AmigaPCI/AmigaPCI-MainBoard/Images/APCI_Jumper_Location70.jpg

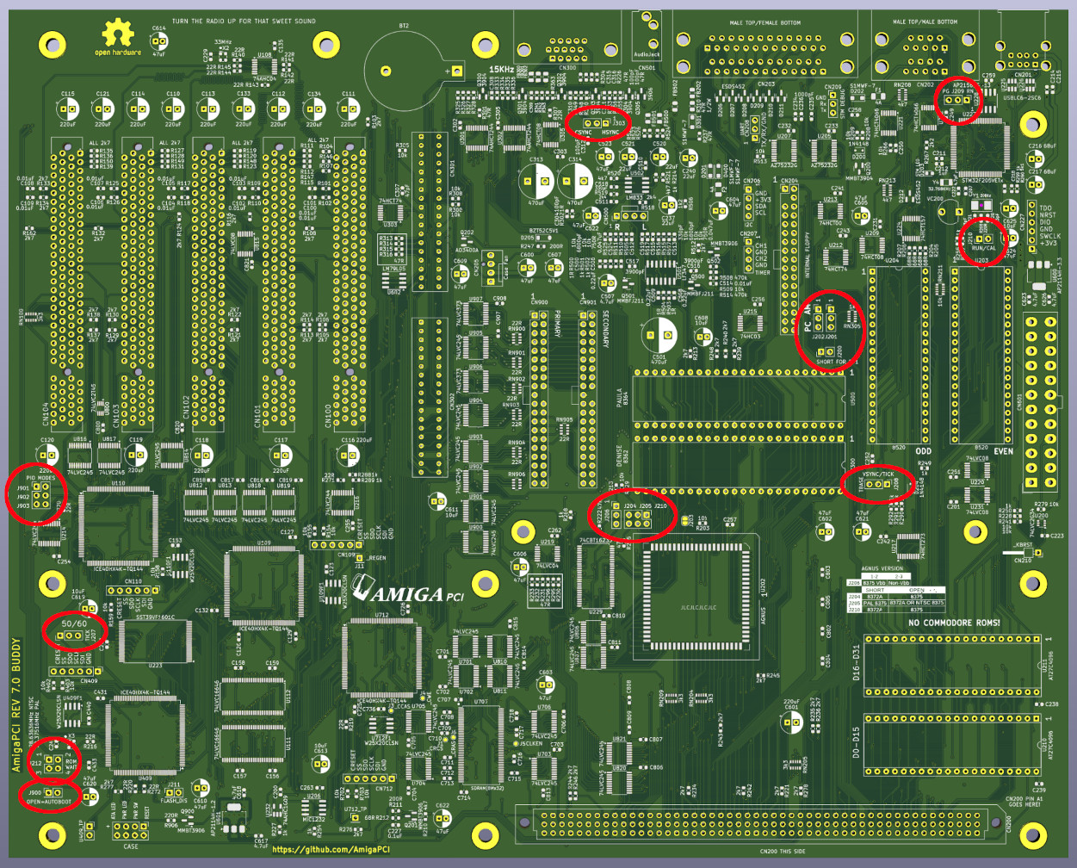
Images/APCI_Jumper_Location70.jpg
