AmigaPCI/AmigaPCI-MainBoard/KiCAD/readme.md

KiCAD files. Current revisions are in this folder. Deprecated versions are found in the Archive folder.
