AmigaPCI/AmigaPCI-MainBoard/Images/LBC_Footprint_Rev6.png

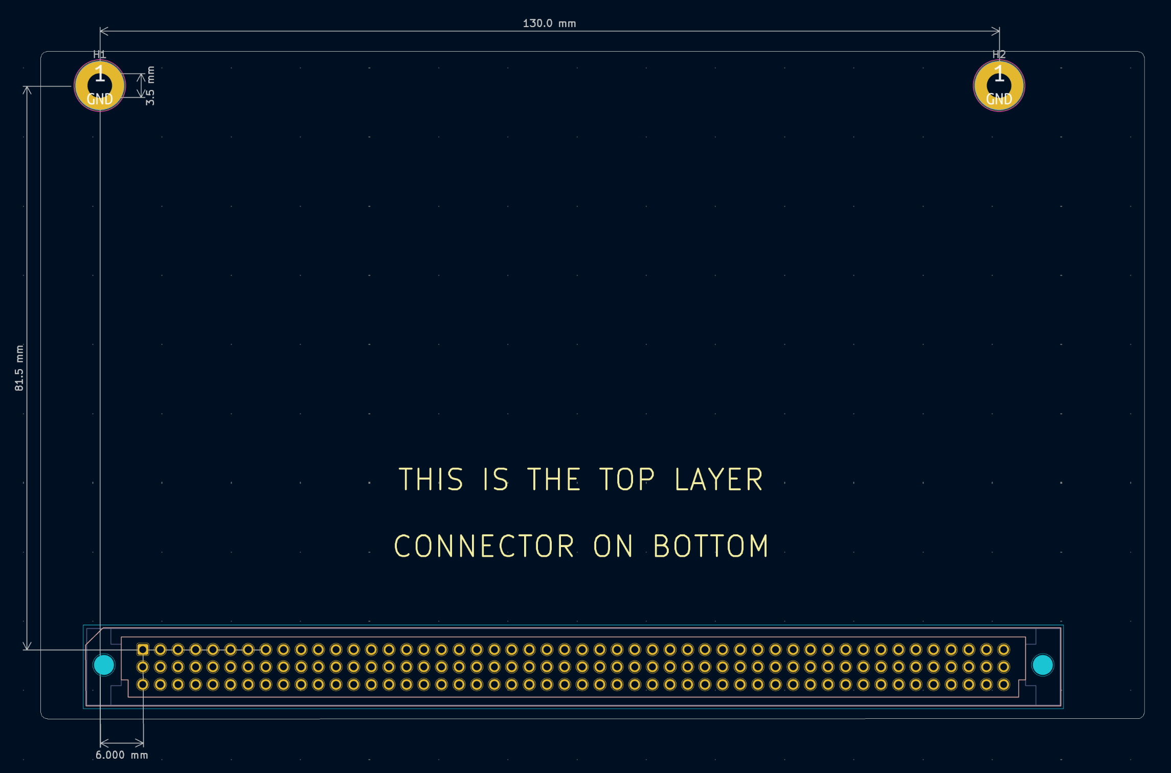
Images/LBC_Footprint_Rev6.png
