AmigaPCI/AmigaPCI-MainBoard/KiCAD/AmigaPCI Mainboard-KiCAD REV 70/AmigaPCI-Footprints/CUI_DEVICES_SJ1-3533N.step

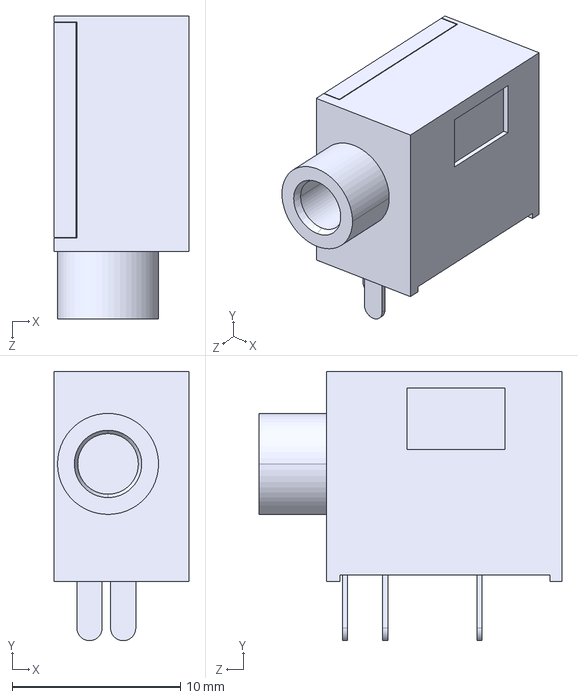
[picture p3: CAD file, 2026-06-26]
KiCAD/AmigaPCI Mainboard-KiCAD REV 70/AmigaPCI-Footprints/CUI_DEVICES_SJ1-3533N.step
8.00 x 16.0 x 18.0 mm
