AmigaPCI/AmigaPCI-MainBoard/KiCAD/AmigaPCI Mainboard-KiCAD REV 70/AmigaPCI-Footprints/ASUB-277-25TP24.STEP

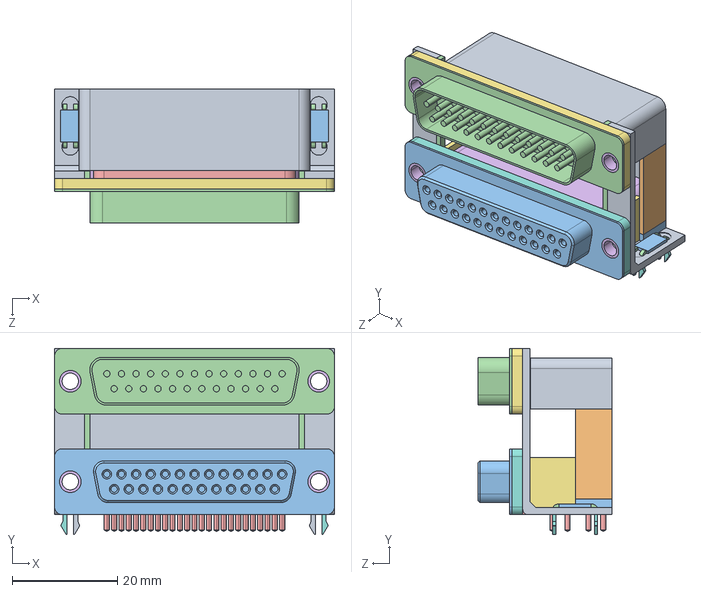
[picture p4: CAD file, 2026-06-26]
KiCAD/AmigaPCI Mainboard-KiCAD REV 70/AmigaPCI-Footprints/ASUB-277-25TP24.STEP
53.1 x 35.3 x 25.5 mm
