AmigaPCI/AmigaPCI-MainBoard/KiCAD/AmigaPCI Mainboard-KiCAD REV 70/AmigaPCI-Footprints/video_slot.stp

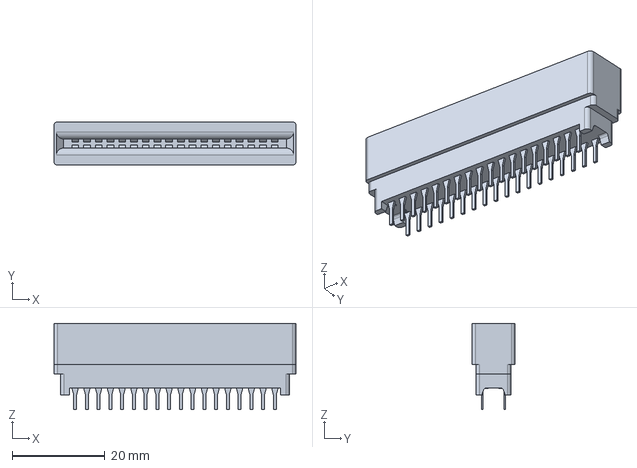
[picture p5: CAD file, 2026-06-26]
KiCAD/AmigaPCI Mainboard-KiCAD REV 70/AmigaPCI-Footprints/video_slot.stp
52.3 x 9.35 x 18.7 mm
