AmigaPCI/AmigaPCI-MainBoard/KiCAD/AmigaPCI Mainboard-KiCAD REV 70/AmigaPCI-Footprints/atx_molex.stp

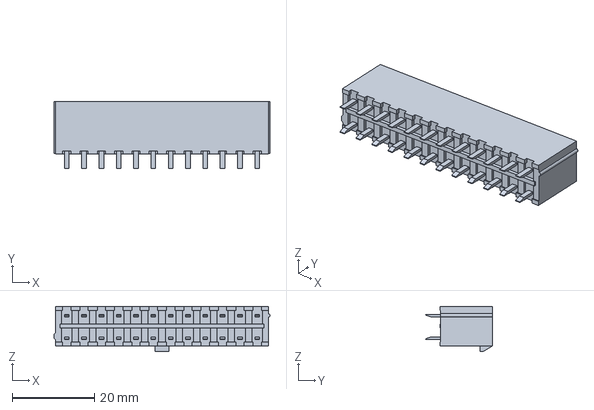
[picture p6: CAD file, 2026-06-26]
KiCAD/AmigaPCI Mainboard-KiCAD REV 70/AmigaPCI-Footprints/atx_molex.stp
52.4 x 16.3 x 11.0 mm
