AmigaPCI/AmigaPCI-MainBoard/KiCAD/AmigaPCI Mainboard-KiCAD REV 70/AmigaPCI-Footprints/DB9.stp

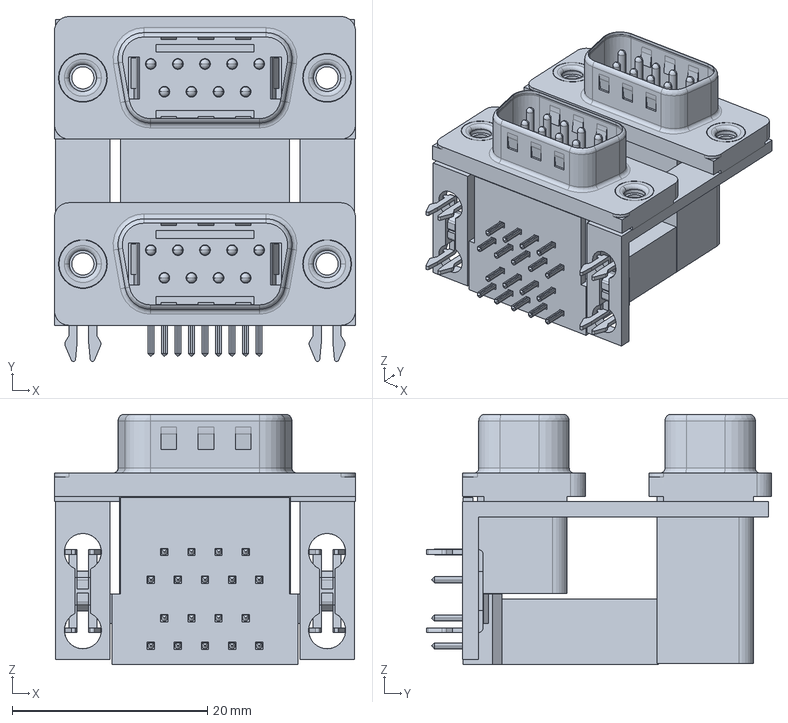
[picture p7: CAD file, 2026-06-26]
KiCAD/AmigaPCI Mainboard-KiCAD REV 70/AmigaPCI-Footprints/DB9.stp
30.8 x 35.3 x 25.6 mm
