AmigaPCI/AmigaPCI-MainBoard/KiCAD/AmigaPCI Mainboard-KiCAD REV 70/AmigaPCI-Footprints/USB.stp

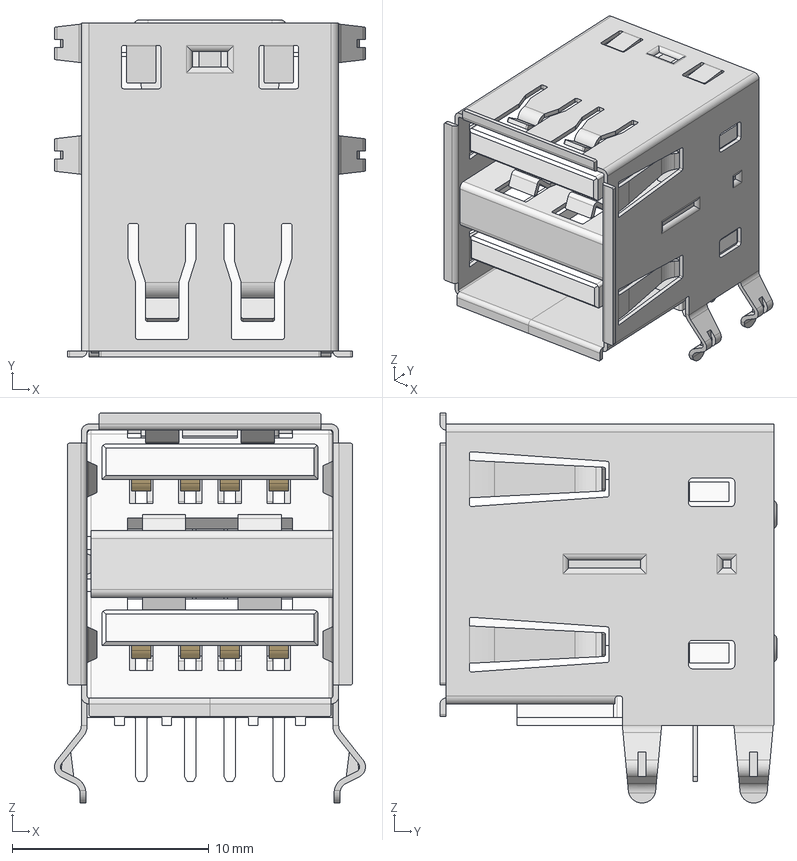
[picture p8: CAD file, 2026-06-26]
KiCAD/AmigaPCI Mainboard-KiCAD REV 70/AmigaPCI-Footprints/USB.stp
15.8 x 17.1 x 19.8 mm
61400826021_Shielding1
61400826021_Housing
61400826021_Shielding2
61400826021_Pin2 x 4
61400826021_Pin1 x 4
61400826021_Shielding3
