AmigaPCI/AmigaPCI-MainBoard/(list of files, cad)

Other CAD files:
KiCAD/AmigaPCI Mainboard-KiCAD REV 70/AmigaPCI-Footprints/5145154-4.step
KiCAD/AmigaPCI Mainboard-KiCAD REV 70/AmigaPCI-Footprints/asub-277-25tp24.stp
