AmigaPCI/AmigaPCI-MainBoard/assembly.md

## Tables

### Table 1. Legacy Parts Required
Common Name|Designation/Part Number|Postion|Package|Notes
-|-|-|-|-
Fatter Agnus|See Table 2|U202|PLCC-84|
Paula|MOS 8364|U500|DIP-48|
Denise|MOS 8362 or CSG 8373|U300|DIP-48|[Deniser](https://github.com/endofexclusive/deniser)
CIA|MOS 8520A, 8520A-1, 8520R2, or 8520PD|U203 and U204|DIP-40|These are all interchangeable
Kickstart|Burn your own A1200 27C4096|U210 (LOW), U211 (HIGH)|DIP-40|
Video Hybrid|Commodore 390229-0x|HY300|SIP-22|[Video Hybrid](https://github.com/SukkoPera/OpenAmigaVideoHybrid)

*Commodore IC's may be marked "MOS" or "CSG", or possibly neither in the case of contract runs. These are interchangeable by part number.

### Table 2. Agnus Parts Supported

Agnus|Commodore Part Number|Status
-|-|-
8372A|ALL|Tested and working
8375|390544-01|Tested and working
8375|390544-02|Tested and working
8375|318069-10|Tested and working
8375|318069-11|Tested and working
8375|390554-01|Unknown
8375|390554-02|Unknown
8375|318069-12|Unknown
8375|318069-13|Unknown
