AmigaPCI/AmigaPCI-MainBoard/Schematic/AmigaPCI Mainboard REV70.pdf

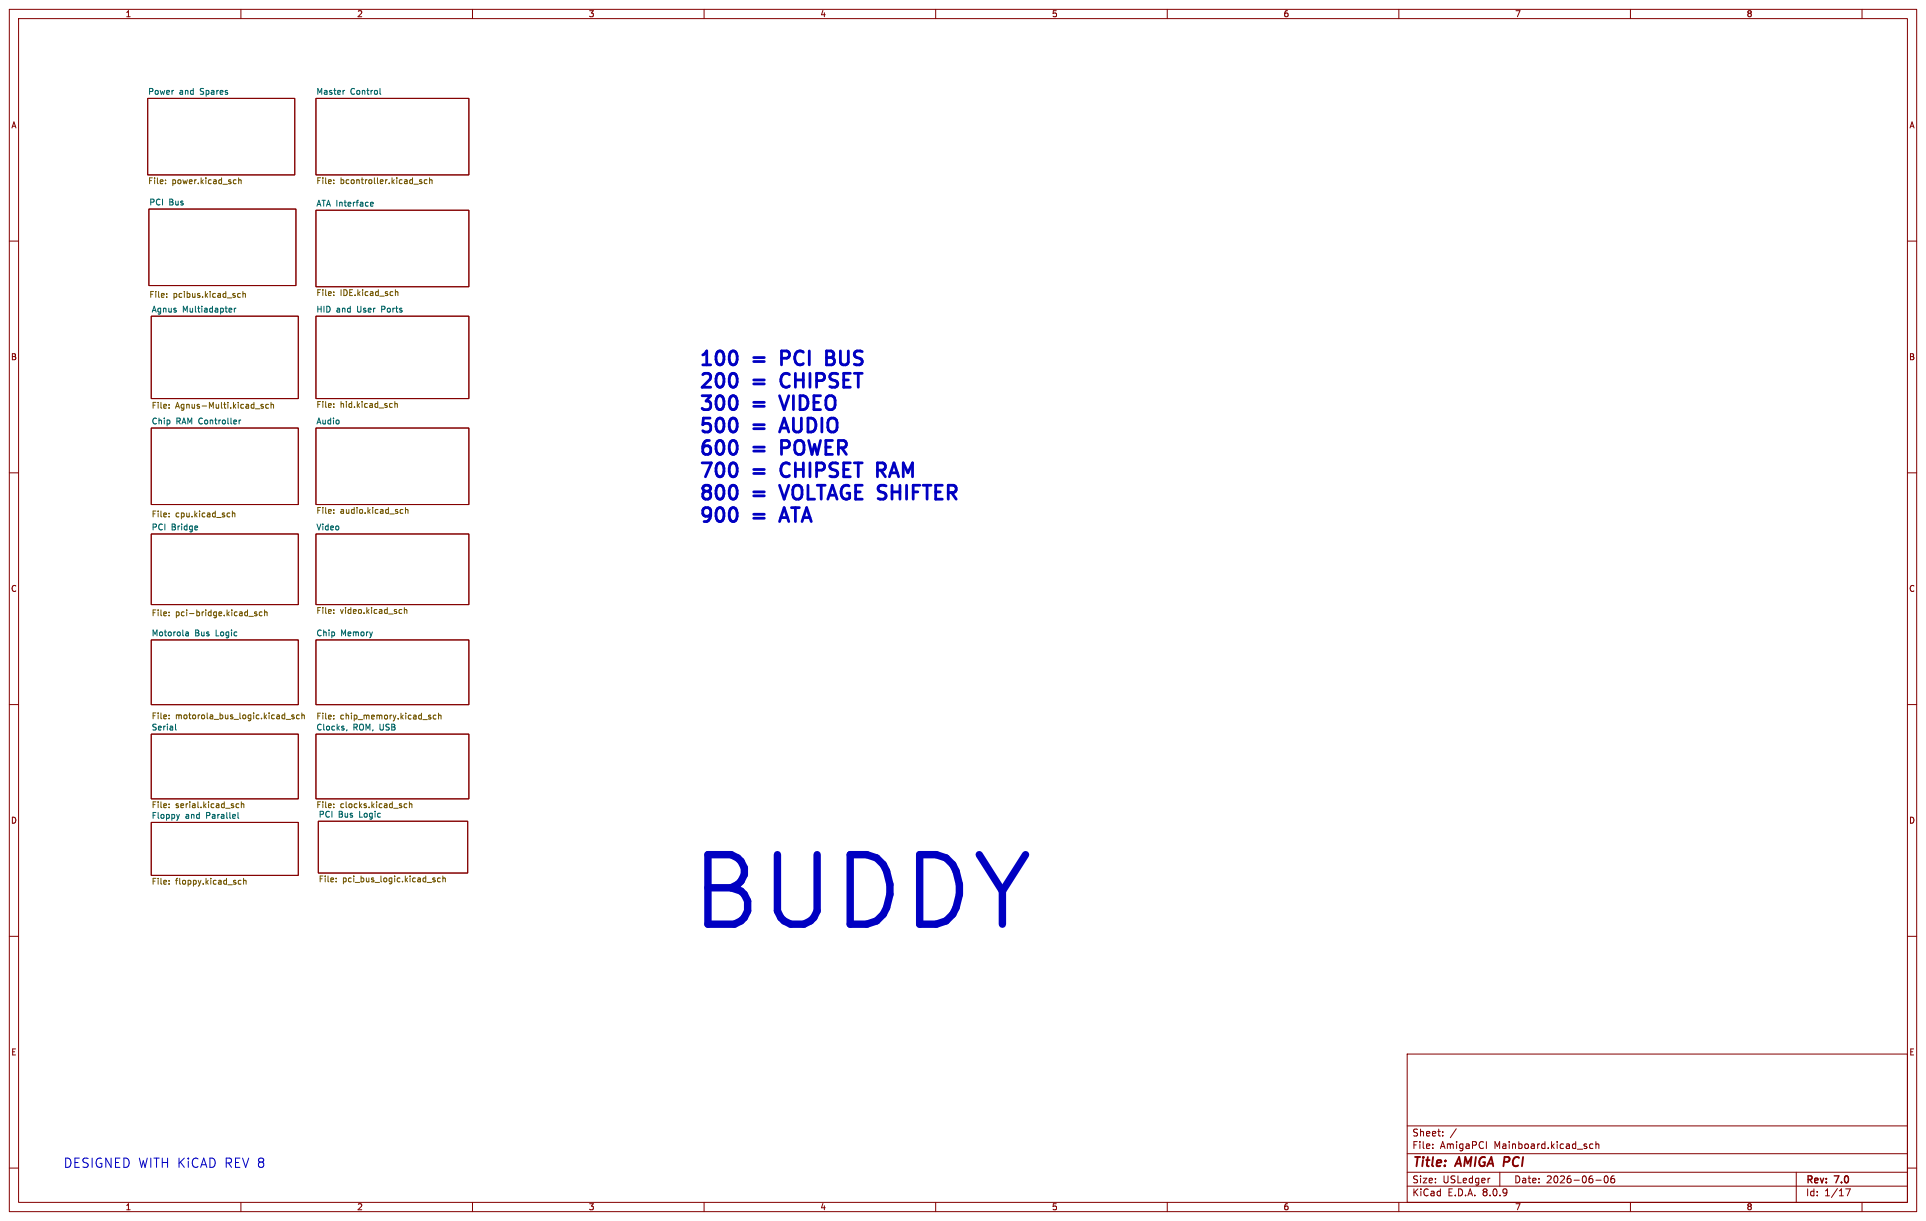
[picture p15: page 1]

Audio File: audio.kicad_sch HID and User Ports File: hid.kicad_sch Video File: video.kicad_sch PCI Bus Logic File: pci_bus_logic.kicad_sch
Chip RAM Controller File: cpu.kicad_sch Serial File: serial.kicad_sch Floppy and Parallel File: floppy.kicad_sch

Agnus Multiadapter File: Agnus-Multi.kicad_sch

Chip Memory File: chip_memory.kicad_sch Clocks, ROM, USB

DESIGNED WITH KiCAD REV 8

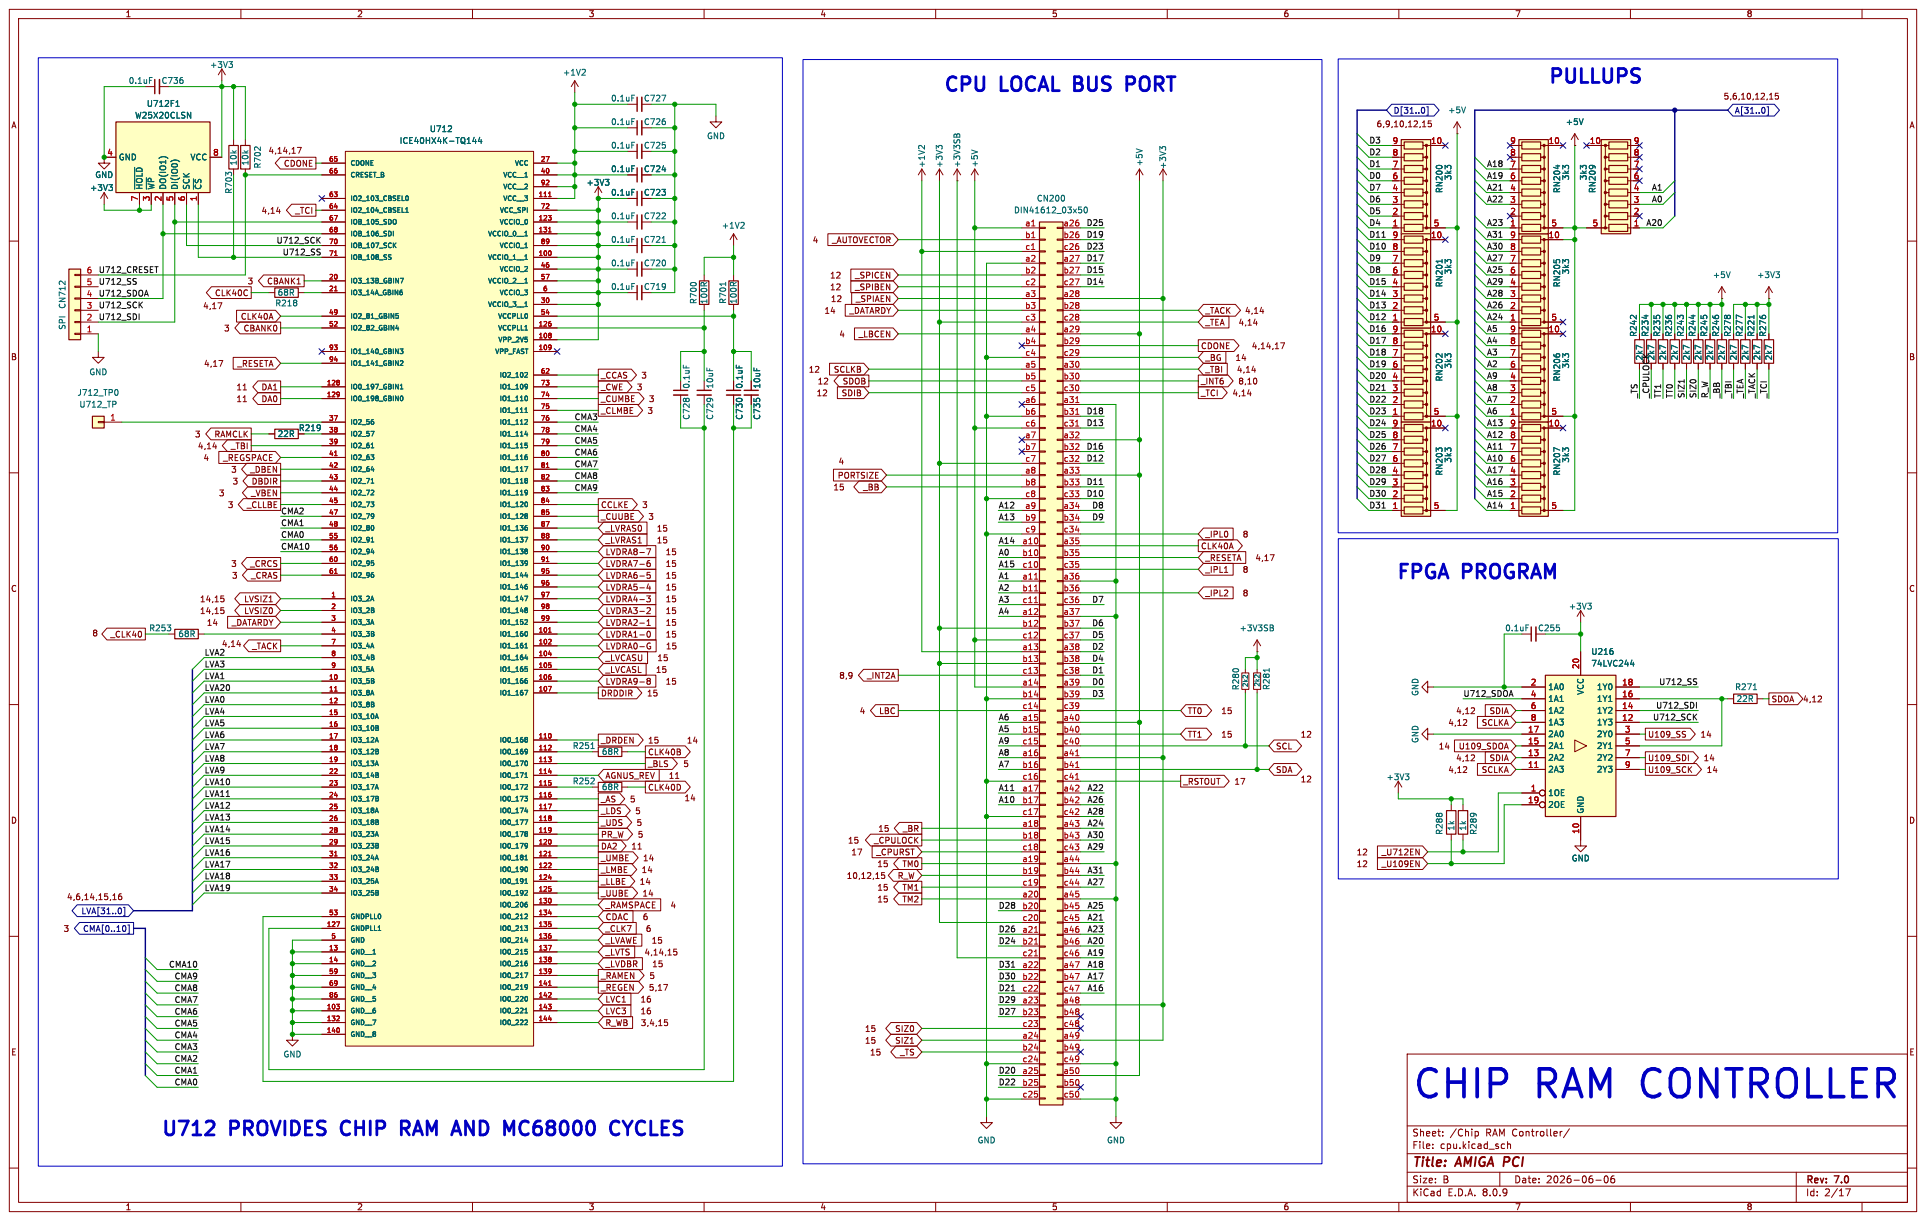
[picture p16: page 2]

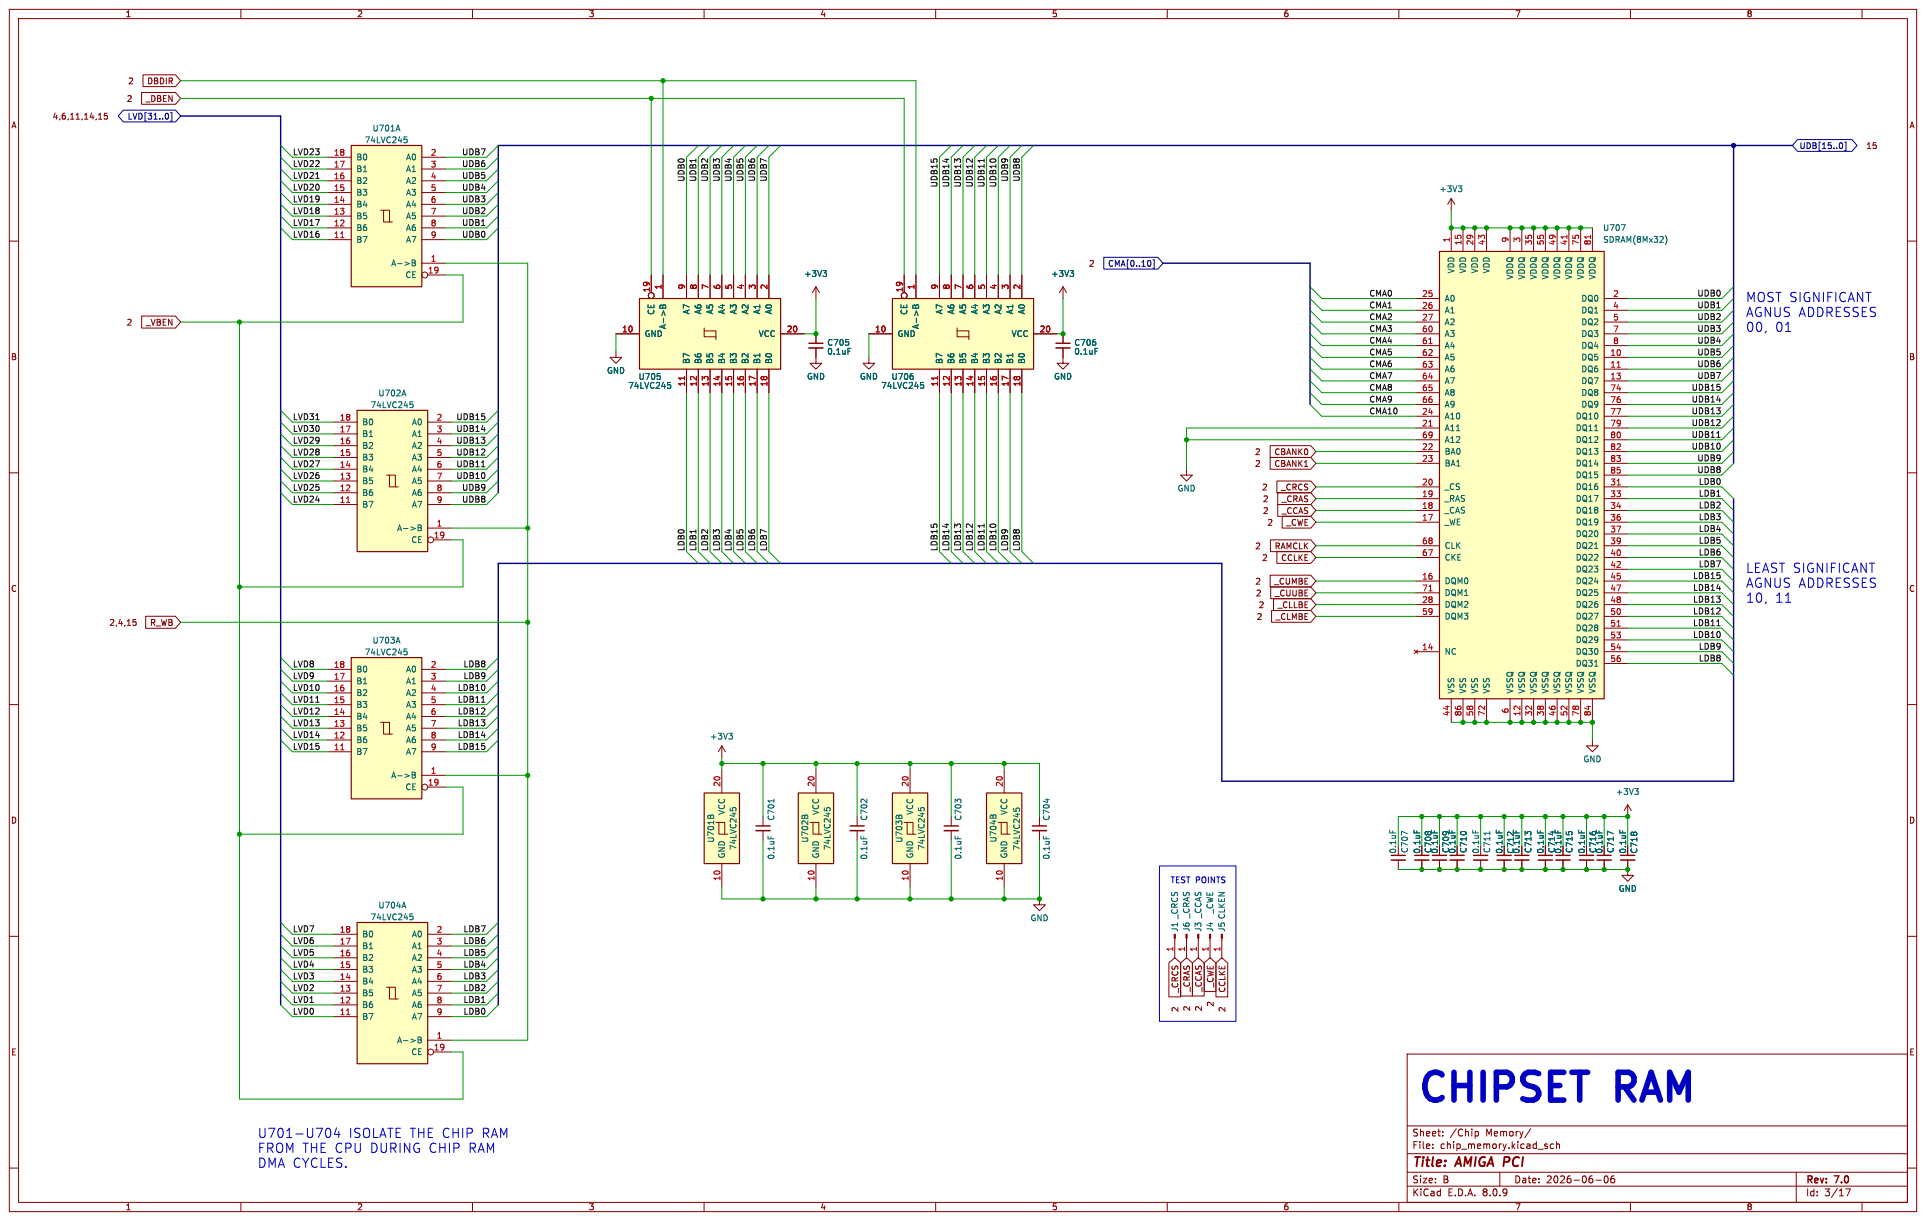
[picture p17: page 3]

FROM THE CPU DURING CHIP RAM

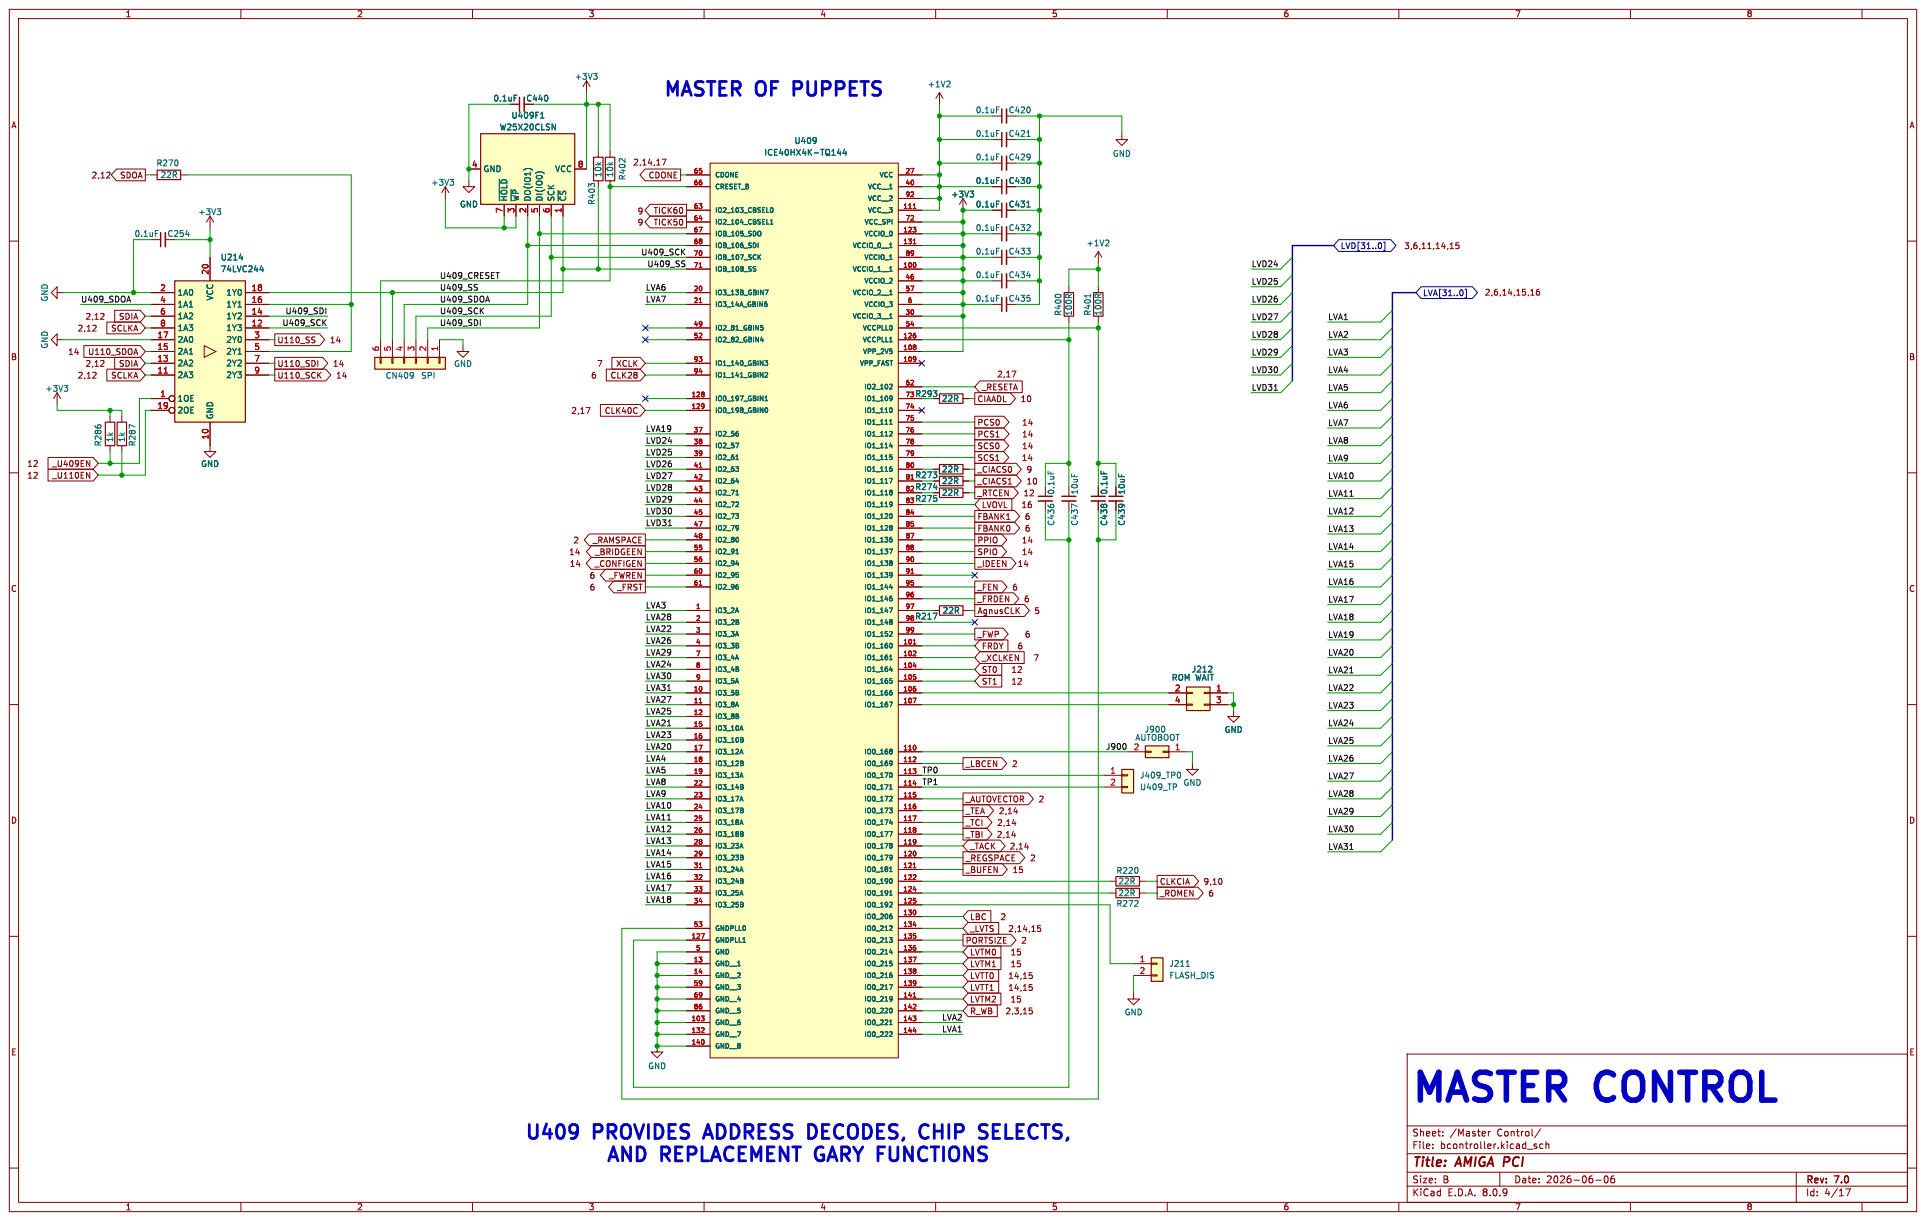
[picture p18: page 4]

6 ~{HOLD} 7 VCC 8 GND GND

LVA3 U409 PROVIDES ADDRESS DECODES, CHIP SELECTS,

AND REPLACEMENT GARY FUNCTIONS

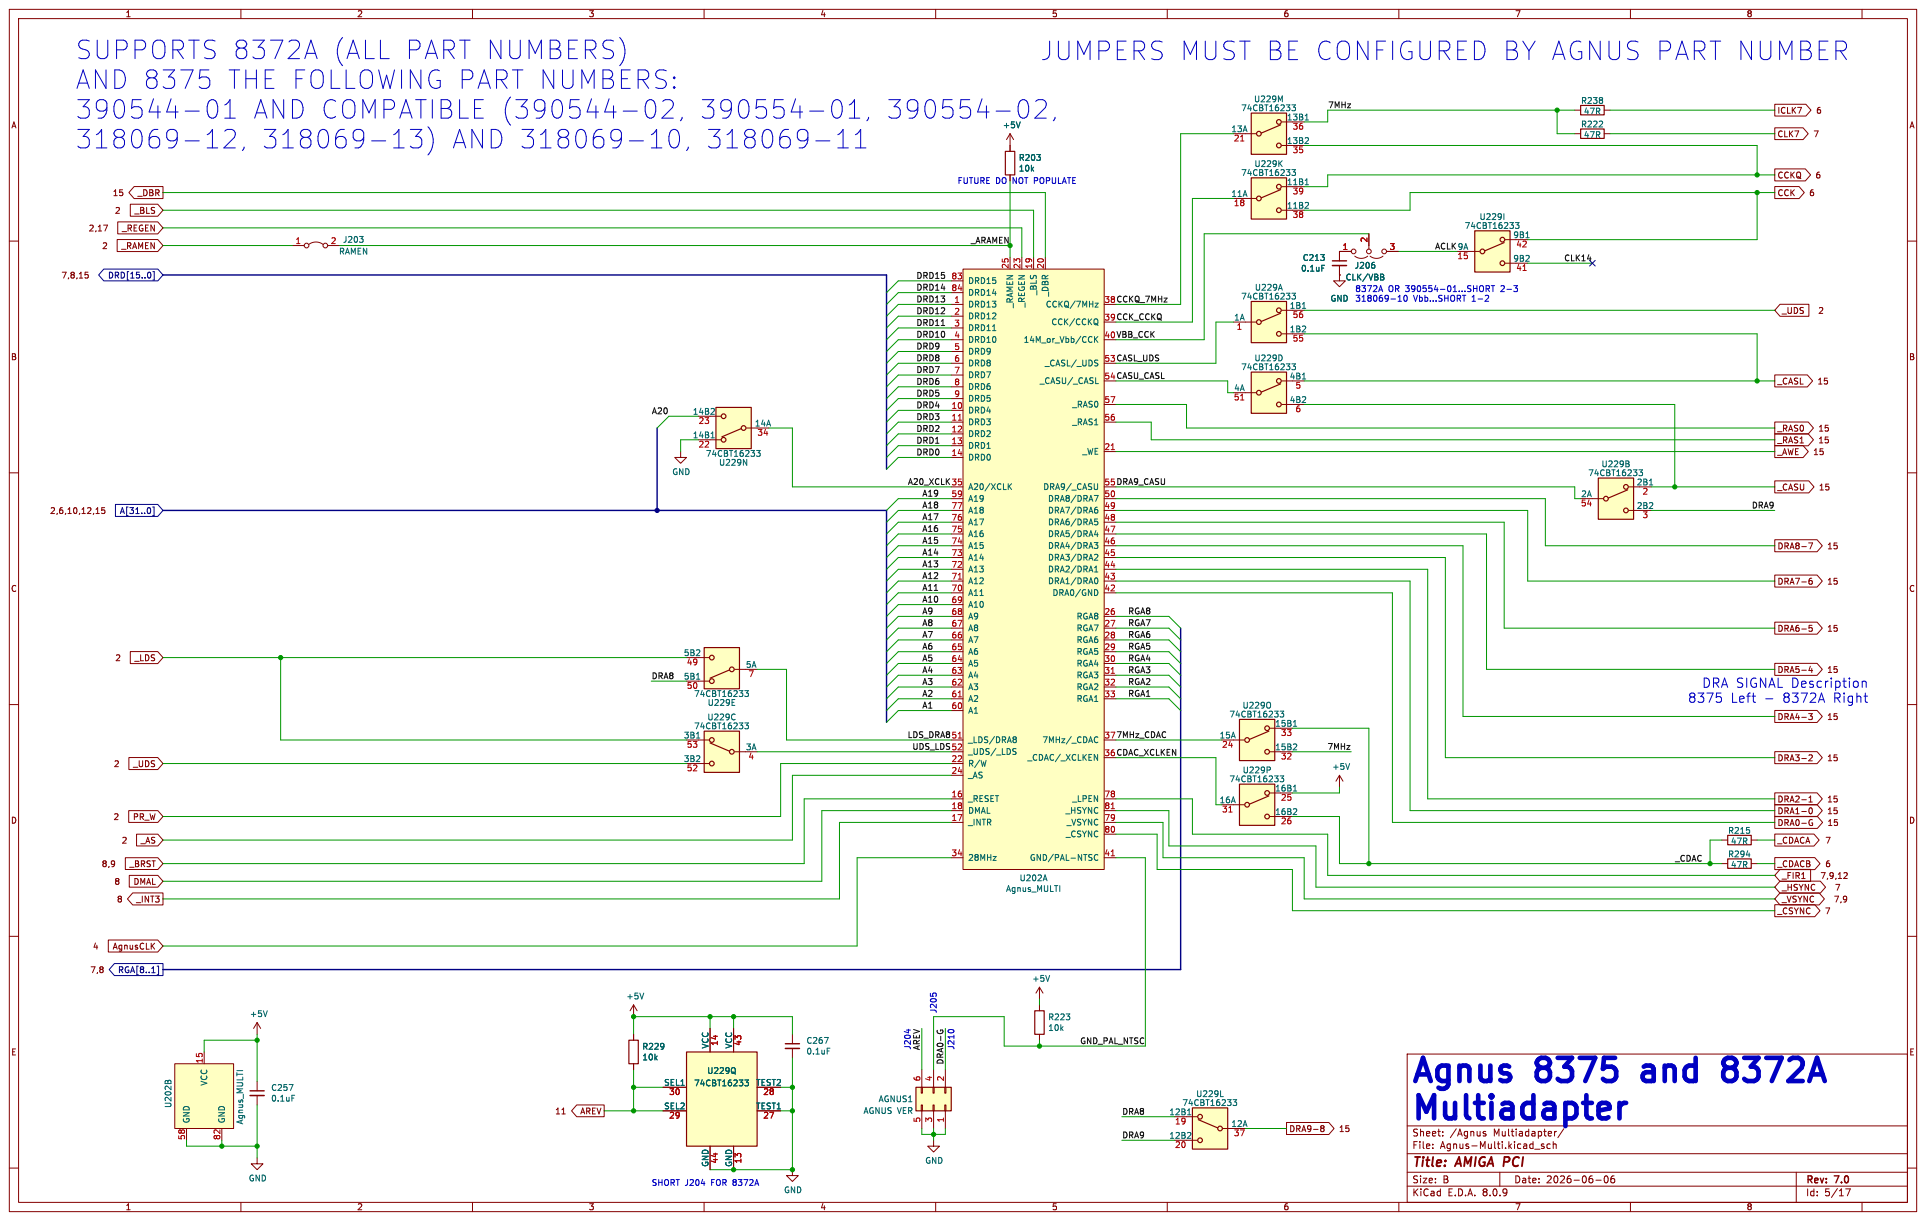
[picture p19: page 5]

FUTURE DO NOT POPULATE SUPPORTS 8372A (ALL PART NUMBERS)
AND 8375 THE FOLLOWING PART NUMBERS:

JUMPERS MUST BE CONFIGURED BY AGNUS PART NUMBER

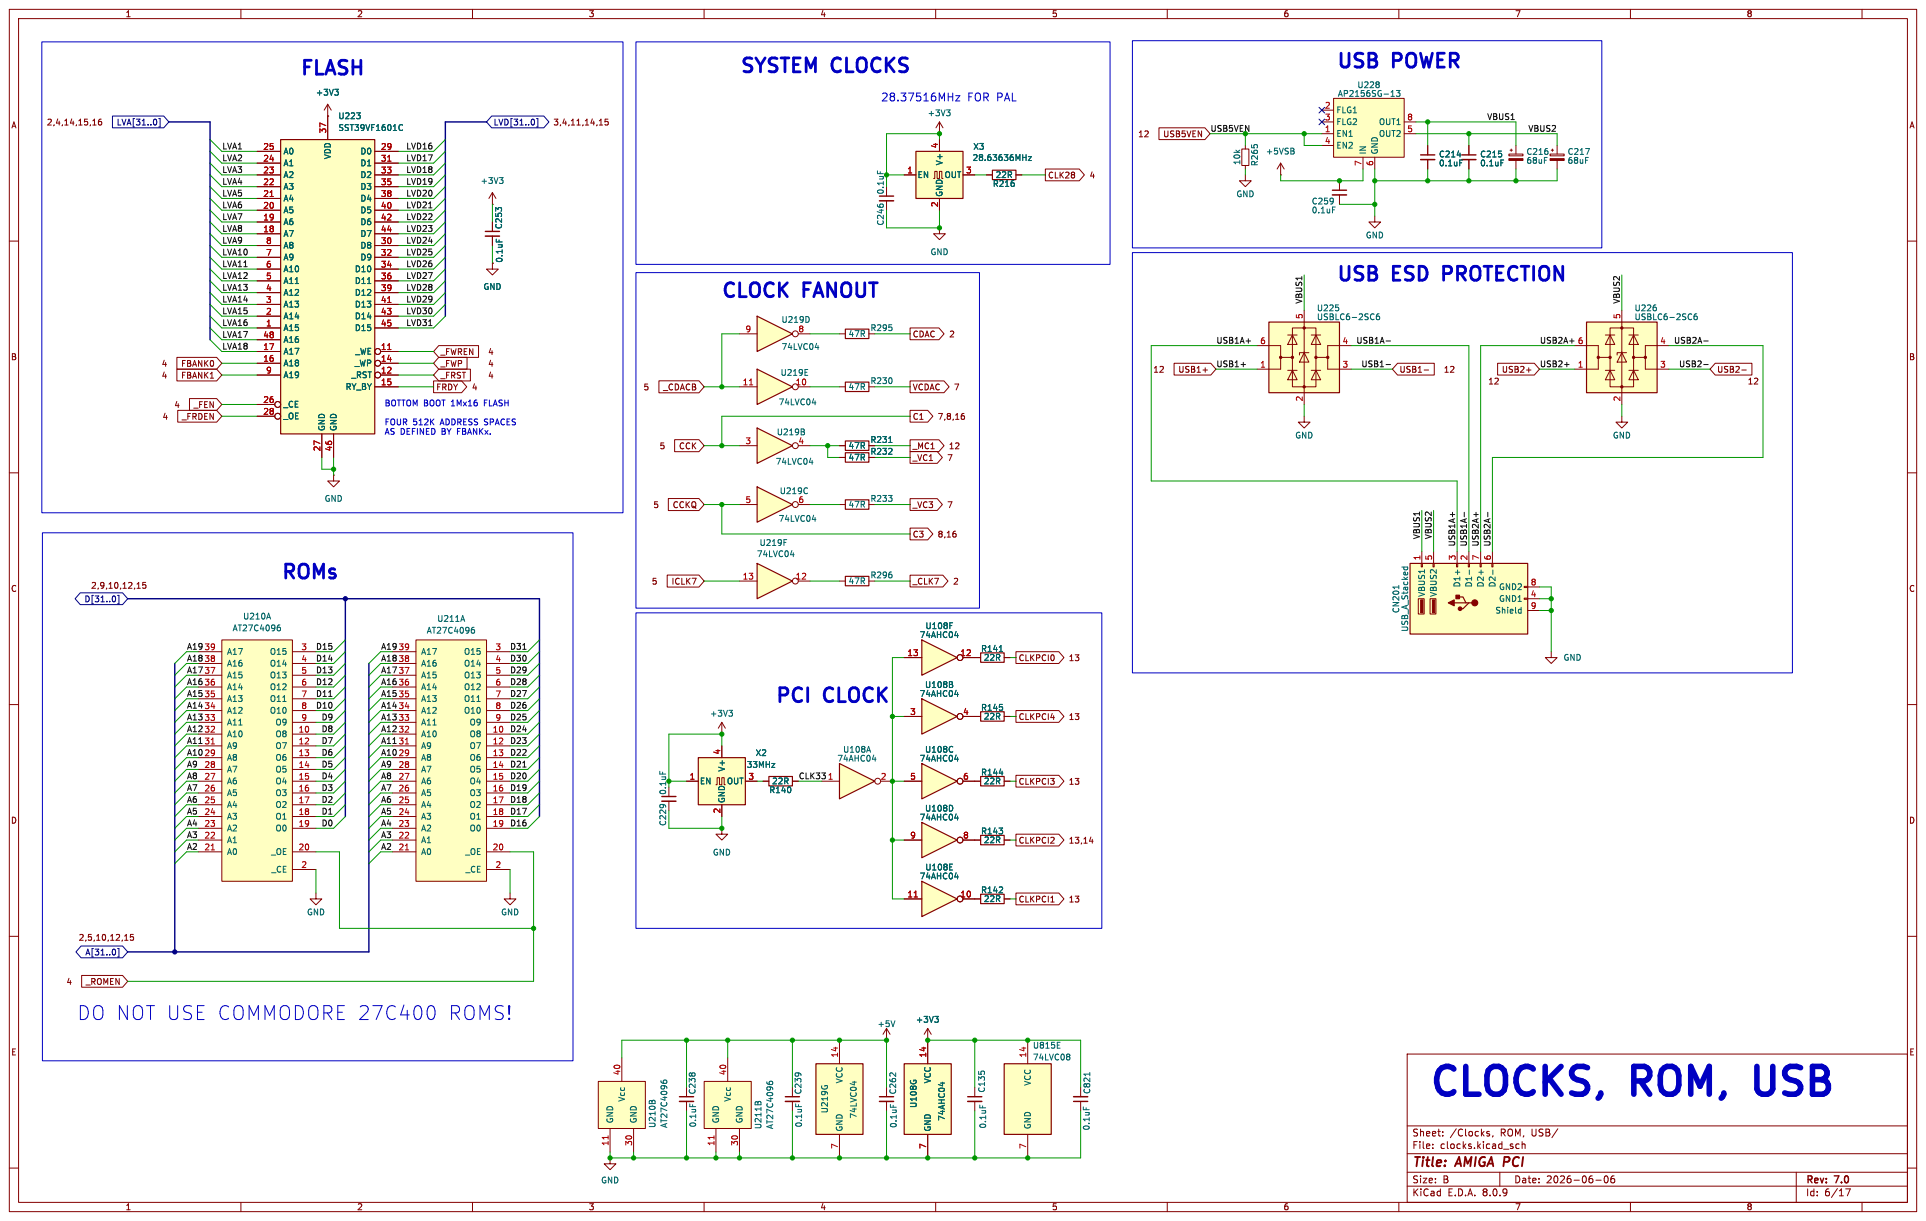
[picture p20: page 6]

DO NOT USE COMMODORE 27C400 ROMS!

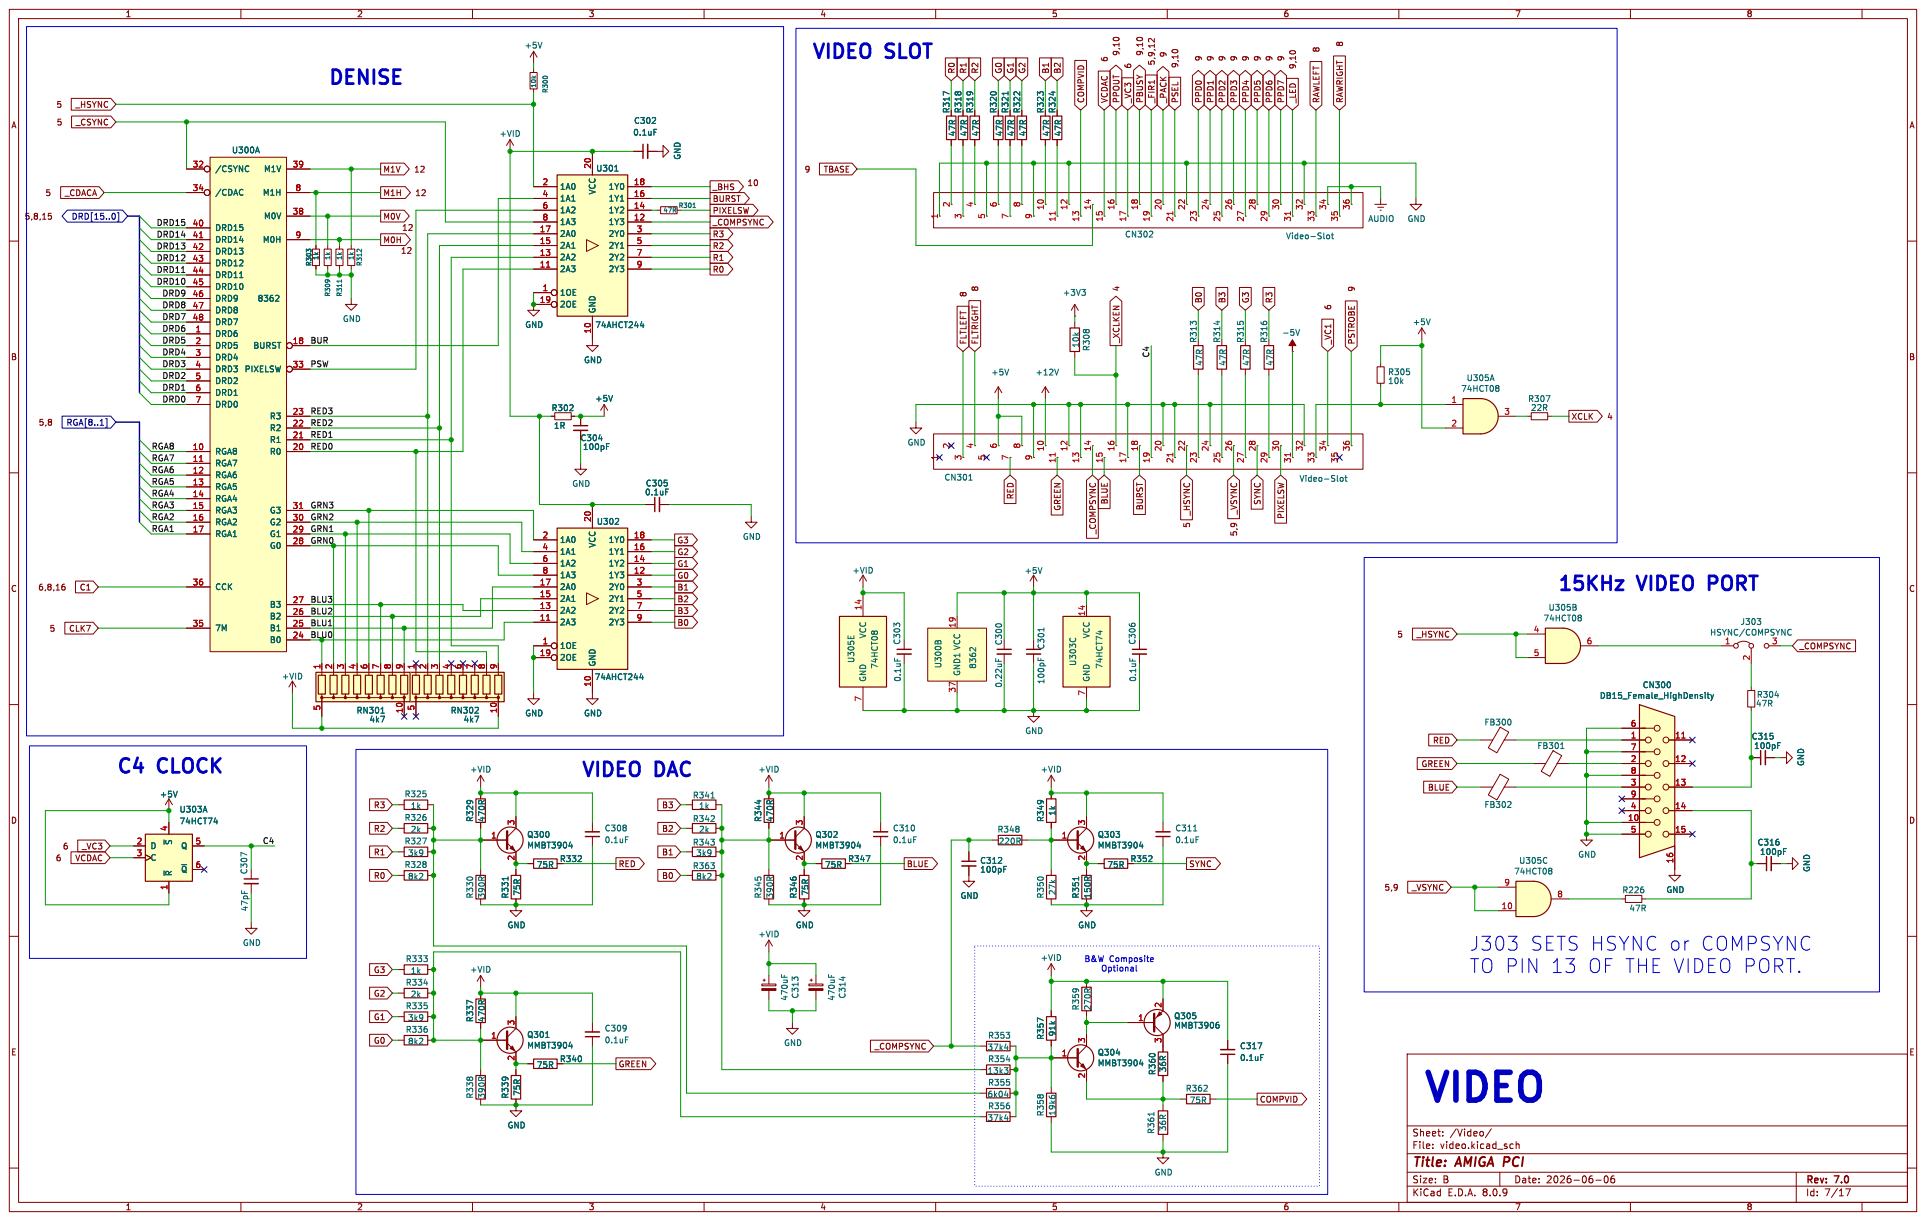
[picture p21: page 7]

9 CN301 Video-Slot C303 0.1uF VCC 14 GND

J303 SETS HSYNC or COMPSYNC
TO PIN 13 OF THE VIDEO PORT.

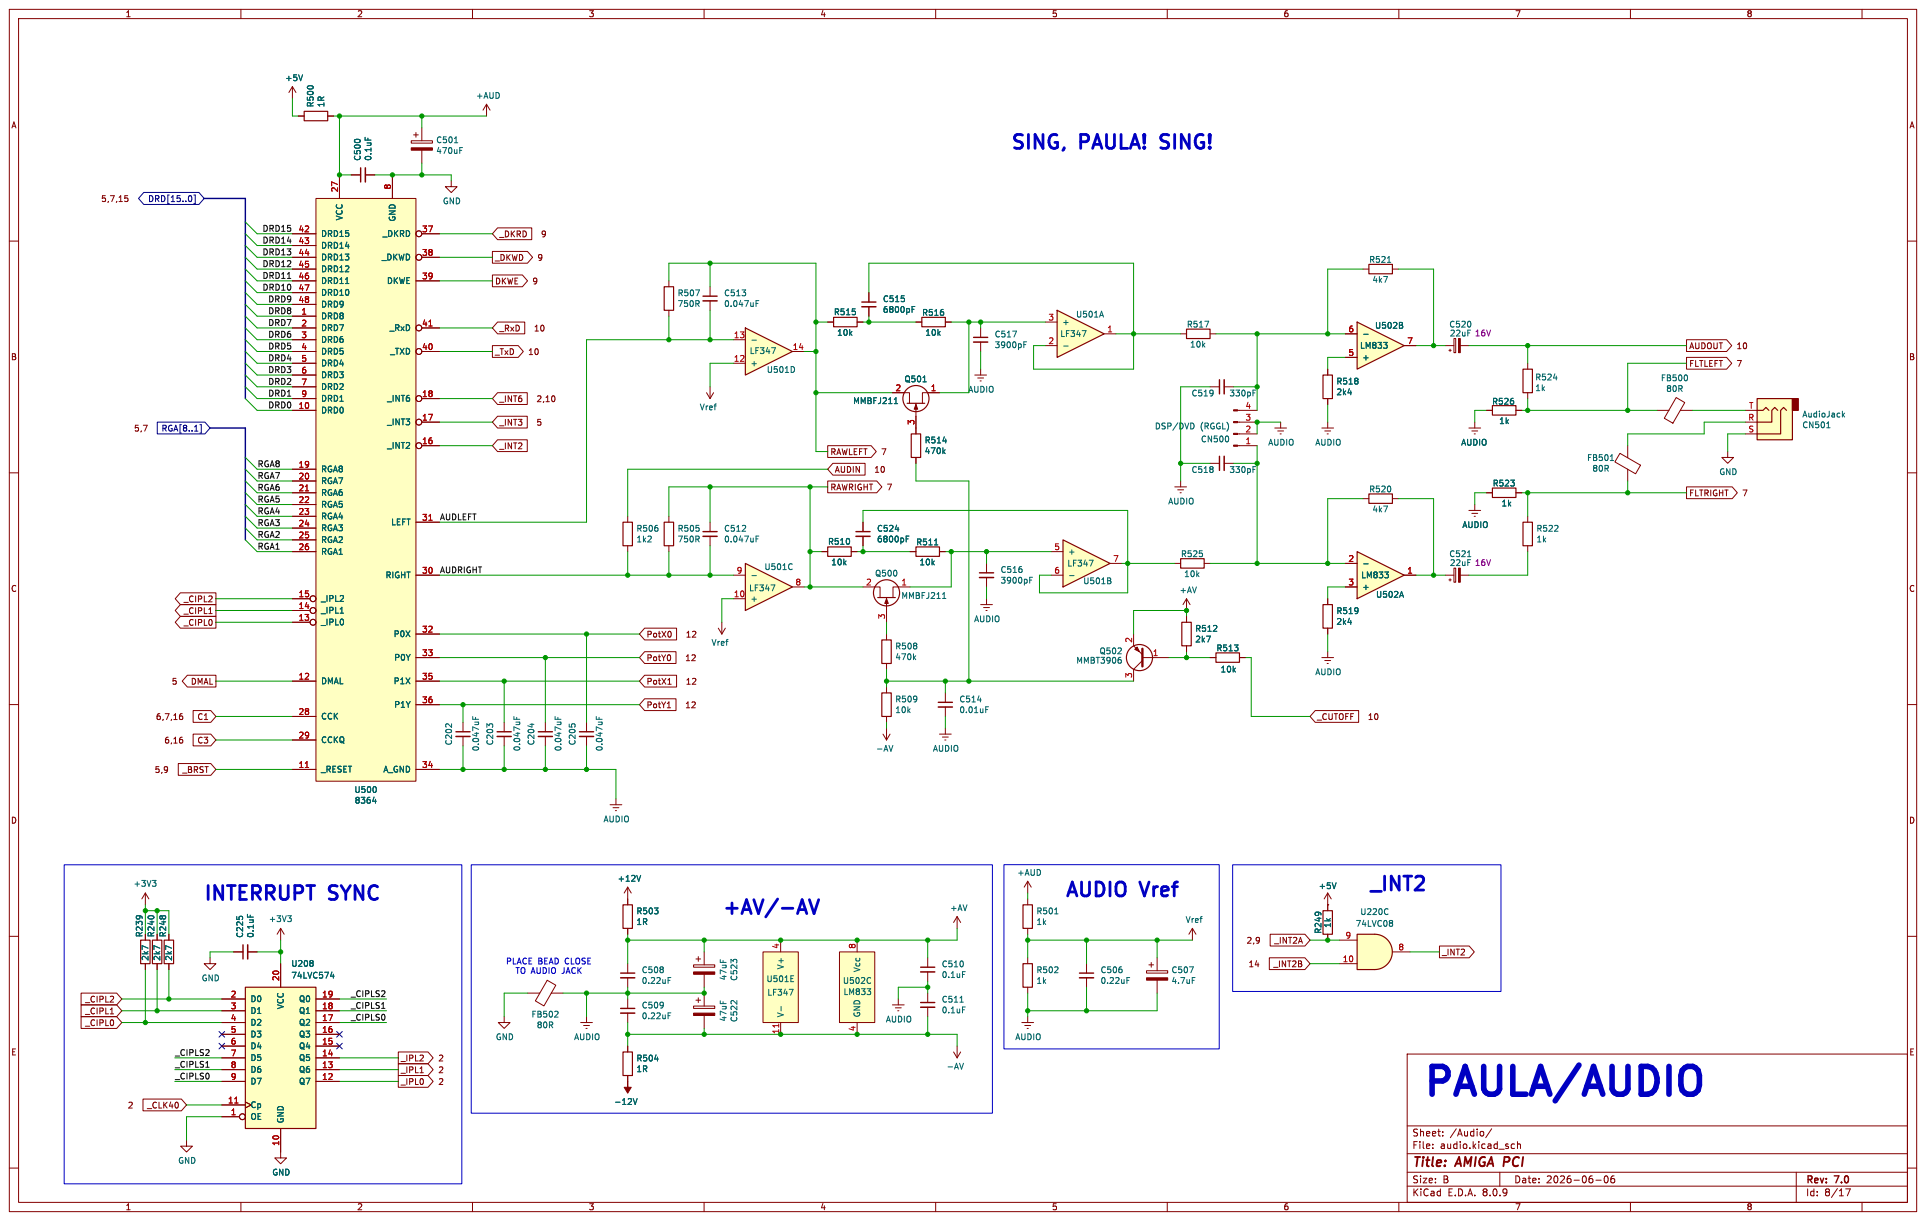
[picture p22: page 8]

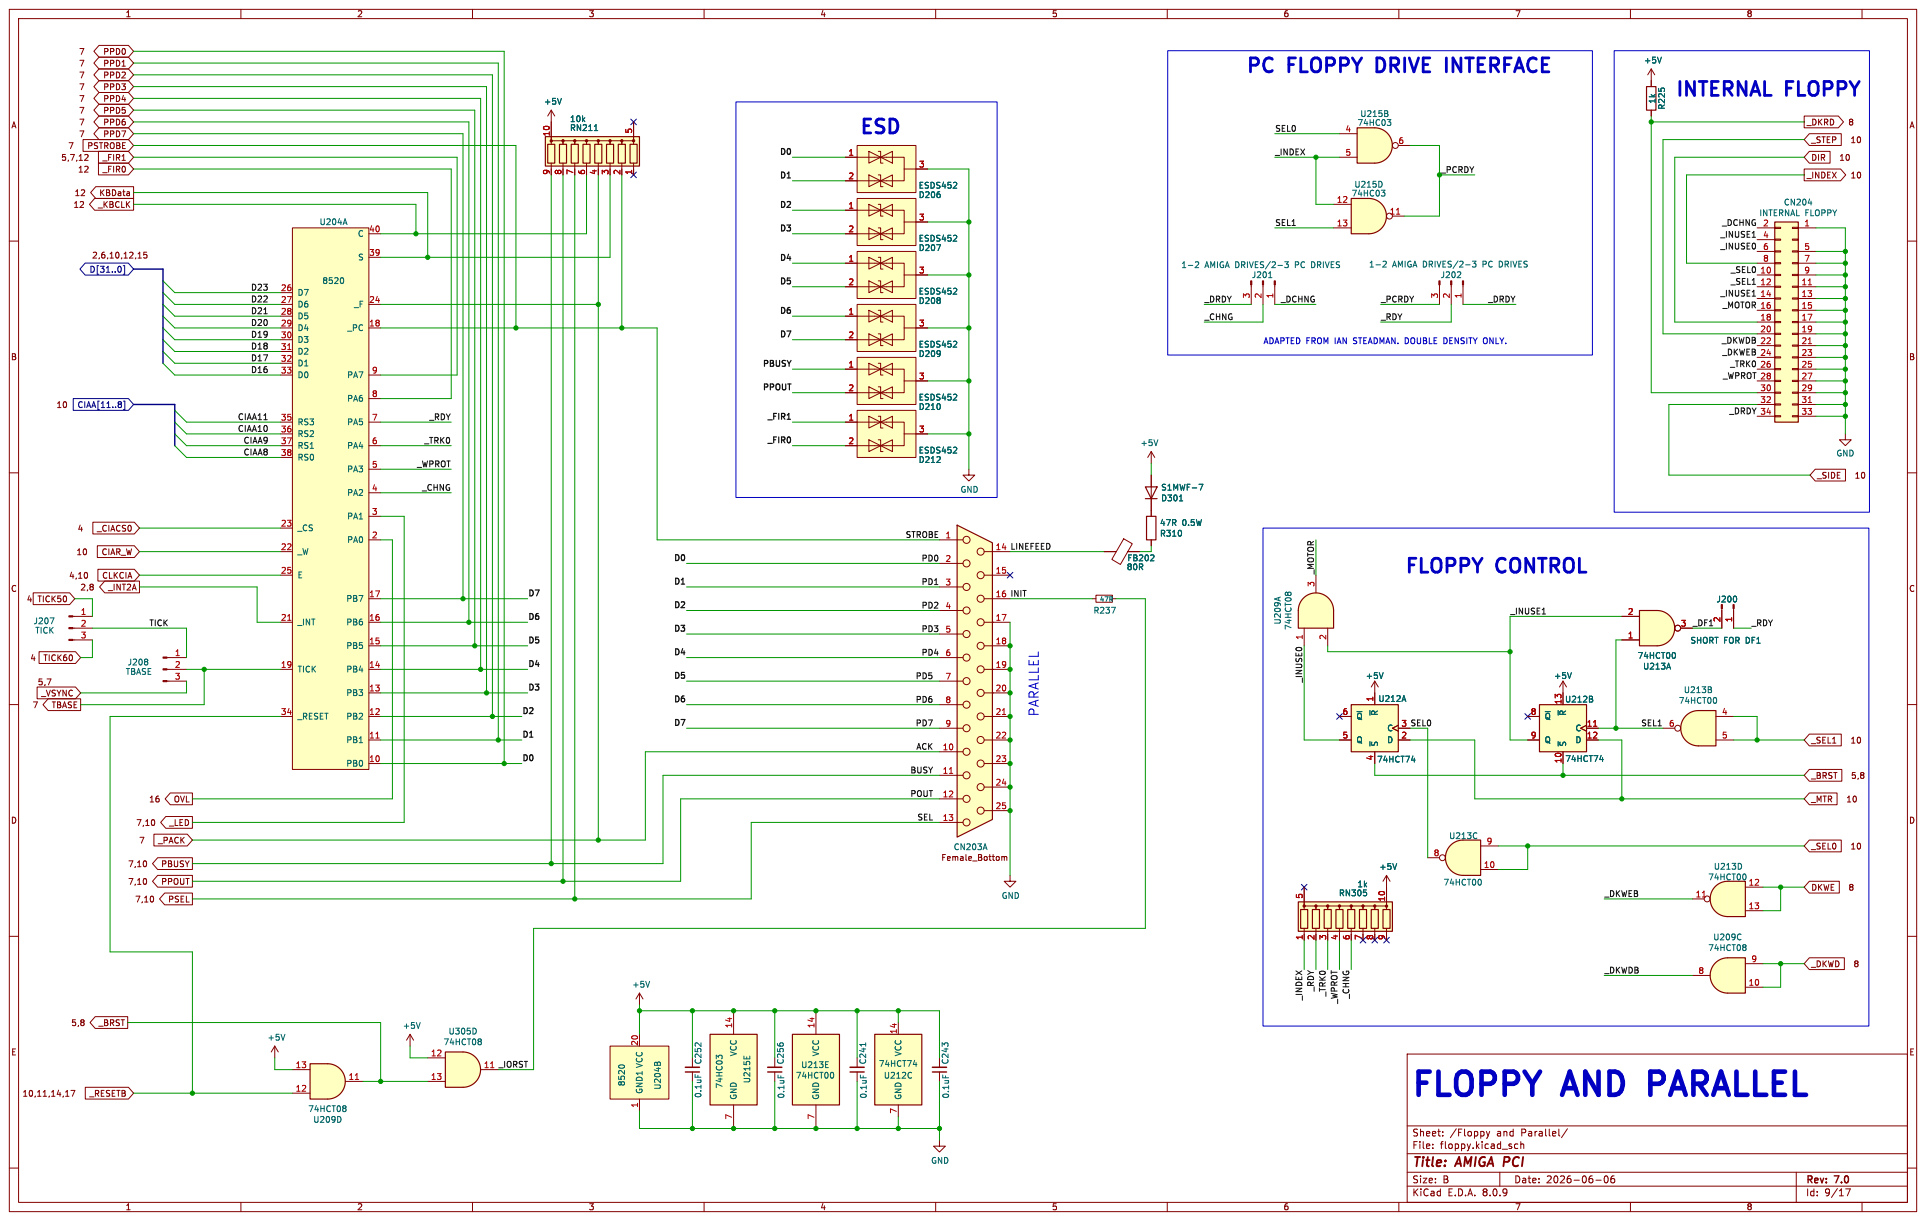
[picture p23: page 9]

PC FLOPPY DRIVE INTERFACE

ADAPTED FROM IAN STEADMAN. DOUBLE DENSITY ONLY. FLOPPY CONTROL

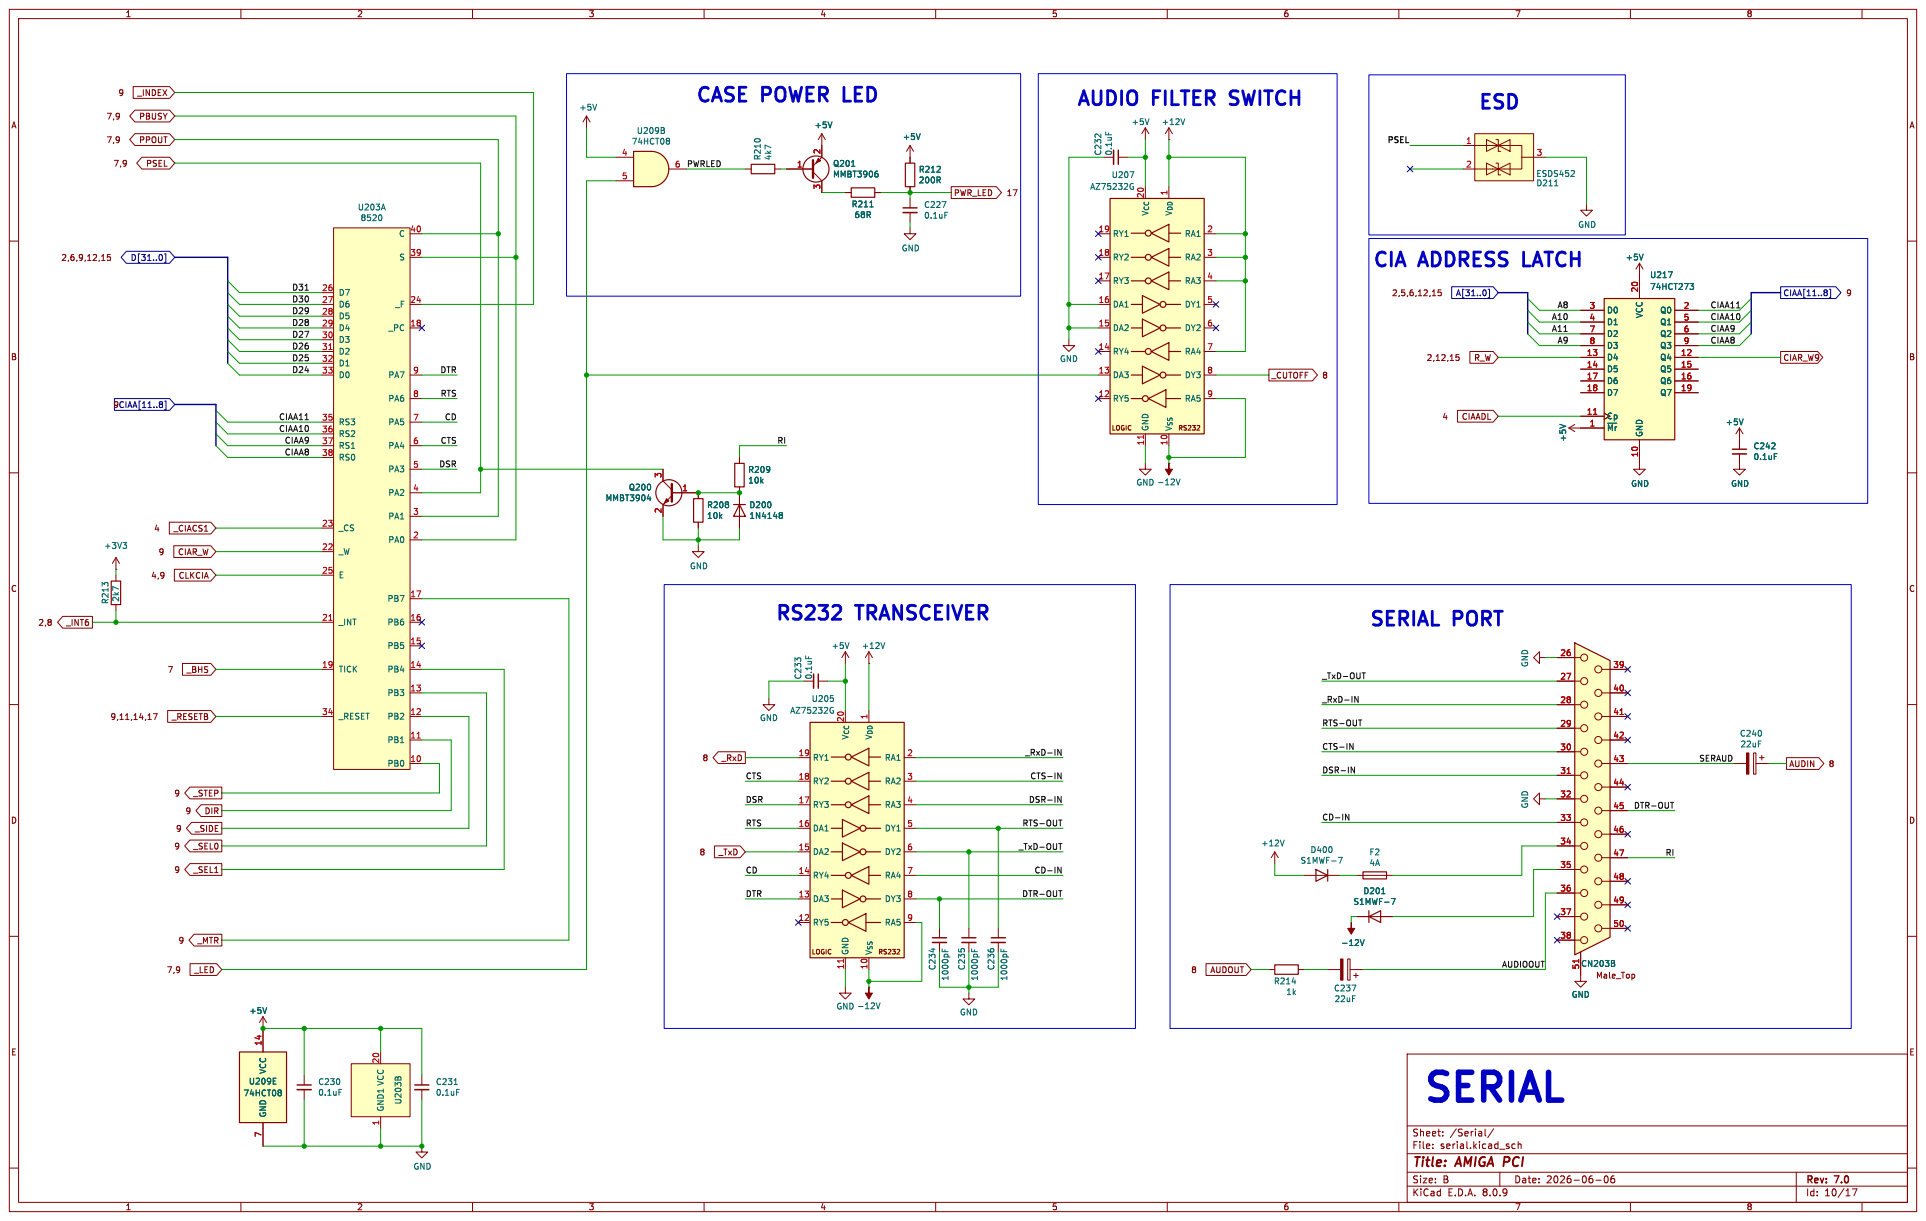
[picture p24: page 10]

Id: 10/17 Title: AMIGA PCI File: serial.kicad_sch Sheet: /Serial/ -12V

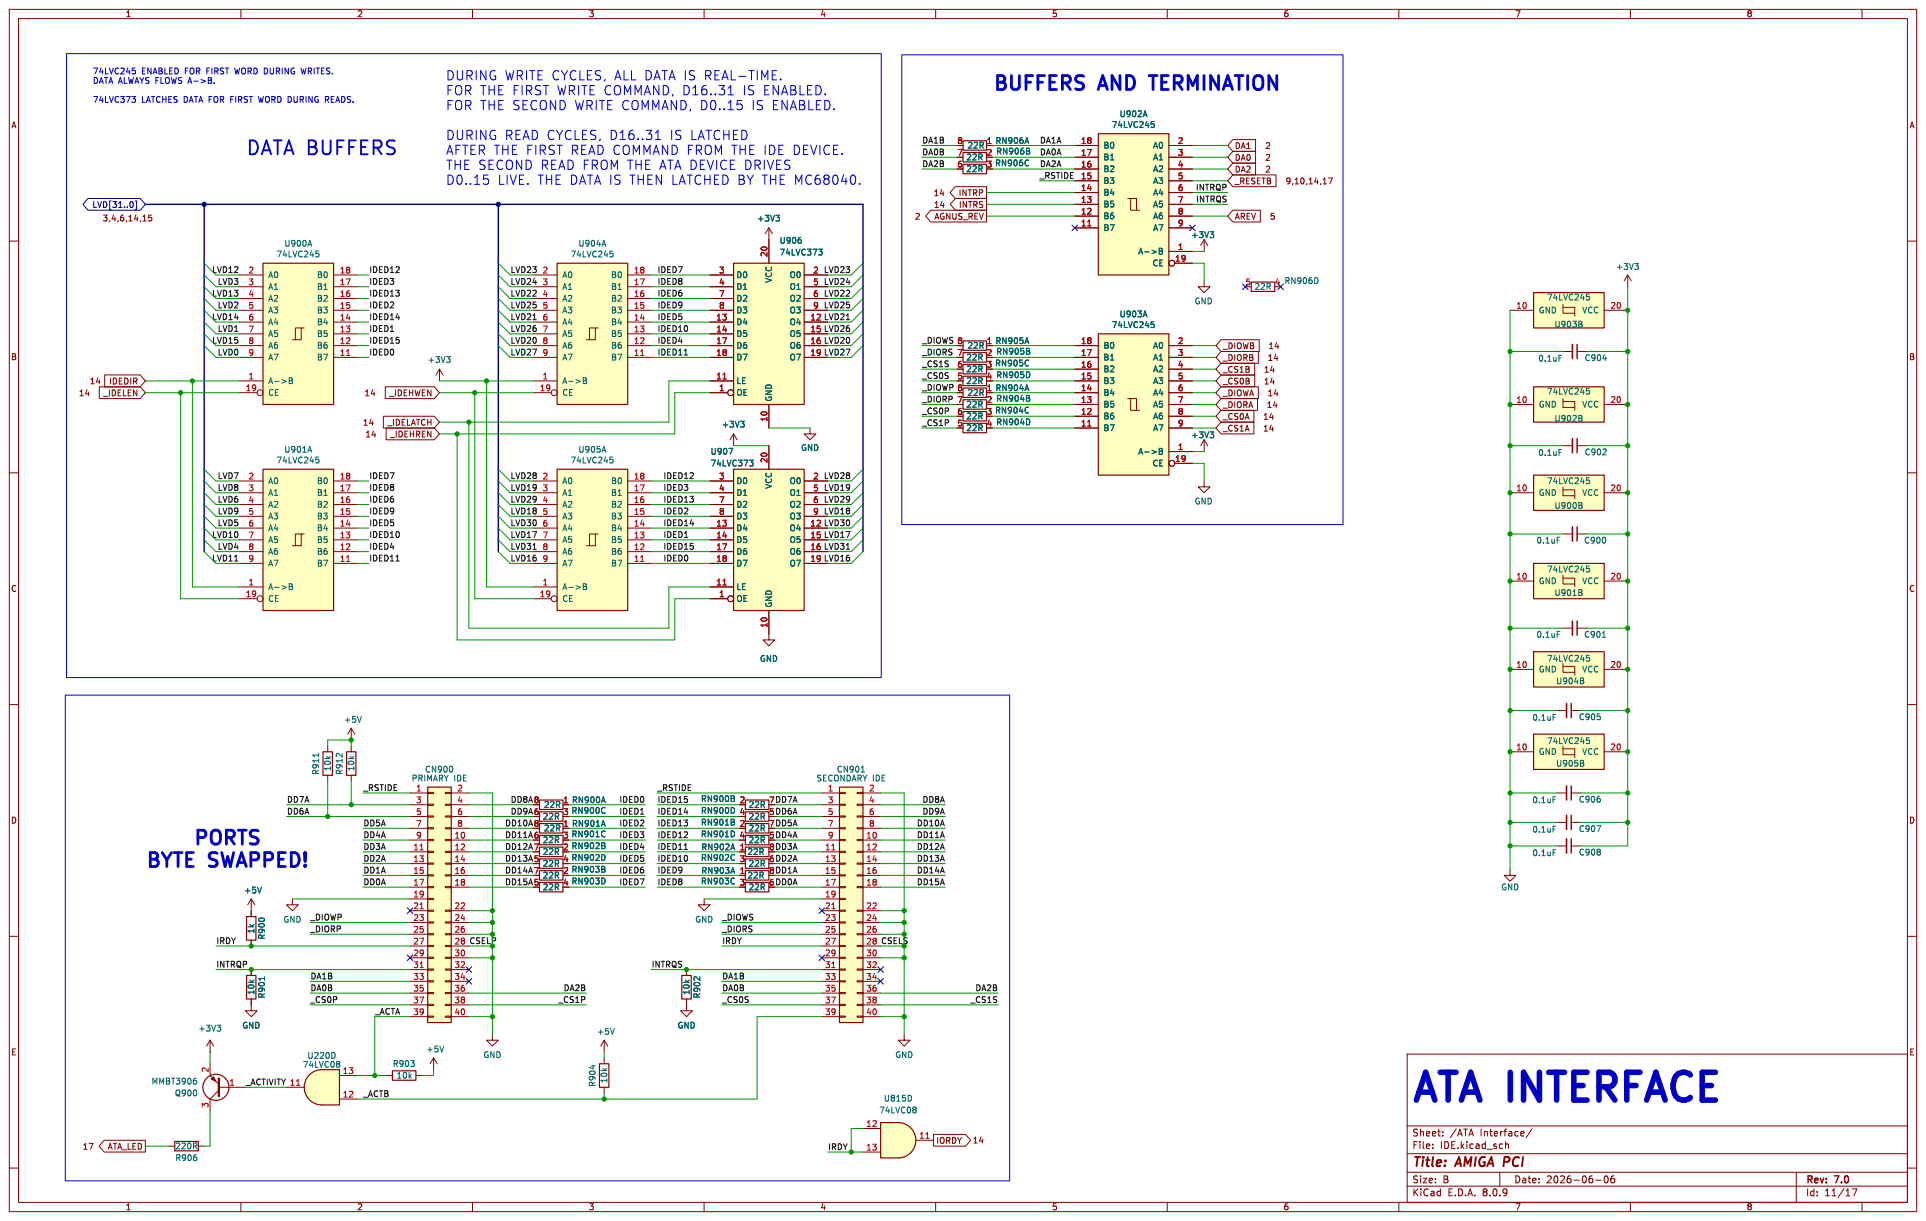
[picture p25: page 11]

74LVC245 ENABLED FOR FIRST WORD DURING WRITES. DATA ALWAYS FLOWS A->B. 74LVC373 LATCHES DATA FOR FIRST WORD DURING READS. PORTS

DURING WRITE CYCLES, ALL DATA IS REAL-TIME.
FOR THE FIRST WRITE COMMAND, D16..31 IS ENABLED.
FOR THE SECOND WRITE COMMAND, D0..15 IS ENABLED.

DURING READ CYCLES, D16..31 IS LATCHED
AFTER THE FIRST READ COMMAND FROM THE IDE DEVICE.
THE SECOND READ FROM THE ATA DEVICE DRIVES
D0..15 LIVE. THE DATA IS THEN LATCHED BY THE MC68040.

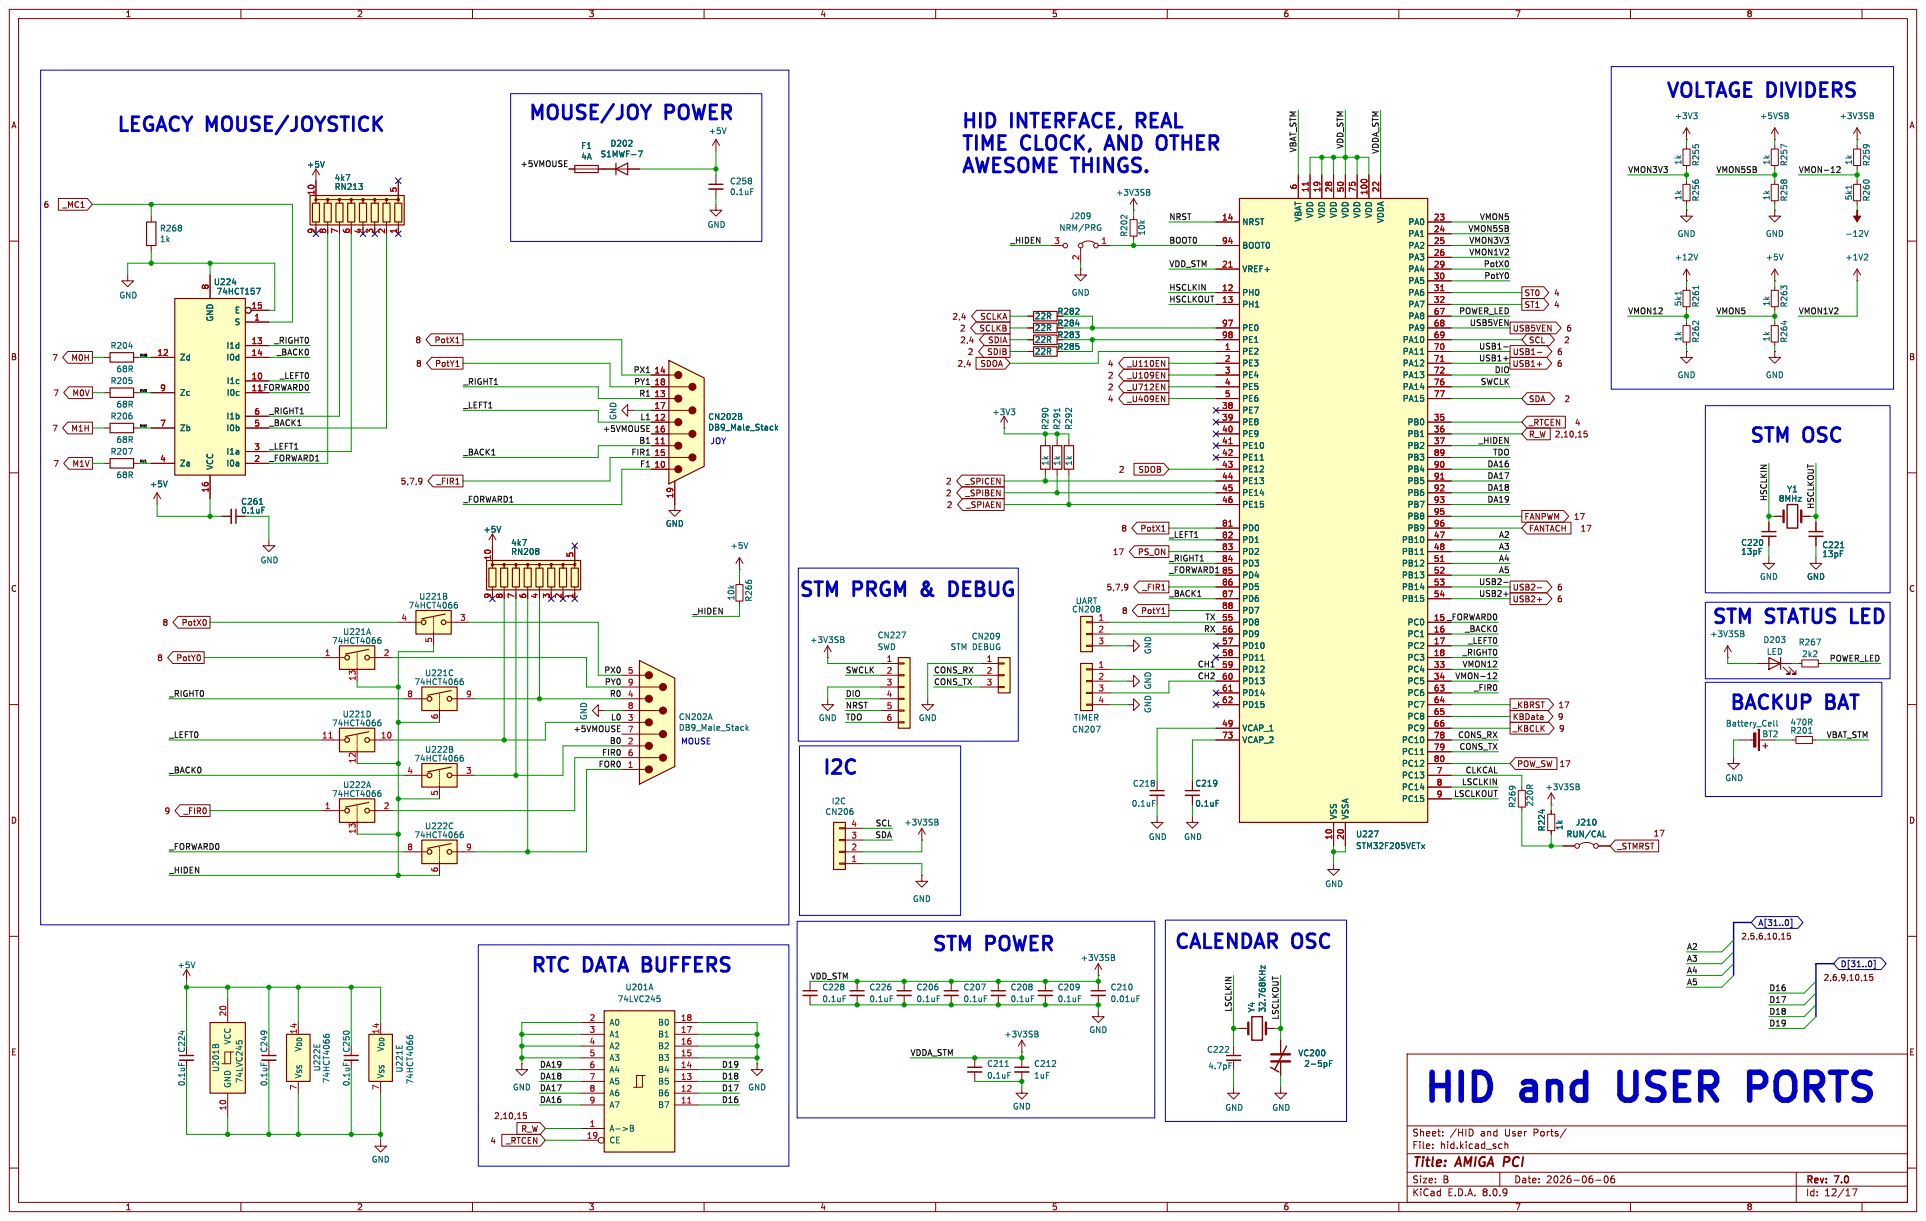
[picture p26: page 12]

HID INTERFACE, REAL
TIME CLOCK, AND OTHER

AWESOME THINGS. MOUSE LEGACY MOUSE/JOYSTICK

HID and USER PORTS

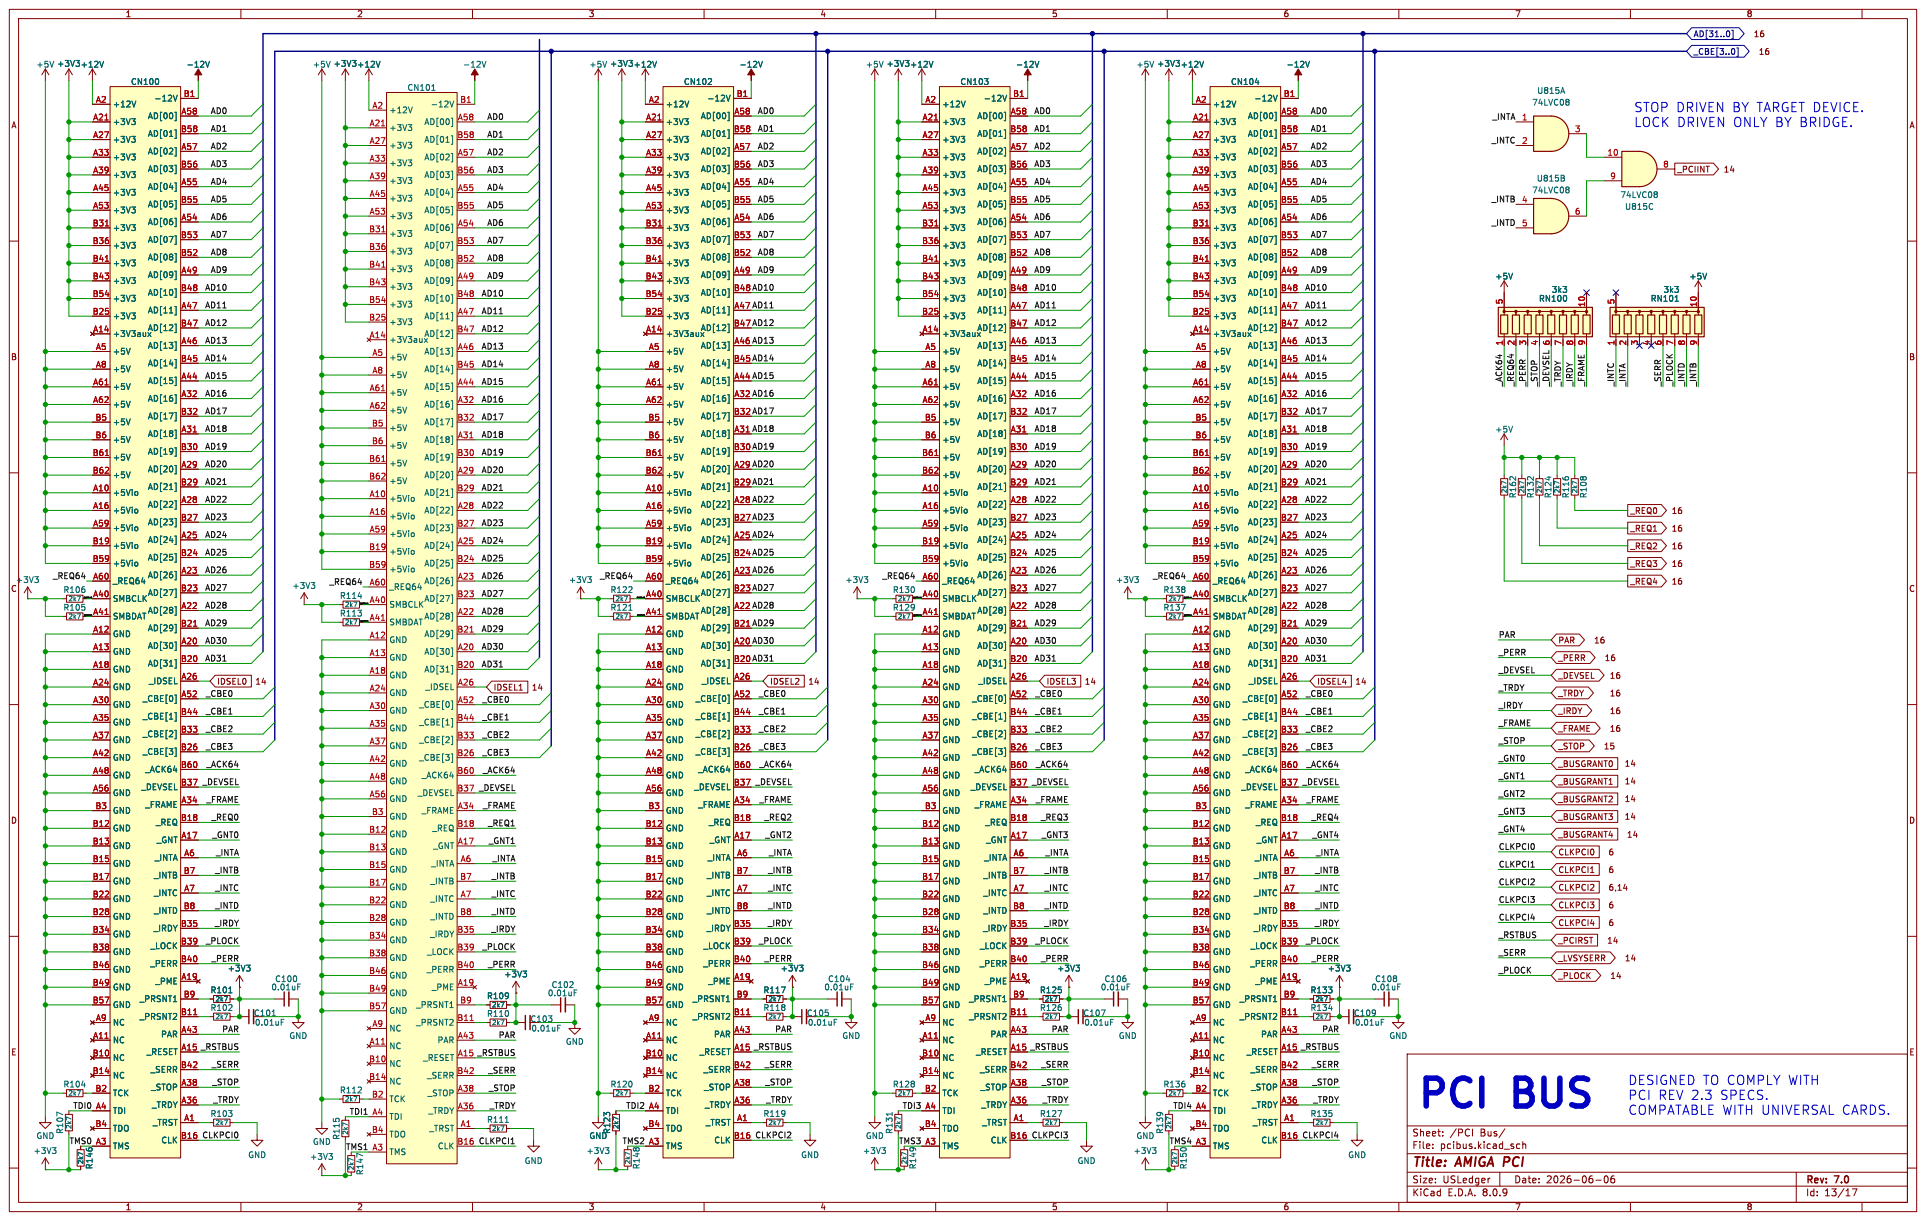
[picture p27: page 13]

LOCK DRIVEN ONLY BY BRIDGE.

DESIGNED TO COMPLY WITH
PCI REV 2.3 SPECS.
COMPATABLE WITH UNIVERSAL CARDS.

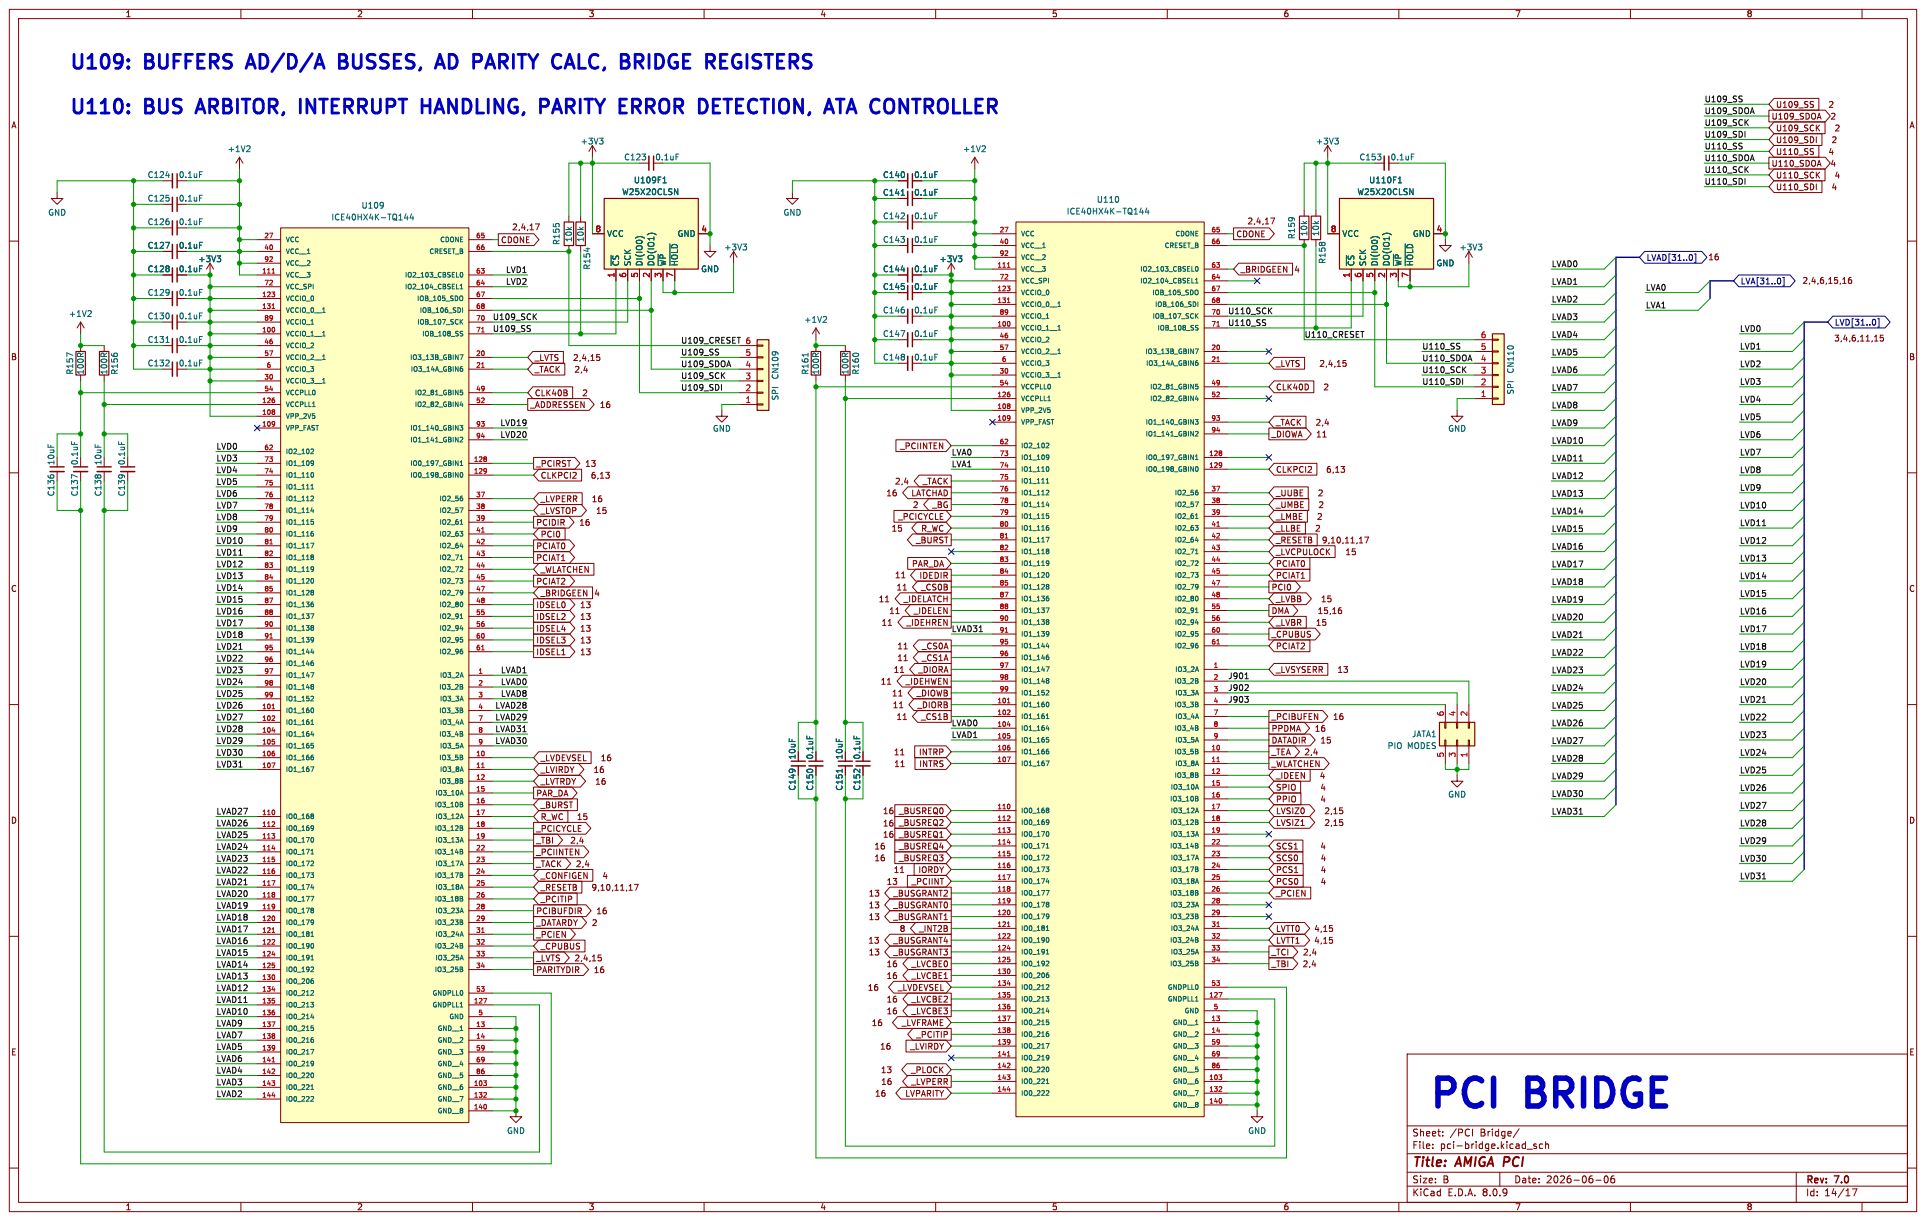
[picture p28: page 14]

U110: BUS ARBITOR, INTERRUPT HANDLING, PARITY ERROR DETECTION, ATA CONTROLLER

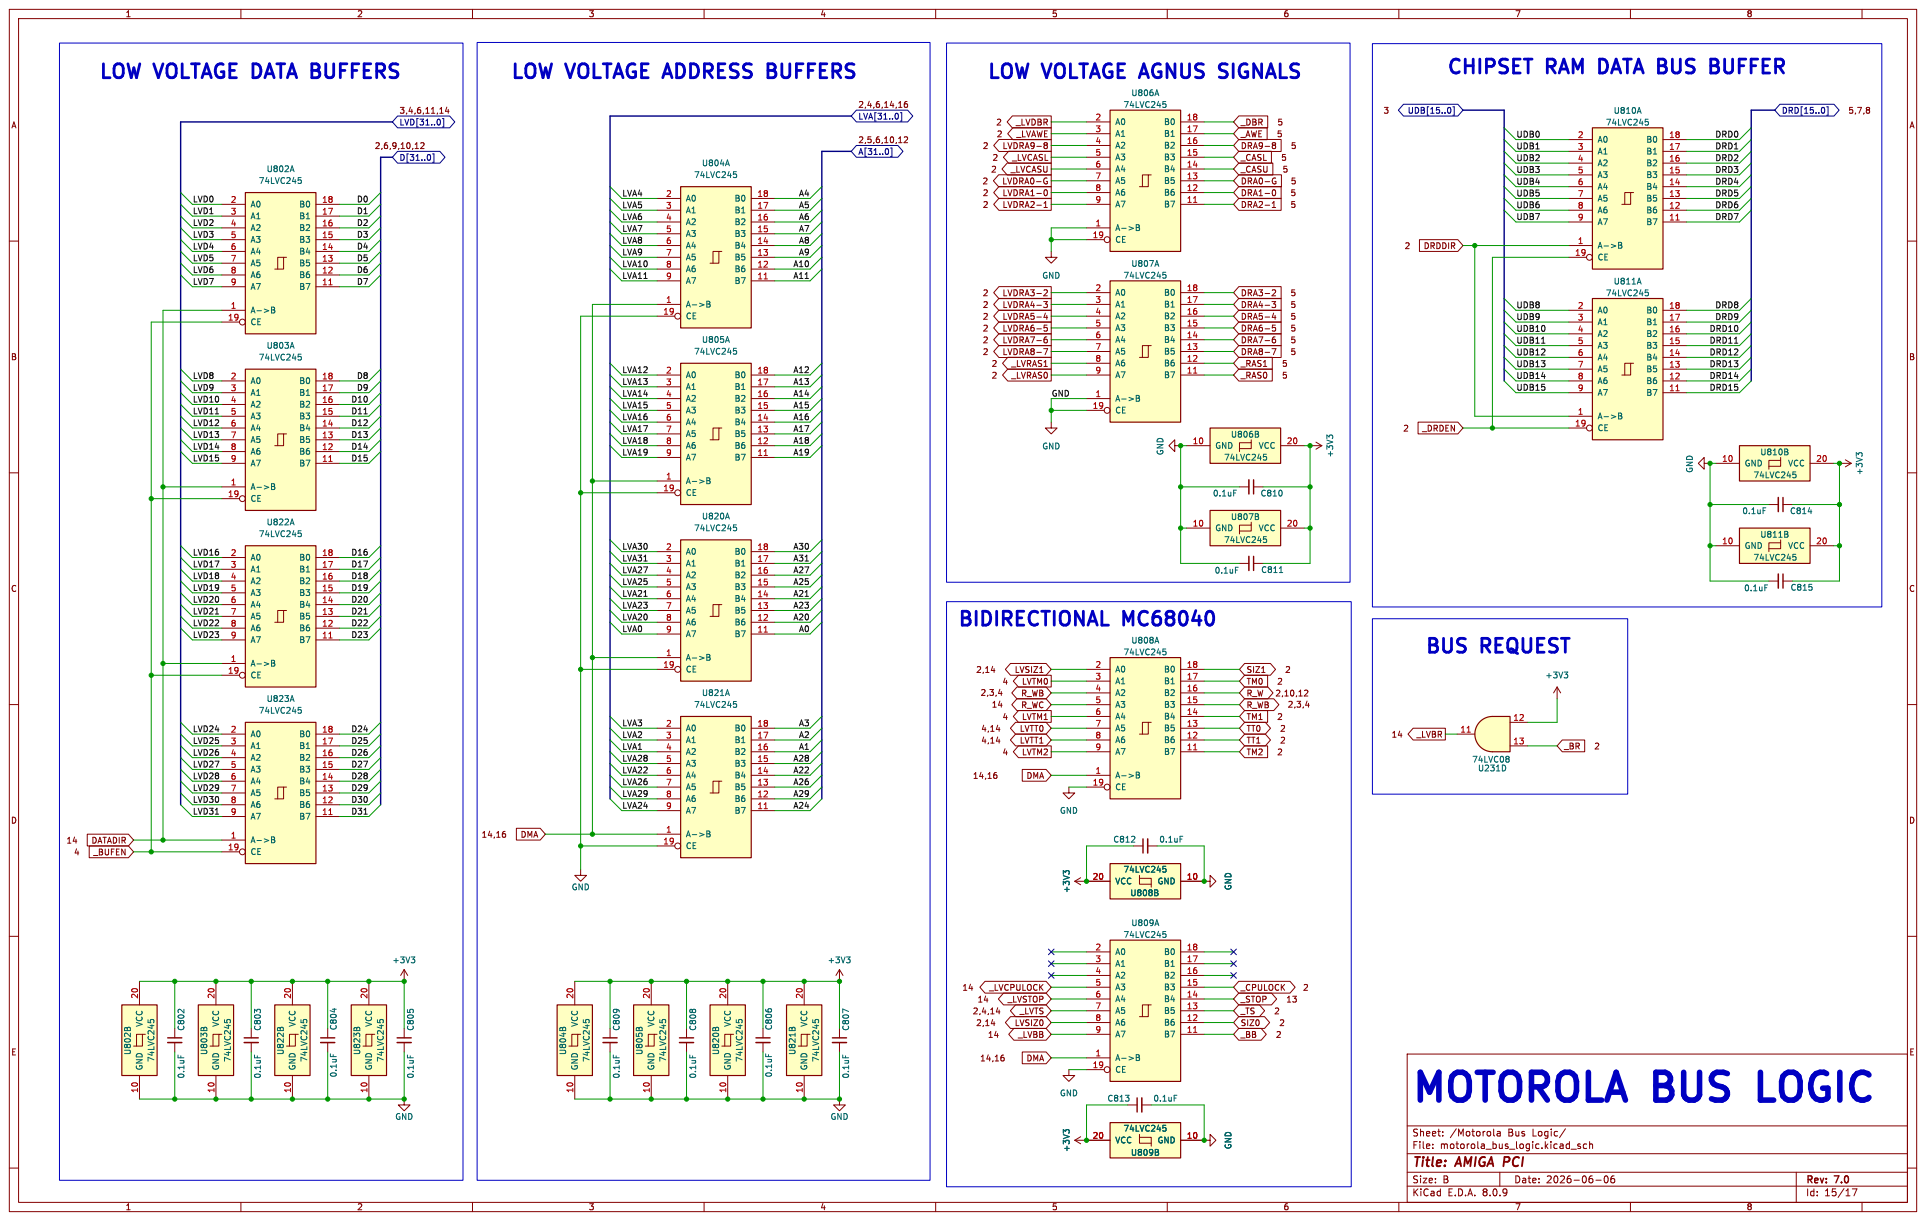
[picture p29: page 15]

LOW VOLTAGE ADDRESS BUFFERS

CHIPSET RAM DATA BUS BUFFER

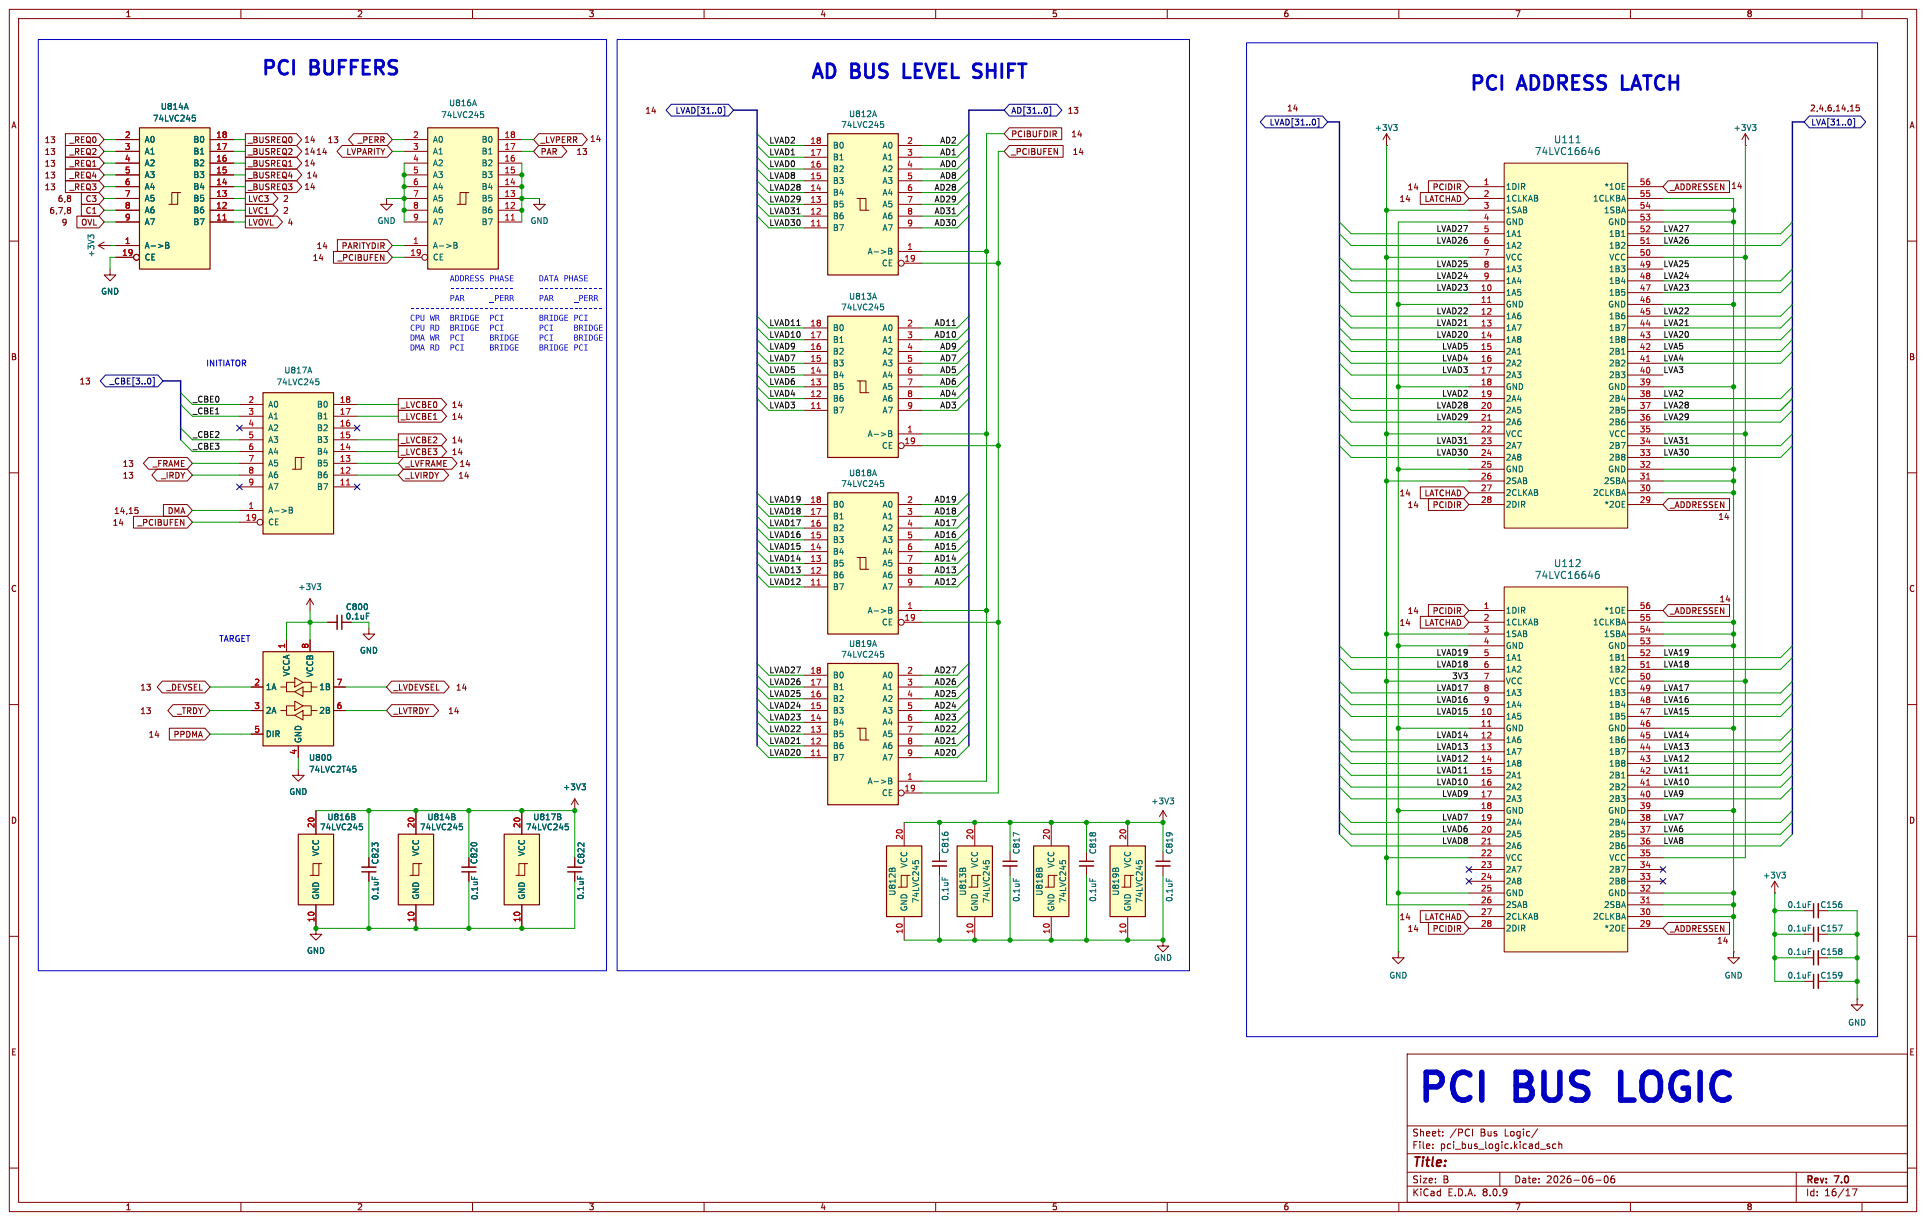
[picture p30: page 16]

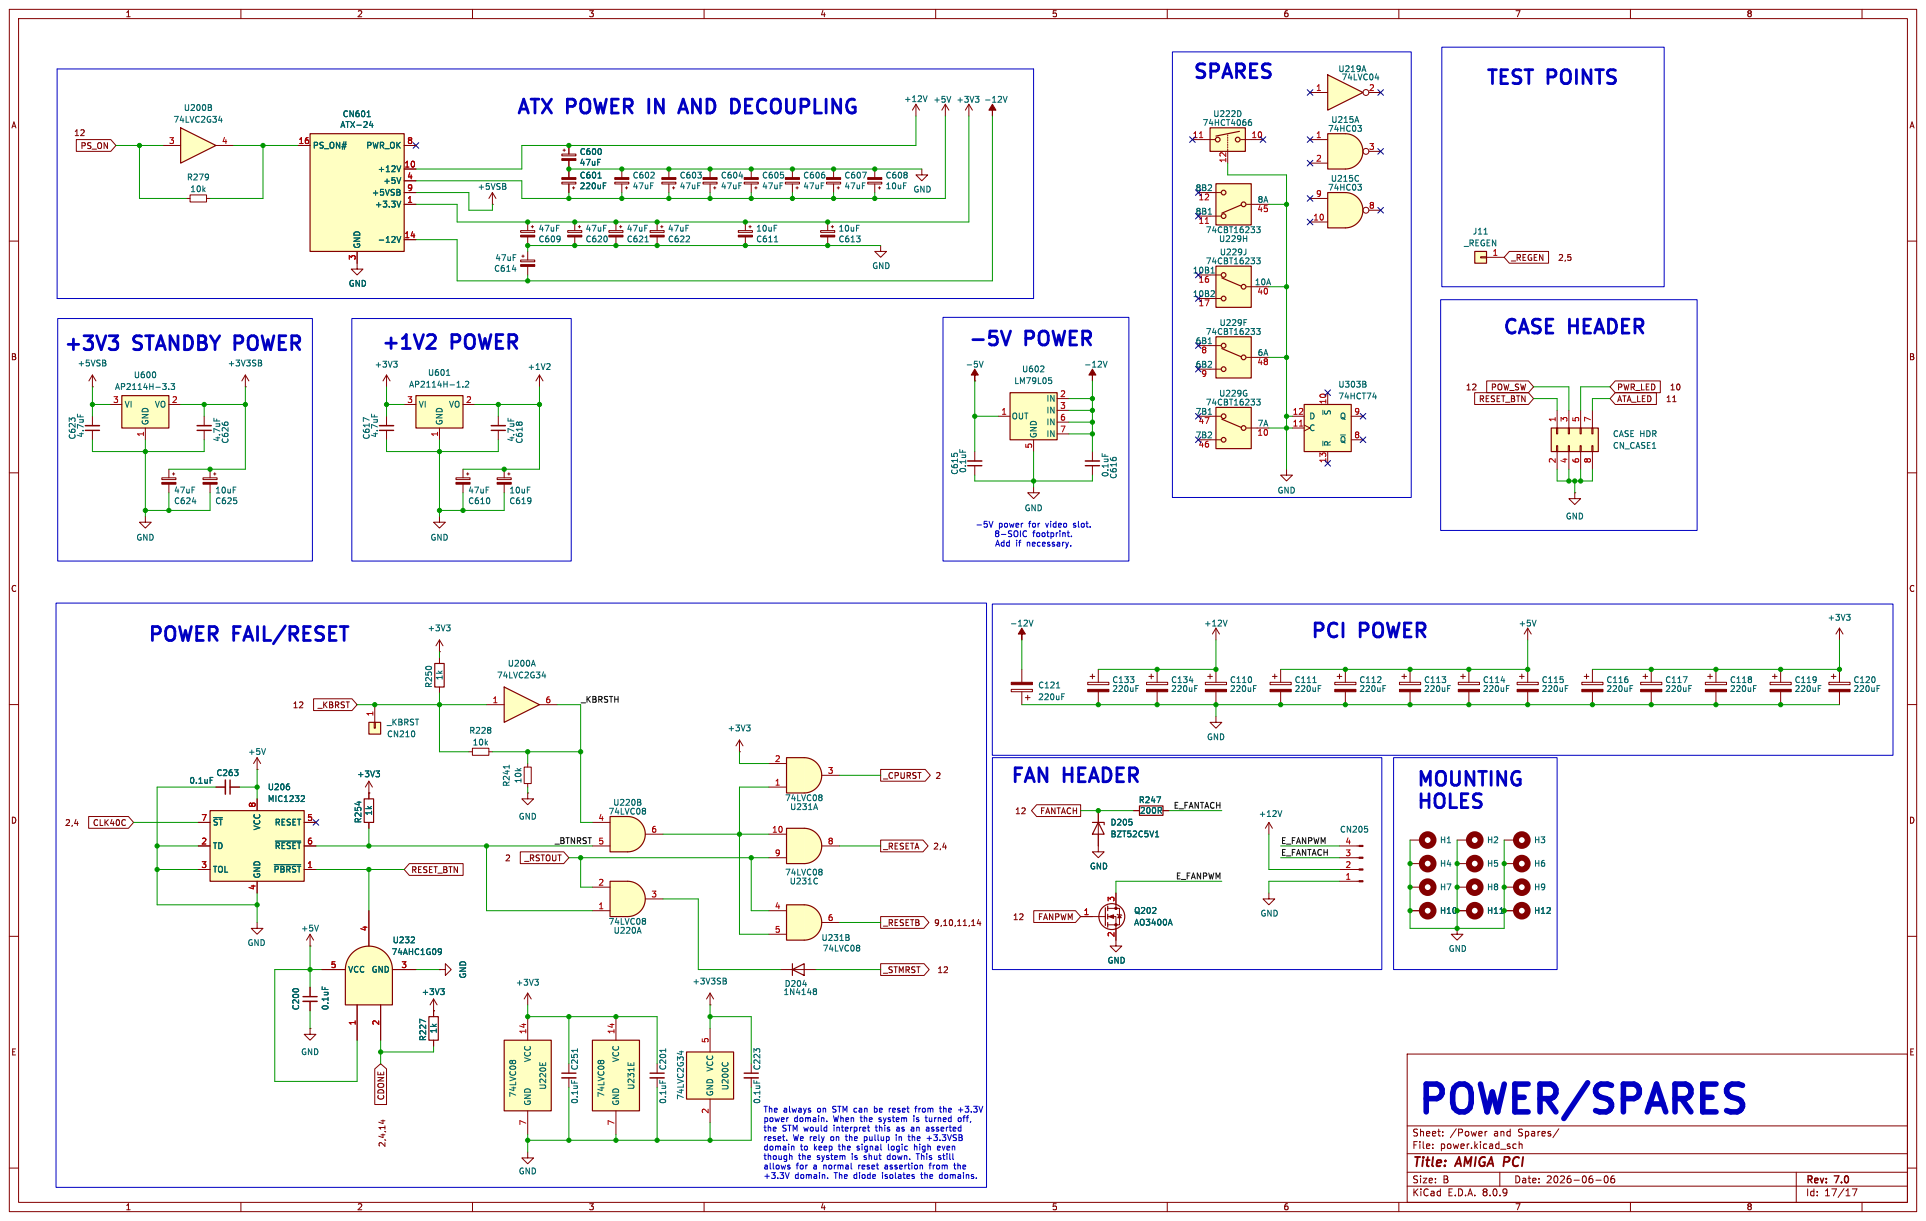
[picture p31: page 17]

ATX POWER IN AND DECOUPLING

4 VCC 5 R227 1k +3V3 C200 0.1uF U206 MIC1232 ~{PBRST}1 TD 2 TOL 3 GND

4 RESET 5 ~{RESET}6 ~{ST} 7 VCC

The always on STM can be reset from the +3.3V
power domain. When the system is turned off,
reset. We rely on the pullup in the +3.3VSB
domain to keep the signal logic high even
