AmigaPCI/AmigaPCI-MainBoard/KiCAD/AmigaPCI Mainboard-KiCAD REV 70/Agnus-Multi.kicad_sch

## KiCad design KiCAD/AmigaPCI Mainboard-KiCAD REV 70/Agnus-Multi.kicad_sch (2026-06-26)

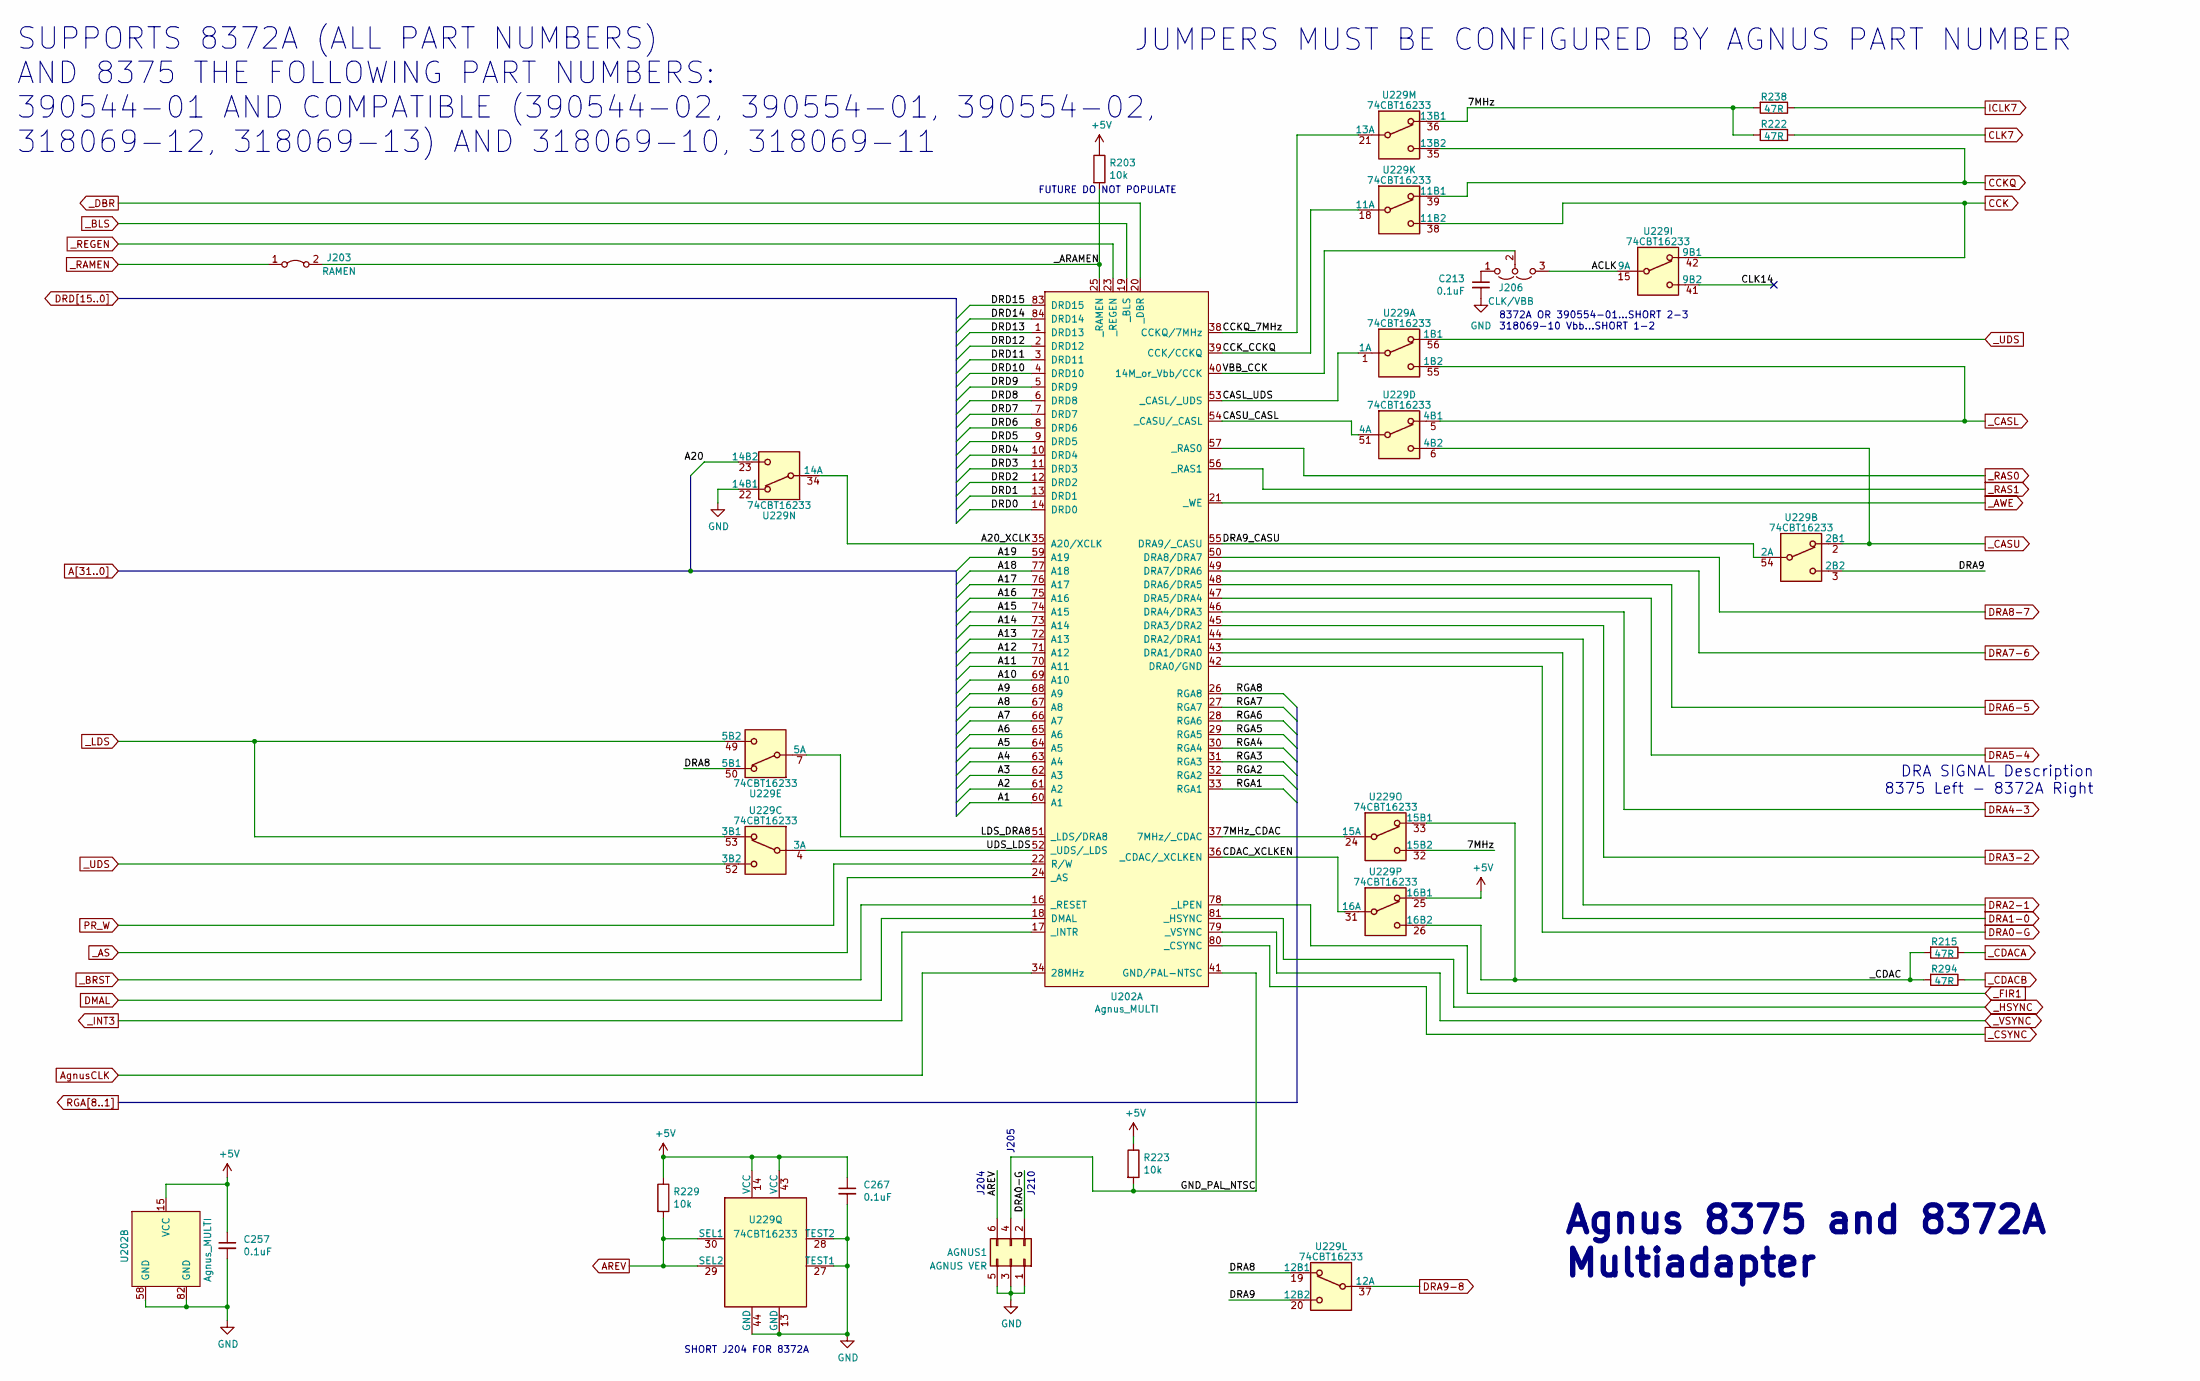
[picture p32: schematic Agnus-Multi.kicad_sch]

Parts:
AGNUS1: AGNUS VER; PinHeader_2x03_P2.54mm_Vertical; LCSC C124384
C213, C257, C267: 0.1uF; C_0603_1608Metric; LCSC C14663
J203: RAMEN; SolderJumper-2_P1.3mm_Bridged_RoundedPad1.0x1.5mm
J206: CLK/VBB; PinHeader_1x03_P2.54mm_Vertical; LCSC C49257
R203, R223, R229: 10k; R_0603_1608Metric; LCSC C25804
R215, R222, R238, R294: 47R; R_0603_1608Metric; LCSC C23182
U202: Agnus_MULTI; PLCC-84_SMD-Socket; LCSC C5445002
U229: 74CBT16233; SSOP-56_7.5x18.5mm_P0.635mm; Part Number SN74CBT16233DL; LCSC C2674759

Connections:
7MHz: R222.2, R238.2, U229.32 (15B2), U229.36 (13B1)
7MHz_CDAC: U202.37 (7MHz/_CDAC), U229.24 (15A)
+5V: C257.1, C267.1, R203.1, R223.1, R229.1, U202.15 (VCC), U229.14 (VCC), U229.25 (16B1), U229.43 (VCC)
A1: U202.60 (A1)
A2: U202.61 (A2)
A3: U202.62 (A3)
A4: U202.63 (A4)
A5: U202.64 (A5)
A6: U202.65 (A6)
A7: U202.66 (A7)
A8: U202.67 (A8)
A9: U202.68 (A9)
A10: U202.69 (A10)
A11: U202.70 (A11)
A12: U202.71 (A12)
A13: U202.72 (A13)
A14: U202.73 (A14)
A15: U202.74 (A15)
A16: U202.75 (A16)
A17: U202.76 (A17)
A18: U202.77 (A18)
A19: U202.59 (A19)
A20: U229.23 (14B2)
A20_XCLK: U202.35 (A20/XCLK), U229.34 (14A)
ACLK: J206.3 (B), U229.15 (9A)
AREV: AGNUS1.6, R229.2, U229.29 (SEL2), U229.30 (SEL1)
AgnusCLK: U202.34 (28MHz)
CASL_UDS: U202.53 (_CASL/_UDS), U229.1 (1A)
CASU_CASL: U202.54 (_CASU/_CASL), U229.51 (4A)
CCK: U229.38 (11B2), U229.42 (9B1)
CCKQ: U229.35 (13B2), U229.39 (11B1)
CCKQ_7MHz: U202.38 (CCKQ/7MHz), U229.21 (13A)
CCK_CCKQ: U202.39 (CCK/CCKQ), U229.18 (11A)
CDAC_XCLKEN: U202.36 (_CDAC/_XCLKEN), U229.31 (16A)
CLK7: R222.1
CLK14: U229.41 (9B2)
DMAL: U202.18 (DMAL)
DRA0-G: AGNUS1.2, U202.42 (DRA0/GND)
DRA1-0: U202.43 (DRA1/DRA0)
DRA2-1: U202.44 (DRA2/DRA1)
DRA3-2: U202.45 (DRA3/DRA2)
DRA4-3: U202.46 (DRA4/DRA3)
DRA5-4: U202.47 (DRA5/DRA4)
DRA6-5: U202.48 (DRA6/DRA5)
DRA7-6: U202.49 (DRA7/DRA6)
DRA8: U229.19 (12B1), U229.50 (5B1)
DRA8-7: U202.50 (DRA8/DRA7)
DRA9: U229.3 (2B2), U229.20 (12B2)
DRA9-8: U229.37 (12A)
DRA9_CASU: U202.55 (DRA9/_CASU), U229.54 (2A)
DRD0: U202.14 (DRD0)
DRD1: U202.13 (DRD1)
DRD2: U202.12 (DRD2)
DRD3: U202.11 (DRD3)
DRD4: U202.10 (DRD4)
DRD5: U202.9 (DRD5)
DRD6: U202.8 (DRD6)
DRD7: U202.7 (DRD7)
DRD8: U202.6 (DRD8)
DRD9: U202.5 (DRD9)
DRD10: U202.4 (DRD10)
DRD11: U202.3 (DRD11)
DRD12: U202.2 (DRD12)
DRD13: U202.1 (DRD13)
DRD14: U202.84 (DRD14)
DRD15: U202.83 (DRD15)
GND: AGNUS1.1, AGNUS1.3, AGNUS1.5, C213.2, C257.2, C267.2, U202.58 (GND), U202.82 (GND), U229.13 (GND), U229.22 (14B1), U229.27 (TEST1), U229.28 (TEST2), U229.44 (GND)
GND_PAL_NTSC: AGNUS1.4, R223.2, U202.41 (GND/PAL-NTSC)
ICLK7: R238.1
LDS_DRA8: U202.51 (_LDS/DRA8), U229.7 (5A)
unnamed: C213.1, J206.1 (A)
PR_W: U202.22 (R/W)
RGA1: U202.33 (RGA1)
RGA2: U202.32 (RGA2)
RGA3: U202.31 (RGA3)
RGA4: U202.30 (RGA4)
RGA5: U202.29 (RGA5)
RGA6: U202.28 (RGA6)
RGA7: U202.27 (RGA7)
RGA8: U202.26 (RGA8)
UDS_LDS: U202.52 (_UDS/_LDS), U229.4 (3A)
VBB_CCK: J206.2 (C), U202.40 (14M_or_Vbb/CCK)
_ARAMEN: J203.2 (B), R203.2, U202.25 (_RAMEN)
_AS: U202.24 (_AS)
_AWE: U202.21 (_WE)
_BLS: U202.19 (_BLS)
_BRST: U202.16 (_RESET)
_CASL: U229.5 (4B1), U229.55 (1B2)
_CASU: U229.2 (2B1), U229.6 (4B2)
_CDAC: R215.2, R294.2, U229.26 (16B2), U229.33 (15B1)
_CDACA: R215.1
_CDACB: R294.1
_CSYNC: U202.80 (_CSYNC)
_DBR: U202.20 (_DBR)
_FIR1: U202.78 (_LPEN)
_HSYNC: U202.81 (_HSYNC)
_INT3: U202.17 (_INTR)
_LDS: U229.49 (5B2), U229.53 (3B1)
_RAMEN: J203.1 (A)
_RAS0: U202.57 (_RAS0)
_RAS1: U202.56 (_RAS1)
_REGEN: U202.23 (_REGEN)
_UDS: U229.52 (3B2), U229.56 (1B1)
_VSYNC: U202.79 (_VSYNC)

Notes on the sheet:
FUTURE DO NOT POPULATE
SHORT J204 FOR 8372A
DRA SIGNAL Description 8375 Left - 8372A Right
Agnus 8375 and 8372A Multiadapter
J205
JUMPERS MUST BE CONFIGURED BY AGNUS PART NUMBER
SUPPORTS 8372A (ALL PART NUMBERS) AND 8375 THE FOLLOWING PART NUMBERS: 390544-01 AND COMPATIBLE (390544-02, 390554-01, 390554-02, 318069-12, 318069-13) AND 318069-10, 318069-11
8372A OR 390554-01...SHORT 2-3 318069-10 Vbb...SHORT 1-2
J210
J204
