AmigaPCI/AmigaPCI-MainBoard/KiCAD/AmigaPCI Mainboard-KiCAD REV 70/IDE.kicad_sch

## KiCad design KiCAD/AmigaPCI Mainboard-KiCAD REV 70/IDE.kicad_sch (2026-06-26)

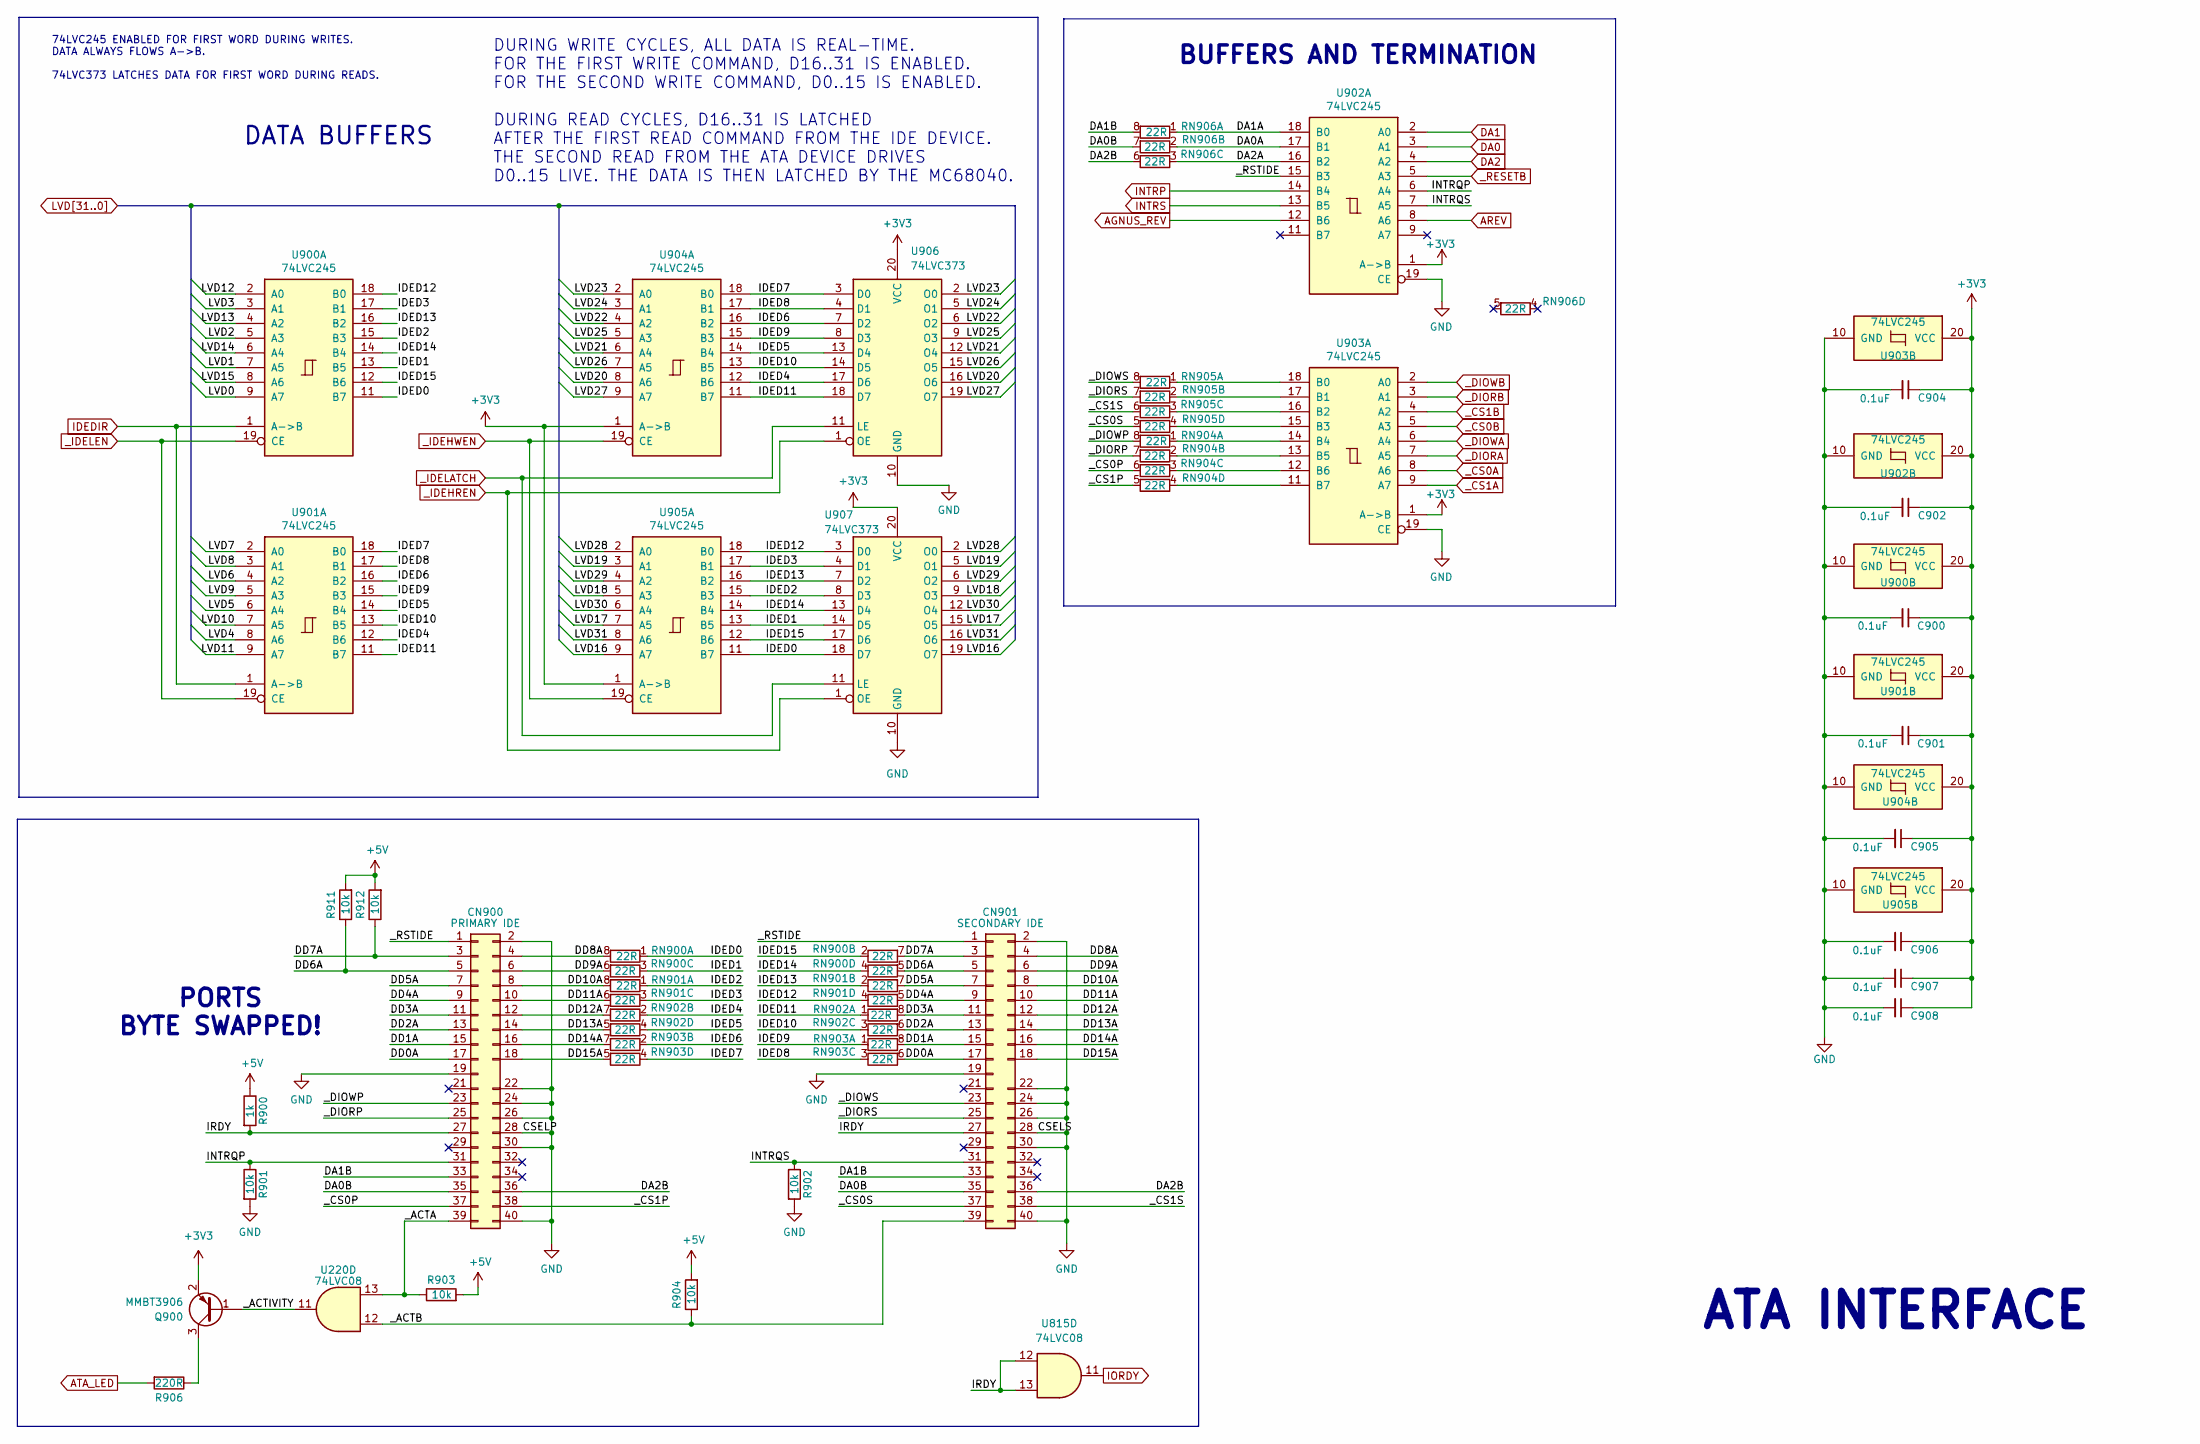
[picture p33: schematic IDE.kicad_sch]

Parts:
C900, C901, C902, C904, C905, C906, C907, C908: 0.1uF; C_0603_1608Metric; LCSC C14663
CN900: PRIMARY IDE; ATA_Header_2x20_P2.54mm; LCSC C429965
CN901: SECONDARY IDE; ATA_Header_2x20_P2.54mm; LCSC C429965
Q900: MMBT3906; SOT-23; LCSC C75549
R900: 1k; R_0603_1608Metric; LCSC C21190
R901, R902, R903, R904, R911, R912: 10k; R_0603_1608Metric; LCSC C25804
R906: 220R; R_0603_1608Metric; LCSC C22962
RN900, RN901, RN902, RN903, RN904, RN905, RN906: 22R; R_Array_Convex_4x0603; Part YC164-FR-0722RL; LCSC C12008
U220, U815: 74LVC08; TSSOP-14_4.4x5mm_P0.65mm; LCSC C6053
U900, U901, U902, U903, U904, U905: 74LVC245; TSSOP-20_4.4x6.5mm_P0.65mm; LCSC C7848
U906, U907: 74LVC373; TSSOP-20_4.4x6.5mm_P0.65mm; LCSC C485083

Connections:
+3V3: C900.1, C901.1, C902.1, C904.1, C905.1, C906.1, C907.1, C908.1, Q900.2 (E), U900.20 (VCC), U901.20 (VCC), U902.1 (A->B), U902.20 (VCC), U903.1 (A->B), U903.20 (VCC), U904.1 (A->B), U904.20 (VCC), U905.1 (A->B), U905.20 (VCC), U906.20 (VCC), U907.20 (VCC)
+5V: R900.1, R903.2, R904.2, R911.2, R912.2
AGNUS_REV: U902.12 (B6)
AREV: U902.8 (A6)
ATA_LED: R906.2
DA0: U902.3 (A1)
DA0A: RN906.2 (R2.1), U902.17 (B1)
DA0B: CN900.35, CN901.35, RN906.7 (R2.2)
DA1: U902.2 (A0)
DA1A: RN906.1 (R1.1), U902.18 (B0)
DA1B: CN900.33, CN901.33, RN906.8 (R1.2)
DA2: U902.4 (A2)
DA2A: RN906.3 (R3.1), U902.16 (B2)
DA2B: CN900.36, CN901.36, RN906.6 (R3.2)
DD0A: CN900.17, CN901.17, RN903.6 (R3.2)
DD1A: CN900.15, CN901.15, RN903.8 (R1.2)
DD2A: CN900.13, CN901.13, RN902.6 (R3.2)
DD3A: CN900.11, CN901.11, RN902.8 (R1.2)
DD4A: CN900.9, CN901.9, RN901.5 (R4.2)
DD5A: CN900.7, CN901.7, RN901.7 (R2.2)
DD6A: CN900.5, CN901.5, R911.1, RN900.5 (R4.2)
DD7A: CN900.3, CN901.3, R912.1, RN900.7 (R2.2)
DD8A: CN900.4, CN901.4, RN900.8 (R1.2)
DD9A: CN900.6, CN901.6, RN900.6 (R3.2)
DD10A: CN900.8, CN901.8, RN901.8 (R1.2)
DD11A: CN900.10, CN901.10, RN901.6 (R3.2)
DD12A: CN900.12, CN901.12, RN902.7 (R2.2)
DD13A: CN900.14, CN901.14, RN902.5 (R4.2)
DD14A: CN900.16, CN901.16, RN903.7 (R2.2)
DD15A: CN900.18, CN901.18, RN903.5 (R4.2)
GND: C900.2, C901.2, C902.2, C904.2, C905.2, C906.2, C907.2, C908.2, CN900.2, CN900.19, CN900.22, CN900.24, CN900.26, CN900.28, CN900.30, CN900.40, CN901.2, CN901.19, CN901.22, CN901.24, CN901.26, CN901.28, CN901.30, CN901.40, R901.2, R902.2, U900.10 (GND), U901.10 (GND), U902.10 (GND), U902.19 (CE), U903.10 (GND), U903.19 (CE), U904.10 (GND), U905.10 (GND), U906.10 (GND), U907.10 (GND)
IDED0: RN900.1 (R1.1), U900.11 (B7), U905.11 (B7), U907.18 (D7)
IDED1: RN900.3 (R3.1), U900.13 (B5), U905.13 (B5), U907.14 (D5)
IDED2: RN901.1 (R1.1), U900.15 (B3), U905.15 (B3), U907.8 (D3)
IDED3: RN901.3 (R3.1), U900.17 (B1), U905.17 (B1), U907.4 (D1)
IDED4: RN902.2 (R2.1), U901.12 (B6), U904.12 (B6), U906.17 (D6)
IDED5: RN902.4 (R4.1), U901.14 (B4), U904.14 (B4), U906.13 (D4)
IDED6: RN903.2 (R2.1), U901.16 (B2), U904.16 (B2), U906.7 (D2)
IDED7: RN903.4 (R4.1), U901.18 (B0), U904.18 (B0), U906.3 (D0)
IDED8: RN903.3 (R3.1), U901.17 (B1), U904.17 (B1), U906.4 (D1)
IDED9: RN903.1 (R1.1), U901.15 (B3), U904.15 (B3), U906.8 (D3)
IDED10: RN902.3 (R3.1), U901.13 (B5), U904.13 (B5), U906.14 (D5)
IDED11: RN902.1 (R1.1), U901.11 (B7), U904.11 (B7), U906.18 (D7)
IDED12: RN901.4 (R4.1), U900.18 (B0), U905.18 (B0), U907.3 (D0)
IDED13: RN901.2 (R2.1), U900.16 (B2), U905.16 (B2), U907.7 (D2)
IDED14: RN900.4 (R4.1), U900.14 (B4), U905.14 (B4), U907.13 (D4)
IDED15: RN900.2 (R2.1), U900.12 (B6), U905.12 (B6), U907.17 (D6)
IDEDIR: U900.1 (A->B), U901.1 (A->B)
INTRP: U902.14 (B4)
INTRQP: CN900.31, R901.1, U902.6 (A4)
INTRQS: CN901.31, R902.1, U902.7 (A5)
INTRS: U902.13 (B5)
IORDY: U815.11
IRDY: CN900.27, CN901.27, R900.2, U815.12, U815.13
LVD0: U900.9 (A7)
LVD1: U900.7 (A5)
LVD2: U900.5 (A3)
LVD3: U900.3 (A1)
LVD4: U901.8 (A6)
LVD5: U901.6 (A4)
LVD6: U901.4 (A2)
LVD7: U901.2 (A0)
LVD8: U901.3 (A1)
LVD9: U901.5 (A3)
LVD10: U901.7 (A5)
LVD11: U901.9 (A7)
LVD12: U900.2 (A0)
LVD13: U900.4 (A2)
LVD14: U900.6 (A4)
LVD15: U900.8 (A6)
LVD16: U905.9 (A7), U907.19 (O7)
LVD17: U905.7 (A5), U907.15 (O5)
LVD18: U905.5 (A3), U907.9 (O3)
LVD19: U905.3 (A1), U907.5 (O1)
LVD20: U904.8 (A6), U906.16 (O6)
LVD21: U904.6 (A4), U906.12 (O4)
LVD22: U904.4 (A2), U906.6 (O2)
LVD23: U904.2 (A0), U906.2 (O0)
LVD24: U904.3 (A1), U906.5 (O1)
LVD25: U904.5 (A3), U906.9 (O3)
LVD26: U904.7 (A5), U906.15 (O5)
LVD27: U904.9 (A7), U906.19 (O7)
LVD28: U905.2 (A0), U907.2 (O0)
LVD29: U905.4 (A2), U907.6 (O2)
LVD30: U905.6 (A4), U907.12 (O4)
LVD31: U905.8 (A6), U907.16 (O6)
unnamed: Q900.3 (C), R906.1
unnamed: RN904.1 (R1.1), U903.14 (B4)
unnamed: RN904.2 (R2.1), U903.13 (B5)
unnamed: RN904.3 (R3.1), U903.12 (B6)
unnamed: RN904.4 (R4.1), U903.11 (B7)
unnamed: RN905.1 (R1.1), U903.18 (B0)
unnamed: RN905.2 (R2.1), U903.17 (B1)
unnamed: RN905.3 (R3.1), U903.16 (B2)
unnamed: RN905.4 (R4.1), U903.15 (B3)
_ACTA: CN900.39, R903.1, U220.13
_ACTB: CN901.39, R904.1, U220.12
_ACTIVITY: Q900.1 (B), U220.11
_CS0A: U903.8 (A6)
_CS0B: U903.5 (A3)
_CS0P: CN900.37, RN904.6 (R3.2)
_CS0S: CN901.37, RN905.5 (R4.2)
_CS1A: U903.9 (A7)
_CS1B: U903.4 (A2)
_CS1P: CN900.38, RN904.5 (R4.2)
_CS1S: CN901.38, RN905.6 (R3.2)
_DIORA: U903.7 (A5)
_DIORB: U903.3 (A1)
_DIORP: CN900.25, RN904.7 (R2.2)
_DIORS: CN901.25, RN905.7 (R2.2)
_DIOWA: U903.6 (A4)
_DIOWB: U903.2 (A0)
_DIOWP: CN900.23, RN904.8 (R1.2)
_DIOWS: CN901.23, RN905.8 (R1.2)
_IDEHREN: U906.1 (OE), U907.1 (OE)
_IDEHWEN: U904.19 (CE), U905.19 (CE)
_IDELATCH: U906.11 (LE), U907.11 (LE)
_IDELEN: U900.19 (CE), U901.19 (CE)
_RESETB: U902.5 (A3)
_RSTIDE: CN900.1, CN901.1, U902.15 (B3)

Notes on the sheet:
BUFFERS AND TERMINATION
DATA BUFFERS
74LVC245 ENABLED FOR FIRST WORD DURING WRITES. DATA ALWAYS FLOWS A->B. 74LVC373 LATCHES DATA FOR FIRST WORD DURING READS.
ATA INTERFACE
PORTS BYTE SWAPPED!
DURING WRITE CYCLES, ALL DATA IS REAL-TIME. FOR THE FIRST WRITE COMMAND, D16..31 IS ENABLED. FOR THE SECOND WRITE COMMAND, D0..15 IS ENABLED. DURING READ CYCLES, D16..31 IS LATCHED AFTER THE FIRST READ COMMAND FROM THE IDE DEVICE. THE SECOND READ FROM THE ATA DEVICE DRIVES D0..15 LIVE. THE DATA IS 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
