AmigaPCI/AmigaPCI-MainBoard/KiCAD/AmigaPCI Mainboard-KiCAD REV 70/audio.kicad_sch

## KiCad design KiCAD/AmigaPCI Mainboard-KiCAD REV 70/audio.kicad_sch (2026-06-26)

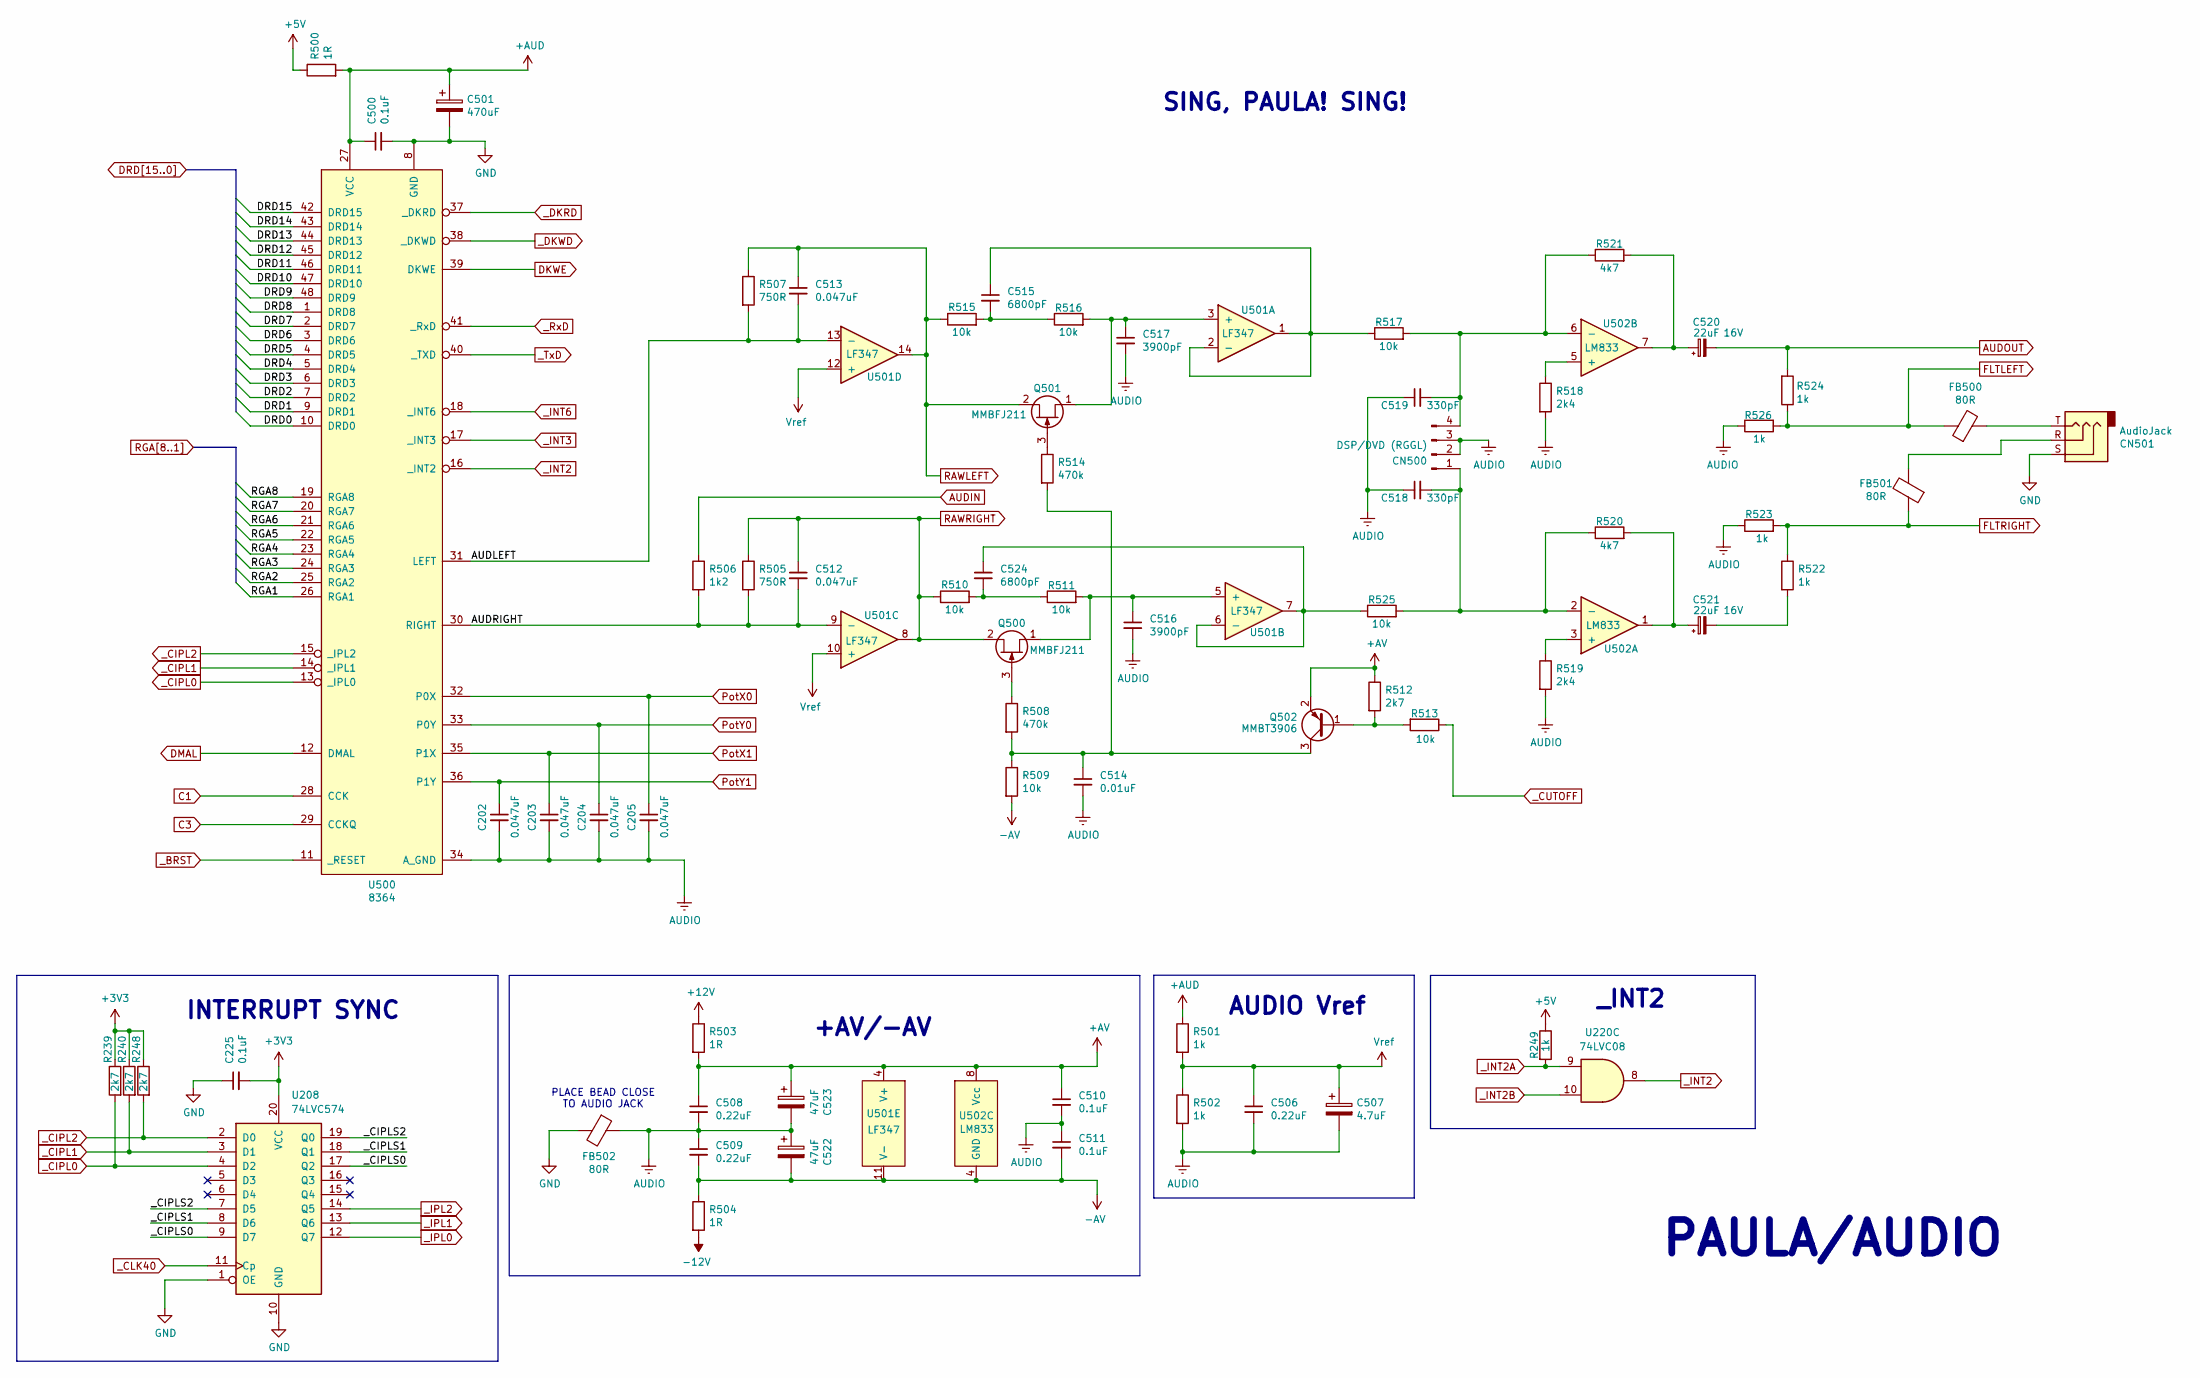
[picture p34: schematic audio.kicad_sch]

Parts:
C202, C203, C204, C205, C512, C513: 0.047uF; C_0603_1608Metric; LCSC C1622
C225, C500, C510, C511: 0.1uF; C_0603_1608Metric; LCSC C14663
C501: 470uF; CP_Radial_D10.0mm_P5.00mm; LCSC C59353
C506, C508, C509: 0.22uF; C_0603_1608Metric; LCSC C21120
C507: 4.7uF; CP_Radial_D5.0mm_P2.00mm; LCSC C88759
C514: 0.01uF; C_0603_1608Metric; LCSC C57112
C515, C524: 6800pF; C_0603_1608Metric; LCSC C1631
C516, C517: 3900pF; C_0603_1608Metric; LCSC C170145
C518, C519: 330pF; C_0603_1608Metric; LCSC C1664
C520, C521: 22uF; CP_Radial_D5.0mm_P2.00mm; LCSC C88755
C522, C523: 47uF; CP_Radial_D5.0mm_P2.00mm; LCSC C88724
CN500: DSP/DVD (RGGL); AudioHeader; Part Number 5-103639-3; LCSC C306099
CN501: AudioJack; Jack_3.5mm_CUI_SJ1-3533NG_Horizontal_CircularHoles; Part SJ1-3533NG; LCSC C4992459
FB500, FB501, FB502: 80R; C_0805_2012Metric; LCSC C2762183
Q500, Q501: MMBFJ211; SOT-23; LCSC C3290016
Q502: MMBT3906; SOT-23; LCSC C75549
R239, R240, R248, R512: 2k7; R_0603_1608Metric; LCSC C13167
R249, R501, R502, R522, R523, R524, R526: 1k; R_0603_1608Metric; LCSC C21190
R500, R503, R504: 1R; R_0603_1608Metric; LCSC C22936
R505, R507: 750R; R_0603_1608Metric; LCSC C114635
R506: 1k2; R_0603_1608Metric; LCSC C22765
R508, R514: 470k; R_0603_1608Metric; LCSC C23178
R509, R510, R511, R513, R515, R516, R517, R525: 10k; R_0603_1608Metric; LCSC C25804
R518, R519: 2k4; R_0603_1608Metric; LCSC C22940
R520, R521: 4k7; R_0603_1608Metric; LCSC C23162
U208: 74LVC574; TSSOP-20_4.4x6.5mm_P0.65mm; LCSC C7672
U220: 74LVC08; TSSOP-14_4.4x5mm_P0.65mm; LCSC C6053
U500: 8364; DIP-48_W15.24mm; LCSC C5510465
U501: LF347; SOIC-14_3.9x8.7mm_P1.27mm; LCSC C7917
U502: LM833; SOIC-8_3.9x4.9mm_P1.27mm; LCSC C127074

Connections:
+3V3: C225.2, R239.1, R240.1, R248.1, U208.20 (VCC)
+5V: R249.1, R500.1
+12V: R503.1
+AUD: C500.1, C501.1, R500.2, R501.1, U500.27 (VCC)
+AV: C508.1, C510.1, C523.1, Q502.2 (E), R503.2, R512.1, U501.4 (V+), U502.8 (Vcc)
-12V: R504.2
-AV: C509.2, C511.2, C522.2, R504.1, R509.2, U501.11 (V-), U502.4 (GND)
AUDIN: R506.1
AUDIO: C202.2, C203.2, C204.2, C205.2, C506.2, C507.2, C508.2, C509.1, C510.2, C511.1, C514.2, C516.2, C517.2, C518.1, C519.1, C522.1, C523.2, CN500.2, CN500.3, FB502.1, R502.2, R518.2, R519.2, R523.1, R526.1, U500.34 (A_GND)
AUDLEFT: C513.2, R507.2, U500.31 (LEFT), U501.13 (-)
AUDOUT: C520.2, R524.2
AUDRIGHT: C512.2, R505.2, R506.2, U500.30 (RIGHT), U501.9 (-)
C1: U500.28 (CCK)
C3: U500.29 (CCKQ)
DKWE: U500.39 (DKWE)
DMAL: U500.12 (DMAL)
DRD0: U500.10 (DRD0)
DRD1: U500.9 (DRD1)
DRD2: U500.7 (DRD2)
DRD3: U500.6 (DRD3)
DRD4: U500.5 (DRD4)
DRD5: U500.4 (DRD5)
DRD6: U500.3 (DRD6)
DRD7: U500.2 (DRD7)
DRD8: U500.1 (DRD8)
DRD9: U500.48 (DRD9)
DRD10: U500.47 (DRD10)
DRD11: U500.46 (DRD11)
DRD12: U500.45 (DRD12)
DRD13: U500.44 (DRD13)
DRD14: U500.43 (DRD14)
DRD15: U500.42 (DRD15)
FLTLEFT: FB500.1, R524.1, R526.2
FLTRIGHT: FB501.1, R522.1, R523.2
GND: C225.1, C500.2, C501.2, CN501.S, FB502.2, U208.1 (OE), U208.10 (GND), U500.8 (GND)
unnamed: C514.1, Q502.3 (C), R508.2, R509.1, R514.2
unnamed: C515.1, R517.1, U501.1, U501.2 (-)
unnamed: C515.2, R515.2, R516.1
unnamed: C516.1, Q500.1 (S), R511.2, U501.5 (+)
unnamed: C517.1, Q501.1 (S), R516.2, U501.3 (+)
unnamed: C518.2, CN500.1, R520.1, R525.2, U502.2 (-)
unnamed: C519.2, CN500.4, R517.2, R521.1, U502.6 (-)
unnamed: C520.1, R521.2, U502.7
unnamed: C521.1, R520.2, U502.1
unnamed: C521.2, R522.2
unnamed: C524.1, R525.1, U501.6 (-), U501.7
unnamed: C524.2, R510.2, R511.1
unnamed: CN501.R, FB501.2
unnamed: CN501.T, FB500.2
unnamed: Q500.3 (G), R508.1
unnamed: Q501.3 (G), R514.1
unnamed: Q502.1 (B), R512.2, R513.2
unnamed: R518.1, U502.5 (+)
unnamed: R519.1, U502.3 (+)
PotX0: C205.1, U500.32 (P0X)
PotX1: C203.1, U500.35 (P1X)
PotY0: C204.1, U500.33 (P0Y)
PotY1: C202.1, U500.36 (P1Y)
RAWLEFT: C513.1, Q501.2 (D), R507.1, R515.1, U501.14
RAWRIGHT: C512.1, Q500.2 (D), R505.1, R510.1, U501.8
RGA1: U500.26 (RGA1)
RGA2: U500.25 (RGA2)
RGA3: U500.24 (RGA3)
RGA4: U500.23 (RGA4)
RGA5: U500.22 (RGA5)
RGA6: U500.21 (RGA6)
RGA7: U500.20 (RGA7)
RGA8: U500.19 (RGA8)
Vref: C506.1, C507.1, R501.2, R502.1, U501.10 (+), U501.12 (+)
_BRST: U500.11 (_RESET)
_CIPL0: R239.2, U208.4 (D2), U500.13 (_IPL0)
_CIPL1: R240.2, U208.3 (D1), U500.14 (_IPL1)
_CIPL2: R248.2, U208.2 (D0), U500.15 (_IPL2)
_CIPLS0: U208.9 (D7), U208.17 (Q2)
_CIPLS1: U208.8 (D6), U208.18 (Q1)
_CIPLS2: U208.7 (D5), U208.19 (Q0)
_CLK40: U208.11 (Cp)
_CUTOFF: R513.1
_DKRD: U500.37 (_DKRD)
_DKWD: U500.38 (_DKWD)
_INT2: U220.8, U500.16 (_INT2)
_INT2A: R249.2, U220.9
_INT2B: U220.10
_INT3: U500.17 (_INT3)
_INT6: U500.18 (_INT6)
_IPL0: U208.12 (Q7)
_IPL1: U208.13 (Q6)
_IPL2: U208.14 (Q5)
_RxD: U500.41 (_RxD)
_TxD: U500.40 (_TXD)

Notes on the sheet:
AUDIO Vref
SING, PAULA! SING!
PLACE BEAD CLOSE TO AUDIO JACK
+AV/-AV
INTERRUPT SYNC
_INT2
PAULA/AUDIO
