AmigaPCI/AmigaPCI-MainBoard/KiCAD/AmigaPCI Mainboard-KiCAD REV 70/bcontroller.kicad_sch

## KiCad design KiCAD/AmigaPCI Mainboard-KiCAD REV 70/bcontroller.kicad_sch (2026-06-26)

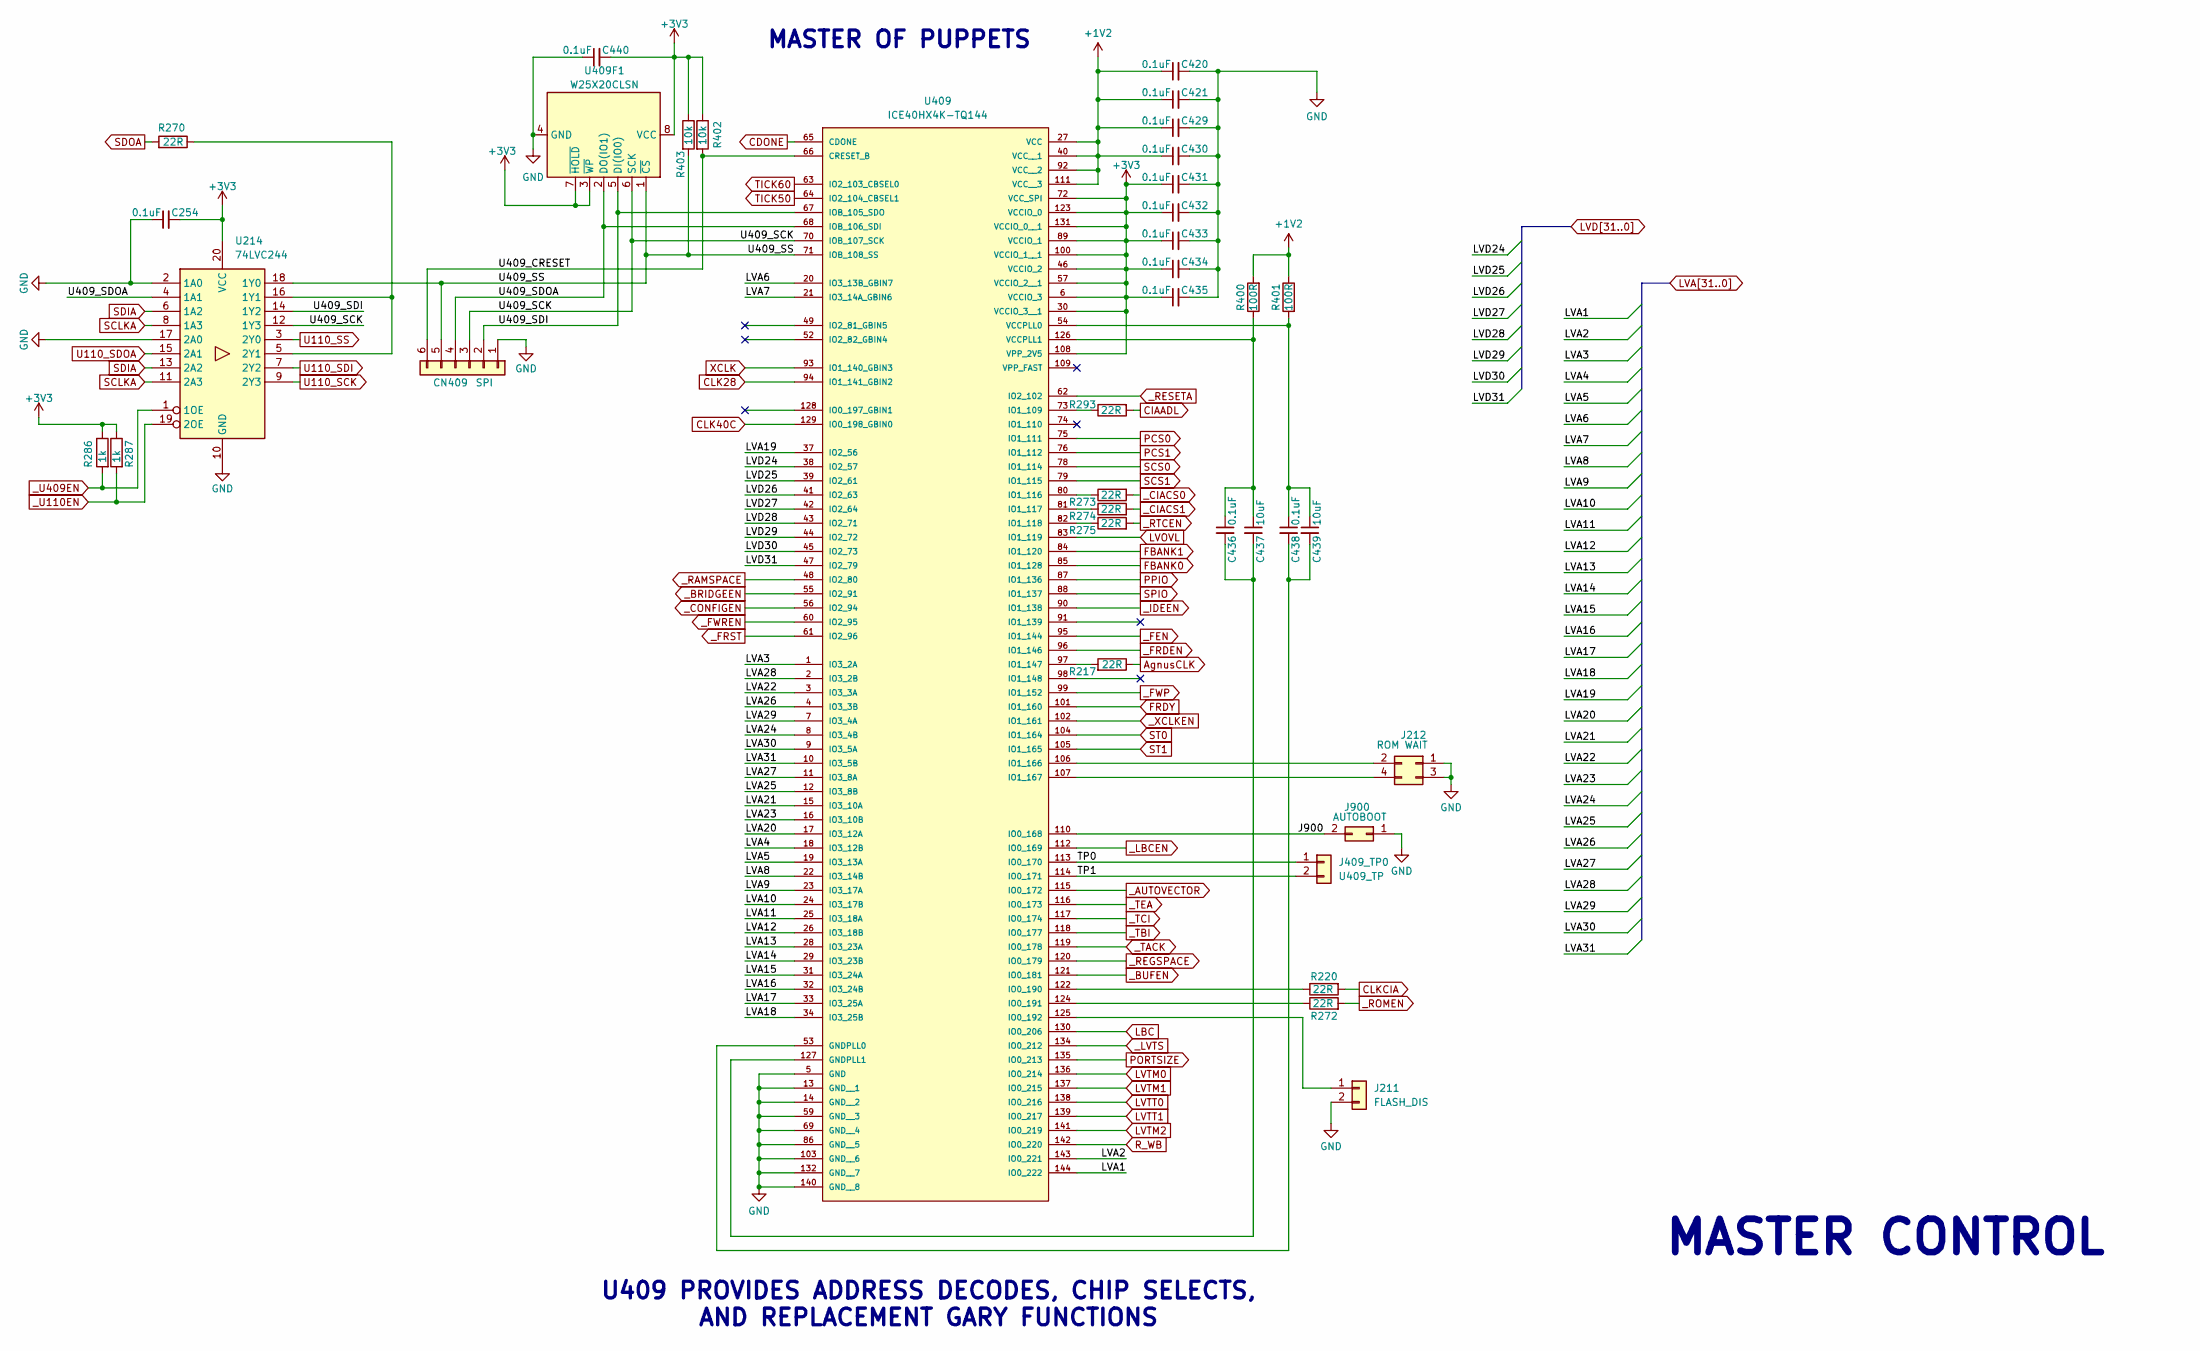
[picture p35: schematic bcontroller.kicad_sch]

Parts:
C254, C420, C421, C429, C430, C431, C432, C433, C434, C435, C436, C438, C440: 0.1uF; C_0603_1608Metric; LCSC C14663
C437, C439: 10uF; C_0603_1608Metric; LCSC C96446
CN409: SPI; PinHeader_1x06_P2.54mm_Vertical; LCSC C37208
J211: FLASH_DIS; PinHeader_2x01_P2.54mm_Vertical; LCSC C124375
J212: ROM WAIT; PinHeader_2x02_P2.54mm_Vertical; LCSC C66690
J409_TP0: U409_TP; PinHeader_2x01_P2.54mm_Vertical; LCSC C124375
J900: AUTOBOOT; PinHeader_2x01_P2.54mm_Vertical; LCSC C124375
R217, R220, R270, R272, R273, R274, R275, R293: 22R; R_0603_1608Metric; LCSC C23345
R286, R287: 1k; R_0603_1608Metric; LCSC C21190
R400, R401: 100R; R_0603_1608Metric; LCSC C22775
R402, R403: 10k; R_0603_1608Metric; LCSC C25804
U214: 74LVC244; TSSOP-20_4.4x6.5mm_P0.65mm; LCSC C7668
U409: ICE40HX4K-TQ144; LQFP-144_20x20mm_P0.5mm; LCSC C1521989
U409F1: W25X20CLSN; SOIC-8_3.9x4.9mm_P1.27mm; LCSC C34591

Connections:
+1V2: C420.1, C421.1, C429.1, C430.1, R400.2, R401.1, U409.27 (VCC), U409.40 (VCC__1), U409.92 (VCC__2), U409.111 (VCC__3)
+3V3: C254.2, C431.1, C432.1, C433.1, C434.1, C435.1, C440.2, R286.1, R287.1, R402.1, R403.1, U214.20 (VCC), U409.6 (VCCIO_3), U409.30 (VCCIO_3__1), U409.46 (VCCIO_2), U409.57 (VCCIO_2__1), U409.72 (VCC_SPI), U409.89 (VCCIO_1), U409.100 (VCCIO_1__1), U409.108 (VPP_2V5), U409.123 (VCCIO_0), U409.131 (VCCIO_0__1), U409F1.3 (~WP), U409F1.7 (~HOLD), U409F1.8 (VCC)
AgnusCLK: R217.1
CDONE: U409.65 (CDONE)
CIAADL: R293.2
CLK28: U409.94 (IO1_141_GBIN2)
CLK40C: U409.129 (IO0_198_GBIN0)
CLKCIA: R220.2
FBANK0: U409.85 (IO1_128)
FBANK1: U409.84 (IO1_120)
FRDY: U409.101 (IO1_160)
GND: C254.1, C420.2, C421.2, C429.2, C430.2, C431.2, C432.2, C433.2, C434.2, C435.2, C440.1, CN409.1, J211.2, J212.1, J212.3, J900.1, U214.2 (1A0), U214.10 (GND), U214.17 (2A0), U409.5 (GND), U409.13 (GND__1), U409.14 (GND__2), U409.59 (GND__3), U409.69 (GND__4), U409.86 (GND__5), U409.103 (GND__6), U409.132 (GND__7), U409.140 (GND__8), U409F1.4 (GND)
J900: J900.2, U409.110 (IO0_168)
LBC: U409.130 (IO0_206)
LVA1: U409.144 (IO0_222)
LVA2: U409.143 (IO0_221)
LVA3: U409.1 (IO3_2A)
LVA4: U409.18 (IO3_12B)
LVA5: U409.19 (IO3_13A)
LVA6: U409.20 (IO3_13B_GBIN7)
LVA7: U409.21 (IO3_14A_GBIN6)
LVA8: U409.22 (IO3_14B)
LVA9: U409.23 (IO3_17A)
LVA10: U409.24 (IO3_17B)
LVA11: U409.25 (IO3_18A)
LVA12: U409.26 (IO3_18B)
LVA13: U409.28 (IO3_23A)
LVA14: U409.29 (IO3_23B)
LVA15: U409.31 (IO3_24A)
LVA16: U409.32 (IO3_24B)
LVA17: U409.33 (IO3_25A)
LVA18: U409.34 (IO3_25B)
LVA19: U409.37 (IO2_56)
LVA20: U409.17 (IO3_12A)
LVA21: U409.15 (IO3_10A)
LVA22: U409.3 (IO3_3A)
LVA23: U409.16 (IO3_10B)
LVA24: U409.8 (IO3_4B)
LVA25: U409.12 (IO3_8B)
LVA26: U409.4 (IO3_3B)
LVA27: U409.11 (IO3_8A)
LVA28: U409.2 (IO3_2B)
LVA29: U409.7 (IO3_4A)
LVA30: U409.9 (IO3_5A)
LVA31: U409.10 (IO3_5B)
LVD24: U409.38 (IO2_57)
LVD25: U409.39 (IO2_61)
LVD26: U409.41 (IO2_63)
LVD27: U409.42 (IO2_64)
LVD28: U409.43 (IO2_71)
LVD29: U409.44 (IO2_72)
LVD30: U409.45 (IO2_73)
LVD31: U409.47 (IO2_79)
LVOVL: U409.83 (IO1_119)
LVTM0: U409.136 (IO0_214)
LVTM1: U409.137 (IO0_215)
LVTM2: U409.141 (IO0_219)
LVTT0: U409.138 (IO0_216)
LVTT1: U409.139 (IO0_217)
unnamed: C436.1, C437.1, R400.1, U409.126 (VCCPLL1)
unnamed: C436.2, C437.2, U409.127 (GNDPLL1)
unnamed: C438.1, C439.1, R401.2, U409.54 (VCCPLL0)
unnamed: C438.2, C439.2, U409.53 (GNDPLL0)
unnamed: J211.1, U409.125 (IO0_192)
unnamed: J212.2, U409.106 (IO1_166)
unnamed: J212.4, U409.107 (IO1_167)
unnamed: R217.2, U409.97 (IO1_147)
unnamed: R220.1, U409.122 (IO0_190)
unnamed: R270.1, U214.5 (2Y1), U214.16 (1Y1)
unnamed: R272.1, U409.124 (IO0_191)
unnamed: R273.1, U409.80 (IO1_116)
unnamed: R274.1, U409.81 (IO1_117)
unnamed: R275.1, U409.82 (IO1_118)
unnamed: R293.1, U409.73 (IO1_109)
PCS0: U409.75 (IO1_111)
PCS1: U409.76 (IO1_112)
PORTSIZE: U409.135 (IO0_213)
PPIO: U409.87 (IO1_136)
R_WB: U409.142 (IO0_220)
SCLKA: U214.8 (1A3), U214.11 (2A3)
SCS0: U409.78 (IO1_114)
SCS1: U409.79 (IO1_115)
SDIA: U214.6 (1A2), U214.13 (2A2)
SDOA: R270.2
SPIO: U409.88 (IO1_137)
ST0: U409.104 (IO1_164)
ST1: U409.105 (IO1_165)
TICK50: U409.64 (IO2_104_CBSEL1)
TICK60: U409.63 (IO2_103_CBSEL0)
TP0: J409_TP0.1, U409.113 (IO0_170)
TP1: J409_TP0.2, U409.114 (IO0_171)
U110_SCK: U214.9 (2Y3)
U110_SDI: U214.7 (2Y2)
U110_SDOA: U214.15 (2A1)
U110_SS: U214.3 (2Y0)
U409_CRESET: CN409.6, R402.2, U409.66 (CRESET_B)
U409_SCK: CN409.3, U214.12 (1Y3), U409.70 (IOB_107_SCK), U409F1.6 (SCK)
U409_SDI: CN409.2, U214.14 (1Y2), U409.67 (IOB_105_SDO), U409F1.5 (DI(IO0))
U409_SDOA: CN409.4, U214.4 (1A1), U409.68 (IOB_106_SDI), U409F1.2 (DO(IO1))
U409_SS: CN409.5, R403.2, U214.18 (1Y0), U409.71 (IOB_108_SS), U409F1.1 (~CS)
XCLK: U409.93 (IO1_140_GBIN3)
_AUTOVECTOR: U409.115 (IO0_172)
_BRIDGEEN: U409.55 (IO2_91)
_BUFEN: U409.121 (IO0_181)
_CIACS0: R273.2
_CIACS1: R274.2
_CONFIGEN: U409.56 (IO2_94)
_FEN: U409.95 (IO1_144)
_FRDEN: U409.96 (IO1_146)
_FRST: U409.61 (IO2_96)
_FWP: U409.99 (IO1_152)
_FWREN: U409.60 (IO2_95)
_IDEEN: U409.90 (IO1_138)
_LBCEN: U409.112 (IO0_169)
_LVTS: U409.134 (IO0_212)
_RAMSPACE: U409.48 (IO2_80)
_REGSPACE: U409.120 (IO0_179)
_RESETA: U409.62 (IO2_102)
_ROMEN: R272.2
_RTCEN: R275.2
_TACK: U409.119 (IO0_178)
_TBI: U409.118 (IO0_177)
_TCI: U409.117 (IO0_174)
_TEA: U409.116 (IO0_173)
_U110EN: R287.2, U214.19 (2OE)
_U409EN: R286.2, U214.1 (1OE)
_XCLKEN: U409.102 (IO1_161)

Notes on the sheet:
MASTER OF PUPPETS
MASTER CONTROL
U409 PROVIDES ADDRESS DECODES, CHIP SELECTS, AND REPLACEMENT GARY FUNCTIONS
