AmigaPCI/AmigaPCI-MainBoard/KiCAD/AmigaPCI Mainboard-KiCAD REV 70/chip_memory.kicad_sch

## KiCad design KiCAD/AmigaPCI Mainboard-KiCAD REV 70/chip_memory.kicad_sch (2026-06-26)

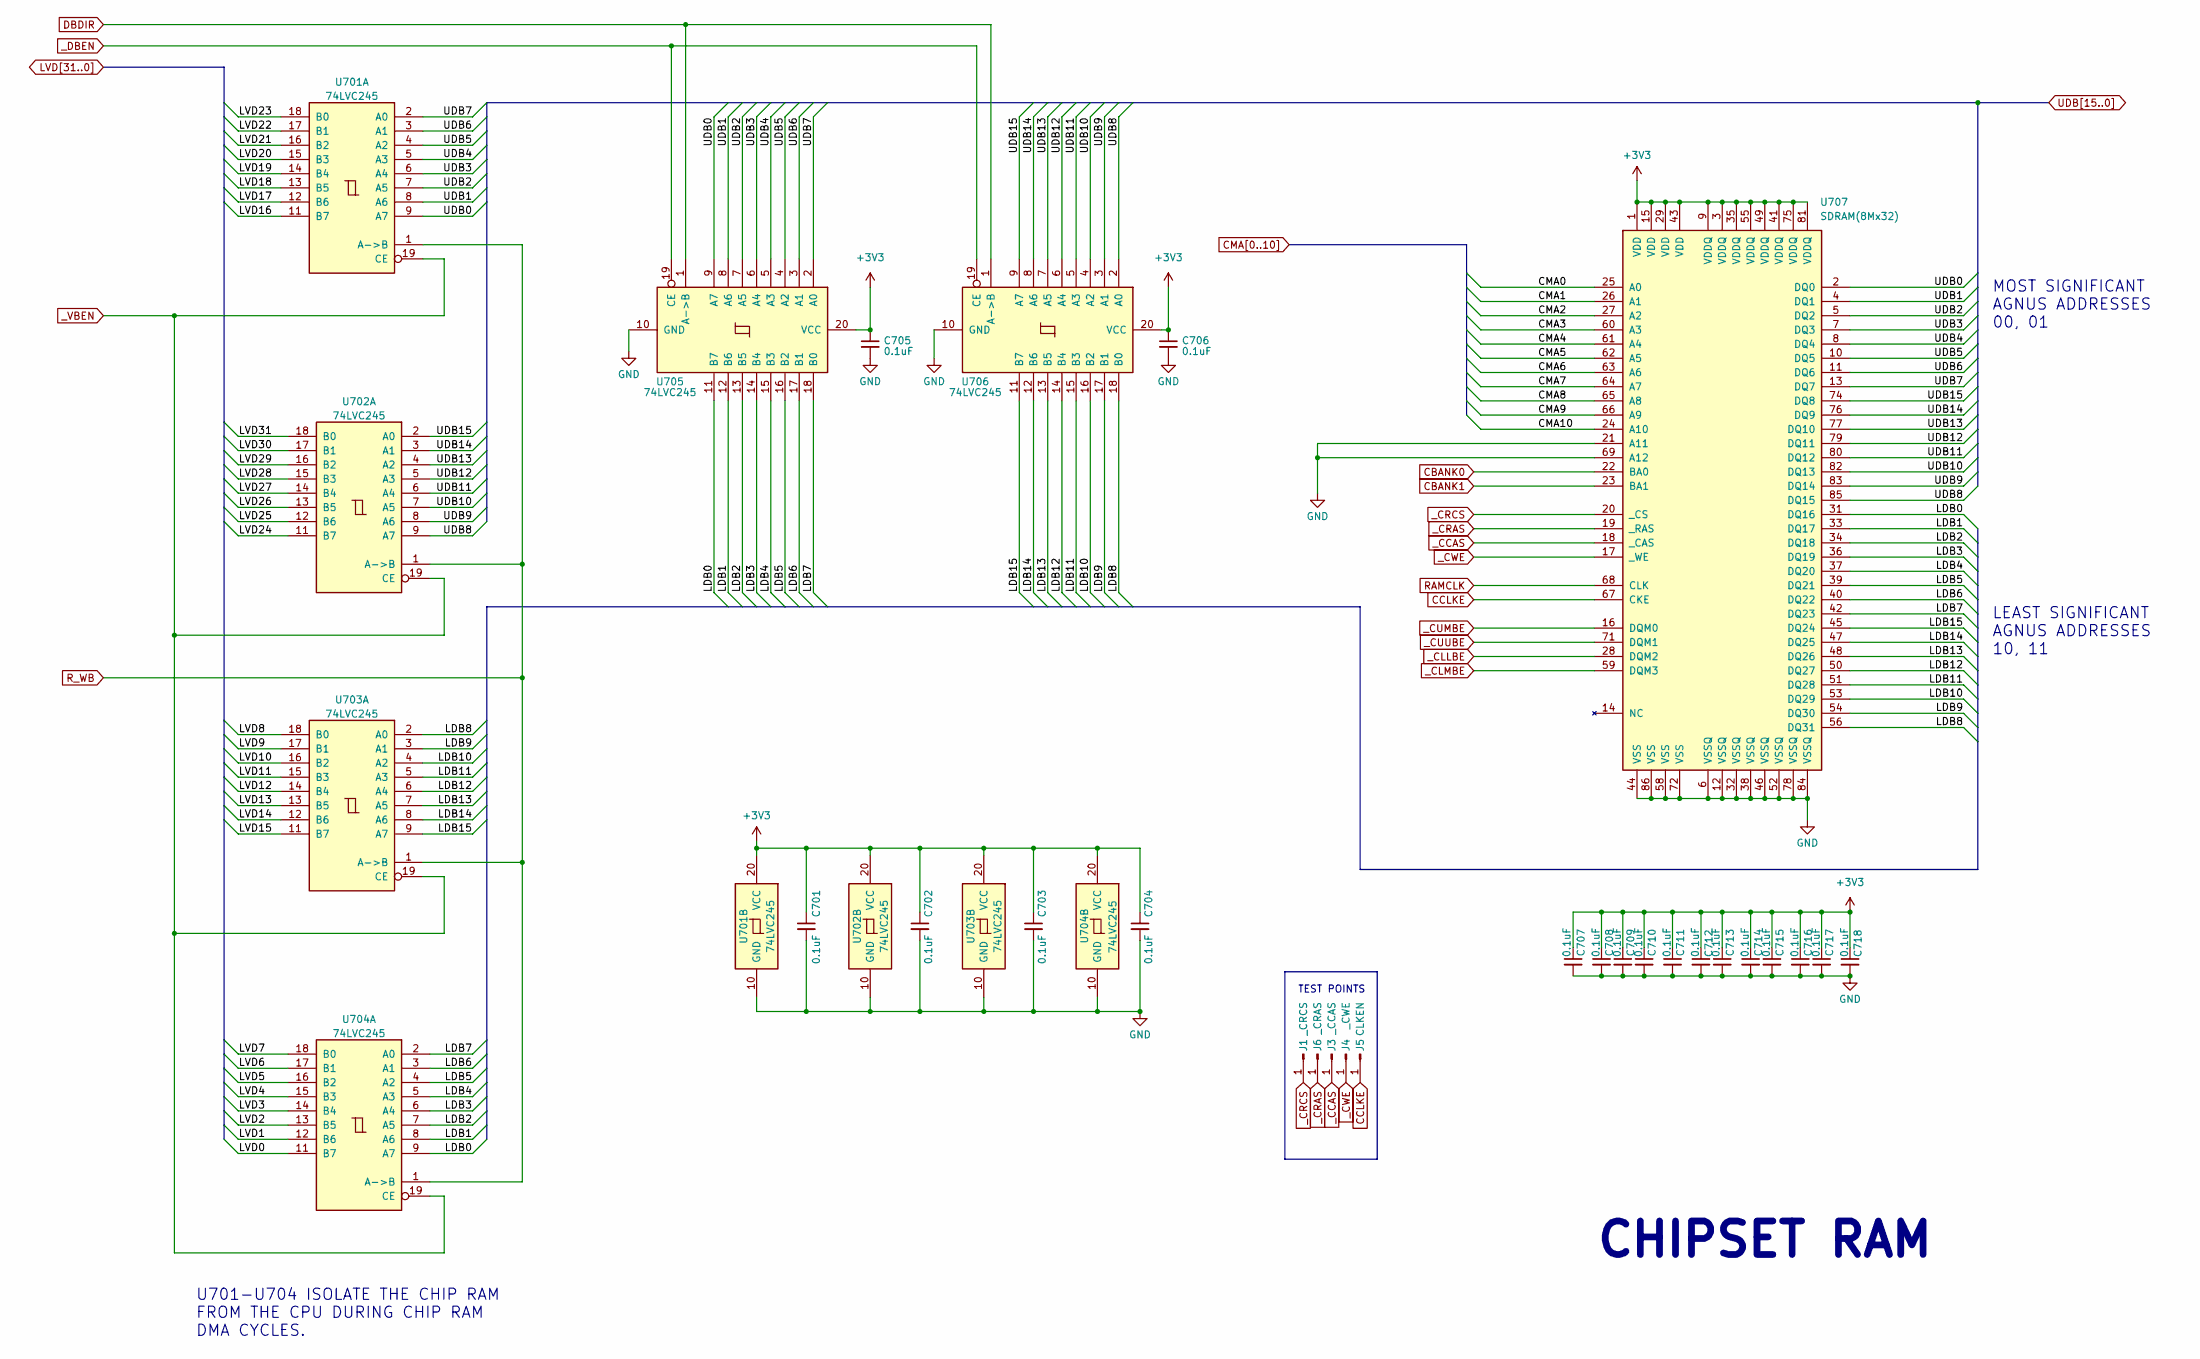
[picture p36: schematic chip_memory.kicad_sch]

Parts:
C701, C702, C703, C704, C705, C706, C707, C708, C709, C710, C711, C712, C713, C714, C715, C716, C717, C718: 0.1uF; C_0603_1608Metric; LCSC C14663
J1: _CRCS; TestPoint_Pad_D1.0mm
J3: _CCAS; TestPoint_Pad_D1.0mm
J4: _CWE; TestPoint_Pad_D1.0mm
J5: CLKEN; TestPoint_Pad_D1.0mm
J6: _CRAS; TestPoint_Pad_D1.0mm
U701, U702, U703, U704, U705, U706: 74LVC245; TSSOP-20_4.4x6.5mm_P0.65mm; LCSC C7848
U707: SDRAM(8Mx32); TSOP-II-86; LCSC C1351836

Connections:
+3V3: C701.1, C702.1, C703.1, C704.1, C705.1, C706.1, C707.1, C708.1, C709.1, C710.1, C711.1, C712.1, C713.1, C714.1, C715.1, C716.1, C717.1, C718.1, U701.20 (VCC), U702.20 (VCC), U703.20 (VCC), U704.20 (VCC), U705.20 (VCC), U706.20 (VCC), U707.1 (VDD), U707.3 (VDDQ), U707.9 (VDDQ), U707.15 (VDD), U707.29 (VDD), U707.35 (VDDQ), U707.41 (VDDQ), U707.43 (VDD), U707.49 (VDDQ), U707.55 (VDDQ), U707.75 (VDDQ), U707.81 (VDDQ)
CBANK0: U707.22 (BA0)
CBANK1: U707.23 (BA1)
CCLKE: J5.1, U707.67 (CKE)
CMA0: U707.25 (A0)
CMA1: U707.26 (A1)
CMA2: U707.27 (A2)
CMA3: U707.60 (A3)
CMA4: U707.61 (A4)
CMA5: U707.62 (A5)
CMA6: U707.63 (A6)
CMA7: U707.64 (A7)
CMA8: U707.65 (A8)
CMA9: U707.66 (A9)
CMA10: U707.24 (A10)
DBDIR: U705.1 (A->B), U706.1 (A->B)
GND: C701.2, C702.2, C703.2, C704.2, C705.2, C706.2, C707.2, C708.2, C709.2, C710.2, C711.2, C712.2, C713.2, C714.2, C715.2, C716.2, C717.2, C718.2, U701.10 (GND), U702.10 (GND), U703.10 (GND), U704.10 (GND), U705.10 (GND), U706.10 (GND), U707.6 (VSSQ), U707.12 (VSSQ), U707.21 (A11), U707.32 (VSSQ), U707.38 (VSSQ), U707.44 (VSS), U707.46 (VSSQ), U707.52 (VSSQ), U707.58 (VSS), U707.69 (A12), U707.72 (VSS), U707.78 (VSSQ), U707.84 (VSSQ), U707.86 (VSS)
LDB0: U704.9 (A7), U705.11 (B7), U707.31 (DQ16)
LDB1: U704.8 (A6), U705.12 (B6), U707.33 (DQ17)
LDB2: U704.7 (A5), U705.13 (B5), U707.34 (DQ18)
LDB3: U704.6 (A4), U705.14 (B4), U707.36 (DQ19)
LDB4: U704.5 (A3), U705.15 (B3), U707.37 (DQ20)
LDB5: U704.4 (A2), U705.16 (B2), U707.39 (DQ21)
LDB6: U704.3 (A1), U705.17 (B1), U707.40 (DQ22)
LDB7: U704.2 (A0), U705.18 (B0), U707.42 (DQ23)
LDB8: U703.2 (A0), U706.18 (B0), U707.56 (DQ31)
LDB9: U703.3 (A1), U706.17 (B1), U707.54 (DQ30)
LDB10: U703.4 (A2), U706.16 (B2), U707.53 (DQ29)
LDB11: U703.5 (A3), U706.15 (B3), U707.51 (DQ28)
LDB12: U703.6 (A4), U706.14 (B4), U707.50 (DQ27)
LDB13: U703.7 (A5), U706.13 (B5), U707.48 (DQ26)
LDB14: U703.8 (A6), U706.12 (B6), U707.47 (DQ25)
LDB15: U703.9 (A7), U706.11 (B7), U707.45 (DQ24)
LVD0: U704.11 (B7)
LVD1: U704.12 (B6)
LVD2: U704.13 (B5)
LVD3: U704.14 (B4)
LVD4: U704.15 (B3)
LVD5: U704.16 (B2)
LVD6: U704.17 (B1)
LVD7: U704.18 (B0)
LVD8: U703.18 (B0)
LVD9: U703.17 (B1)
LVD10: U703.16 (B2)
LVD11: U703.15 (B3)
LVD12: U703.14 (B4)
LVD13: U703.13 (B5)
LVD14: U703.12 (B6)
LVD15: U703.11 (B7)
LVD16: U701.11 (B7)
LVD17: U701.12 (B6)
LVD18: U701.13 (B5)
LVD19: U701.14 (B4)
LVD20: U701.15 (B3)
LVD21: U701.16 (B2)
LVD22: U701.17 (B1)
LVD23: U701.18 (B0)
LVD24: U702.11 (B7)
LVD25: U702.12 (B6)
LVD26: U702.13 (B5)
LVD27: U702.14 (B4)
LVD28: U702.15 (B3)
LVD29: U702.16 (B2)
LVD30: U702.17 (B1)
LVD31: U702.18 (B0)
unnamed: U707.14 (NC), U707.21 (A11), U707.30 (NC), U707.57 (NC), U707.69 (A12), U707.70 (NC), U707.73 (NC)
RAMCLK: U707.68 (CLK)
R_WB: U701.1 (A->B), U702.1 (A->B), U703.1 (A->B), U704.1 (A->B)
UDB0: U701.9 (A7), U705.9 (A7), U707.2 (DQ0)
UDB1: U701.8 (A6), U705.8 (A6), U707.4 (DQ1)
UDB2: U701.7 (A5), U705.7 (A5), U707.5 (DQ2)
UDB3: U701.6 (A4), U705.6 (A4), U707.7 (DQ3)
UDB4: U701.5 (A3), U705.5 (A3), U707.8 (DQ4)
UDB5: U701.4 (A2), U705.4 (A2), U707.10 (DQ5)
UDB6: U701.3 (A1), U705.3 (A1), U707.11 (DQ6)
UDB7: U701.2 (A0), U705.2 (A0), U707.13 (DQ7)
UDB8: U702.9 (A7), U706.2 (A0), U707.85 (DQ15)
UDB9: U702.8 (A6), U706.3 (A1), U707.83 (DQ14)
UDB10: U702.7 (A5), U706.4 (A2), U707.82 (DQ13)
UDB11: U702.6 (A4), U706.5 (A3), U707.80 (DQ12)
UDB12: U702.5 (A3), U706.6 (A4), U707.79 (DQ11)
UDB13: U702.4 (A2), U706.7 (A5), U707.77 (DQ10)
UDB14: U702.3 (A1), U706.8 (A6), U707.76 (DQ9)
UDB15: U702.2 (A0), U706.9 (A7), U707.74 (DQ8)
_CCAS: J3.1, U707.18 (_CAS)
_CLLBE: U707.28 (DQM2)
_CLMBE: U707.59 (DQM3)
_CRAS: J6.1, U707.19 (_RAS)
_CRCS: J1.1, U707.20 (_CS)
_CUMBE: U707.16 (DQM0)
_CUUBE: U707.71 (DQM1)
_CWE: J4.1, U707.17 (_WE)
_DBEN: U705.19 (CE), U706.19 (CE)
_VBEN: U701.19 (CE), U702.19 (CE), U703.19 (CE), U704.19 (CE)

Notes on the sheet:
TEST POINTS
LEAST SIGNIFICANT AGNUS ADDRESSES 10, 11
CHIPSET RAM
U701-U704 ISOLATE THE CHIP RAM FROM THE CPU DURING CHIP RAM DMA CYCLES.
MOST SIGNIFICANT AGNUS ADDRESSES 00, 01
