AmigaPCI/AmigaPCI-MainBoard/KiCAD/AmigaPCI Mainboard-KiCAD REV 70/clocks.kicad_sch

## KiCad design KiCAD/AmigaPCI Mainboard-KiCAD REV 70/clocks.kicad_sch (2026-06-26)

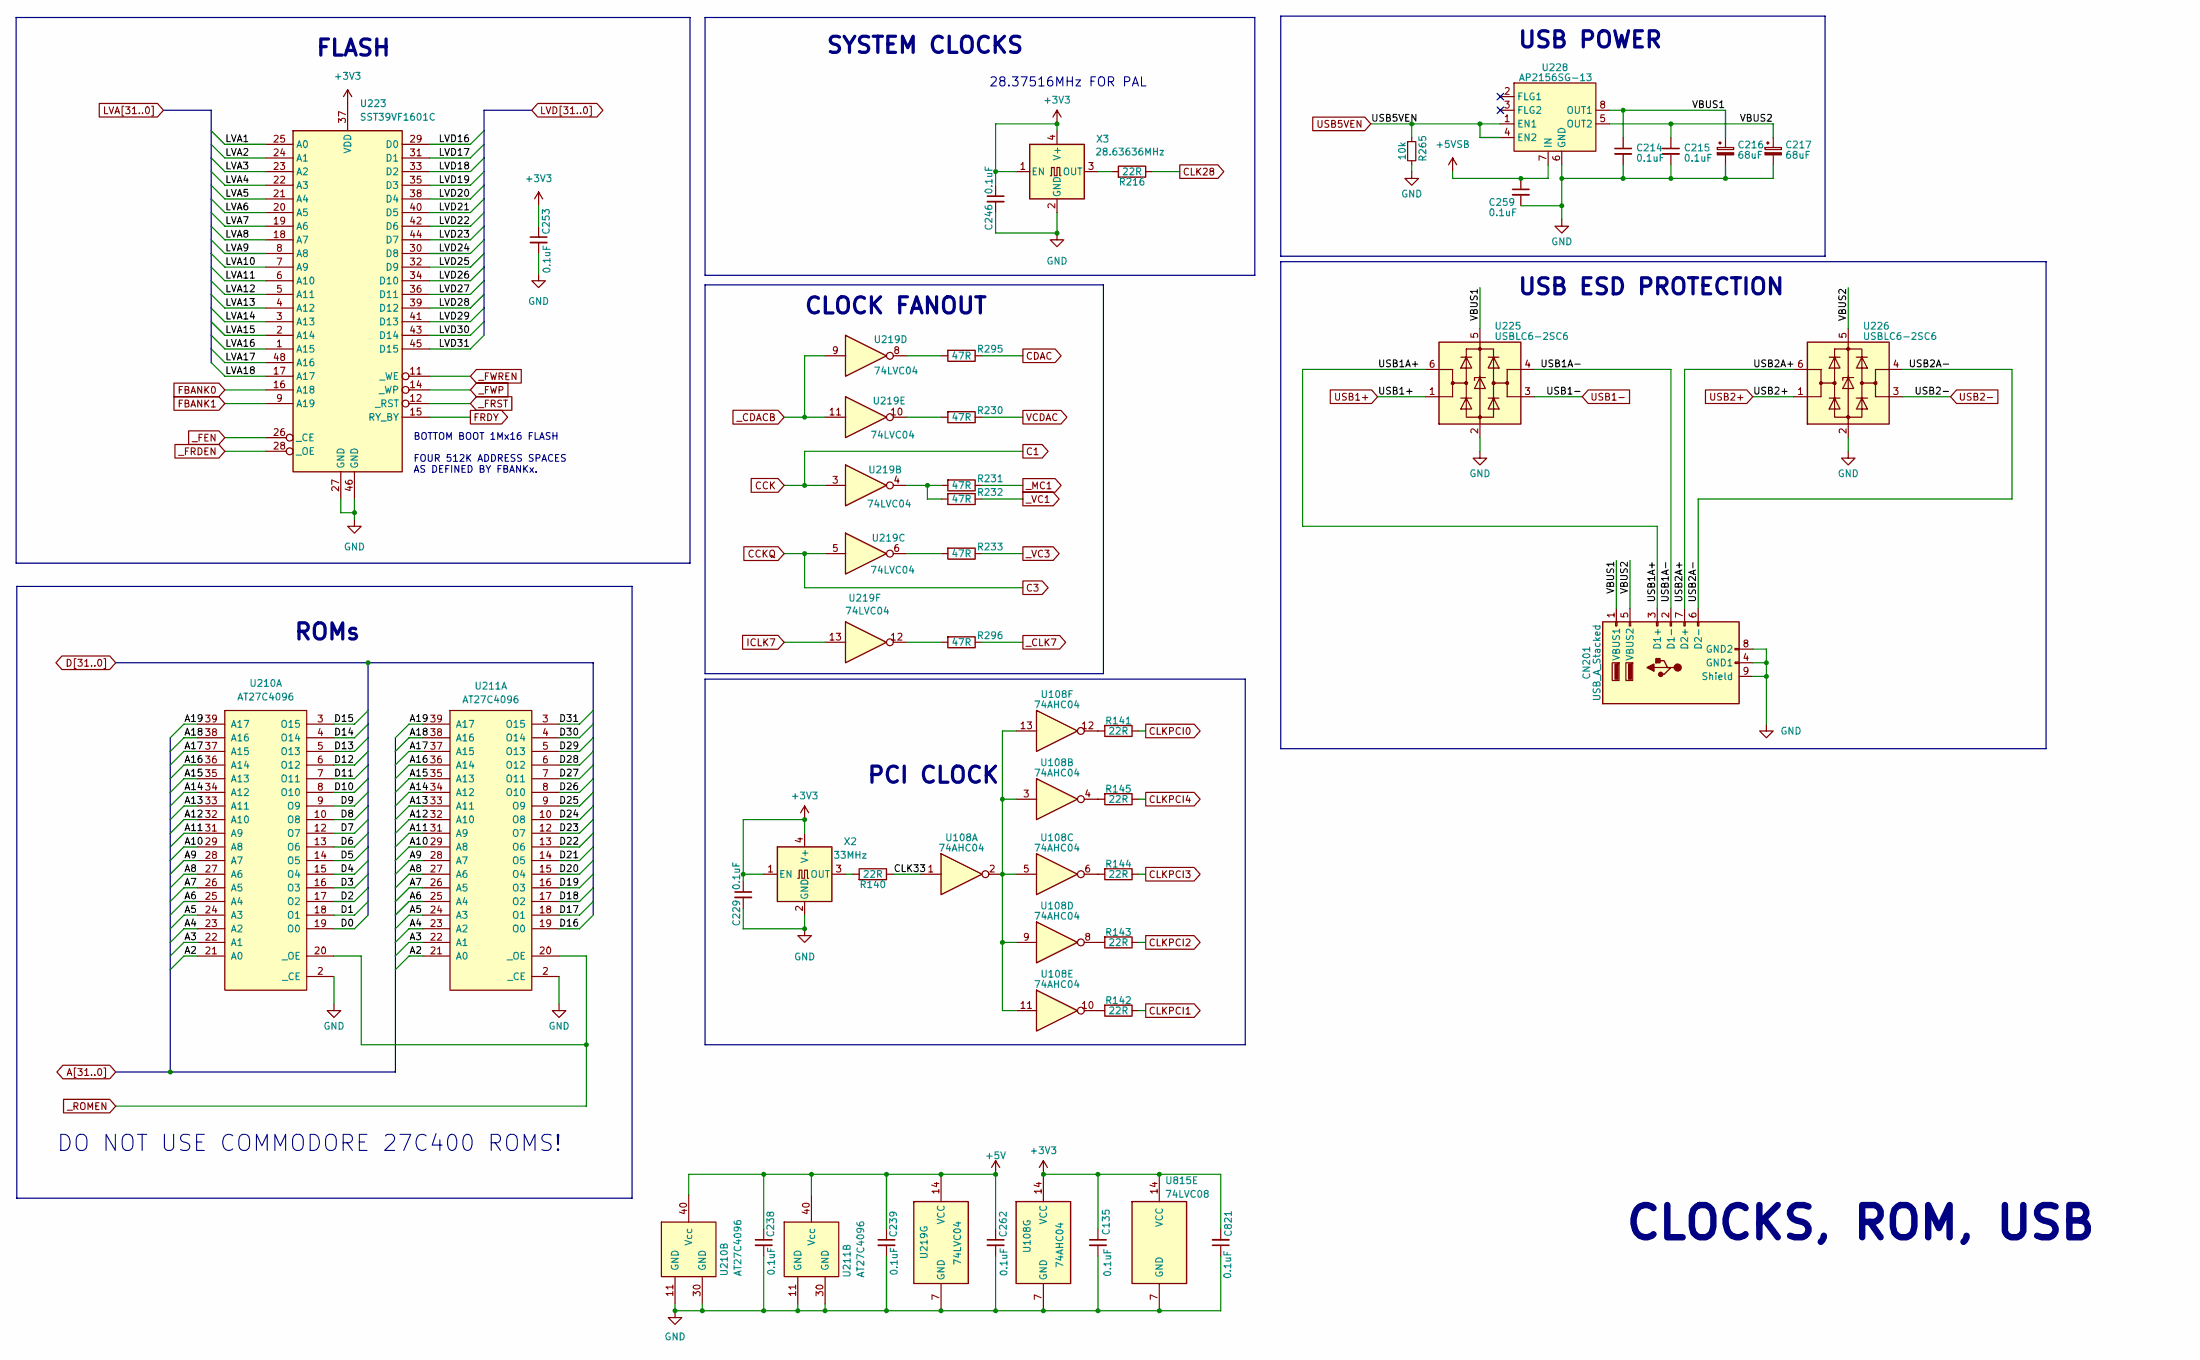
[picture p37: schematic clocks.kicad_sch]

Parts:
C135, C214, C215, C229, C238, C239, C246, C253, C259, C262, C821: 0.1uF; C_0603_1608Metric; LCSC C14663
C216, C217: 68uF; CP_Radial_D5.0mm_P2.00mm; LCSC C439891
CN201: USB_A_Stacked; USB_A_Wuerth_61400826021_Horizontal_Stacked; LCSC C5366339
R140, R141, R142, R143, R144, R145, R216: 22R; R_0603_1608Metric; LCSC C23345
R230, R231, R232, R233, R295, R296: 47R; R_0603_1608Metric; LCSC C23182
R265: 10k; R_0603_1608Metric; LCSC C25804
U108: 74AHC04; TSSOP-14_4.4x5mm_P0.65mm; LCSC C8190
U210, U211: AT27C4096; DIP-40_W15.24mm_Socket; LCSC C2332
U219: 74LVC04; TSSOP-14_4.4x5mm_P0.65mm; LCSC C352968
U223: SST39VF1601C; TSOP-I-48_18.4x12mm_P0.5mm; LCSC C184156
U225, U226: USBLC6-2SC6; SOT-23-6; LCSC C7519
U228: AP2156SG-13; SOIC-8_3.9x4.9mm_P1.27mm; Part Number AP2156SG-13; LCSC C88233
U815: 74LVC08; TSSOP-14_4.4x5mm_P0.65mm; LCSC C6053
X2: 33MHz; Oscillator_SMD_ECS_2520MV-xxx-xx-4Pin_2.5x2.0mm; LCSC C17506154
X3: 28.63636MHz; Oscillator_SMD_ECS_2520MV-xxx-xx-4Pin_2.5x2.0mm; LCSC C1670933

Connections:
+3V3: C135.1, C229.1, C246.1, C253.1, C821.2, U108.14 (VCC), U223.37 (VDD), U815.14 (VCC), X2.1 (EN), X2.4 (V+), X3.1 (EN), X3.4 (V+)
+5V: C238.1, C239.1, C262.1, U210.40 (Vcc), U211.40 (Vcc), U219.14 (VCC)
+5VSB: C259.1, U228.7 (IN)
A2: U210.21 (A0), U211.21 (A0)
A3: U210.22 (A1), U211.22 (A1)
A4: U210.23 (A2), U211.23 (A2)
A5: U210.24 (A3), U211.24 (A3)
A6: U210.25 (A4), U211.25 (A4)
A7: U210.26 (A5), U211.26 (A5)
A8: U210.27 (A6), U211.27 (A6)
A9: U210.28 (A7), U211.28 (A7)
A10: U210.29 (A8), U211.29 (A8)
A11: U210.31 (A9), U211.31 (A9)
A12: U210.32 (A10), U211.32 (A10)
A13: U210.33 (A11), U211.33 (A11)
A14: U210.34 (A12), U211.34 (A12)
A15: U210.35 (A13), U211.35 (A13)
A16: U210.36 (A14), U211.36 (A14)
A17: U210.37 (A15), U211.37 (A15)
A18: U210.38 (A16), U211.38 (A16)
A19: U210.39 (A17), U211.39 (A17)
C1: U219.3
C3: U219.5
CDAC: R295.1
CLK28: R216.1
CLK33: R140.1, U108.1
CLKPCI0: R141.1
CLKPCI1: R142.1
CLKPCI2: R143.1
CLKPCI3: R144.1
CLKPCI4: R145.1
D0: U210.19 (O0)
D1: U210.18 (O1)
D2: U210.17 (O2)
D3: U210.16 (O3)
D4: U210.15 (O4)
D5: U210.14 (O5)
D6: U210.13 (O6)
D7: U210.12 (O7)
D8: U210.10 (O8)
D9: U210.9 (O9)
D10: U210.8 (O10)
D11: U210.7 (O11)
D12: U210.6 (O12)
D13: U210.5 (O13)
D14: U210.4 (O14)
D15: U210.3 (O15)
D16: U211.19 (O0)
D17: U211.18 (O1)
D18: U211.17 (O2)
D19: U211.16 (O3)
D20: U211.15 (O4)
D21: U211.14 (O5)
D22: U211.13 (O6)
D23: U211.12 (O7)
D24: U211.10 (O8)
D25: U211.9 (O9)
D26: U211.8 (O10)
D27: U211.7 (O11)
D28: U211.6 (O12)
D29: U211.5 (O13)
D30: U211.4 (O14)
D31: U211.3 (O15)
FBANK0: U223.16 (A18)
FBANK1: U223.9 (A19)
FRDY: U223.15 (RY_BY)
GND: C135.2, C214.2, C215.2, C216.2, C217.2, C229.2, C238.2, C239.2, C246.2, C253.2, C259.2, C262.2, C821.1, CN201.4 (GND1), CN201.8 (GND2), CN201.9 (Shield), R265.2, U108.7 (GND), U210.2 (_CE), U210.11 (GND), U210.30 (GND), U211.2 (_CE), U211.11 (GND), U211.30 (GND), U219.7 (GND), U223.27 (GND), U223.46 (GND), U225.2 (GND), U226.2 (GND), U228.6 (GND), U815.7 (GND), X2.2 (GND), X3.2 (GND)
ICLK7: U219.13
LVA1: U223.25 (A0)
LVA2: U223.24 (A1)
LVA3: U223.23 (A2)
LVA4: U223.22 (A3)
LVA5: U223.21 (A4)
LVA6: U223.20 (A5)
LVA7: U223.19 (A6)
LVA8: U223.18 (A7)
LVA9: U223.8 (A8)
LVA10: U223.7 (A9)
LVA11: U223.6 (A10)
LVA12: U223.5 (A11)
LVA13: U223.4 (A12)
LVA14: U223.3 (A13)
LVA15: U223.2 (A14)
LVA16: U223.1 (A15)
LVA17: U223.48 (A16)
LVA18: U223.17 (A17)
LVD16: U223.29 (D0)
LVD17: U223.31 (D1)
LVD18: U223.33 (D2)
LVD19: U223.35 (D3)
LVD20: U223.38 (D4)
LVD21: U223.40 (D5)
LVD22: U223.42 (D6)
LVD23: U223.44 (D7)
LVD24: U223.30 (D8)
LVD25: U223.32 (D9)
LVD26: U223.34 (D10)
LVD27: U223.36 (D11)
LVD28: U223.39 (D12)
LVD29: U223.41 (D13)
LVD30: U223.43 (D14)
LVD31: U223.45 (D15)
unnamed: R140.2, X2.3 (OUT)
unnamed: R141.2, U108.12
unnamed: R142.2, U108.10
unnamed: R143.2, U108.8
unnamed: R144.2, U108.6
unnamed: R145.2, U108.4
unnamed: R216.2, X3.3 (OUT)
unnamed: R230.2, U219.10
unnamed: R231.2, R232.2, U219.4
unnamed: R233.2, U219.6
unnamed: R295.2, U219.8
unnamed: R296.2, U219.12
unnamed: U108.2, U108.3, U108.5, U108.9, U108.11, U108.13
unnamed: U223.10 (NC), U223.13 (NC), U223.47 (NC)
USB1+: U225.1 (I/O1)
USB1-: U225.3 (I/O2)
USB1A+: CN201.3 (D1+), U225.6 (I/O1)
USB1A-: CN201.2 (D1-), U225.4 (I/O2)
USB2+: U226.1 (I/O1)
USB2-: U226.3 (I/O2)
USB2A+: CN201.7 (D2+), U226.6 (I/O1)
USB2A-: CN201.6 (D2-), U226.4 (I/O2)
USB5VEN: R265.1, U228.1 (EN1), U228.4 (EN2)
VBUS1: C214.1, C216.1, CN201.1 (VBUS1), U225.5 (VBUS), U228.8 (OUT1)
VBUS2: C215.1, C217.1, CN201.5 (VBUS2), U226.5 (VBUS), U228.5 (OUT2)
VCDAC: R230.1
_CDACB: U219.9, U219.11
_CLK7: R296.1
_FEN: U223.26 (_CE)
_FRDEN: U223.28 (_OE)
_FRST: U223.12 (_RST)
_FWP: U223.14 (_WP)
_FWREN: U223.11 (_WE)
_MC1: R231.1
_ROMEN: U210.20 (_OE), U211.20 (_OE)
_VC1: R232.1
_VC3: R233.1

Notes on the sheet:
BOTTOM BOOT 1Mx16 FLASH FOUR 512K ADDRESS SPACES AS DEFINED BY FBANKx.
USB POWER
PCI CLOCK
FLASH
USB ESD PROTECTION
28.37516MHz FOR PAL
SYSTEM CLOCKS
DO NOT USE COMMODORE 27C400 ROMS!
CLOCKS, ROM, USB
CLOCK FANOUT
ROMs
