AmigaPCI/AmigaPCI-MainBoard/KiCAD/AmigaPCI Mainboard-KiCAD REV 70/cpu.kicad_sch

## KiCad design KiCAD/AmigaPCI Mainboard-KiCAD REV 70/cpu.kicad_sch (2026-06-26)

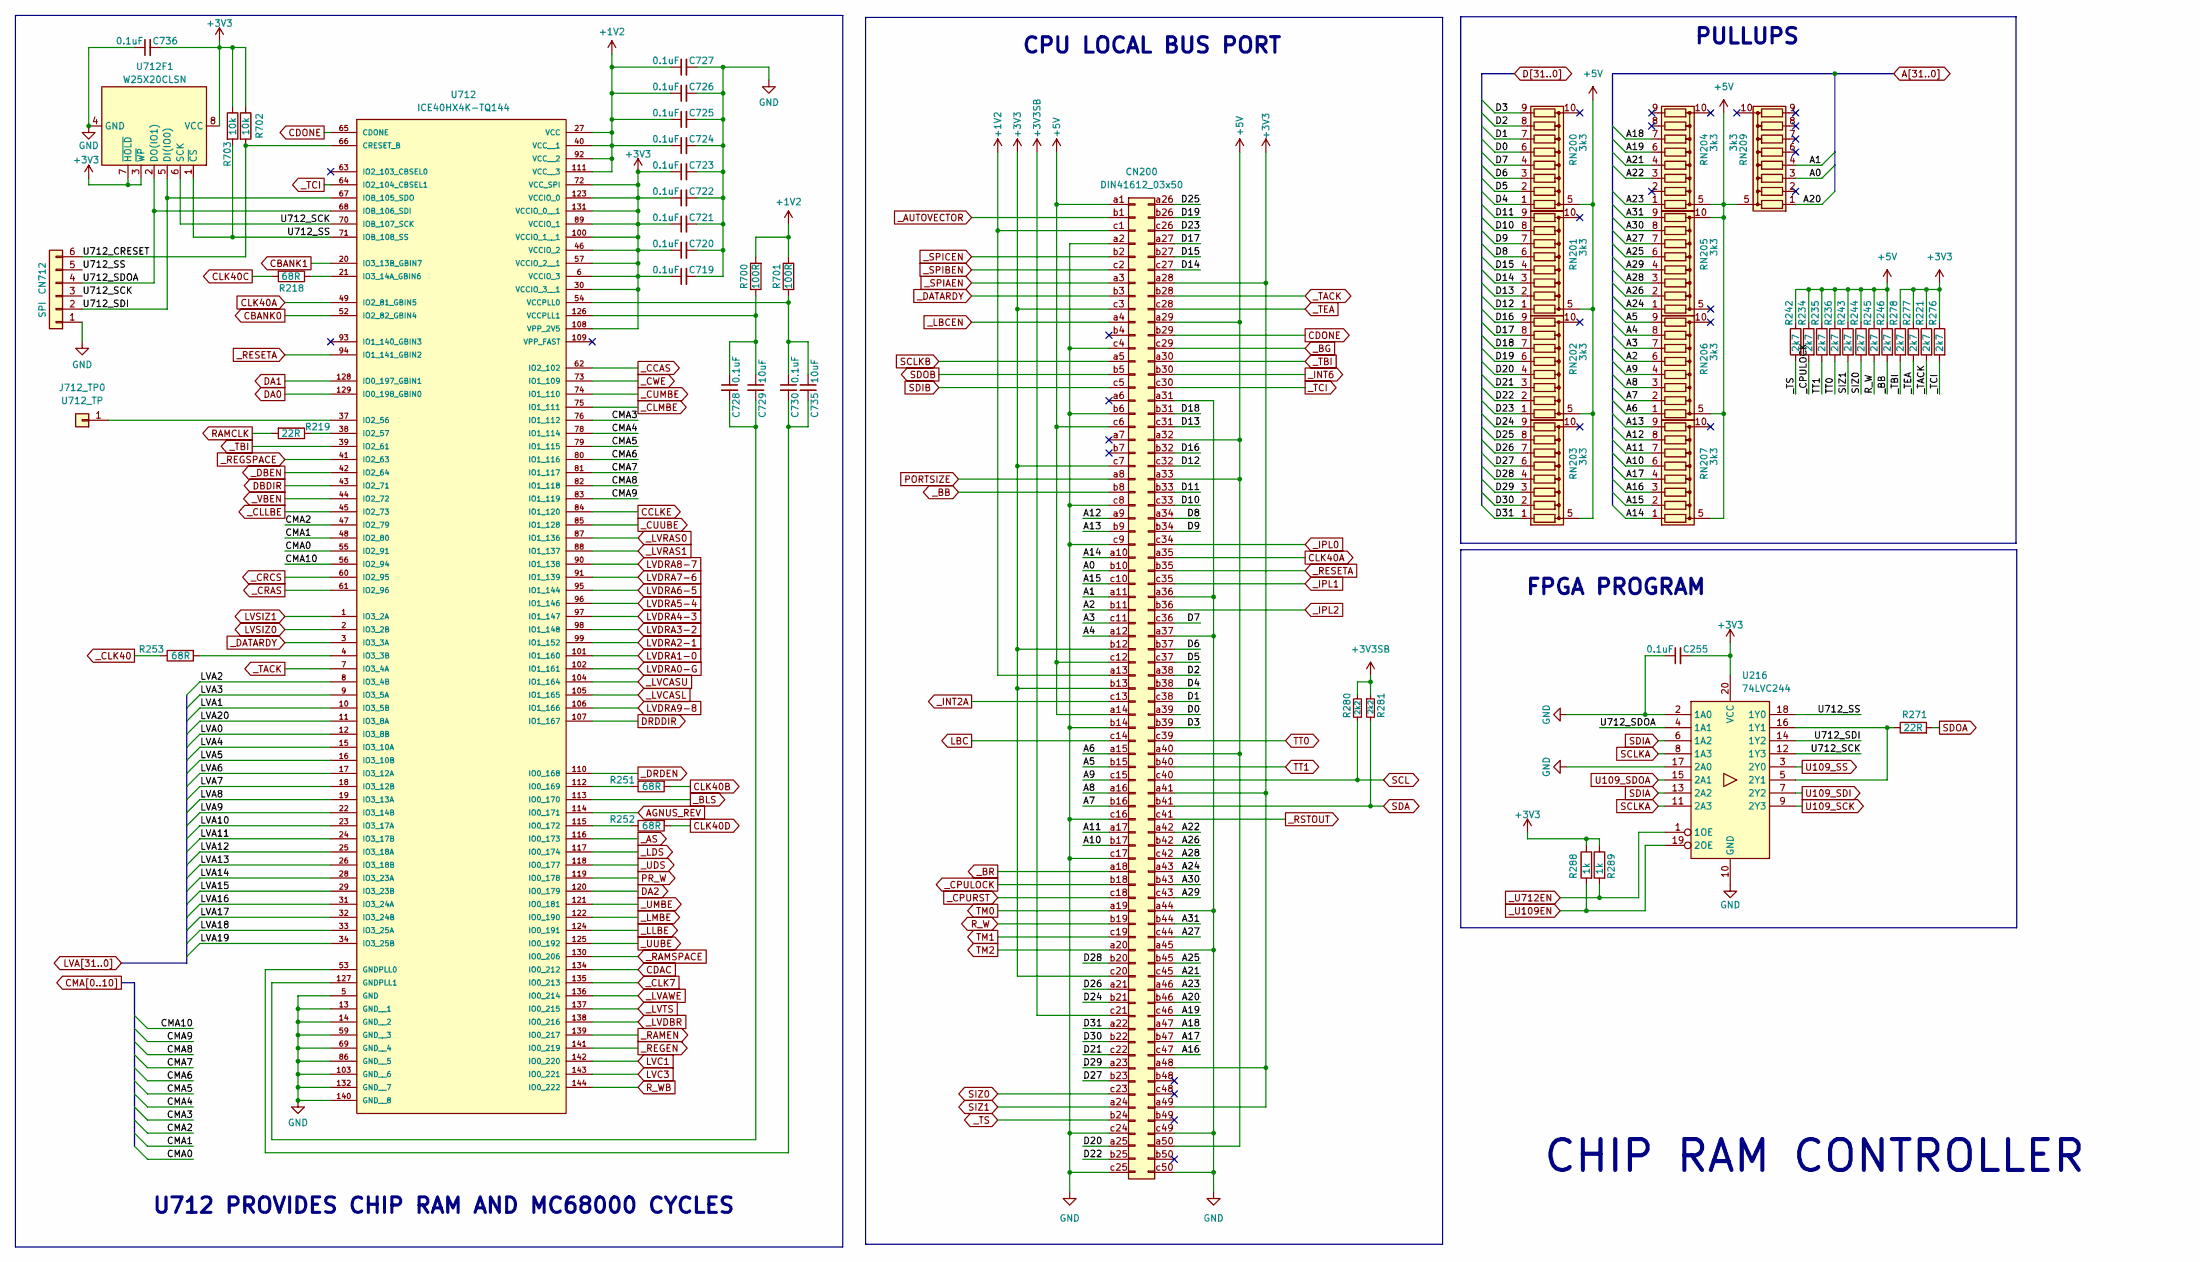
[picture p38: schematic cpu.kicad_sch]

Parts:
C255, C719, C720, C721, C722, C723, C724, C725, C726, C727, C728, C730, C736: 0.1uF; C_0603_1608Metric; LCSC C14663
C729, C735: 10uF; C_0603_1608Metric; LCSC C96446
CN200: DIN41612_03x50; DIN41612_C_3x50_Female_Vertical_THT; LCSC C3646680
CN712: SPI; PinHeader_1x06_P2.54mm_Vertical; LCSC C37208
J712_TP0: U712_TP; PinHeader_1x01_P2.54mm_Vertical; LCSC C81276
R218, R251, R252, R253: 68R; R_0603_1608Metric; LCSC C25254
R219, R271: 22R; R_0603_1608Metric; LCSC C23345
R221, R234, R235, R236, R242, R243, R244, R245, R246, R276, R277, R278: 2k7; R_0603_1608Metric; LCSC C13167
R280, R281: 2k2; R_0603_1608Metric; LCSC C4190
R288, R289: 1k; R_0603_1608Metric; LCSC C21190
R700, R701: 100R; R_0603_1608Metric; LCSC C22775
R702, R703: 10k; R_0603_1608Metric; LCSC C25804
RN200, RN201, RN202, RN203, RN204, RN205, RN206, RN207, RN209: 3k3; R_Array_Convex_5x0603; Part Number 746X101332JP; LCSC C1731077
U216: 74LVC244; TSSOP-20_4.4x6.5mm_P0.65mm; LCSC C7668
U712: ICE40HX4K-TQ144; LQFP-144_20x20mm_P0.5mm; LCSC C1521989
U712F1: W25X20CLSN; SOIC-8_3.9x4.9mm_P1.27mm; LCSC C34591

Connections:
+1V2: C724.1, C725.1, C726.1, C727.1, CN200.a13, CN200.c1, R700.2, R701.1, U712.27 (VCC), U712.40 (VCC__1), U712.92 (VCC__2), U712.111 (VCC__3)
+3V3: C255.2, C719.1, C720.1, C721.1, C722.1, C723.1, C736.2, CN200.a28, CN200.a41, CN200.a48, CN200.a49, CN200.b12, CN200.b13, CN200.c3, CN200.c7, CN200.c20, R221.1, R276.1, R277.1, R278.1, R288.1, R289.1, R702.1, R703.1, U216.20 (VCC), U712.6 (VCCIO_3), U712.30 (VCCIO_3__1), U712.46 (VCCIO_2), U712.57 (VCCIO_2__1), U712.72 (VCC_SPI), U712.89 (VCCIO_1), U712.100 (VCCIO_1__1), U712.108 (VPP_2V5), U712.123 (VCCIO_0), U712.131 (VCCIO_0__1), U712F1.3 (~WP), U712F1.7 (~HOLD), U712F1.8 (VCC)
+3V3SB: CN200.c21, R280.2, R281.1
+5V: CN200.a1, CN200.a14, CN200.a29, CN200.a32, CN200.a33, CN200.a40, CN200.a50, CN200.c6, CN200.c12, R234.1, R235.1, R236.1, R242.1, R243.1, R244.1, R245.1, R246.1, RN200.5 (common), RN201.5 (common), RN202.5 (common), RN203.5 (common), RN204.5 (common), RN205.10 (common), RN206.5 (common), RN207.5 (common), RN209.5 (common)
A0: CN200.b10, RN209.3 (R3)
A1: CN200.a11, RN209.4 (R4)
A2: CN200.b11, RN206.6 (R5)
A3: CN200.c11, RN206.7 (R6)
A4: CN200.a12, RN206.8 (R7)
A5: CN200.b15, RN206.9 (R8)
A6: CN200.a15, RN206.1 (R1)
A7: CN200.b16, RN206.2 (R2)
A8: CN200.a16, RN206.3 (R3)
A9: CN200.c15, RN206.4 (R4)
A10: CN200.b17, RN207.6 (R5)
A11: CN200.a17, RN207.7 (R6)
A12: CN200.a9, RN207.8 (R7)
A13: CN200.b9, RN207.9 (R8)
A14: CN200.a10, RN207.1 (R1)
A15: CN200.c10, RN207.2 (R2)
A16: CN200.c47, RN207.3 (R3)
A17: CN200.b47, RN207.4 (R4)
A18: CN200.a47, RN204.7 (R6)
A19: CN200.c46, RN204.6 (R5)
A20: CN200.b46, RN209.1 (R1)
A21: CN200.c45, RN204.4 (R4)
A22: CN200.a42, RN204.3 (R3)
A23: CN200.a46, RN204.1 (R1)
A24: CN200.a43, RN205.1 (R1)
A25: CN200.b45, RN205.6 (R5)
A26: CN200.b42, RN205.2 (R2)
A27: CN200.c44, RN205.7 (R6)
A28: CN200.c42, RN205.3 (R3)
A29: CN200.c43, RN205.4 (R4)
A30: CN200.b43, RN205.8 (R7)
A31: CN200.b44, RN205.9 (R8)
AGNUS_REV: U712.114 (IO0_171)
CBANK0: U712.52 (IO2_82_GBIN4)
CBANK1: U712.20 (IO3_13B_GBIN7)
CCLKE: U712.84 (IO1_120)
CDAC: U712.134 (IO0_212)
CDONE: CN200.b29, U712.65 (CDONE)
CLK40A: CN200.a35, U712.49 (IO2_81_GBIN5)
CLK40B: R251.2
CLK40C: R218.2
CLK40D: R252.2
CMA0: U712.55 (IO2_91)
CMA1: U712.48 (IO2_80)
CMA2: U712.47 (IO2_79)
CMA3: U712.76 (IO1_112)
CMA4: U712.78 (IO1_114)
CMA5: U712.79 (IO1_115)
CMA6: U712.80 (IO1_116)
CMA7: U712.81 (IO1_117)
CMA8: U712.82 (IO1_118)
CMA9: U712.83 (IO1_119)
CMA10: U712.56 (IO2_94)
D0: CN200.a39, RN200.6 (R5)
D1: CN200.c38, RN200.7 (R6)
D2: CN200.a38, RN200.8 (R7)
D3: CN200.b39, RN200.9 (R8)
D4: CN200.b38, RN200.1 (R1)
D5: CN200.c37, RN200.2 (R2)
D6: CN200.b37, RN200.3 (R3)
D7: CN200.c36, RN200.4 (R4)
D8: CN200.a34, RN201.6 (R5)
D9: CN200.b34, RN201.7 (R6)
D10: CN200.c33, RN201.8 (R7)
D11: CN200.b33, RN201.9 (R8)
D12: CN200.c32, RN201.1 (R1)
D13: CN200.c31, RN201.2 (R2)
D14: CN200.c27, RN201.3 (R3)
D15: CN200.b27, RN201.4 (R4)
D16: CN200.b32, RN202.9 (R8)
D17: CN200.a27, RN202.8 (R7)
D18: CN200.b31, RN202.7 (R6)
D19: CN200.b26, RN202.6 (R5)
D20: CN200.a25, RN202.4 (R4)
D21: CN200.c22, RN202.3 (R3)
D22: CN200.b25, RN202.2 (R2)
D23: CN200.c26, RN202.1 (R1)
D24: CN200.b21, RN203.9 (R8)
D25: CN200.a26, RN203.8 (R7)
D26: CN200.a21, RN203.7 (R6)
D27: CN200.b23, RN203.6 (R5)
D28: CN200.b20, RN203.4 (R4)
D29: CN200.a23, RN203.3 (R3)
D30: CN200.b22, RN203.2 (R2)
D31: CN200.a22, RN203.1 (R1)
DA0: U712.129 (IO0_198_GBIN0)
DA1: U712.128 (IO0_197_GBIN1)
DA2: U712.120 (IO0_179)
DBDIR: U712.43 (IO2_71)
DRDDIR: U712.107 (IO1_167)
GND: C255.1, C719.2, C720.2, C721.2, C722.2, C723.2, C724.2, C725.2, C726.2, C727.2, C736.1, CN200.a2, CN200.a31, CN200.a36, CN200.a37, CN200.a44, CN200.a45, CN200.b6, CN200.b14, CN200.c4, CN200.c8, CN200.c9, CN200.c16, CN200.c17, CN200.c24, CN200.c25, CN200.c49, CN200.c50, CN712.1, U216.2 (1A0), U216.10 (GND), U216.17 (2A0), U712.5 (GND), U712.13 (GND__1), U712.14 (GND__2), U712.59 (GND__3), U712.69 (GND__4), U712.86 (GND__5), U712.103 (GND__6), U712.132 (GND__7), U712.140 (GND__8), U712F1.4 (GND)
LBC: CN200.c14
LVA0: U712.12 (IO3_8B)
LVA1: U712.10 (IO3_5B)
LVA2: U712.8 (IO3_4B)
LVA3: U712.9 (IO3_5A)
LVA4: U712.15 (IO3_10A)
LVA5: U712.16 (IO3_10B)
LVA6: U712.17 (IO3_12A)
LVA7: U712.18 (IO3_12B)
LVA8: U712.19 (IO3_13A)
LVA9: U712.22 (IO3_14B)
LVA10: U712.23 (IO3_17A)
LVA11: U712.24 (IO3_17B)
LVA12: U712.25 (IO3_18A)
LVA13: U712.26 (IO3_18B)
LVA14: U712.28 (IO3_23A)
LVA15: U712.29 (IO3_23B)
LVA16: U712.31 (IO3_24A)
LVA17: U712.32 (IO3_24B)
LVA18: U712.33 (IO3_25A)
LVA19: U712.34 (IO3_25B)
LVA20: U712.11 (IO3_8A)
LVC1: U712.142 (IO0_220)
LVC3: U712.143 (IO0_221)
LVDRA0-G: U712.102 (IO1_161)
LVDRA1-0: U712.101 (IO1_160)
LVDRA2-1: U712.99 (IO1_152)
LVDRA3-2: U712.98 (IO1_148)
LVDRA4-3: U712.97 (IO1_147)
LVDRA5-4: U712.96 (IO1_146)
LVDRA6-5: U712.95 (IO1_144)
LVDRA7-6: U712.91 (IO1_139)
LVDRA8-7: U712.90 (IO1_138)
LVDRA9-8: U712.106 (IO1_166)
LVSIZ0: U712.2 (IO3_2B)
LVSIZ1: U712.1 (IO3_2A)
unnamed: C728.1, C729.1, R700.1, U712.126 (VCCPLL1)
unnamed: C728.2, C729.2, U712.127 (GNDPLL1)
unnamed: C730.1, C735.1, R701.2, U712.54 (VCCPLL0)
unnamed: C730.2, C735.2, U712.53 (GNDPLL0)
unnamed: J712_TP0.1, U712.37 (IO2_56)
unnamed: R218.1, U712.21 (IO3_14A_GBIN6)
unnamed: R219.1, U712.38 (IO2_57)
unnamed: R251.1, U712.112 (IO0_169)
unnamed: R252.1, U712.115 (IO0_172)
unnamed: R253.2, U712.4 (IO3_3B)
unnamed: R271.1, U216.5 (2Y1), U216.16 (1Y1)
PORTSIZE: CN200.a8
PR_W: U712.119 (IO0_178)
RAMCLK: R219.2
R_W: CN200.b19, R245.2
R_WB: U712.144 (IO0_222)
SCL: CN200.c40, R280.1
SCLKA: U216.8 (1A3), U216.11 (2A3)
SCLKB: CN200.a5
SDA: CN200.b41, R281.2
SDIA: U216.6 (1A2), U216.13 (2A2)
SDIB: CN200.c5
SDOA: R271.2
SDOB: CN200.b5
SIZ0: CN200.c23, R244.2
SIZ1: CN200.a24, R243.2
TM0: CN200.a19
TM1: CN200.c19
TM2: CN200.a20
TT0: CN200.c39, R236.2
TT1: CN200.b40, R235.2
U109_SCK: U216.9 (2Y3)
U109_SDI: U216.7 (2Y2)
U109_SDOA: U216.15 (2A1)
U109_SS: U216.3 (2Y0)
U712_CRESET: CN712.6, R702.2, U712.66 (CRESET_B)
U712_SCK: CN712.3, U216.12 (1Y3), U712.70 (IOB_107_SCK), U712F1.6 (SCK)
U712_SDI: CN712.2, U216.14 (1Y2), U712.67 (IOB_105_SDO), U712F1.5 (DI(IO0))
U712_SDOA: CN712.4, U216.4 (1A1), U712.68 (IOB_106_SDI), U712F1.2 (DO(IO1))
U712_SS: CN712.5, R703.2, U216.18 (1Y0), U712.71 (IOB_108_SS), U712F1.1 (~CS)
_AS: U712.116 (IO0_173)
_AUTOVECTOR: CN200.b1
_BB: CN200.b8, R246.2
_BG: CN200.c29
_BLS: U712.113 (IO0_170)
_BR: CN200.a18
_CCAS: U712.62 (IO2_102)
_CLK7: U712.135 (IO0_213)
_CLK40: R253.1
_CLLBE: U712.45 (IO2_73)
_CLMBE: U712.75 (IO1_111)
_CPULOCK: CN200.b18, R234.2
_CPURST: CN200.c18
_CRAS: U712.61 (IO2_96)
_CRCS: U712.60 (IO2_95)
_CUMBE: U712.74 (IO1_110)
_CUUBE: U712.85 (IO1_128)
_CWE: U712.73 (IO1_109)
_DATARDY: CN200.b3, U712.3 (IO3_3A)
_DBEN: U712.42 (IO2_64)
_DRDEN: U712.110 (IO0_168)
_INT2A: CN200.c13
_INT6: CN200.b30
_IPL0: CN200.c34
_IPL1: CN200.c35
_IPL2: CN200.b36
_LBCEN: CN200.a4
_LDS: U712.117 (IO0_174)
_LLBE: U712.124 (IO0_191)
_LMBE: U712.122 (IO0_190)
_LVAWE: U712.136 (IO0_214)
_LVCASL: U712.105 (IO1_165)
_LVCASU: U712.104 (IO1_164)
_LVDBR: U712.138 (IO0_216)
_LVRAS0: U712.87 (IO1_136)
_LVRAS1: U712.88 (IO1_137)
_LVTS: U712.137 (IO0_215)
_RAMEN: U712.139 (IO0_217)
_RAMSPACE: U712.130 (IO0_206)
_REGEN: U712.141 (IO0_219)
_REGSPACE: U712.41 (IO2_63)
_RESETA: CN200.b35, U712.94 (IO1_141_GBIN2)
_RSTOUT: CN200.c41
_SPIAEN: CN200.a3
_SPIBEN: CN200.c2
_SPICEN: CN200.b2
_TACK: CN200.b28, R221.2, U712.7 (IO3_4A)
_TBI: CN200.a30, R278.2, U712.39 (IO2_61)
_TCI: CN200.c30, R276.2, U712.64 (IO2_104_CBSEL1)
_TEA: CN200.c28, R277.2
_TS: CN200.b24, R242.2
_U109EN: R288.2, U216.19 (2OE)
_U712EN: R289.2, U216.1 (1OE)
_UDS: U712.118 (IO0_177)
_UMBE: U712.121 (IO0_181)
_UUBE: U712.125 (IO0_192)
_VBEN: U712.44 (IO2_72)

Notes on the sheet:
CPU LOCAL BUS PORT
U712 PROVIDES CHIP RAM AND MC68000 CYCLES
FPGA PROGRAM
CHIP RAM CONTROLLER
PULLUPS
