AmigaPCI/AmigaPCI-MainBoard/KiCAD/AmigaPCI Mainboard-KiCAD REV 70/floppy.kicad_sch

## KiCad design KiCAD/AmigaPCI Mainboard-KiCAD REV 70/floppy.kicad_sch (2026-06-26)

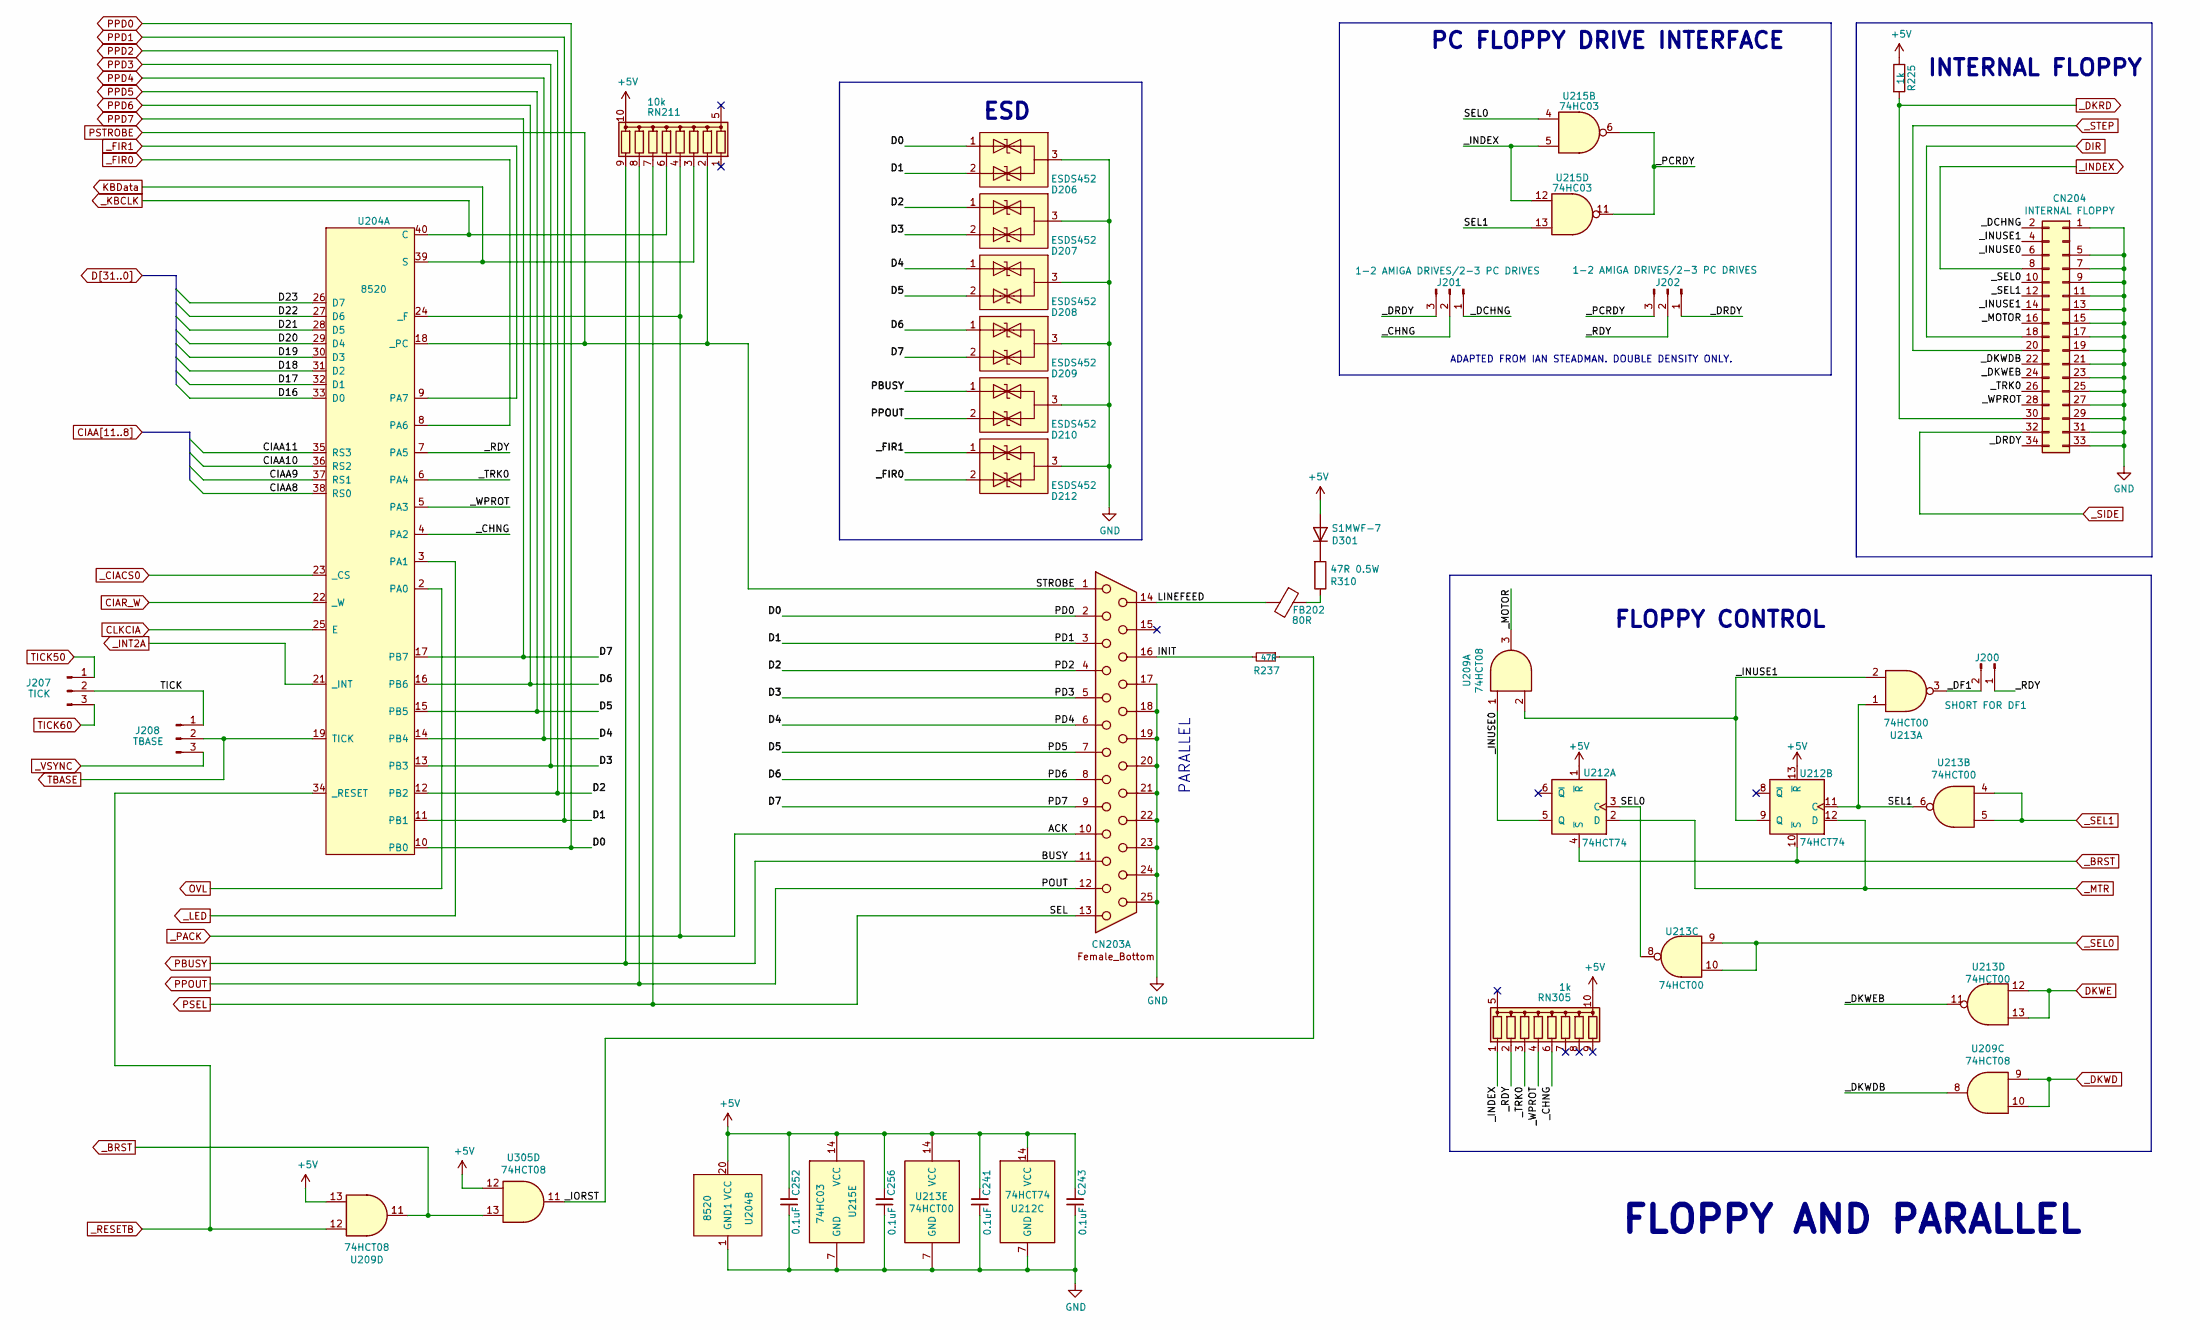
[picture p39: schematic floppy.kicad_sch]

Parts:
C241, C243, C252, C256: 0.1uF; C_0603_1608Metric; LCSC C14663
CN203: DB25_Stack_FemaleAndMale; DSUB-25_Stack_Female_Bottom_Male_Top; LCSC C17554757
CN204: INTERNAL FLOPPY; Floppy_PinHeader_2x17_P2.54mm; LCSC C2685134
D206, D207, D208, D209, D210, D212: ESDS452; SOT-23; LCSC C37574382
D301: S1MWF-7; D_SOD-123F; LCSC C460736
FB202: 80R; C_0805_2012Metric; LCSC C2762183
J200: SHORT FOR DF1; PinHeader_1x02_P2.54mm_Vertical; LCSC C124375
J201, J202: 1-2 AMIGA DRIVES/2-3 PC DRIVES; PinHeader_1x03_P2.54mm_Vertical; LCSC C49257
J207: TICK; PinHeader_1x03_P2.54mm_Vertical; LCSC C49257
J208: TBASE; PinHeader_1x03_P2.54mm_Vertical; LCSC C49257
R225: 1k; R_0603_1608Metric; LCSC C21190
R237: 47R; R_0603_1608Metric; LCSC C23182
R310: 47R 0.5W; R_0805_2012Metric; LCSC C560533
RN211: 10k; R_Array_Convex_5x0603; Part Number YC158TJR-0710KL; LCSC C309679
RN305: 1k; R_Array_Convex_5x0603; Part Number 746X101102JP; LCSC C1731268
U204: 8520; DIP-40_W15.24mm_Socket; LCSC C2332
U209, U305: 74HCT08; TSSOP-14_4.4x5mm_P0.65mm; LCSC C131488
U212: 74HCT74; TSSOP-14_4.4x5mm_P0.65mm; LCSC C141335
U213: 74HCT00; TSSOP-14_4.4x5mm_P0.65mm; LCSC C8206
U215: 74HC03; TSSOP-14_4.4x5mm_P0.65mm; LCSC C2869660

Connections:
+5V: C241.2, C243.2, C252.2, C256.2, D301.2 (A), R225.1, RN211.10 (common), RN305.10 (common), U204.20 (VCC), U209.13, U212.1 (~R), U212.13 (~R), U212.14 (VCC), U213.14 (VCC), U215.14 (VCC), U305.12
CIAA8: U204.38 (RS0)
CIAA9: U204.37 (RS1)
CIAA10: U204.36 (RS2)
CIAA11: U204.35 (RS3)
CIAR_W: U204.22 (_W)
CLKCIA: U204.25 (E)
D16: U204.33 (D0)
D17: U204.32 (D1)
D18: U204.31 (D2)
D19: U204.30 (D3)
D20: U204.29 (D4)
D21: U204.28 (D5)
D22: U204.27 (D6)
D23: U204.26 (D7)
DIR: CN204.18
DKWE: U213.12, U213.13
GND: C241.1, C243.1, C252.1, C256.1, CN203.17, CN203.18, CN203.19, CN203.20, CN203.21, CN203.22, CN203.23, CN203.24, CN203.25, CN204.1, CN204.5, CN204.7, CN204.9, CN204.11, CN204.13, CN204.15, CN204.17, CN204.19, CN204.21, CN204.23, CN204.25, CN204.27, CN204.29, CN204.31, CN204.33, D206.3 (GND), D207.3 (GND), D208.3 (GND), D209.3 (GND), D210.3 (GND), D212.3 (GND), U204.1 (GND1), U212.7 (GND), U213.7 (GND), U215.7 (GND)
INIT: CN203.16, R237.2
KBData: RN211.3 (R3), U204.39 (S)
LINEFEED: CN203.14, FB202.2
unnamed: D301.1 (K), R310.2
unnamed: FB202.1, R310.1
OVL: U204.2 (PA0)
PBUSY: CN203.11, D210.1 (IO1), RN211.9 (R8)
PPD0: CN203.2, D206.1 (IO1), U204.10 (PB0)
PPD1: CN203.3, D206.2 (IO2), U204.11 (PB1)
PPD2: CN203.4, D207.1 (IO1), U204.12 (PB2)
PPD3: CN203.5, D207.2 (IO2), U204.13 (PB3)
PPD4: CN203.6, D208.1 (IO1), U204.14 (PB4)
PPD5: CN203.7, D208.2 (IO2), U204.15 (PB5)
PPD6: CN203.8, D209.1 (IO1), U204.16 (PB6)
PPD7: CN203.9, D209.2 (IO2), U204.17 (PB7)
PPOUT: CN203.12, D210.2 (IO2), RN211.8 (R7)
PSEL: CN203.13, RN211.7 (R6)
PSTROBE: CN203.1, RN211.2 (R2), U204.18 (_PC)
SEL0: U212.3 (C), U213.8, U215.4
SEL1: U212.11 (C), U213.1, U213.6, U215.13
TBASE: J208.2, U204.19 (TICK)
TICK: J207.2, J208.1
TICK50: J207.1
TICK60: J207.3
_BRST: U209.11, U212.4 (~S), U212.10 (~S), U305.13
_CHNG: J201.2, RN305.6 (R5), U204.4 (PA2)
_CIACS0: U204.23 (_CS)
_DCHNG: CN204.2, J201.1
_DF1: J200.2, U213.3
_DKRD: CN204.30, R225.2
_DKWD: U209.9, U209.10
_DKWDB: CN204.22, U209.8
_DKWEB: CN204.24, U213.11
_DRDY: CN204.34, J201.3, J202.1
_FIR0: D212.2 (IO2), U204.8 (PA6)
_FIR1: D212.1 (IO1), U204.9 (PA7)
_INDEX: CN204.8, RN305.1 (R1), U215.5, U215.12
_INT2A: U204.21 (_INT)
_INUSE0: CN204.6, U209.1, U212.5 (Q)
_INUSE1: CN204.4, CN204.14, U209.2, U212.9 (Q), U213.2
_IORST: R237.1, U305.11
_KBCLK: RN211.6 (R5), U204.40 (C)
_LED: U204.3 (PA1)
_MOTOR: CN204.16, U209.3
_MTR: U212.2 (D), U212.12 (D)
_PACK: CN203.10, RN211.4 (R4), U204.24 (_F)
_PCRDY: J202.3, U215.6, U215.11
_RDY: J200.1, J202.2, RN305.2 (R2), U204.7 (PA5)
_RESETB: U204.34 (_RESET), U209.12
_SEL0: CN204.10, U213.9, U213.10
_SEL1: CN204.12, U213.4, U213.5
_SIDE: CN204.32
_STEP: CN204.20
_TRK0: CN204.26, RN305.3 (R3), U204.6 (PA4)
_VSYNC: J208.3
_WPROT: CN204.28, RN305.4 (R4), U204.5 (PA3)

Notes on the sheet:
FLOPPY AND PARALLEL
PC FLOPPY DRIVE INTERFACE
ADAPTED FROM IAN STEADMAN. DOUBLE DENSITY ONLY.
INTERNAL FLOPPY
PARALLEL
ESD
FLOPPY CONTROL
