AmigaPCI/AmigaPCI-MainBoard/KiCAD/AmigaPCI Mainboard-KiCAD REV 70/hid.kicad_sch

## KiCad design KiCAD/AmigaPCI Mainboard-KiCAD REV 70/hid.kicad_sch (2026-06-26)

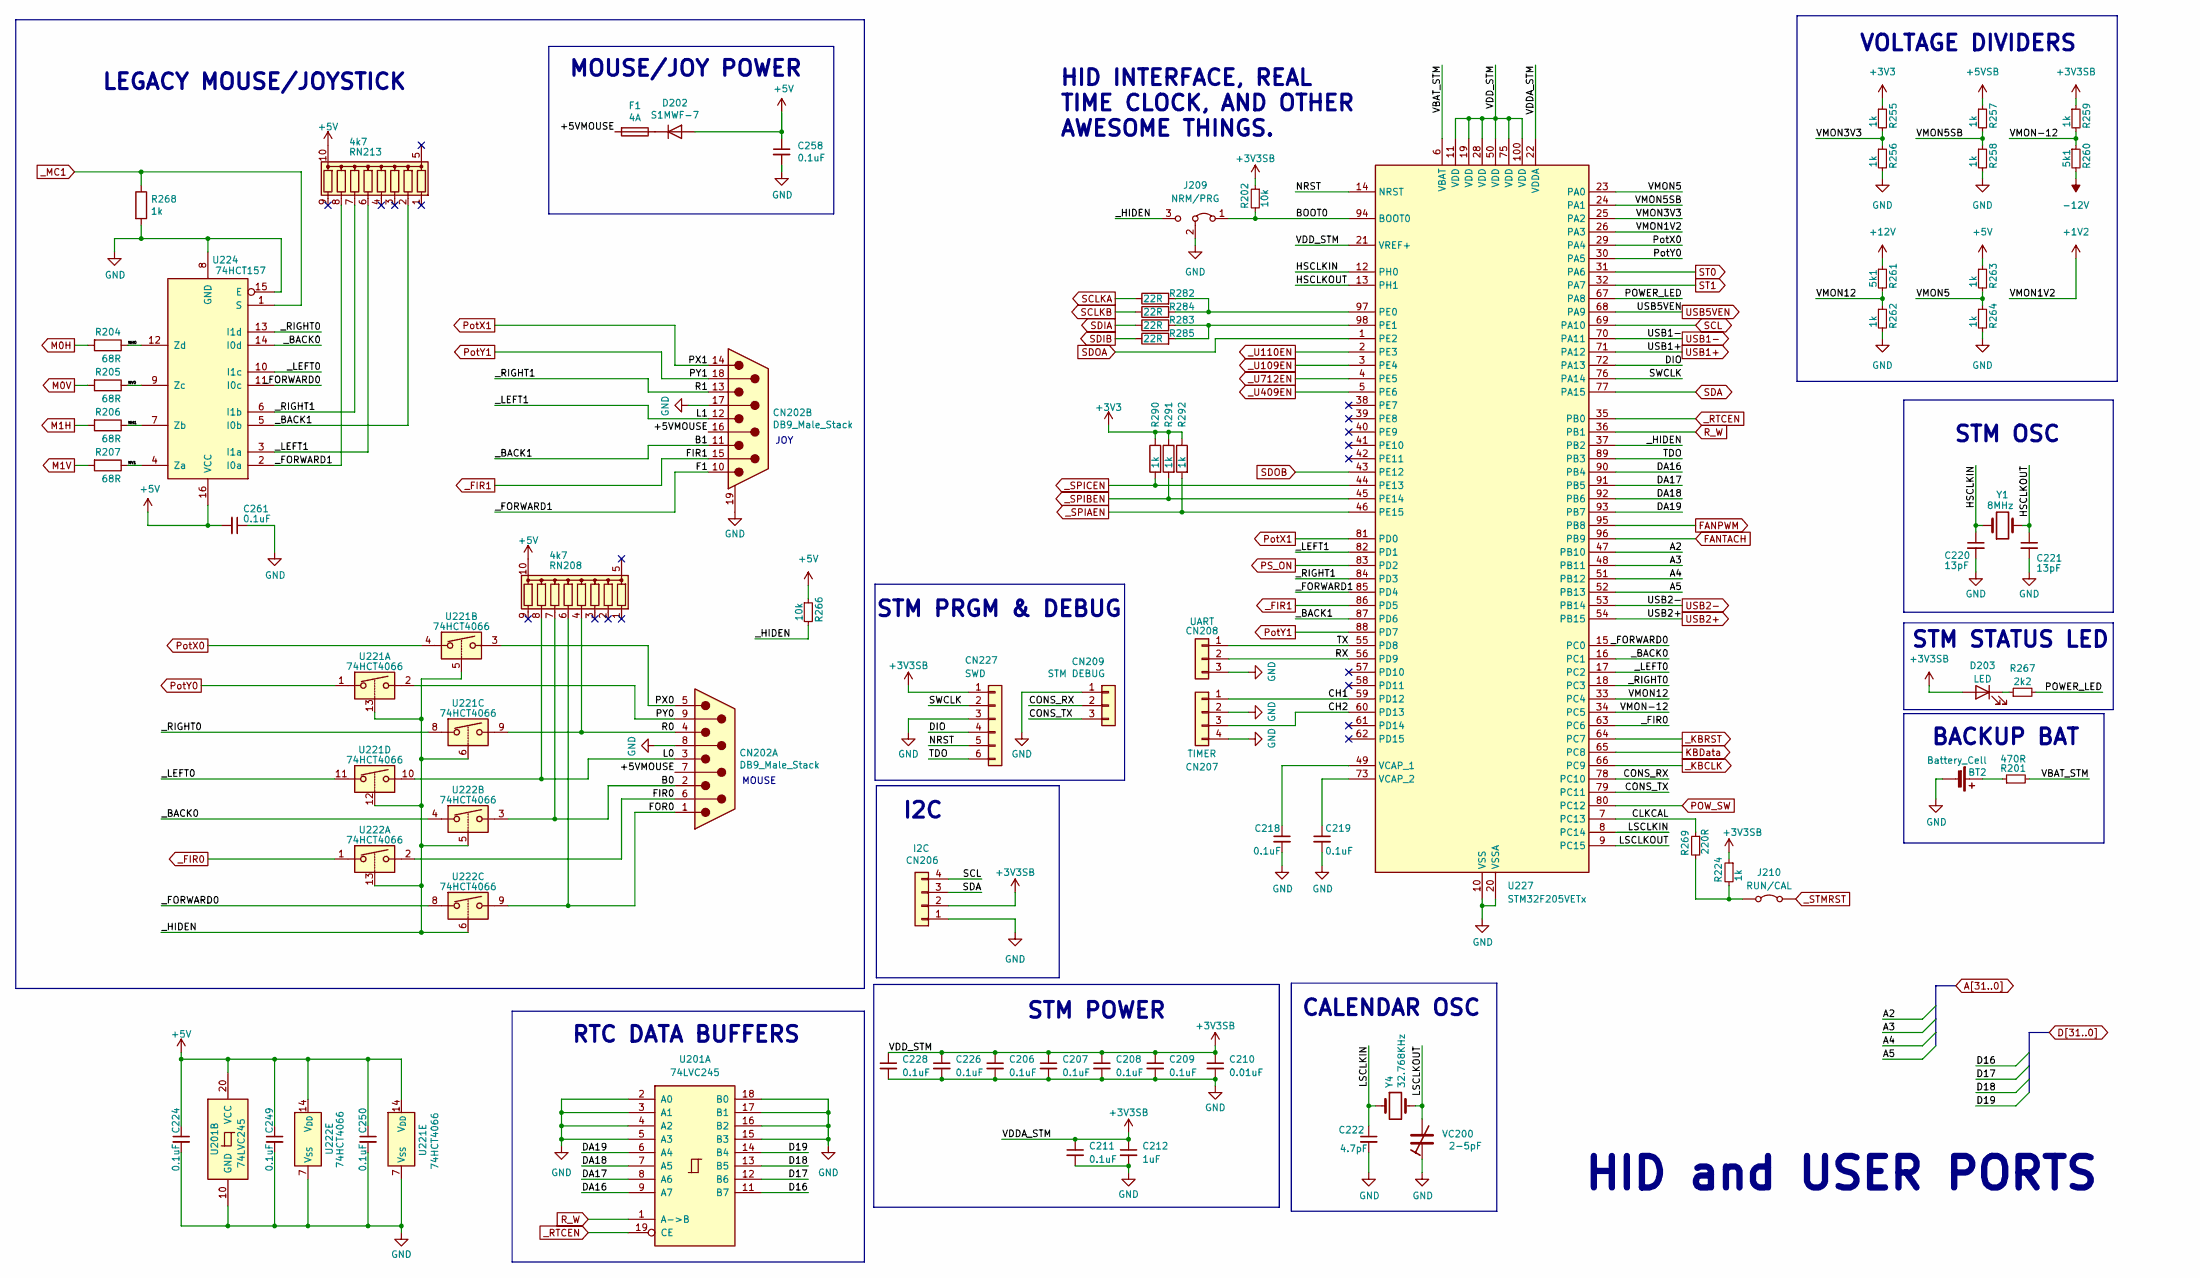
[picture p40: schematic hid.kicad_sch]

Parts:
BT2: Battery_Cell; BatteryHolder_Keystone_103_1x20mm; LCSC C238065
C206, C207, C208, C209, C211, C218, C219, C224, C226, C228, C249, C250, C258, C261: 0.1uF; C_0603_1608Metric; LCSC C14663
C210: 0.01uF; C_0603_1608Metric; LCSC C57112
C212: 1uF; C_0603_1608Metric; LCSC C15849
C220, C221: 13pF; C_0603_1608Metric; LCSC C34243
C222: 4.7pF; C_0603_1608Metric; LCSC C282071
CN202: DB9_Male_Stack; DSUB-9_Male_Stack; LCSC C5431655
CN206: I2C; PinHeader_1x04_P2.54mm_Vertical; LCSC C124378
CN207: TIMER; PinHeader_1x04_P2.54mm_Vertical; LCSC C124378
CN208: UART; PinHeader_1x03_P2.54mm_Vertical; LCSC C49257
CN209: STM DEBUG; PinHeader_1x03_P2.54mm_Vertical; LCSC C49257
CN227: SWD; PinHeader_1x06_P2.54mm_Vertical; LCSC C37208
D202: S1MWF-7; D_SOD-123F; LCSC C460736
D203: LED; LED_0603_1608Metric; LCSC C2286
F1: 4A; Fuse_1206_3216Metric; LCSC C1972812
J209: NRM/PRG; PinHeader_1x03_P2.54mm_Vertical; LCSC C49257
J210: RUN/CAL; PinHeader_1x02_P2.54mm_Vertical; LCSC C124375
R201: 470R; R_0603_1608Metric; LCSC C23179
R202, R266: 10k; R_0603_1608Metric; LCSC C25804
R204, R205, R206, R207: 68R; R_0603_1608Metric; LCSC C25254
R224, R255, R256, R257, R258, R259, R262, R263, R264, R268, R290, R291, R292: 1k; R_0603_1608Metric; LCSC C21190
R260, R261: 5k1; R_0603_1608Metric; LCSC C23186
R267: 2k2; R_0603_1608Metric; LCSC C4190
R269: 220R; R_0603_1608Metric; LCSC C22962
R282, R283, R284, R285: 22R; R_0603_1608Metric; LCSC C23345
RN208, RN213: 4k7; R_Array_Convex_5x0603; Part Number YC158TJR-074K7L; LCSC C728819
U201: 74LVC245; TSSOP-20_4.4x6.5mm_P0.65mm; LCSC C7848
U221, U222: 74HCT4066; TSSOP-14_4.4x5mm_P0.65mm; LCSC C26433
U224: 74HCT157; TSSOP-16_4.4x5mm_P0.65mm; LCSC C2674471
U227: STM32F205VETx; LQFP-100_14x14mm_P0.5mm; LCSC C81869
VC200: 2-5pF; TrimmerCap; Part Number GKG5R015; LCSC C3273284
Y1: 8MHz; Crystal_SMD_5032-2Pin_5.0x3.2mm; Part 445C33D25M00000; LCSC C5564812
Y4: 32.768KHz; Crystal_SMD_3215-2Pin_3.2x1.5mm; Part Number FC-135 32.7680KA-AG0; LCSC C20340322

Connections:
+1V2: U227.26 (PA3)
+3V3: R255.1, R290.1, R291.1, R292.1
+3V3SB: C206.1, C207.1, C208.1, C209.1, C210.1, C211.1, C212.1, C226.1, C228.1, CN206.2, CN227.1, D203.2 (A), R202.1, R224.1, R259.1, U227.11 (VDD), U227.19 (VDD), U227.21 (VREF+), U227.22 (VDDA), U227.28 (VDD), U227.50 (VDD), U227.75 (VDD), U227.100 (VDD)
+5V: C224.1, C249.1, C250.1, C258.1, C261.2, D202.2 (A), R263.1, R266.1, RN208.10 (common), RN213.10 (common), U201.20 (VCC), U221.14 (V_{DD}), U222.14 (V_{DD}), U224.16 (VCC)
+5VMOUSE: CN202.7, CN202.16, F1.2
+5VSB: R257.1
+12V: R261.1
-12V: R260.2
A2: U227.47 (PB10)
A3: U227.48 (PB11)
A4: U227.51 (PB12)
A5: U227.52 (PB13)
B0: CN202.2, RN208.7 (R6), U222.3
BOOT0: J209.1 (A), R202.2, U227.94 (BOOT0)
CH1: CN207.1, U227.59 (PD12)
CH2: CN207.3, U227.60 (PD13)
CLKCAL: R269.1, U227.7 (PC13)
CONS_RX: CN209.2, U227.78 (PC10)
CONS_TX: CN209.3, U227.79 (PC11)
D16: U201.11 (B7)
D17: U201.12 (B6)
D18: U201.13 (B5)
D19: U201.14 (B4)
DA16: U201.9 (A7), U227.90 (PB4)
DA17: U201.8 (A6), U227.91 (PB5)
DA18: U201.7 (A5), U227.92 (PB6)
DA19: U201.6 (A4), U227.93 (PB7)
DIO: CN227.4, U227.72 (PA13)
FANPWM: U227.95 (PB8)
FANTACH: U227.96 (PB9)
FIR0: CN202.6, U222.2
FOR0: CN202.1, RN208.6 (R5), U222.9
GND: BT2.2 (-), C206.2, C207.2, C208.2, C209.2, C210.2, C211.2, C212.2, C218.2, C219.2, C220.2, C221.2, C222.2, C224.2, C226.2, C228.2, C249.2, C250.2, C258.2, C261.1, CN202.8, CN202.17, CN202.19 (GND), CN206.1, CN207.2, CN207.4, CN208.3, CN209.1, CN227.3, J209.2 (C), R256.2, R258.2, R262.2, R264.2, R268.2, U201.2 (A0), U201.3 (A1), U201.4 (A2), U201.5 (A3), U201.10 (GND), U201.15 (B3), U201.16 (B2), U201.17 (B1), U201.18 (B0), U221.7 (V_{SS}), U222.7 (V_{SS}), U224.8 (GND), U224.15 (E), U227.10 (VSS), U227.20 (VSSA), U227.27 (VSS), U227.74 (VSS), VC200.1
HSCLKIN: C220.1, U227.12 (PH0), Y1.1
HSCLKOUT: C221.1, U227.13 (PH1), Y1.2
KBData: U227.65 (PC8)
L0: CN202.3, RN208.8 (R7), U221.10
LSCLKIN: C222.1, U227.8 (PC14), Y4.1
LSCLKOUT: U227.9 (PC15), VC200.2, Y4.2
M0H: R204.2
M0V: R205.2
M1H: R206.2
M1V: R207.2
MH0: R204.1, U224.12 (Zd)
MH1: R206.1, U224.7 (Zb)
MV0: R205.1, U224.9 (Zc)
MV1: R207.1, U224.4 (Za)
NRST: CN227.5, U227.14 (NRST)
unnamed: BT2.1 (+), R201.1
unnamed: C218.1, U227.49 (VCAP_1)
unnamed: C219.1, U227.73 (VCAP_2)
unnamed: D202.1 (K), F1.1
unnamed: D203.1 (K), R267.1
unnamed: J210.2 (B), R224.2, R269.2
unnamed: R282.2, R284.2, U227.97 (PE0)
unnamed: R283.2, R285.2, U227.98 (PE1)
POWER_LED: R267.2, U227.67 (PA8)
POW_SW: U227.80 (PC12)
PS_ON: U227.83 (PD2)
PX0: CN202.5, U221.3
PY0: CN202.9, U221.2
PotX0: U221.4, U227.29 (PA4)
PotX1: CN202.14, U227.81 (PD0)
PotY0: U221.1, U227.30 (PA5)
PotY1: CN202.18, U227.88 (PD7)
R0: CN202.4, RN208.4 (R4), U221.9
RX: CN208.2, U227.56 (PD9)
R_W: U201.1 (A->B), U227.36 (PB1)
SCL: CN206.4, U227.69 (PA10)
SCLKA: R282.1
SCLKB: R284.1
SDA: CN206.3, U227.77 (PA15)
SDIA: R283.1
SDIB: R285.1
SDOA: U227.1 (PE2)
SDOB: U227.43 (PE12)
ST0: U227.31 (PA6)
ST1: U227.32 (PA7)
SWCLK: CN227.2, U227.76 (PA14)
TDO: CN227.6, U227.89 (PB3)
TX: CN208.1, U227.55 (PD8)
USB1+: U227.71 (PA12)
USB1-: U227.70 (PA11)
USB2+: U227.54 (PB15)
USB2-: U227.53 (PB14)
USB5VEN: U227.68 (PA9)
VBAT_STM: R201.2, U227.6 (VBAT)
VMON3V3: R255.2, R256.1, U227.25 (PA2)
VMON5: R263.2, R264.1, U227.23 (PA0)
VMON5SB: R257.2, R258.1, U227.24 (PA1)
VMON12: R261.2, R262.1, U227.33 (PC4)
VMON-12: R259.2, R260.1, U227.34 (PC5)
_BACK0: U222.4, U224.14 (I0d), U227.16 (PC1)
_BACK1: CN202.11, RN213.2 (R2), U224.5 (I0b), U227.87 (PD6)
_FIR0: U222.1, U227.63 (PC6)
_FIR1: CN202.15, U227.86 (PD5)
_FORWARD0: U222.8, U224.11 (I0c), U227.15 (PC0)
_FORWARD1: CN202.10, RN213.8 (R7), U224.2 (I0a), U227.85 (PD4)
_HIDEN: J209.3 (B), R266.2, U221.5, U221.6, U221.12, U221.13, U222.5, U222.6, U222.13, U227.37 (PB2)
_KBCLK: U227.66 (PC9)
_KBRST: U227.64 (PC7)
_LEFT0: U221.11, U224.10 (I1c), U227.17 (PC2)
_LEFT1: CN202.12, RN213.6 (R5), U224.3 (I1a), U227.82 (PD1)
_MC1: R268.1, U224.1 (S)
_RIGHT0: U221.8, U224.13 (I1d), U227.18 (PC3)
_RIGHT1: CN202.13, RN213.7 (R6), U224.6 (I1b), U227.84 (PD3)
_RTCEN: U201.19 (CE), U227.35 (PB0)
_SPIAEN: R292.2, U227.46 (PE15)
_SPIBEN: R291.2, U227.45 (PE14)
_SPICEN: R290.2, U227.44 (PE13)
_STMRST: J210.1 (A)
_U109EN: U227.3 (PE4)
_U110EN: U227.2 (PE3)
_U409EN: U227.5 (PE6)
_U712EN: U227.4 (PE5)

Notes on the sheet:
CALENDAR OSC
STM STATUS LED
VOLTAGE DIVIDERS
HID and USER PORTS
LEGACY MOUSE/JOYSTICK
I2C
MOUSE/JOY POWER
STM OSC
STM POWER
HID INTERFACE, REAL TIME CLOCK, AND OTHER AWESOME THINGS.
MOUSE
JOY
BACKUP BAT
STM PRGM & DEBUG
RTC DATA BUFFERS
