AmigaPCI/AmigaPCI-MainBoard/KiCAD/AmigaPCI Mainboard-KiCAD REV 70/memory.kicad_sch

## KiCad design KiCAD/AmigaPCI Mainboard-KiCAD REV 70/memory.kicad_sch (2026-06-26)

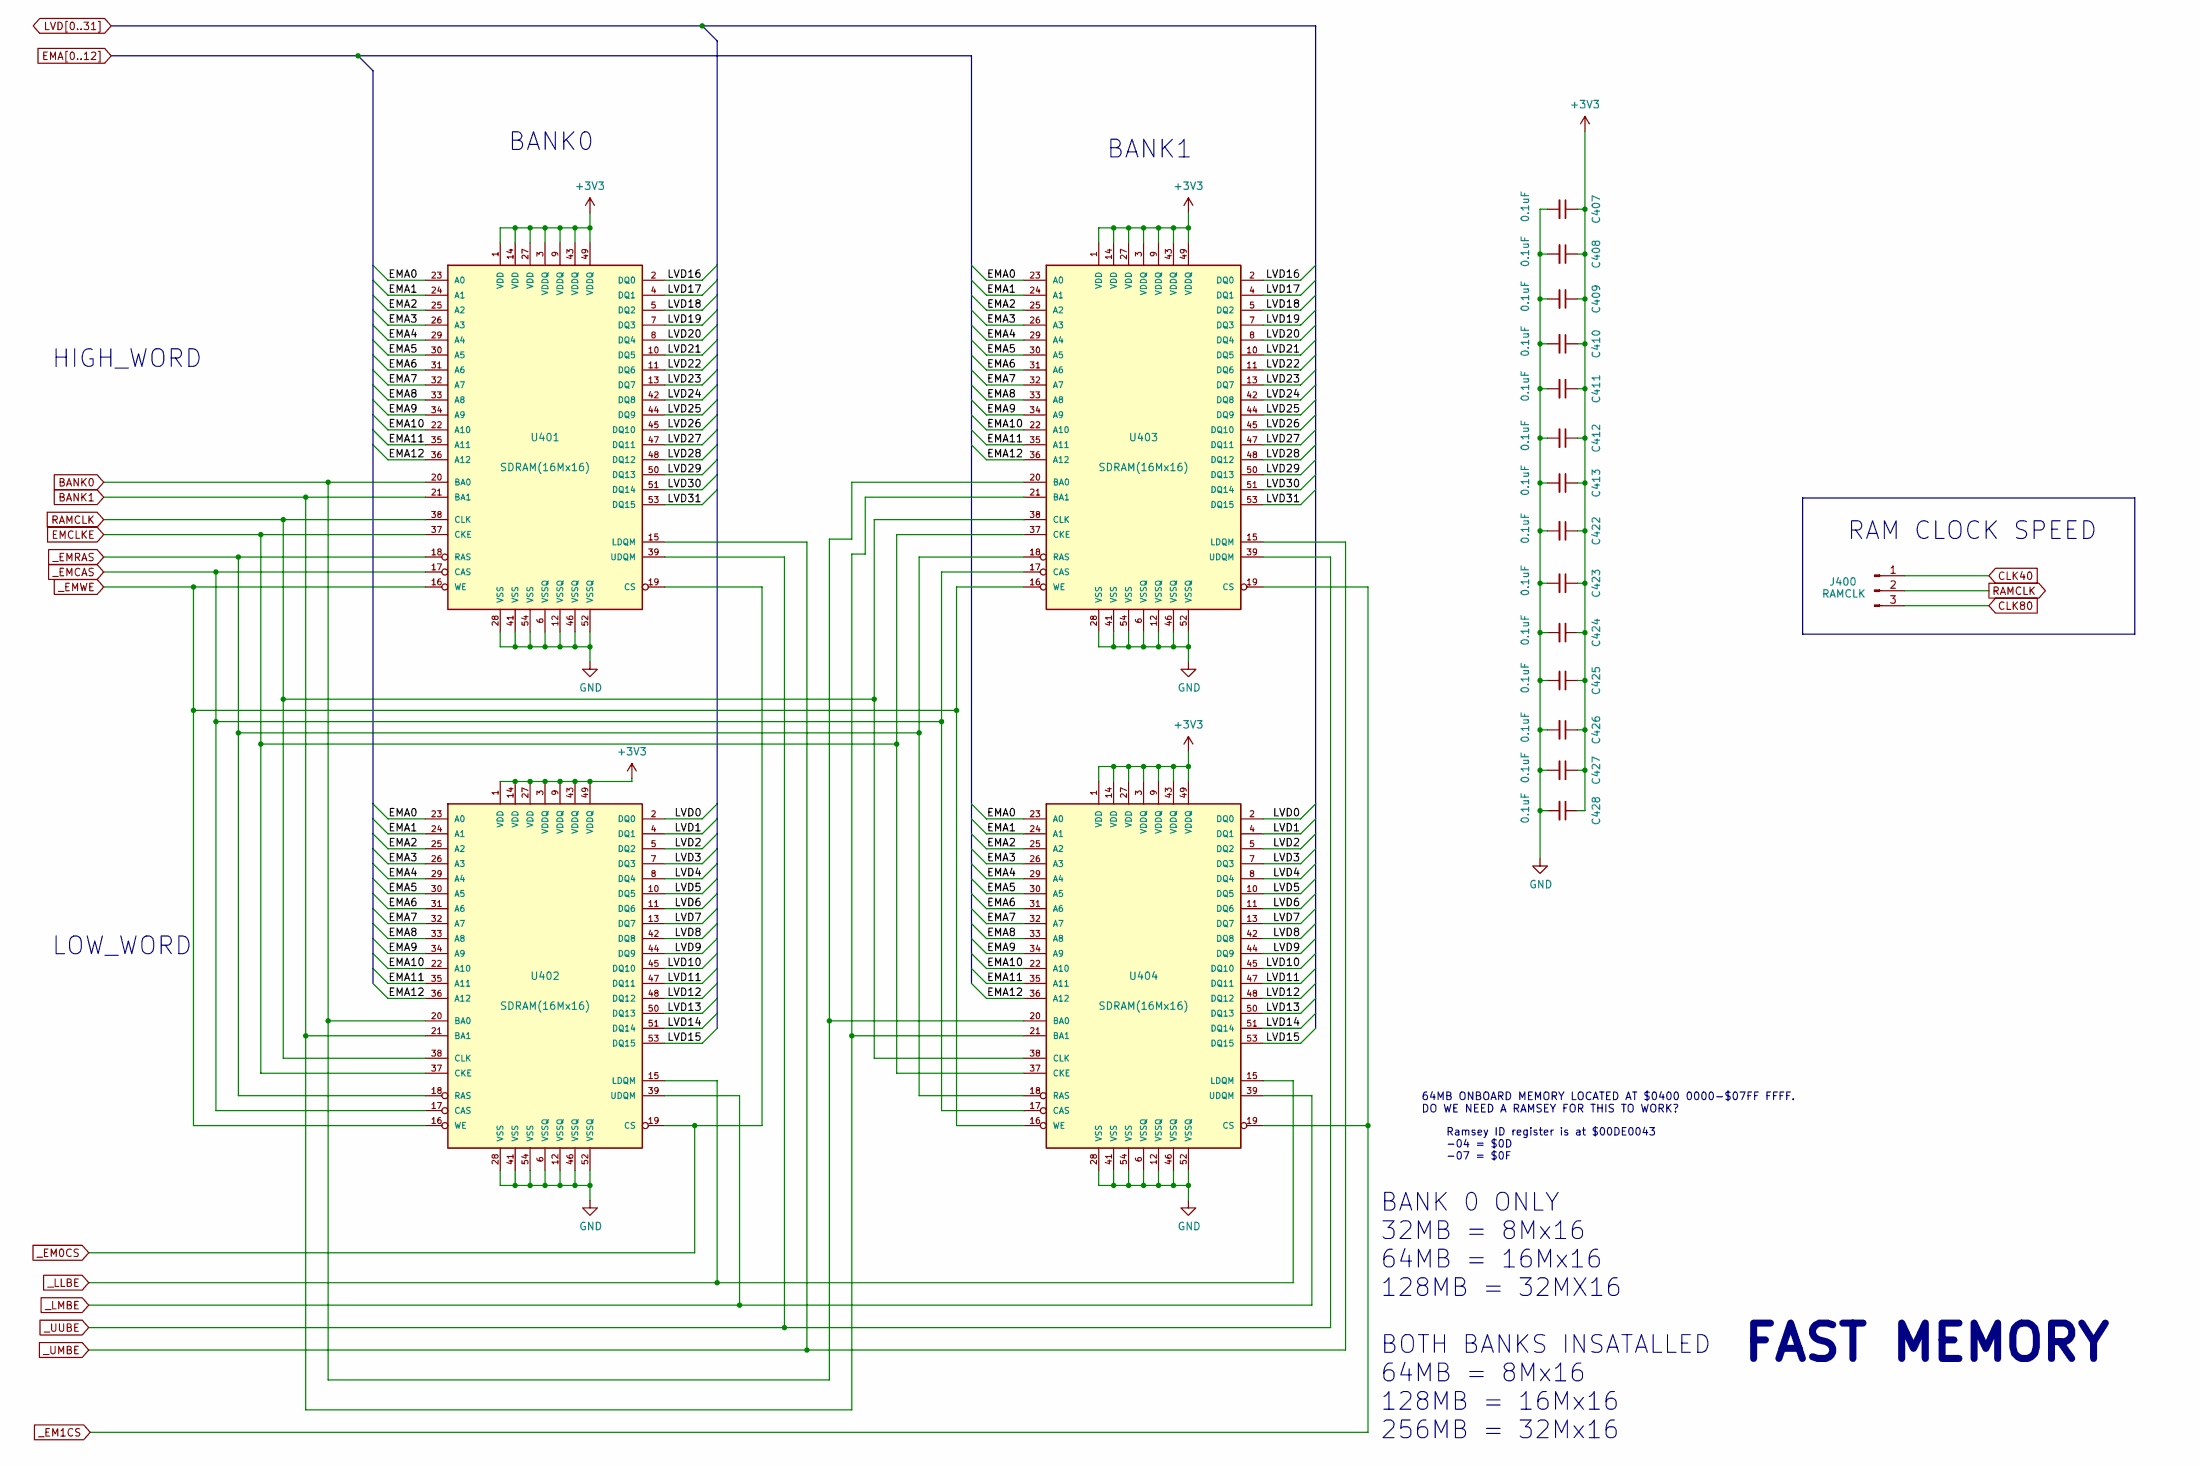
[picture p41: schematic memory.kicad_sch]

Parts:
C407, C408, C409, C410, C411, C412, C413, C422, C423, C424, C425, C426, C427, C428: 0.1uF; C_0603_1608Metric
J400: RAMCLK; PinHeader_1x03_P2.54mm_Vertical
U401, U402, U403, U404: SDRAM(16Mx16); TSOP-II-54_22.2x10.16mm_P0.8mm

Connections:
+3V3: C407.1, C408.1, C409.1, C410.1, C411.1, C412.1, C413.1, C422.1, C423.1, C424.1, C425.1, C426.1, C427.1, C428.1, U401.1 (VDD), U401.3 (VDDQ), U401.9 (VDDQ), U401.14 (VDD), U401.27 (VDD), U401.43 (VDDQ), U401.49 (VDDQ), U402.1 (VDD), U402.3 (VDDQ), U402.9 (VDDQ), U402.14 (VDD), U402.27 (VDD), U402.43 (VDDQ), U402.49 (VDDQ), U403.1 (VDD), U403.3 (VDDQ), U403.9 (VDDQ), U403.14 (VDD), U403.27 (VDD), U403.43 (VDDQ), U403.49 (VDDQ), U404.1 (VDD), U404.3 (VDDQ), U404.9 (VDDQ), U404.14 (VDD), U404.27 (VDD), U404.43 (VDDQ), U404.49 (VDDQ)
BANK0: U401.20 (BA0), U402.20 (BA0), U403.20 (BA0), U404.20 (BA0)
BANK1: U401.21 (BA1), U402.21 (BA1), U403.21 (BA1), U404.21 (BA1)
CLK40: J400.1
CLK80: J400.3
EMA0: U401.23 (A0), U402.23 (A0), U403.23 (A0), U404.23 (A0)
EMA1: U401.24 (A1), U402.24 (A1), U403.24 (A1), U404.24 (A1)
EMA2: U401.25 (A2), U402.25 (A2), U403.25 (A2), U404.25 (A2)
EMA3: U401.26 (A3), U402.26 (A3), U403.26 (A3), U404.26 (A3)
EMA4: U401.29 (A4), U402.29 (A4), U403.29 (A4), U404.29 (A4)
EMA5: U401.30 (A5), U402.30 (A5), U403.30 (A5), U404.30 (A5)
EMA6: U401.31 (A6), U402.31 (A6), U403.31 (A6), U404.31 (A6)
EMA7: U401.32 (A7), U402.32 (A7), U403.32 (A7), U404.32 (A7)
EMA8: U401.33 (A8), U402.33 (A8), U403.33 (A8), U404.33 (A8)
EMA9: U401.34 (A9), U402.34 (A9), U403.34 (A9), U404.34 (A9)
EMA10: U401.22 (A10), U402.22 (A10), U403.22 (A10), U404.22 (A10)
EMA11: U401.35 (A11), U402.35 (A11), U403.35 (A11), U404.35 (A11)
EMA12: U401.36 (A12), U402.36 (A12), U403.36 (A12), U404.36 (A12)
EMCLKE: U401.37 (CKE), U402.37 (CKE), U403.37 (CKE), U404.37 (CKE)
GND: C407.2, C408.2, C409.2, C410.2, C411.2, C412.2, C413.2, C422.2, C423.2, C424.2, C425.2, C426.2, C427.2, C428.2, U401.6 (VSSQ), U401.12 (VSSQ), U401.28 (VSS), U401.41 (VSS), U401.46 (VSSQ), U401.52 (VSSQ), U401.54 (VSS), U402.6 (VSSQ), U402.12 (VSSQ), U402.28 (VSS), U402.41 (VSS), U402.46 (VSSQ), U402.52 (VSSQ), U402.54 (VSS), U403.6 (VSSQ), U403.12 (VSSQ), U403.28 (VSS), U403.41 (VSS), U403.46 (VSSQ), U403.52 (VSSQ), U403.54 (VSS), U404.6 (VSSQ), U404.12 (VSSQ), U404.28 (VSS), U404.41 (VSS), U404.46 (VSSQ), U404.52 (VSSQ), U404.54 (VSS)
LVD0: U402.2 (DQ0), U404.2 (DQ0)
LVD1: U402.4 (DQ1), U404.4 (DQ1)
LVD2: U402.5 (DQ2), U404.5 (DQ2)
LVD3: U402.7 (DQ3), U404.7 (DQ3)
LVD4: U402.8 (DQ4), U404.8 (DQ4)
LVD5: U402.10 (DQ5), U404.10 (DQ5)
LVD6: U402.11 (DQ6), U404.11 (DQ6)
LVD7: U402.13 (DQ7), U404.13 (DQ7)
LVD8: U402.42 (DQ8), U404.42 (DQ8)
LVD9: U402.44 (DQ9), U404.44 (DQ9)
LVD10: U402.45 (DQ10), U404.45 (DQ10)
LVD11: U402.47 (DQ11), U404.47 (DQ11)
LVD12: U402.48 (DQ12), U404.48 (DQ12)
LVD13: U402.50 (DQ13), U404.50 (DQ13)
LVD14: U402.51 (DQ14), U404.51 (DQ14)
LVD15: U402.53 (DQ15), U404.53 (DQ15)
LVD16: U401.2 (DQ0), U403.2 (DQ0)
LVD17: U401.4 (DQ1), U403.4 (DQ1)
LVD18: U401.5 (DQ2), U403.5 (DQ2)
LVD19: U401.7 (DQ3), U403.7 (DQ3)
LVD20: U401.8 (DQ4), U403.8 (DQ4)
LVD21: U401.10 (DQ5), U403.10 (DQ5)
LVD22: U401.11 (DQ6), U403.11 (DQ6)
LVD23: U401.13 (DQ7), U403.13 (DQ7)
LVD24: U401.42 (DQ8), U403.42 (DQ8)
LVD25: U401.44 (DQ9), U403.44 (DQ9)
LVD26: U401.45 (DQ10), U403.45 (DQ10)
LVD27: U401.47 (DQ11), U403.47 (DQ11)
LVD28: U401.48 (DQ12), U403.48 (DQ12)
LVD29: U401.50 (DQ13), U403.50 (DQ13)
LVD30: U401.51 (DQ14), U403.51 (DQ14)
LVD31: U401.53 (DQ15), U403.53 (DQ15)
RAMCLK: J400.2, U401.38 (CLK), U402.38 (CLK), U403.38 (CLK), U404.38 (CLK)
_EM0CS: U401.19 (CS), U402.19 (CS)
_EM1CS: U403.19 (CS), U404.19 (CS)
_EMCAS: U401.17 (CAS), U402.17 (CAS), U403.17 (CAS), U404.17 (CAS)
_EMRAS: U401.18 (RAS), U402.18 (RAS), U403.18 (RAS), U404.18 (RAS)
_EMWE: U401.16 (WE), U402.16 (WE), U403.16 (WE), U404.16 (WE)
_LLBE: U402.15 (LDQM), U404.15 (LDQM)
_LMBE: U402.39 (UDQM), U404.39 (UDQM)
_UMBE: U401.15 (LDQM), U403.15 (LDQM)
_UUBE: U401.39 (UDQM), U403.39 (UDQM)

Notes on the sheet:
BANK 0 ONLY 32MB = 8Mx16 64MB = 16Mx16 128MB = 32MX16 BOTH BANKS INSATALLED 64MB = 8Mx16 128MB = 16Mx16 256MB = 32Mx16
RAM CLOCK SPEED
BANK1
FAST MEMORY
64MB ONBOARD MEMORY LOCATED AT $0400 0000-$07FF FFFF. DO WE NEED A RAMSEY FOR THIS TO WORK?
BANK0
LOW_WORD
HIGH_WORD
Ramsey ID register is at $00DE0043 -04 = $0D -07 = $0F
