AmigaPCI/AmigaPCI-MainBoard/KiCAD/AmigaPCI Mainboard-KiCAD REV 70/motorola_bus_logic.kicad_sch

## KiCad design KiCAD/AmigaPCI Mainboard-KiCAD REV 70/motorola_bus_logic.kicad_sch (2026-06-26)

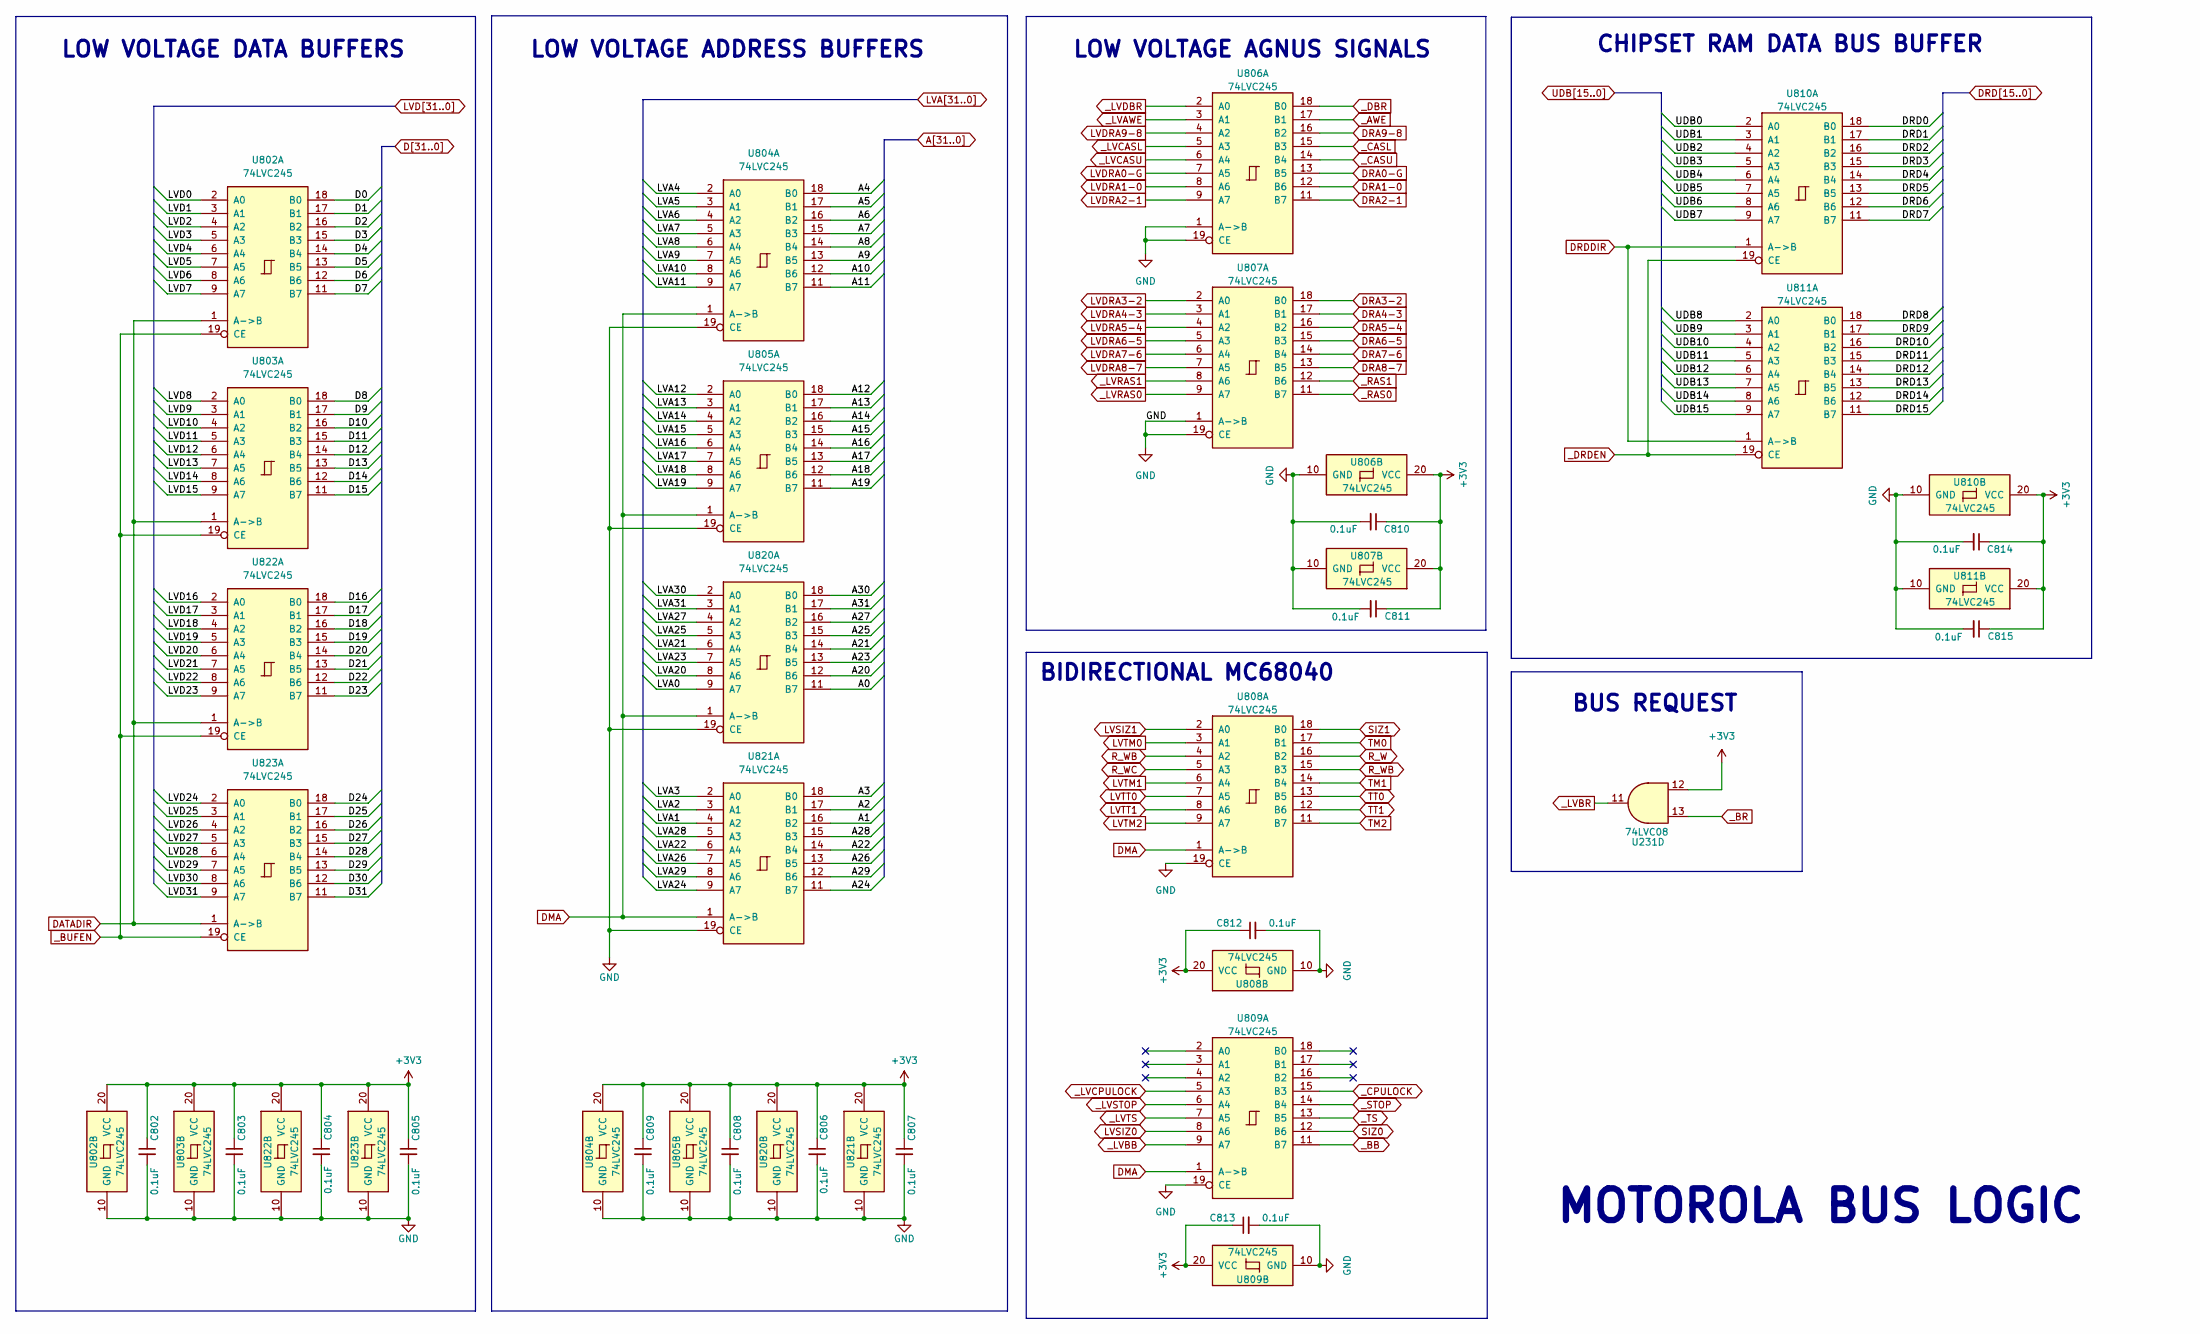
[picture p42: schematic motorola_bus_logic.kicad_sch]

Parts:
C802, C803, C804, C805, C806, C807, C808, C809, C810, C811, C812, C813, C814, C815: 0.1uF; C_0603_1608Metric; LCSC C14663
U231: 74LVC08; TSSOP-14_4.4x5mm_P0.65mm; LCSC C6053
U802, U803, U804, U805, U806, U807, U808, U809, U810, U811, U820, U821, U822, U823: 74LVC245; TSSOP-20_4.4x6.5mm_P0.65mm; LCSC C7848

Connections:
+3V3: C802.1, C803.1, C804.1, C805.1, C806.1, C807.1, C808.1, C809.1, C810.1, C811.1, C812.1, C813.1, C814.1, C815.1, U231.12, U802.20 (VCC), U803.20 (VCC), U804.20 (VCC), U805.20 (VCC), U806.20 (VCC), U807.20 (VCC), U808.20 (VCC), U809.20 (VCC), U810.20 (VCC), U811.20 (VCC), U820.20 (VCC), U821.20 (VCC), U822.20 (VCC), U823.20 (VCC)
A0: U820.11 (B7)
A1: U821.16 (B2)
A2: U821.17 (B1)
A3: U821.18 (B0)
A4: U804.18 (B0)
A5: U804.17 (B1)
A6: U804.16 (B2)
A7: U804.15 (B3)
A8: U804.14 (B4)
A9: U804.13 (B5)
A10: U804.12 (B6)
A11: U804.11 (B7)
A12: U805.18 (B0)
A13: U805.17 (B1)
A14: U805.16 (B2)
A15: U805.15 (B3)
A16: U805.14 (B4)
A17: U805.13 (B5)
A18: U805.12 (B6)
A19: U805.11 (B7)
A20: U820.12 (B6)
A21: U820.14 (B4)
A22: U821.14 (B4)
A23: U820.13 (B5)
A24: U821.11 (B7)
A25: U820.15 (B3)
A26: U821.13 (B5)
A27: U820.16 (B2)
A28: U821.15 (B3)
A29: U821.12 (B6)
A30: U820.18 (B0)
A31: U820.17 (B1)
D0: U802.18 (B0)
D1: U802.17 (B1)
D2: U802.16 (B2)
D3: U802.15 (B3)
D4: U802.14 (B4)
D5: U802.13 (B5)
D6: U802.12 (B6)
D7: U802.11 (B7)
D8: U803.18 (B0)
D9: U803.17 (B1)
D10: U803.16 (B2)
D11: U803.15 (B3)
D12: U803.14 (B4)
D13: U803.13 (B5)
D14: U803.12 (B6)
D15: U803.11 (B7)
D16: U822.18 (B0)
D17: U822.17 (B1)
D18: U822.16 (B2)
D19: U822.15 (B3)
D20: U822.14 (B4)
D21: U822.13 (B5)
D22: U822.12 (B6)
D23: U822.11 (B7)
D24: U823.18 (B0)
D25: U823.17 (B1)
D26: U823.16 (B2)
D27: U823.15 (B3)
D28: U823.14 (B4)
D29: U823.13 (B5)
D30: U823.12 (B6)
D31: U823.11 (B7)
DATADIR: U802.1 (A->B), U803.1 (A->B), U822.1 (A->B), U823.1 (A->B)
DMA: U804.1 (A->B), U805.1 (A->B), U808.1 (A->B), U809.1 (A->B), U820.1 (A->B), U821.1 (A->B)
DRA0-G: U806.13 (B5)
DRA1-0: U806.12 (B6)
DRA2-1: U806.11 (B7)
DRA3-2: U807.18 (B0)
DRA4-3: U807.17 (B1)
DRA5-4: U807.16 (B2)
DRA6-5: U807.15 (B3)
DRA7-6: U807.14 (B4)
DRA8-7: U807.13 (B5)
DRA9-8: U806.16 (B2)
DRD0: U810.18 (B0)
DRD1: U810.17 (B1)
DRD2: U810.16 (B2)
DRD3: U810.15 (B3)
DRD4: U810.14 (B4)
DRD5: U810.13 (B5)
DRD6: U810.12 (B6)
DRD7: U810.11 (B7)
DRD8: U811.18 (B0)
DRD9: U811.17 (B1)
DRD10: U811.16 (B2)
DRD11: U811.15 (B3)
DRD12: U811.14 (B4)
DRD13: U811.13 (B5)
DRD14: U811.12 (B6)
DRD15: U811.11 (B7)
DRDDIR: U810.1 (A->B), U811.1 (A->B)
GND: C802.2, C803.2, C804.2, C805.2, C806.2, C807.2, C808.2, C809.2, C810.2, C811.2, C812.2, C813.2, C814.2, C815.2, U802.10 (GND), U803.10 (GND), U804.10 (GND), U804.19 (CE), U805.10 (GND), U805.19 (CE), U806.1 (A->B), U806.10 (GND), U806.19 (CE), U807.1 (A->B), U807.10 (GND), U807.19 (CE), U808.10 (GND), U808.19 (CE), U809.10 (GND), U809.19 (CE), U810.10 (GND), U811.10 (GND), U820.10 (GND), U820.19 (CE), U821.10 (GND), U821.19 (CE), U822.10 (GND), U823.10 (GND)
LVA0: U820.9 (A7)
LVA1: U821.4 (A2)
LVA2: U821.3 (A1)
LVA3: U821.2 (A0)
LVA4: U804.2 (A0)
LVA5: U804.3 (A1)
LVA6: U804.4 (A2)
LVA7: U804.5 (A3)
LVA8: U804.6 (A4)
LVA9: U804.7 (A5)
LVA10: U804.8 (A6)
LVA11: U804.9 (A7)
LVA12: U805.2 (A0)
LVA13: U805.3 (A1)
LVA14: U805.4 (A2)
LVA15: U805.5 (A3)
LVA16: U805.6 (A4)
LVA17: U805.7 (A5)
LVA18: U805.8 (A6)
LVA19: U805.9 (A7)
LVA20: U820.8 (A6)
LVA21: U820.6 (A4)
LVA22: U821.6 (A4)
LVA23: U820.7 (A5)
LVA24: U821.9 (A7)
LVA25: U820.5 (A3)
LVA26: U821.7 (A5)
LVA27: U820.4 (A2)
LVA28: U821.5 (A3)
LVA29: U821.8 (A6)
LVA30: U820.2 (A0)
LVA31: U820.3 (A1)
LVD0: U802.2 (A0)
LVD1: U802.3 (A1)
LVD2: U802.4 (A2)
LVD3: U802.5 (A3)
LVD4: U802.6 (A4)
LVD5: U802.7 (A5)
LVD6: U802.8 (A6)
LVD7: U802.9 (A7)
LVD8: U803.2 (A0)
LVD9: U803.3 (A1)
LVD10: U803.4 (A2)
LVD11: U803.5 (A3)
LVD12: U803.6 (A4)
LVD13: U803.7 (A5)
LVD14: U803.8 (A6)
LVD15: U803.9 (A7)
LVD16: U822.2 (A0)
LVD17: U822.3 (A1)
LVD18: U822.4 (A2)
LVD19: U822.5 (A3)
LVD20: U822.6 (A4)
LVD21: U822.7 (A5)
LVD22: U822.8 (A6)
LVD23: U822.9 (A7)
LVD24: U823.2 (A0)
LVD25: U823.3 (A1)
LVD26: U823.4 (A2)
LVD27: U823.5 (A3)
LVD28: U823.6 (A4)
LVD29: U823.7 (A5)
LVD30: U823.8 (A6)
LVD31: U823.9 (A7)
LVDRA0-G: U806.7 (A5)
LVDRA1-0: U806.8 (A6)
LVDRA2-1: U806.9 (A7)
LVDRA3-2: U807.2 (A0)
LVDRA4-3: U807.3 (A1)
LVDRA5-4: U807.4 (A2)
LVDRA6-5: U807.5 (A3)
LVDRA7-6: U807.6 (A4)
LVDRA8-7: U807.7 (A5)
LVDRA9-8: U806.4 (A2)
LVSIZ0: U809.8 (A6)
LVSIZ1: U808.2 (A0)
LVTM0: U808.3 (A1)
LVTM1: U808.6 (A4)
LVTM2: U808.9 (A7)
LVTT0: U808.7 (A5)
LVTT1: U808.8 (A6)
R_W: U808.16 (B2)
R_WB: U808.4 (A2), U808.15 (B3)
R_WC: U808.5 (A3)
SIZ0: U809.12 (B6)
SIZ1: U808.18 (B0)
TM0: U808.17 (B1)
TM1: U808.14 (B4)
TM2: U808.11 (B7)
TT0: U808.13 (B5)
TT1: U808.12 (B6)
UDB0: U810.2 (A0)
UDB1: U810.3 (A1)
UDB2: U810.4 (A2)
UDB3: U810.5 (A3)
UDB4: U810.6 (A4)
UDB5: U810.7 (A5)
UDB6: U810.8 (A6)
UDB7: U810.9 (A7)
UDB8: U811.2 (A0)
UDB9: U811.3 (A1)
UDB10: U811.4 (A2)
UDB11: U811.5 (A3)
UDB12: U811.6 (A4)
UDB13: U811.7 (A5)
UDB14: U811.8 (A6)
UDB15: U811.9 (A7)
_AWE: U806.17 (B1)
_BB: U809.11 (B7)
_BR: U231.13
_BUFEN: U802.19 (CE), U803.19 (CE), U822.19 (CE), U823.19 (CE)
_CASL: U806.15 (B3)
_CASU: U806.14 (B4)
_CPULOCK: U809.15 (B3)
_DBR: U806.18 (B0)
_DRDEN: U810.19 (CE), U811.19 (CE)
_LVAWE: U806.3 (A1)
_LVBB: U809.9 (A7)
_LVBR: U231.11
_LVCASL: U806.5 (A3)
_LVCASU: U806.6 (A4)
_LVCPULOCK: U809.5 (A3)
_LVDBR: U806.2 (A0)
_LVRAS0: U807.9 (A7)
_LVRAS1: U807.8 (A6)
_LVSTOP: U809.6 (A4)
_LVTS: U809.7 (A5)
_RAS0: U807.11 (B7)
_RAS1: U807.12 (B6)
_STOP: U809.14 (B4)
_TS: U809.13 (B5)

Notes on the sheet:
BIDIRECTIONAL MC68040
BUS REQUEST
LOW VOLTAGE DATA BUFFERS
LOW VOLTAGE AGNUS SIGNALS
MOTOROLA BUS LOGIC
CHIPSET RAM DATA BUS BUFFER
LOW VOLTAGE ADDRESS BUFFERS
