AmigaPCI/AmigaPCI-MainBoard/KiCAD/AmigaPCI Mainboard-KiCAD REV 70/pci-bridge.kicad_sch

## KiCad design KiCAD/AmigaPCI Mainboard-KiCAD REV 70/pci-bridge.kicad_sch (2026-06-26)

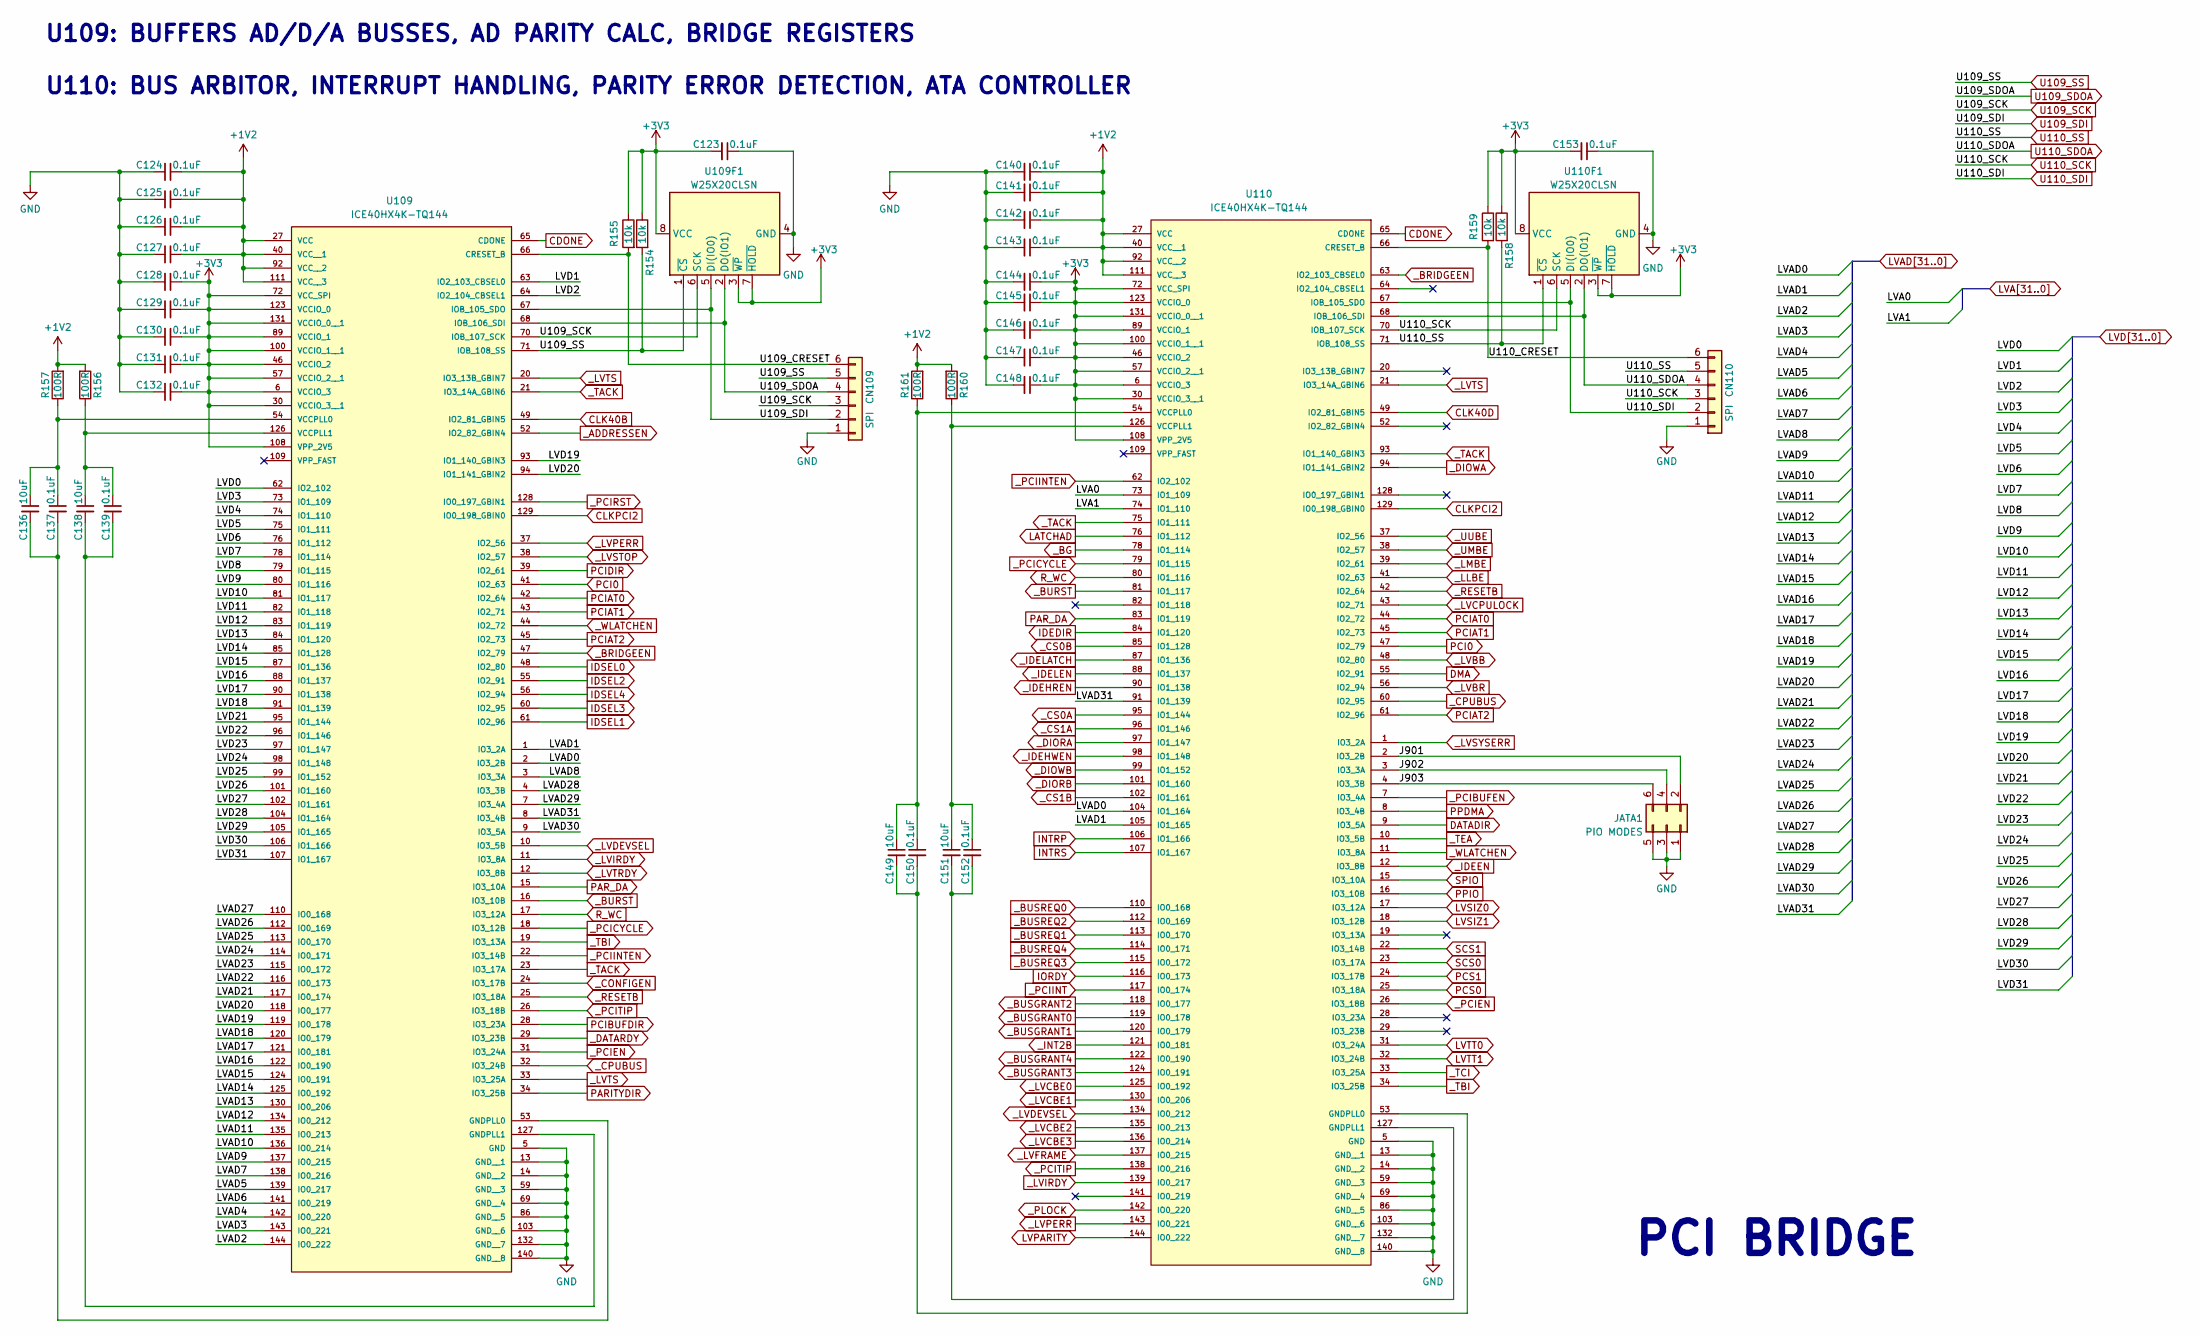
[picture p43: schematic pci-bridge.kicad_sch]

Parts:
C123, C124, C125, C126, C127, C128, C129, C130, C131, C132, C137, C139, C140, C141, C142, C143, C144, C145, C146, C147, C148, C150, C152, C153: 0.1uF; C_0603_1608Metric; LCSC C14663
C136, C138, C149, C151: 10uF; C_0603_1608Metric; LCSC C96446
CN109, CN110: SPI; PinHeader_1x06_P2.54mm_Vertical; LCSC C37208
JATA1: PIO MODES; PinHeader_2x03_P2.54mm_Vertical; LCSC C124384
R154, R155, R158, R159: 10k; R_0603_1608Metric; LCSC C25804
R156, R157, R160, R161: 100R; R_0603_1608Metric; LCSC C22775
U109, U110: ICE40HX4K-TQ144; LQFP-144_20x20mm_P0.5mm; LCSC C1521989
U109F1, U110F1: W25X20CLSN; SOIC-8_3.9x4.9mm_P1.27mm; LCSC C34591

Connections:
+1V2: C124.1, C125.1, C126.1, C127.1, C140.1, C141.1, C142.1, C143.1, R156.2, R157.2, R160.2, R161.2, U109.27 (VCC), U109.40 (VCC__1), U109.92 (VCC__2), U109.111 (VCC__3), U110.27 (VCC), U110.40 (VCC__1), U110.92 (VCC__2), U110.111 (VCC__3)
+3V3: C123.2, C128.1, C129.1, C130.1, C131.1, C132.1, C144.1, C145.1, C146.1, C147.1, C148.1, C153.2, R154.1, R155.1, R158.1, R159.1, U109.6 (VCCIO_3), U109.30 (VCCIO_3__1), U109.46 (VCCIO_2), U109.57 (VCCIO_2__1), U109.72 (VCC_SPI), U109.89 (VCCIO_1), U109.100 (VCCIO_1__1), U109.108 (VPP_2V5), U109.123 (VCCIO_0), U109.131 (VCCIO_0__1), U109F1.3 (~WP), U109F1.7 (~HOLD), U109F1.8 (VCC), U110.6 (VCCIO_3), U110.30 (VCCIO_3__1), U110.46 (VCCIO_2), U110.57 (VCCIO_2__1), U110.72 (VCC_SPI), U110.89 (VCCIO_1), U110.100 (VCCIO_1__1), U110.108 (VPP_2V5), U110.123 (VCCIO_0), U110.131 (VCCIO_0__1), U110F1.3 (~WP), U110F1.7 (~HOLD), U110F1.8 (VCC)
CDONE: U109.65 (CDONE), U110.65 (CDONE)
CLK40B: U109.49 (IO2_81_GBIN5)
CLK40D: U110.49 (IO2_81_GBIN5)
CLKPCI2: U109.129 (IO0_198_GBIN0), U110.129 (IO0_198_GBIN0)
DATADIR: U110.9 (IO3_5A)
DMA: U110.55 (IO2_91)
GND: C123.1, C124.2, C125.2, C126.2, C127.2, C128.2, C129.2, C130.2, C131.2, C132.2, C140.2, C141.2, C142.2, C143.2, C144.2, C145.2, C146.2, C147.2, C148.2, C153.1, CN109.1, CN110.1, JATA1.1, JATA1.3, JATA1.5, U109.5 (GND), U109.13 (GND__1), U109.14 (GND__2), U109.59 (GND__3), U109.69 (GND__4), U109.86 (GND__5), U109.103 (GND__6), U109.132 (GND__7), U109.140 (GND__8), U109F1.4 (GND), U110.5 (GND), U110.13 (GND__1), U110.14 (GND__2), U110.59 (GND__3), U110.69 (GND__4), U110.86 (GND__5), U110.103 (GND__6), U110.132 (GND__7), U110.140 (GND__8), U110F1.4 (GND)
IDEDIR: U110.84 (IO1_120)
IDSEL0: U109.48 (IO2_80)
IDSEL1: U109.61 (IO2_96)
IDSEL2: U109.55 (IO2_91)
IDSEL3: U109.60 (IO2_95)
IDSEL4: U109.56 (IO2_94)
INTRP: U110.106 (IO1_166)
INTRS: U110.107 (IO1_167)
IORDY: U110.116 (IO0_173)
J901: JATA1.2, U110.2 (IO3_2B)
J902: JATA1.4, U110.3 (IO3_3A)
J903: JATA1.6, U110.4 (IO3_3B)
LATCHAD: U110.76 (IO1_112)
LVA0: U110.73 (IO1_109)
LVA1: U110.74 (IO1_110)
LVAD0: U109.2 (IO3_2B), U110.104 (IO1_164)
LVAD1: U109.1 (IO3_2A), U110.105 (IO1_165)
LVAD2: U109.144 (IO0_222)
LVAD3: U109.143 (IO0_221)
LVAD4: U109.142 (IO0_220)
LVAD5: U109.139 (IO0_217)
LVAD6: U109.141 (IO0_219)
LVAD7: U109.138 (IO0_216)
LVAD8: U109.3 (IO3_3A)
LVAD9: U109.137 (IO0_215)
LVAD10: U109.136 (IO0_214)
LVAD11: U109.135 (IO0_213)
LVAD12: U109.134 (IO0_212)
LVAD13: U109.130 (IO0_206)
LVAD14: U109.125 (IO0_192)
LVAD15: U109.124 (IO0_191)
LVAD16: U109.122 (IO0_190)
LVAD17: U109.121 (IO0_181)
LVAD18: U109.120 (IO0_179)
LVAD19: U109.119 (IO0_178)
LVAD20: U109.118 (IO0_177)
LVAD21: U109.117 (IO0_174)
LVAD22: U109.116 (IO0_173)
LVAD23: U109.115 (IO0_172)
LVAD24: U109.114 (IO0_171)
LVAD25: U109.113 (IO0_170)
LVAD26: U109.112 (IO0_169)
LVAD27: U109.110 (IO0_168)
LVAD28: U109.4 (IO3_3B)
LVAD29: U109.7 (IO3_4A)
LVAD30: U109.9 (IO3_5A)
LVAD31: U109.8 (IO3_4B), U110.91 (IO1_139)
LVD0: U109.62 (IO2_102)
LVD1: U109.63 (IO2_103_CBSEL0)
LVD2: U109.64 (IO2_104_CBSEL1)
LVD3: U109.73 (IO1_109)
LVD4: U109.74 (IO1_110)
LVD5: U109.75 (IO1_111)
LVD6: U109.76 (IO1_112)
LVD7: U109.78 (IO1_114)
LVD8: U109.79 (IO1_115)
LVD9: U109.80 (IO1_116)
LVD10: U109.81 (IO1_117)
LVD11: U109.82 (IO1_118)
LVD12: U109.83 (IO1_119)
LVD13: U109.84 (IO1_120)
LVD14: U109.85 (IO1_128)
LVD15: U109.87 (IO1_136)
LVD16: U109.88 (IO1_137)
LVD17: U109.90 (IO1_138)
LVD18: U109.91 (IO1_139)
LVD19: U109.93 (IO1_140_GBIN3)
LVD20: U109.94 (IO1_141_GBIN2)
LVD21: U109.95 (IO1_144)
LVD22: U109.96 (IO1_146)
LVD23: U109.97 (IO1_147)
LVD24: U109.98 (IO1_148)
LVD25: U109.99 (IO1_152)
LVD26: U109.101 (IO1_160)
LVD27: U109.102 (IO1_161)
LVD28: U109.104 (IO1_164)
LVD29: U109.105 (IO1_165)
LVD30: U109.106 (IO1_166)
LVD31: U109.107 (IO1_167)
LVPARITY: U110.144 (IO0_222)
LVSIZ0: U110.17 (IO3_12A)
LVSIZ1: U110.18 (IO3_12B)
LVTT0: U110.31 (IO3_24A)
LVTT1: U110.32 (IO3_24B)
unnamed: C136.1, C137.1, R157.1, U109.54 (VCCPLL0)
unnamed: C136.2, C137.2, U109.53 (GNDPLL0)
unnamed: C138.1, C139.1, R156.1, U109.126 (VCCPLL1)
unnamed: C138.2, C139.2, U109.127 (GNDPLL1)
unnamed: C149.1, C150.1, R161.1, U110.54 (VCCPLL0)
unnamed: C149.2, C150.2, U110.53 (GNDPLL0)
unnamed: C151.1, C152.1, R160.1, U110.126 (VCCPLL1)
unnamed: C151.2, C152.2, U110.127 (GNDPLL1)
PARITYDIR: U109.34 (IO3_25B)
PAR_DA: U109.15 (IO3_10A), U110.83 (IO1_119)
PCI0: U109.41 (IO2_63), U110.47 (IO2_79)
PCIAT0: U109.42 (IO2_64), U110.44 (IO2_72)
PCIAT1: U109.43 (IO2_71), U110.45 (IO2_73)
PCIAT2: U109.45 (IO2_73), U110.61 (IO2_96)
PCIBUFDIR: U109.28 (IO3_23A)
PCIDIR: U109.39 (IO2_61)
PCS0: U110.25 (IO3_18A)
PCS1: U110.24 (IO3_17B)
PPDMA: U110.8 (IO3_4B)
PPIO: U110.16 (IO3_10B)
R_WC: U109.17 (IO3_12A), U110.80 (IO1_116)
SCS0: U110.23 (IO3_17A)
SCS1: U110.22 (IO3_14B)
SPIO: U110.15 (IO3_10A)
U109_CRESET: CN109.6, R155.2, U109.66 (CRESET_B)
U109_SCK: CN109.3, U109.70 (IOB_107_SCK), U109F1.6 (SCK)
U109_SDI: CN109.2, U109.67 (IOB_105_SDO), U109F1.5 (DI(IO0))
U109_SDOA: CN109.4, U109.68 (IOB_106_SDI), U109F1.2 (DO(IO1))
U109_SS: CN109.5, R154.2, U109.71 (IOB_108_SS), U109F1.1 (~CS)
U110_CRESET: CN110.6, R159.2, U110.66 (CRESET_B)
U110_SCK: CN110.3, U110.70 (IOB_107_SCK), U110F1.6 (SCK)
U110_SDI: CN110.2, U110.67 (IOB_105_SDO), U110F1.5 (DI(IO0))
U110_SDOA: CN110.4, U110.68 (IOB_106_SDI), U110F1.2 (DO(IO1))
U110_SS: CN110.5, R158.2, U110.71 (IOB_108_SS), U110F1.1 (~CS)
_ADDRESSEN: U109.52 (IO2_82_GBIN4)
_BG: U110.78 (IO1_114)
_BRIDGEEN: U109.47 (IO2_79), U110.63 (IO2_103_CBSEL0)
_BURST: U109.16 (IO3_10B), U110.81 (IO1_117)
_BUSGRANT0: U110.119 (IO0_178)
_BUSGRANT1: U110.120 (IO0_179)
_BUSGRANT2: U110.118 (IO0_177)
_BUSGRANT3: U110.124 (IO0_191)
_BUSGRANT4: U110.122 (IO0_190)
_BUSREQ0: U110.110 (IO0_168)
_BUSREQ1: U110.113 (IO0_170)
_BUSREQ2: U110.112 (IO0_169)
_BUSREQ3: U110.115 (IO0_172)
_BUSREQ4: U110.114 (IO0_171)
_CONFIGEN: U109.24 (IO3_17B)
_CPUBUS: U109.32 (IO3_24B), U110.60 (IO2_95)
_CS0A: U110.95 (IO1_144)
_CS0B: U110.85 (IO1_128)
_CS1A: U110.96 (IO1_146)
_CS1B: U110.102 (IO1_161)
_DATARDY: U109.29 (IO3_23B)
_DIORA: U110.97 (IO1_147)
_DIORB: U110.101 (IO1_160)
_DIOWA: U110.94 (IO1_141_GBIN2)
_DIOWB: U110.99 (IO1_152)
_IDEEN: U110.12 (IO3_8B)
_IDEHREN: U110.90 (IO1_138)
_IDEHWEN: U110.98 (IO1_148)
_IDELATCH: U110.87 (IO1_136)
_IDELEN: U110.88 (IO1_137)
_INT2B: U110.121 (IO0_181)
_LLBE: U110.41 (IO2_63)
_LMBE: U110.39 (IO2_61)
_LVBB: U110.48 (IO2_80)
_LVBR: U110.56 (IO2_94)
_LVCBE0: U110.125 (IO0_192)
_LVCBE1: U110.130 (IO0_206)
_LVCBE2: U110.135 (IO0_213)
_LVCBE3: U110.136 (IO0_214)
_LVCPULOCK: U110.43 (IO2_71)
_LVDEVSEL: U109.10 (IO3_5B), U110.134 (IO0_212)
_LVFRAME: U110.137 (IO0_215)
_LVIRDY: U109.11 (IO3_8A), U110.139 (IO0_217)
_LVPERR: U109.37 (IO2_56), U110.143 (IO0_221)
_LVSTOP: U109.38 (IO2_57)
_LVSYSERR: U110.1 (IO3_2A)
_LVTRDY: U109.12 (IO3_8B)
_LVTS: U109.20 (IO3_13B_GBIN7), U109.33 (IO3_25A), U110.21 (IO3_14A_GBIN6)
_PCIBUFEN: U110.7 (IO3_4A)
_PCICYCLE: U109.18 (IO3_12B), U110.79 (IO1_115)
_PCIEN: U109.31 (IO3_24A), U110.26 (IO3_18B)
_PCIINT: U110.117 (IO0_174)
_PCIINTEN: U109.22 (IO3_14B), U110.62 (IO2_102)
_PCIRST: U109.128 (IO0_197_GBIN1)
_PCITIP: U109.26 (IO3_18B), U110.138 (IO0_216)
_PLOCK: U110.142 (IO0_220)
_RESETB: U109.25 (IO3_18A), U110.42 (IO2_64)
_TACK: U109.21 (IO3_14A_GBIN6), U109.23 (IO3_17A), U110.75 (IO1_111), U110.93 (IO1_140_GBIN3)
_TBI: U109.19 (IO3_13A), U110.34 (IO3_25B)
_TCI: U110.33 (IO3_25A)
_TEA: U110.10 (IO3_5B)
_UMBE: U110.38 (IO2_57)
_UUBE: U110.37 (IO2_56)
_WLATCHEN: U109.44 (IO2_72), U110.11 (IO3_8A)

Notes on the sheet:
PCI BRIDGE
U109: BUFFERS AD/D/A BUSSES, AD PARITY CALC, BRIDGE REGISTERS U110: BUS ARBITOR, INTERRUPT HANDLING, PARITY ERROR DETECTION, ATA CONTROLLER
