AmigaPCI/AmigaPCI-MainBoard/KiCAD/AmigaPCI Mainboard-KiCAD REV 70/pci_bus_logic.kicad_sch

## KiCad design KiCAD/AmigaPCI Mainboard-KiCAD REV 70/pci_bus_logic.kicad_sch (2026-06-26)

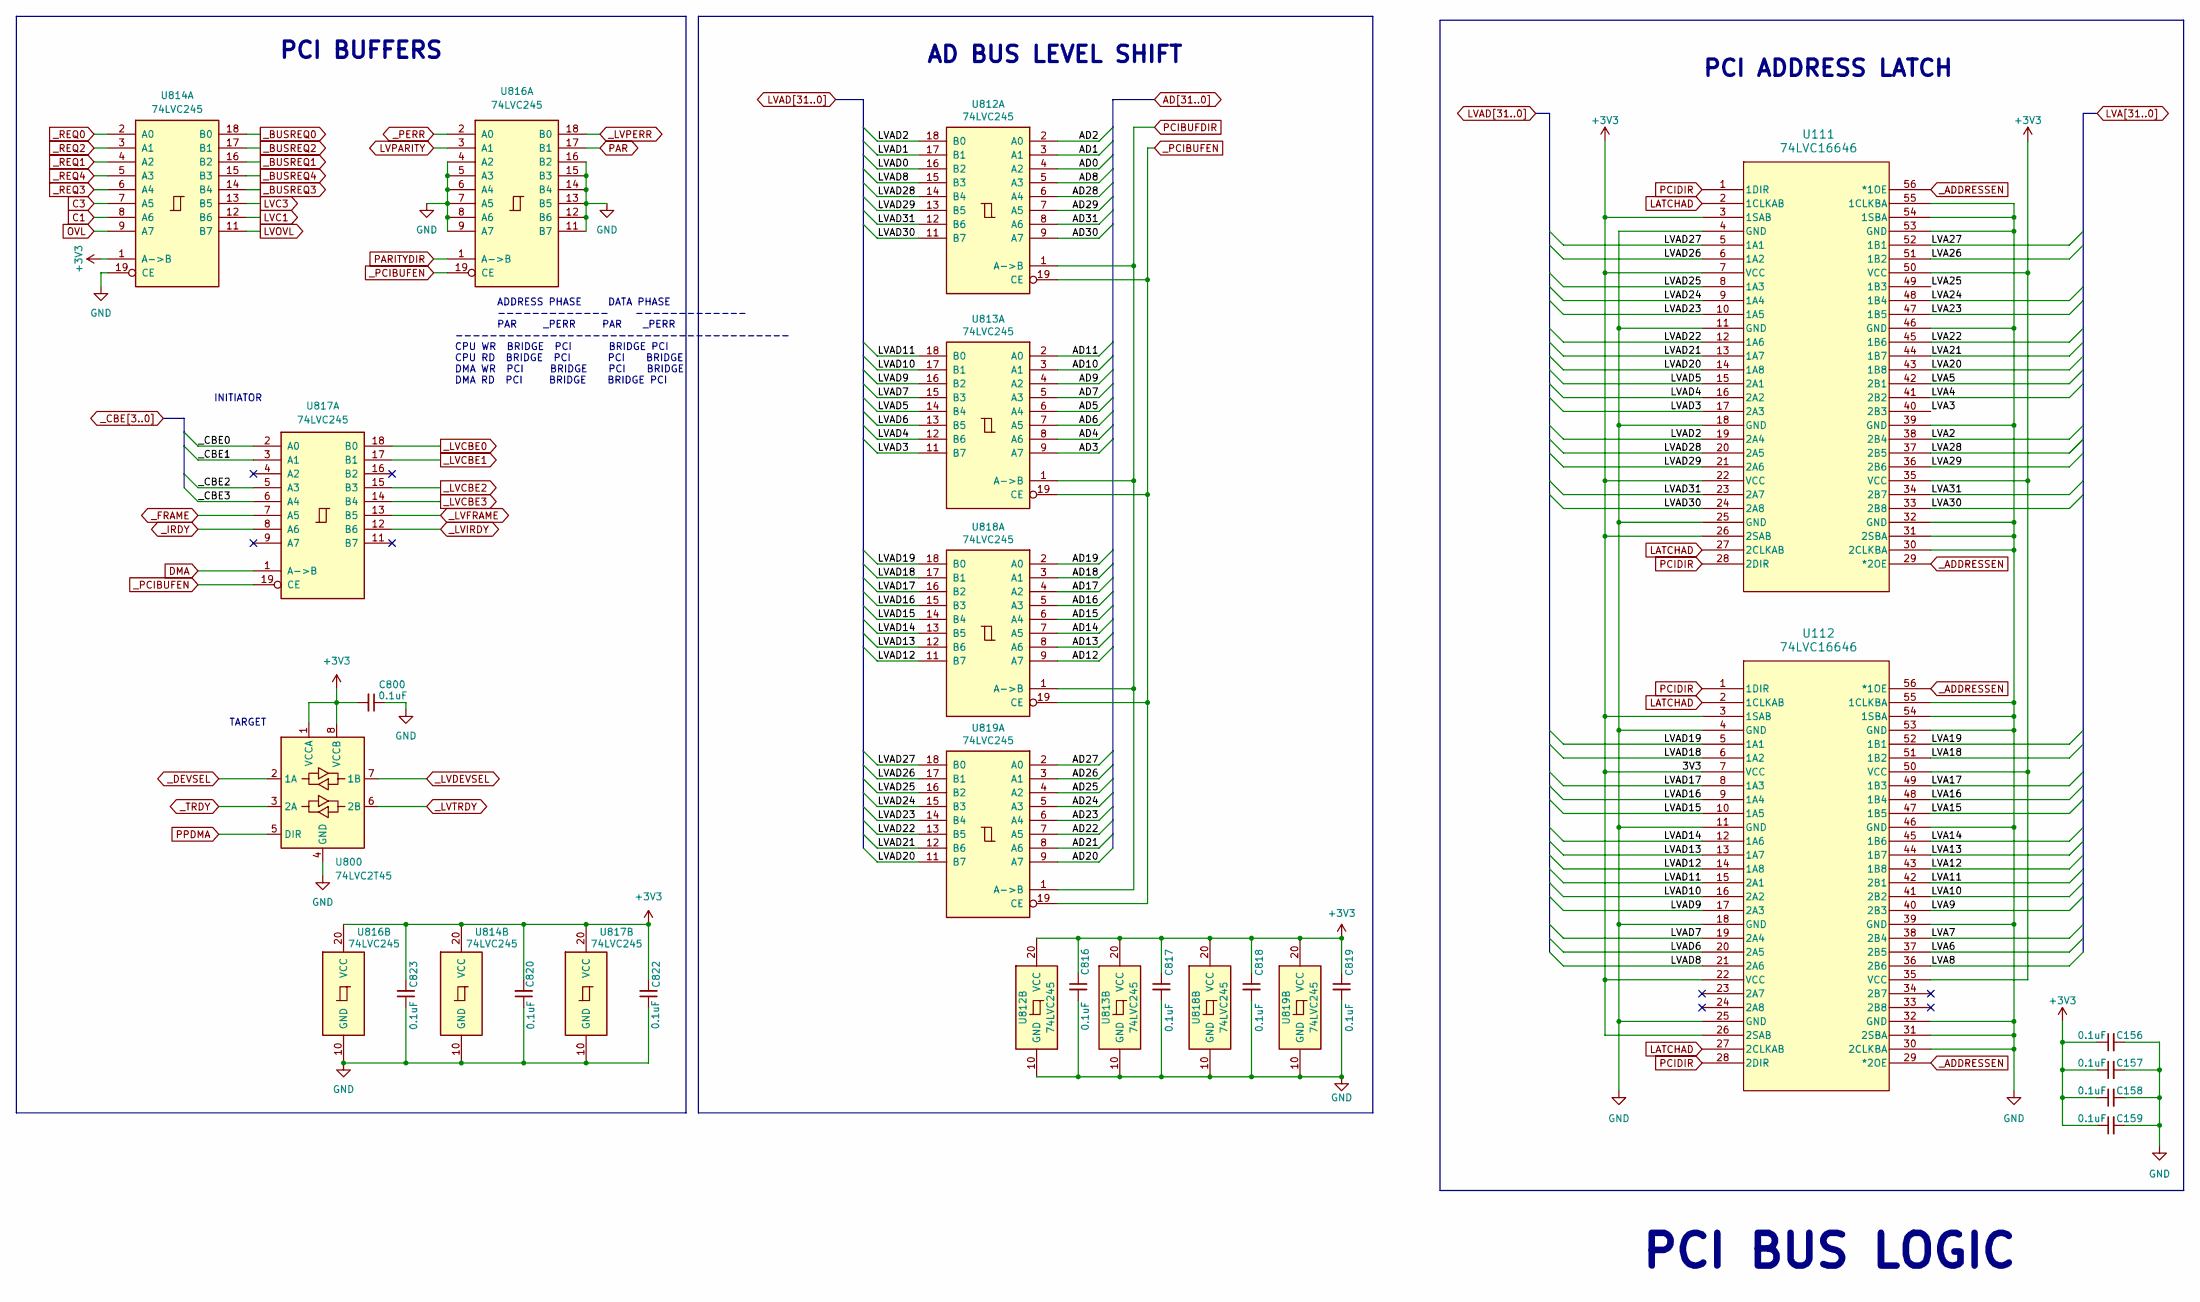
[picture p44: schematic pci_bus_logic.kicad_sch]

Parts:
C156, C157, C158, C159, C800, C816, C817, C818, C819, C820, C822, C823: 0.1uF; C_0603_1608Metric; LCSC C14663
U111, U112: 74LVC16646; SSOP-56_7.5x18.5mm_P0.635mm; LCSC C2869631
U800: 74LVC2T45; VSSOP-8_2.3x2mm_P0.5mm; LCSC C15741
U812, U813, U814, U816, U817, U818, U819: 74LVC245; TSSOP-20_4.4x6.5mm_P0.65mm; LCSC C7848

Connections:
+3V3: C156.1, C157.1, C158.1, C159.1, C800.2, C816.1, C817.1, C818.1, C819.1, C820.2, C822.2, C823.2, U111.3 (1SAB), U111.7 (VCC), U111.22 (VCC), U111.26 (2SAB), U111.35 (VCC), U111.50 (VCC), U112.3 (1SAB), U112.7 (VCC), U112.22 (VCC), U112.26 (2SAB), U112.35 (VCC), U112.50 (VCC), U800.1 (VCCA), U800.8 (VCCB), U812.20 (VCC), U813.20 (VCC), U814.1 (A->B), U814.20 (VCC), U816.20 (VCC), U817.20 (VCC), U818.20 (VCC), U819.20 (VCC)
AD0: U812.4 (A2)
AD1: U812.3 (A1)
AD2: U812.2 (A0)
AD3: U813.9 (A7)
AD4: U813.8 (A6)
AD5: U813.6 (A4)
AD6: U813.7 (A5)
AD7: U813.5 (A3)
AD8: U812.5 (A3)
AD9: U813.4 (A2)
AD10: U813.3 (A1)
AD11: U813.2 (A0)
AD12: U818.9 (A7)
AD13: U818.8 (A6)
AD14: U818.7 (A5)
AD15: U818.6 (A4)
AD16: U818.5 (A3)
AD17: U818.4 (A2)
AD18: U818.3 (A1)
AD19: U818.2 (A0)
AD20: U819.9 (A7)
AD21: U819.8 (A6)
AD22: U819.7 (A5)
AD23: U819.6 (A4)
AD24: U819.5 (A3)
AD25: U819.4 (A2)
AD26: U819.3 (A1)
AD27: U819.2 (A0)
AD28: U812.6 (A4)
AD29: U812.7 (A5)
AD30: U812.9 (A7)
AD31: U812.8 (A6)
C1: U814.8 (A6)
C3: U814.7 (A5)
DMA: U817.1 (A->B)
GND: C156.2, C157.2, C158.2, C159.2, C800.1, C816.2, C817.2, C818.2, C819.2, C820.1, C822.1, C823.1, U111.4 (GND), U111.11 (GND), U111.18 (GND), U111.25 (GND), U111.30 (2CLKBA), U111.31 (2SBA), U111.32 (GND), U111.39 (GND), U111.46 (GND), U111.53 (GND), U111.54 (1SBA), U111.55 (1CLKBA), U112.4 (GND), U112.11 (GND), U112.18 (GND), U112.25 (GND), U112.30 (2CLKBA), U112.31 (2SBA), U112.32 (GND), U112.39 (GND), U112.46 (GND), U112.53 (GND), U112.54 (1SBA), U112.55 (1CLKBA), U800.4 (GND), U812.10 (GND), U813.10 (GND), U814.10 (GND), U814.19 (CE), U816.4 (A2), U816.5 (A3), U816.6 (A4), U816.7 (A5), U816.8 (A6), U816.9 (A7), U816.10 (GND), U816.11 (B7), U816.12 (B6), U816.13 (B5), U816.14 (B4), U816.15 (B3), U816.16 (B2), U817.10 (GND), U818.10 (GND), U819.10 (GND)
LATCHAD: U111.2 (1CLKAB), U111.27 (2CLKAB), U112.2 (1CLKAB), U112.27 (2CLKAB)
LVA2: U111.38 (2B4)
LVA3: U111.40 (2B3)
LVA4: U111.41 (2B2)
LVA5: U111.42 (2B1)
LVA6: U112.37 (2B5)
LVA7: U112.38 (2B4)
LVA8: U112.36 (2B6)
LVA9: U112.40 (2B3)
LVA10: U112.41 (2B2)
LVA11: U112.42 (2B1)
LVA12: U112.43 (1B8)
LVA13: U112.44 (1B7)
LVA14: U112.45 (1B6)
LVA15: U112.47 (1B5)
LVA16: U112.48 (1B4)
LVA17: U112.49 (1B3)
LVA18: U112.51 (1B2)
LVA19: U112.52 (1B1)
LVA20: U111.43 (1B8)
LVA21: U111.44 (1B7)
LVA22: U111.45 (1B6)
LVA23: U111.47 (1B5)
LVA24: U111.48 (1B4)
LVA25: U111.49 (1B3)
LVA26: U111.51 (1B2)
LVA27: U111.52 (1B1)
LVA28: U111.37 (2B5)
LVA29: U111.36 (2B6)
LVA30: U111.33 (2B8)
LVA31: U111.34 (2B7)
LVAD0: U812.16 (B2)
LVAD1: U812.17 (B1)
LVAD2: U111.19 (2A4), U812.18 (B0)
LVAD3: U111.17 (2A3), U813.11 (B7)
LVAD4: U111.16 (2A2), U813.12 (B6)
LVAD5: U111.15 (2A1), U813.14 (B4)
LVAD6: U112.20 (2A5), U813.13 (B5)
LVAD7: U112.19 (2A4), U813.15 (B3)
LVAD8: U112.21 (2A6), U812.15 (B3)
LVAD9: U112.17 (2A3), U813.16 (B2)
LVAD10: U112.16 (2A2), U813.17 (B1)
LVAD11: U112.15 (2A1), U813.18 (B0)
LVAD12: U112.14 (1A8), U818.11 (B7)
LVAD13: U112.13 (1A7), U818.12 (B6)
LVAD14: U112.12 (1A6), U818.13 (B5)
LVAD15: U112.10 (1A5), U818.14 (B4)
LVAD16: U112.9 (1A4), U818.15 (B3)
LVAD17: U112.8 (1A3), U818.16 (B2)
LVAD18: U112.6 (1A2), U818.17 (B1)
LVAD19: U112.5 (1A1), U818.18 (B0)
LVAD20: U111.14 (1A8), U819.11 (B7)
LVAD21: U111.13 (1A7), U819.12 (B6)
LVAD22: U111.12 (1A6), U819.13 (B5)
LVAD23: U111.10 (1A5), U819.14 (B4)
LVAD24: U111.9 (1A4), U819.15 (B3)
LVAD25: U111.8 (1A3), U819.16 (B2)
LVAD26: U111.6 (1A2), U819.17 (B1)
LVAD27: U111.5 (1A1), U819.18 (B0)
LVAD28: U111.20 (2A5), U812.14 (B4)
LVAD29: U111.21 (2A6), U812.13 (B5)
LVAD30: U111.24 (2A8), U812.11 (B7)
LVAD31: U111.23 (2A7), U812.12 (B6)
LVC1: U814.12 (B6)
LVC3: U814.13 (B5)
LVOVL: U814.11 (B7)
LVPARITY: U816.3 (A1)
OVL: U814.9 (A7)
PAR: U816.17 (B1)
PARITYDIR: U816.1 (A->B)
PCIBUFDIR: U812.1 (A->B), U813.1 (A->B), U818.1 (A->B), U819.1 (A->B)
PCIDIR: U111.1 (1DIR), U111.28 (2DIR), U112.1 (1DIR), U112.28 (2DIR)
PPDMA: U800.5 (DIR)
_ADDRESSEN: U111.29 (*2OE), U111.56 (*1OE), U112.29 (*2OE), U112.56 (*1OE)
_BUSREQ0: U814.18 (B0)
_BUSREQ1: U814.16 (B2)
_BUSREQ2: U814.17 (B1)
_BUSREQ3: U814.14 (B4)
_BUSREQ4: U814.15 (B3)
_CBE0: U817.2 (A0)
_CBE1: U817.3 (A1)
_CBE2: U817.5 (A3)
_CBE3: U817.6 (A4)
_DEVSEL: U800.2 (1A)
_FRAME: U817.7 (A5)
_IRDY: U817.8 (A6)
_LVCBE0: U817.18 (B0)
_LVCBE1: U817.17 (B1)
_LVCBE2: U817.15 (B3)
_LVCBE3: U817.14 (B4)
_LVDEVSEL: U800.7 (1B)
_LVFRAME: U817.13 (B5)
_LVIRDY: U817.12 (B6)
_LVPERR: U816.18 (B0)
_LVTRDY: U800.6 (2B)
_PCIBUFEN: U812.19 (CE), U813.19 (CE), U816.19 (CE), U817.19 (CE), U818.19 (CE), U819.19 (CE)
_PERR: U816.2 (A0)
_REQ0: U814.2 (A0)
_REQ1: U814.4 (A2)
_REQ2: U814.3 (A1)
_REQ3: U814.6 (A4)
_REQ4: U814.5 (A3)
_TRDY: U800.3 (2A)

Notes on the sheet:
PCI BUS LOGIC
PCI ADDRESS LATCH
PCI BUFFERS
ADDRESS PHASE DATA PHASE ------------- ------------- PAR _PERR PAR _PERR --------------------------------------- CPU WR BRIDGE PCI BRIDGE PCI CPU RD BRIDGE PCI PCI BRIDGE DMA WR PCI BRIDGE PCI BRIDGE DMA RD PCI BRIDGE BRIDGE PCI
TARGET
INITIATOR
AD BUS LEVEL SHIFT
