AmigaPCI/AmigaPCI-MainBoard/KiCAD/AmigaPCI Mainboard-KiCAD REV 70/pcibus.kicad_sch

## KiCad design KiCAD/AmigaPCI Mainboard-KiCAD REV 70/pcibus.kicad_sch (2026-06-26)

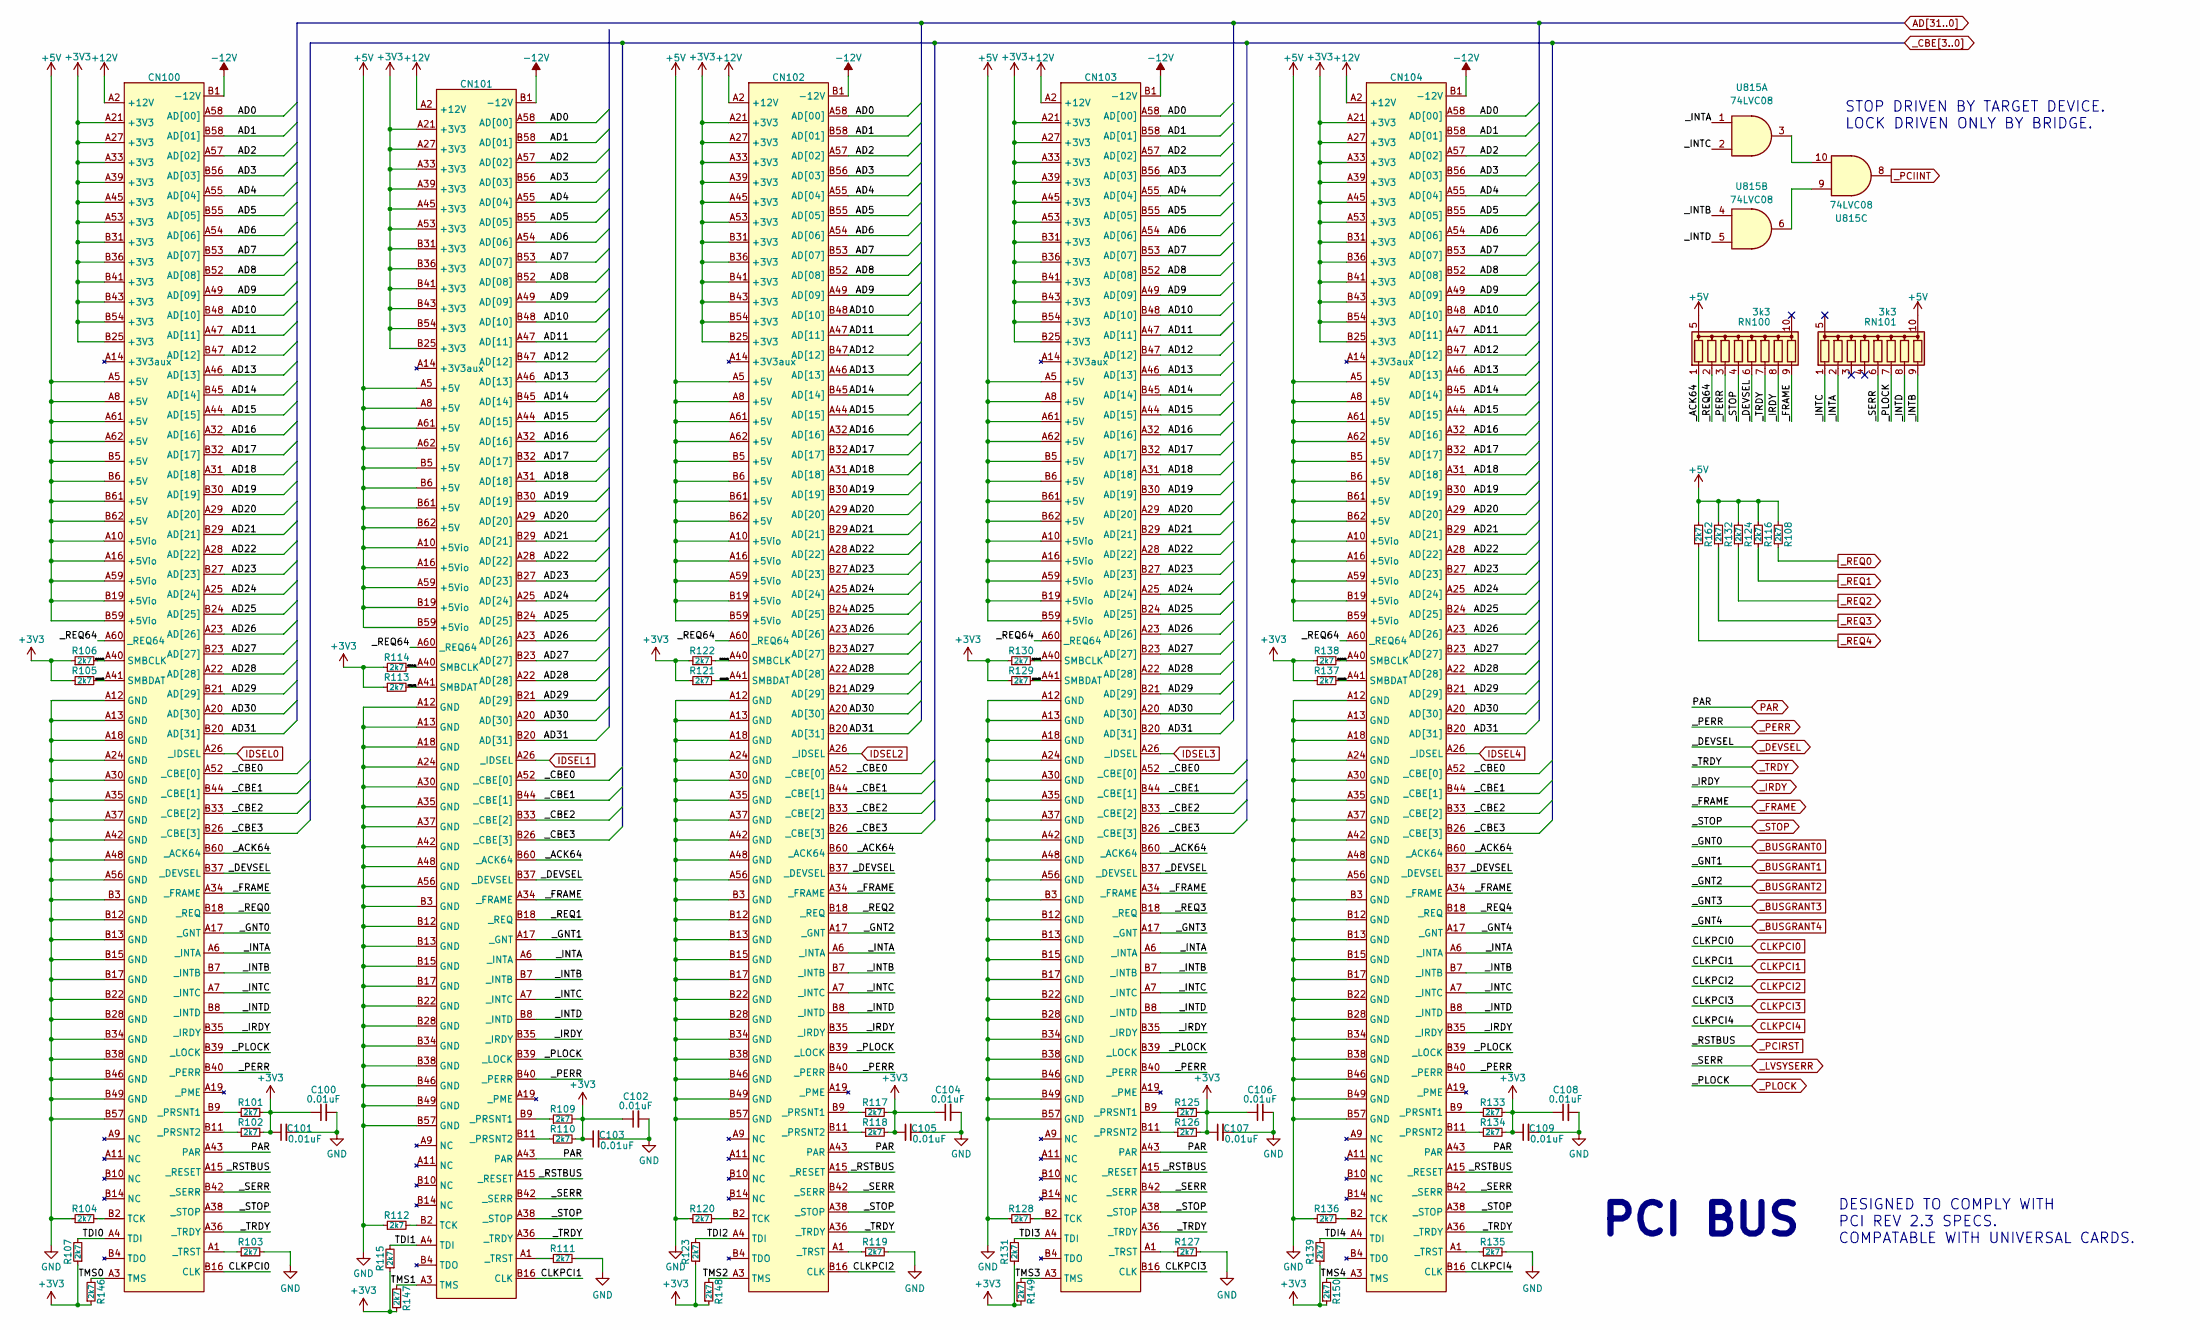
[picture p45: schematic pcibus.kicad_sch]

Parts:
C100, C101, C102, C103, C104, C105, C106, C107, C108, C109: 0.01uF; C_0603_1608Metric; LCSC C57112
CN100, CN101, CN102, CN103, CN104: PCI32-5V; PCI-5V; LCSC C573970
R101, R102, R103, R104, R105, R106, R107, R108, R109, R110, R111, R112, R113, R114, R115, R116, R117, R118, R119, R120, R121, R122, R123, R124, R125, R126, R127, R128, R129, R130, R131, R132, R133, R134, R135, R136, R137, R138, R139, R146, R147, R148, R149, R150, R162: 2k7; R_0603_1608Metric; LCSC C13167
RN100, RN101: 3k3; R_Array_Convex_5x0603; Part Number 746X101332JP; LCSC C1731077
U815: 74LVC08; TSSOP-14_4.4x5mm_P0.65mm; LCSC C6053

Connections:
+3V3: C100.1, C101.1, C102.1, C103.1, C104.1, C105.1, C106.1, C107.1, C108.1, C109.1, CN100.A21 (+3V3), CN100.A27 (+3V3), CN100.A33 (+3V3), CN100.A39 (+3V3), CN100.A45 (+3V3), CN100.A53 (+3V3), CN100.B25 (+3V3), CN100.B31 (+3V3), CN100.B36 (+3V3), CN100.B41 (+3V3), CN100.B43 (+3V3), CN100.B54 (+3V3), CN101.A21 (+3V3), CN101.A27 (+3V3), CN101.A33 (+3V3), CN101.A39 (+3V3), CN101.A45 (+3V3), CN101.A53 (+3V3), CN101.B25 (+3V3), CN101.B31 (+3V3), CN101.B36 (+3V3), CN101.B41 (+3V3), CN101.B43 (+3V3), CN101.B54 (+3V3), CN102.A21 (+3V3), CN102.A27 (+3V3), CN102.A33 (+3V3), CN102.A39 (+3V3), CN102.A45 (+3V3), CN102.A53 (+3V3), CN102.B25 (+3V3), CN102.B31 (+3V3), CN102.B36 (+3V3), CN102.B41 (+3V3), CN102.B43 (+3V3), CN102.B54 (+3V3), CN103.A21 (+3V3), CN103.A27 (+3V3), CN103.A33 (+3V3), CN103.A39 (+3V3), CN103.A45 (+3V3), CN103.A53 (+3V3), CN103.B25 (+3V3), CN103.B31 (+3V3), CN103.B36 (+3V3), CN103.B41 (+3V3), CN103.B43 (+3V3), CN103.B54 (+3V3), CN104.A21 (+3V3), CN104.A27 (+3V3), CN104.A33 (+3V3), CN104.A39 (+3V3), CN104.A45 (+3V3), CN104.A53 (+3V3), CN104.B25 (+3V3), CN104.B31 (+3V3), CN104.B36 (+3V3), CN104.B41 (+3V3), CN104.B43 (+3V3), CN104.B54 (+3V3), R101.2, R102.2, R105.1, R106.1, R107.1, R109.2, R110.2, R113.1, R114.1, R115.1, R117.2, R118.2, R121.1, R122.1, R123.1, R125.2, R126.2, R129.1, R130.1, R131.1, R133.2, R134.2, R137.1, R138.1, R139.1, R146.1, R147.1, R148.1, R149.1, R150.1
+5V: CN100.A5 (+5V), CN100.A8 (+5V), CN100.A10 (+5Vio), CN100.A16 (+5Vio), CN100.A59 (+5Vio), CN100.A61 (+5V), CN100.A62 (+5V), CN100.B5 (+5V), CN100.B6 (+5V), CN100.B19 (+5Vio), CN100.B59 (+5Vio), CN100.B61 (+5V), CN100.B62 (+5V), CN101.A5 (+5V), CN101.A8 (+5V), CN101.A10 (+5Vio), CN101.A16 (+5Vio), CN101.A59 (+5Vio), CN101.A61 (+5V), CN101.A62 (+5V), CN101.B5 (+5V), CN101.B6 (+5V), CN101.B19 (+5Vio), CN101.B59 (+5Vio), CN101.B61 (+5V), CN101.B62 (+5V), CN102.A5 (+5V), CN102.A8 (+5V), CN102.A10 (+5Vio), CN102.A16 (+5Vio), CN102.A59 (+5Vio), CN102.A61 (+5V), CN102.A62 (+5V), CN102.B5 (+5V), CN102.B6 (+5V), CN102.B19 (+5Vio), CN102.B59 (+5Vio), CN102.B61 (+5V), CN102.B62 (+5V), CN103.A5 (+5V), CN103.A8 (+5V), CN103.A10 (+5Vio), CN103.A16 (+5Vio), CN103.A59 (+5Vio), CN103.A61 (+5V), CN103.A62 (+5V), CN103.B5 (+5V), CN103.B6 (+5V), CN103.B19 (+5Vio), CN103.B59 (+5Vio), CN103.B61 (+5V), CN103.B62 (+5V), CN104.A5 (+5V), CN104.A8 (+5V), CN104.A10 (+5Vio), CN104.A16 (+5Vio), CN104.A59 (+5Vio), CN104.A61 (+5V), CN104.A62 (+5V), CN104.B5 (+5V), CN104.B6 (+5V), CN104.B19 (+5Vio), CN104.B59 (+5Vio), CN104.B61 (+5V), CN104.B62 (+5V), R108.2, R116.2, R124.2, R132.2, R162.2, RN100.5 (common), RN101.10 (common)
+12V: CN100.A2 (+12V), CN101.A2 (+12V), CN102.A2 (+12V), CN103.A2 (+12V), CN104.A2 (+12V)
-12V: CN100.B1 (-12V), CN101.B1 (-12V), CN102.B1 (-12V), CN103.B1 (-12V), CN104.B1 (-12V)
AD0: CN100.A58 (AD[00]), CN101.A58 (AD[00]), CN102.A58 (AD[00]), CN103.A58 (AD[00]), CN104.A58 (AD[00])
AD1: CN100.B58 (AD[01]), CN101.B58 (AD[01]), CN102.B58 (AD[01]), CN103.B58 (AD[01]), CN104.B58 (AD[01])
AD2: CN100.A57 (AD[02]), CN101.A57 (AD[02]), CN102.A57 (AD[02]), CN103.A57 (AD[02]), CN104.A57 (AD[02])
AD3: CN100.B56 (AD[03]), CN101.B56 (AD[03]), CN102.B56 (AD[03]), CN103.B56 (AD[03]), CN104.B56 (AD[03])
AD4: CN100.A55 (AD[04]), CN101.A55 (AD[04]), CN102.A55 (AD[04]), CN103.A55 (AD[04]), CN104.A55 (AD[04])
AD5: CN100.B55 (AD[05]), CN101.B55 (AD[05]), CN102.B55 (AD[05]), CN103.B55 (AD[05]), CN104.B55 (AD[05])
AD6: CN100.A54 (AD[06]), CN101.A54 (AD[06]), CN102.A54 (AD[06]), CN103.A54 (AD[06]), CN104.A54 (AD[06])
AD7: CN100.B53 (AD[07]), CN101.B53 (AD[07]), CN102.B53 (AD[07]), CN103.B53 (AD[07]), CN104.B53 (AD[07])
AD8: CN100.B52 (AD[08]), CN101.B52 (AD[08]), CN102.B52 (AD[08]), CN103.B52 (AD[08]), CN104.B52 (AD[08])
AD9: CN100.A49 (AD[09]), CN101.A49 (AD[09]), CN102.A49 (AD[09]), CN103.A49 (AD[09]), CN104.A49 (AD[09])
AD10: CN100.B48 (AD[10]), CN101.B48 (AD[10]), CN102.B48 (AD[10]), CN103.B48 (AD[10]), CN104.B48 (AD[10])
AD11: CN100.A47 (AD[11]), CN101.A47 (AD[11]), CN102.A47 (AD[11]), CN103.A47 (AD[11]), CN104.A47 (AD[11])
AD12: CN100.B47 (AD[12]), CN101.B47 (AD[12]), CN102.B47 (AD[12]), CN103.B47 (AD[12]), CN104.B47 (AD[12])
AD13: CN100.A46 (AD[13]), CN101.A46 (AD[13]), CN102.A46 (AD[13]), CN103.A46 (AD[13]), CN104.A46 (AD[13])
AD14: CN100.B45 (AD[14]), CN101.B45 (AD[14]), CN102.B45 (AD[14]), CN103.B45 (AD[14]), CN104.B45 (AD[14])
AD15: CN100.A44 (AD[15]), CN101.A44 (AD[15]), CN102.A44 (AD[15]), CN103.A44 (AD[15]), CN104.A44 (AD[15])
AD16: CN100.A32 (AD[16]), CN101.A32 (AD[16]), CN102.A32 (AD[16]), CN103.A32 (AD[16]), CN104.A32 (AD[16])
AD17: CN100.B32 (AD[17]), CN101.B32 (AD[17]), CN102.B32 (AD[17]), CN103.B32 (AD[17]), CN104.B32 (AD[17])
AD18: CN100.A31 (AD[18]), CN101.A31 (AD[18]), CN102.A31 (AD[18]), CN103.A31 (AD[18]), CN104.A31 (AD[18])
AD19: CN100.B30 (AD[19]), CN101.B30 (AD[19]), CN102.B30 (AD[19]), CN103.B30 (AD[19]), CN104.B30 (AD[19])
AD20: CN100.A29 (AD[20]), CN101.A29 (AD[20]), CN102.A29 (AD[20]), CN103.A29 (AD[20]), CN104.A29 (AD[20])
AD21: CN100.B29 (AD[21]), CN101.B29 (AD[21]), CN102.B29 (AD[21]), CN103.B29 (AD[21]), CN104.B29 (AD[21])
AD22: CN100.A28 (AD[22]), CN101.A28 (AD[22]), CN102.A28 (AD[22]), CN103.A28 (AD[22]), CN104.A28 (AD[22])
AD23: CN100.B27 (AD[23]), CN101.B27 (AD[23]), CN102.B27 (AD[23]), CN103.B27 (AD[23]), CN104.B27 (AD[23])
AD24: CN100.A25 (AD[24]), CN101.A25 (AD[24]), CN102.A25 (AD[24]), CN103.A25 (AD[24]), CN104.A25 (AD[24])
AD25: CN100.B24 (AD[25]), CN101.B24 (AD[25]), CN102.B24 (AD[25]), CN103.B24 (AD[25]), CN104.B24 (AD[25])
AD26: CN100.A23 (AD[26]), CN101.A23 (AD[26]), CN102.A23 (AD[26]), CN103.A23 (AD[26]), CN104.A23 (AD[26])
AD27: CN100.B23 (AD[27]), CN101.B23 (AD[27]), CN102.B23 (AD[27]), CN103.B23 (AD[27]), CN104.B23 (AD[27])
AD28: CN100.A22 (AD[28]), CN101.A22 (AD[28]), CN102.A22 (AD[28]), CN103.A22 (AD[28]), CN104.A22 (AD[28])
AD29: CN100.B21 (AD[29]), CN101.B21 (AD[29]), CN102.B21 (AD[29]), CN103.B21 (AD[29]), CN104.B21 (AD[29])
AD30: CN100.A20 (AD[30]), CN101.A20 (AD[30]), CN102.A20 (AD[30]), CN103.A20 (AD[30]), CN104.A20 (AD[30])
AD31: CN100.B20 (AD[31]), CN101.B20 (AD[31]), CN102.B20 (AD[31]), CN103.B20 (AD[31]), CN104.B20 (AD[31])
CLKPCI0: CN100.B16 (CLK)
CLKPCI1: CN101.B16 (CLK)
CLKPCI2: CN102.B16 (CLK)
CLKPCI3: CN103.B16 (CLK)
CLKPCI4: CN104.B16 (CLK)
GND: C100.2, C101.2, C102.2, C103.2, C104.2, C105.2, C106.2, C107.2, C108.2, C109.2, CN100.A12 (GND), CN100.A13 (GND), CN100.A18 (GND), CN100.A24 (GND), CN100.A30 (GND), CN100.A35 (GND), CN100.A37 (GND), CN100.A42 (GND), CN100.A48 (GND), CN100.A56 (GND), CN100.B3 (GND), CN100.B12 (GND), CN100.B13 (GND), CN100.B15 (GND), CN100.B17 (GND), CN100.B22 (GND), CN100.B28 (GND), CN100.B34 (GND), CN100.B38 (GND), CN100.B46 (GND), CN100.B49 (GND), CN100.B57 (GND), CN101.A12 (GND), CN101.A13 (GND), CN101.A18 (GND), CN101.A24 (GND), CN101.A30 (GND), CN101.A35 (GND), CN101.A37 (GND), CN101.A42 (GND), CN101.A48 (GND), CN101.A56 (GND), CN101.B3 (GND), CN101.B12 (GND), CN101.B13 (GND), CN101.B15 (GND), CN101.B17 (GND), CN101.B22 (GND), CN101.B28 (GND), CN101.B34 (GND), CN101.B38 (GND), CN101.B46 (GND), CN101.B49 (GND), CN101.B57 (GND), CN102.A12 (GND), CN102.A13 (GND), CN102.A18 (GND), CN102.A24 (GND), CN102.A30 (GND), CN102.A35 (GND), CN102.A37 (GND), CN102.A42 (GND), CN102.A48 (GND), CN102.A56 (GND), CN102.B3 (GND), CN102.B12 (GND), CN102.B13 (GND), CN102.B15 (GND), CN102.B17 (GND), CN102.B22 (GND), CN102.B28 (GND), CN102.B34 (GND), CN102.B38 (GND), CN102.B46 (GND), CN102.B49 (GND), CN102.B57 (GND), CN103.A12 (GND), CN103.A13 (GND), CN103.A18 (GND), CN103.A24 (GND), CN103.A30 (GND), CN103.A35 (GND), CN103.A37 (GND), CN103.A42 (GND), CN103.A48 (GND), CN103.A56 (GND), CN103.B3 (GND), CN103.B12 (GND), CN103.B13 (GND), CN103.B15 (GND), CN103.B17 (GND), CN103.B22 (GND), CN103.B28 (GND), CN103.B34 (GND), CN103.B38 (GND), CN103.B46 (GND), CN103.B49 (GND), CN103.B57 (GND), CN104.A12 (GND), CN104.A13 (GND), CN104.A18 (GND), CN104.A24 (GND), CN104.A30 (GND), CN104.A35 (GND), CN104.A37 (GND), CN104.A42 (GND), CN104.A48 (GND), CN104.A56 (GND), CN104.B3 (GND), CN104.B12 (GND), CN104.B13 (GND), CN104.B15 (GND), CN104.B17 (GND), CN104.B22 (GND), CN104.B28 (GND), CN104.B34 (GND), CN104.B38 (GND), CN104.B46 (GND), CN104.B49 (GND), CN104.B57 (GND), R103.2, R104.1, R111.2, R112.1, R119.2, R120.1, R127.2, R128.1, R135.2, R136.1
IDSEL0: CN100.A26 (_IDSEL)
IDSEL1: CN101.A26 (_IDSEL)
IDSEL2: CN102.A26 (_IDSEL)
IDSEL3: CN103.A26 (_IDSEL)
IDSEL4: CN104.A26 (_IDSEL)
unnamed: CN100.A1 (_TRST), R103.1
unnamed: CN100.B2 (TCK), R104.2
unnamed: CN100.B9 (_PRSNT1), R101.1
unnamed: CN100.B11 (_PRSNT2), R102.1
unnamed: CN101.A1 (_TRST), R111.1
unnamed: CN101.B2 (TCK), R112.2
unnamed: CN101.B9 (_PRSNT1), R109.1
unnamed: CN101.B11 (_PRSNT2), R110.1
unnamed: CN102.A1 (_TRST), R119.1
unnamed: CN102.B2 (TCK), R120.2
unnamed: CN102.B9 (_PRSNT1), R117.1
unnamed: CN102.B11 (_PRSNT2), R118.1
unnamed: CN103.A1 (_TRST), R127.1
unnamed: CN103.B2 (TCK), R128.2
unnamed: CN103.B9 (_PRSNT1), R125.1
unnamed: CN103.B11 (_PRSNT2), R126.1
unnamed: CN104.A1 (_TRST), R135.1
unnamed: CN104.B2 (TCK), R136.2
unnamed: CN104.B9 (_PRSNT1), R133.1
unnamed: CN104.B11 (_PRSNT2), R134.1
unnamed: U815.6, U815.9
unnamed: U815.3, U815.10
PAR: CN100.A43 (PAR), CN101.A43 (PAR), CN102.A43 (PAR), CN103.A43 (PAR), CN104.A43 (PAR)
SMBCLK0: CN100.A40 (SMBCLK), R106.2
SMBCLK1: CN101.A40 (SMBCLK), R114.2
SMBCLK2: CN102.A40 (SMBCLK), R122.2
SMBCLK3: CN103.A40 (SMBCLK), R130.2
SMBCLK4: CN104.A40 (SMBCLK), R138.2
SMBDAT0: CN100.A41 (SMBDAT), R105.2
SMBDAT1: CN101.A41 (SMBDAT), R113.2
SMBDAT2: CN102.A41 (SMBDAT), R121.2
SMBDAT3: CN103.A41 (SMBDAT), R129.2
SMBDAT4: CN104.A41 (SMBDAT), R137.2
TDI0: CN100.A4 (TDI), R107.2
TDI1: CN101.A4 (TDI), R115.2
TDI2: CN102.A4 (TDI), R123.2
TDI3: CN103.A4 (TDI), R131.2
TDI4: CN104.A4 (TDI), R139.2
TMS0: CN100.A3 (TMS), R146.2
TMS1: CN101.A3 (TMS), R147.2
TMS2: CN102.A3 (TMS), R148.2
TMS3: CN103.A3 (TMS), R149.2
TMS4: CN104.A3 (TMS), R150.2
_ACK64: CN100.B60 (_ACK64), CN101.B60 (_ACK64), CN102.B60 (_ACK64), CN103.B60 (_ACK64), CN104.B60 (_ACK64), RN100.1 (R1)
_BUSGRANT0: CN100.A17 (_GNT)
_BUSGRANT1: CN101.A17 (_GNT)
_BUSGRANT2: CN102.A17 (_GNT)
_BUSGRANT3: CN103.A17 (_GNT)
_BUSGRANT4: CN104.A17 (_GNT)
_CBE0: CN100.A52 (_CBE[0]), CN101.A52 (_CBE[0]), CN102.A52 (_CBE[0]), CN103.A52 (_CBE[0]), CN104.A52 (_CBE[0])
_CBE1: CN100.B44 (_CBE[1]), CN101.B44 (_CBE[1]), CN102.B44 (_CBE[1]), CN103.B44 (_CBE[1]), CN104.B44 (_CBE[1])
_CBE2: CN100.B33 (_CBE[2]), CN101.B33 (_CBE[2]), CN102.B33 (_CBE[2]), CN103.B33 (_CBE[2]), CN104.B33 (_CBE[2])
_CBE3: CN100.B26 (_CBE[3]), CN101.B26 (_CBE[3]), CN102.B26 (_CBE[3]), CN103.B26 (_CBE[3]), CN104.B26 (_CBE[3])
_DEVSEL: CN100.B37 (_DEVSEL), CN101.B37 (_DEVSEL), CN102.B37 (_DEVSEL), CN103.B37 (_DEVSEL), CN104.B37 (_DEVSEL), RN100.6 (R5)
_FRAME: CN100.A34 (_FRAME), CN101.A34 (_FRAME), CN102.A34 (_FRAME), CN103.A34 (_FRAME), CN104.A34 (_FRAME), RN100.9 (R8)
_INTA: CN100.A6 (_INTA), CN101.A6 (_INTA), CN102.A6 (_INTA), CN103.A6 (_INTA), CN104.A6 (_INTA), RN101.2 (R2), U815.1
_INTB: CN100.B7 (_INTB), CN101.B7 (_INTB), CN102.B7 (_INTB), CN103.B7 (_INTB), CN104.B7 (_INTB), RN101.9 (R8), U815.4
_INTC: CN100.A7 (_INTC), CN101.A7 (_INTC), CN102.A7 (_INTC), CN103.A7 (_INTC), CN104.A7 (_INTC), RN101.1 (R1), U815.2
_INTD: CN100.B8 (_INTD), CN101.B8 (_INTD), CN102.B8 (_INTD), CN103.B8 (_INTD), CN104.B8 (_INTD), RN101.8 (R7), U815.5
_IRDY: CN100.B35 (_IRDY), CN101.B35 (_IRDY), CN102.B35 (_IRDY), CN103.B35 (_IRDY), CN104.B35 (_IRDY), RN100.8 (R7)
_LVSYSERR: CN100.B42 (_SERR), CN101.B42 (_SERR), CN102.B42 (_SERR), CN103.B42 (_SERR), CN104.B42 (_SERR), RN101.6 (R5)
_PCIINT: U815.8
_PCIRST: CN100.A15 (_RESET), CN101.A15 (_RESET), CN102.A15 (_RESET), CN103.A15 (_RESET), CN104.A15 (_RESET)
_PERR: CN100.B40 (_PERR), CN101.B40 (_PERR), CN102.B40 (_PERR), CN103.B40 (_PERR), CN104.B40 (_PERR), RN100.3 (R3)
_PLOCK: CN100.B39 (_LOCK), CN101.B39 (_LOCK), CN102.B39 (_LOCK), CN103.B39 (_LOCK), CN104.B39 (_LOCK), RN101.7 (R6)
_REQ0: CN100.B18 (_REQ), R108.1
_REQ1: CN101.B18 (_REQ), R116.1
_REQ2: CN102.B18 (_REQ), R124.1
_REQ3: CN103.B18 (_REQ), R132.1
_REQ4: CN104.B18 (_REQ), R162.1
_REQ64: CN100.A60 (_REQ64), CN101.A60 (_REQ64), CN102.A60 (_REQ64), CN103.A60 (_REQ64), CN104.A60 (_REQ64), RN100.2 (R2)
_STOP: CN100.A38 (_STOP), CN101.A38 (_STOP), CN102.A38 (_STOP), CN103.A38 (_STOP), CN104.A38 (_STOP), RN100.4 (R4)
_TRDY: CN100.A36 (_TRDY), CN101.A36 (_TRDY), CN102.A36 (_TRDY), CN103.A36 (_TRDY), CN104.A36 (_TRDY), RN100.7 (R6)

Notes on the sheet:
PCI BUS
DESIGNED TO COMPLY WITH PCI REV 2.3 SPECS. COMPATABLE WITH UNIVERSAL CARDS.
STOP DRIVEN BY TARGET DEVICE. LOCK DRIVEN ONLY BY BRIDGE.
