AmigaPCI/AmigaPCI-MainBoard/KiCAD/AmigaPCI Mainboard-KiCAD REV 70/power.kicad_sch

## KiCad design KiCAD/AmigaPCI Mainboard-KiCAD REV 70/power.kicad_sch (2026-06-26)

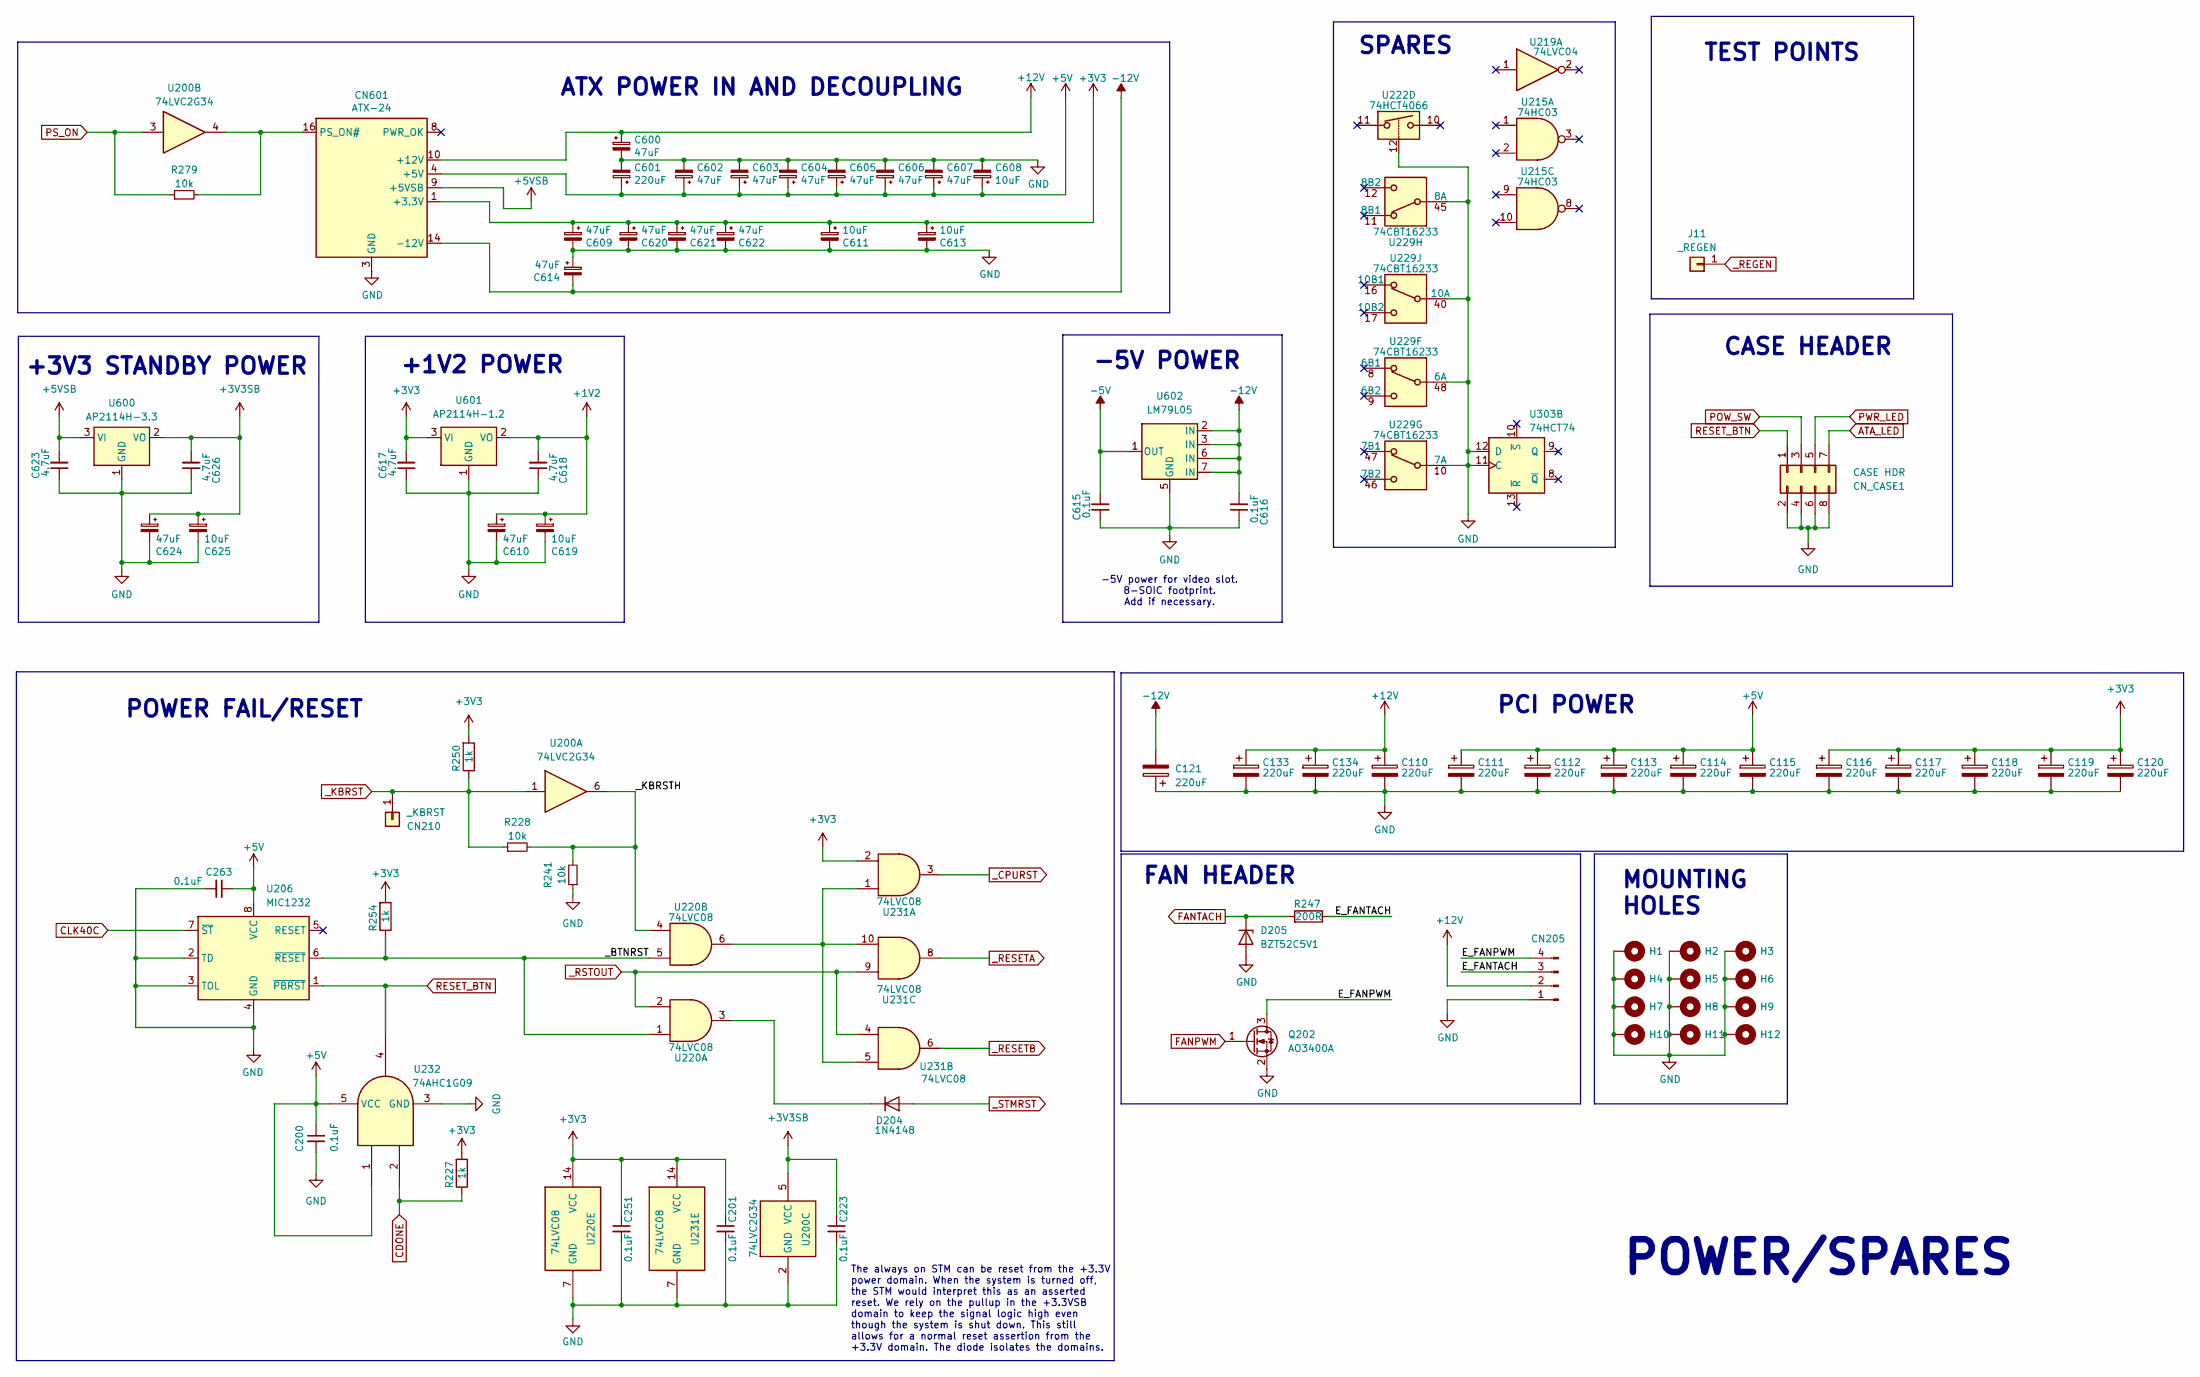
[picture p46: schematic power.kicad_sch]

Parts:
C110, C111, C112, C113, C114, C115, C116, C117, C118, C119, C120, C121, C133, C134, C601: 220uF; CP_Radial_D6.3mm_P2.50mm; LCSC C106643
C200, C201, C223, C251, C263, C615, C616: 0.1uF; C_0603_1608Metric; LCSC C14663
C600, C602, C603, C604, C605, C606, C607, C609, C610, C614, C620, C621, C622, C624: 47uF; CP_Radial_D5.0mm_P2.00mm; LCSC C88724
C608, C611, C613, C619, C625: 10uF; CP_Radial_D5.0mm_P2.00mm; LCSC C88726
C617, C618, C623, C626: 4.7uF; C_0603_1608Metric; LCSC C19666
CN205: Case Fan; FanPinHeader_1x04_P2.54mm_Vertical; PartNumber Molex 0470531000 or 0470533000; LCSC C240840
CN210: _KBRST; PinHeader_1x01_P2.54mm_Horizontal; LCSC C42419937
CN601: ATX-24; Molex_Mini-Fit_Jr_5566-24A_2x12_P4.20mm_Vertical; Part 39281243; LCSC C114088
CN_CASE1: CASE HDR; PinHeader_2x04_P2.54mm_Vertical; LCSC C7430400
D204: 1N4148; D_SOD-323; pART 1N4148WSTR; LCSC C118873
D205: BZT52C5V1; D_SOD-123; LCSC C2117
H1, H2, H3, H4, H5, H6, H7, H8, H9, H10: MountingHole_Pad; MountingHole_4mm_Pad
H11, H12: MountingHole_Pad; MountingHole_3.5mm_Pad
J11: _REGEN; PinHeader_1x01_P2.54mm_Vertical; LCSC C81276
Q202: AO3400A; SOT-23; LCSC C347475
R227, R250, R254: 1k; R_0603_1608Metric; LCSC C21190
R228, R241, R279: 10k; R_0603_1608Metric; LCSC C25804
R247: 200R; R_0603_1608Metric; LCSC C8218
U200: 74LVC2G34; SOT-363_SC-70-6; LCSC C14461
U206: MIC1232; SOIC-8_3.9x4.9mm_P1.27mm; LCSC C627729
U215: 74HC03; TSSOP-14_4.4x5mm_P0.65mm; LCSC C2869660
U219: 74LVC04; TSSOP-14_4.4x5mm_P0.65mm; LCSC C352968
U220, U231: 74LVC08; TSSOP-14_4.4x5mm_P0.65mm; LCSC C6053
U222: 74HCT4066; TSSOP-14_4.4x5mm_P0.65mm; LCSC C26433
U229: 74CBT16233; SSOP-56_7.5x18.5mm_P0.635mm; Part Number SN74CBT16233DL; LCSC C2674759
U232: 74AHC1G09; SOT-23-5; LCSC C840099
U303: 74HCT74; TSSOP-14_4.4x5mm_P0.65mm; LCSC C141335
U600: AP2114H-3.3; SOT-223-3_TabPin2; LCSC C150716
U601: AP2114H-1.2; SOT-223-3_TabPin2; LCSC C94854
U602: LM79L05; SOIC-8_3.9x4.9mm_P1.27mm; LCSC C7555

Connections:
+1V2: C610.1, C618.2, C619.1, U601.2 (VO)
+3V3: C116.1, C117.1, C118.1, C119.1, C120.1, C201.1, C251.1, C609.1, C611.1, C613.1, C617.2, C620.1, C621.1, C622.1, CN601.1 (+3.3V), CN601.2 (+3.3V), CN601.12 (+3.3V), CN601.13 (+3.3V), R227.2, R250.2, R254.2, U220.14 (VCC), U231.2, U231.14 (VCC), U601.3 (VI)
+3V3SB: C223.1, C624.1, C625.1, C626.2, U200.5 (VCC), U600.2 (VO)
+5V: C111.1, C112.1, C113.1, C114.1, C115.1, C200.1, C263.1, C601.1, C602.1, C603.1, C604.1, C605.1, C606.1, C607.1, C608.1, CN601.4 (+5V), CN601.6 (+5V), CN601.21 (+5V), CN601.22 (+5V), CN601.23 (+5V), U206.8 (VCC), U232.1, U232.5 (VCC)
+5VSB: C623.2, CN601.9 (+5VSB), U600.3 (VI)
+12V: C110.1, C133.1, C134.1, C600.1, CN205.2, CN601.10 (+12V), CN601.11 (+12V)
-5V: C615.2, U602.1 (OUT)
-12V: C121.2, C614.2, C616.2, CN601.14 (-12V), U602.2 (IN), U602.3 (IN), U602.6 (IN), U602.7 (IN)
ATA_LED: CN_CASE1.7
CDONE: R227.1, U232.2
CLK40C: U206.7 (~ST)
E_FANPWM: CN205.4, Q202.3 (D)
E_FANTACH: CN205.3, R247.1
FANPWM: Q202.1 (G)
FANTACH: D205.1 (K), R247.2
GND: C110.2, C111.2, C112.2, C113.2, C114.2, C115.2, C116.2, C117.2, C118.2, C119.2, C120.2, C121.1, C133.2, C134.2, C200.2, C201.2, C223.2, C251.2, C263.2, C600.2, C601.2, C602.2, C603.2, C604.2, C605.2, C606.2, C607.2, C608.2, C609.2, C610.2, C611.2, C613.2, C614.1, C615.1, C616.1, C617.1, C618.1, C619.2, C620.2, C621.2, C622.2, C623.1, C624.2, C625.2, C626.1, CN205.1, CN601.3 (GND), CN601.5 (GND), CN601.7 (GND), CN601.15 (GND), CN601.17 (GND), CN601.18 (GND), CN601.19 (GND), CN601.24 (GND), CN_CASE1.2, CN_CASE1.4, CN_CASE1.6, CN_CASE1.8, D205.2 (A), H1.1, H2.1, H3.1, H4.1, H5.1, H6.1, H7.1, H8.1, H9.1, H10.1, H11.1, H12.1, Q202.2 (S), R241.1, U200.2 (GND), U206.2 (TD), U206.3 (TOL), U206.4 (GND), U220.7 (GND), U222.12, U229.10 (7A), U229.40 (10A), U229.45 (8A), U229.48 (6A), U231.7 (GND), U232.3 (GND), U303.11 (C), U303.12 (D), U600.1 (GND), U601.1 (GND), U602.5 (GND)
unnamed: CN601.16 (PS_ON#), R279.2, U200.4
unnamed: D204.1 (K), U220.3
unnamed: U220.6, U231.1, U231.5, U231.10
POW_SW: CN_CASE1.3
PS_ON: R279.1, U200.3
PWR_LED: CN_CASE1.5
RESET_BTN: CN_CASE1.1, U206.1 (~PBRST), U232.4
_BTNRST: R254.1, U206.6 (~RESET), U220.1, U220.5
_CPURST: U231.3
_KBRST: CN210.1, R228.1, R250.1, U200.1
_KBRSTH: R228.2, R241.2, U200.6, U220.4
_REGEN: J11.1
_RESETA: U231.8
_RESETB: U231.6
_RSTOUT: U220.2, U231.4, U231.9
_STMRST: D204.2 (A)

Notes on the sheet:
-5V POWER
FAN HEADER
CASE HEADER
MOUNTING HOLES
TEST POINTS
PCI POWER
SPARES
The always on STM can be reset from the +3.3V power domain. When the system is turned off, the STM would interpret this as an asserted reset. We rely on the pullup in the +3.3VSB domain to keep the signal logic high even though the system is shut down. This still allows for a normal reset assertion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
+3V3 STANDBY POWER
ATX POWER IN AND DECOUPLING
-5V power for video slot. 8-SOIC footprint. Add if necessary.
+1V2 POWER
POWER/SPARES
POWER FAIL/RESET
