AmigaPCI/AmigaPCI-MainBoard/KiCAD/AmigaPCI Mainboard-KiCAD REV 70/serial.kicad_sch

## KiCad design KiCAD/AmigaPCI Mainboard-KiCAD REV 70/serial.kicad_sch (2026-06-26)

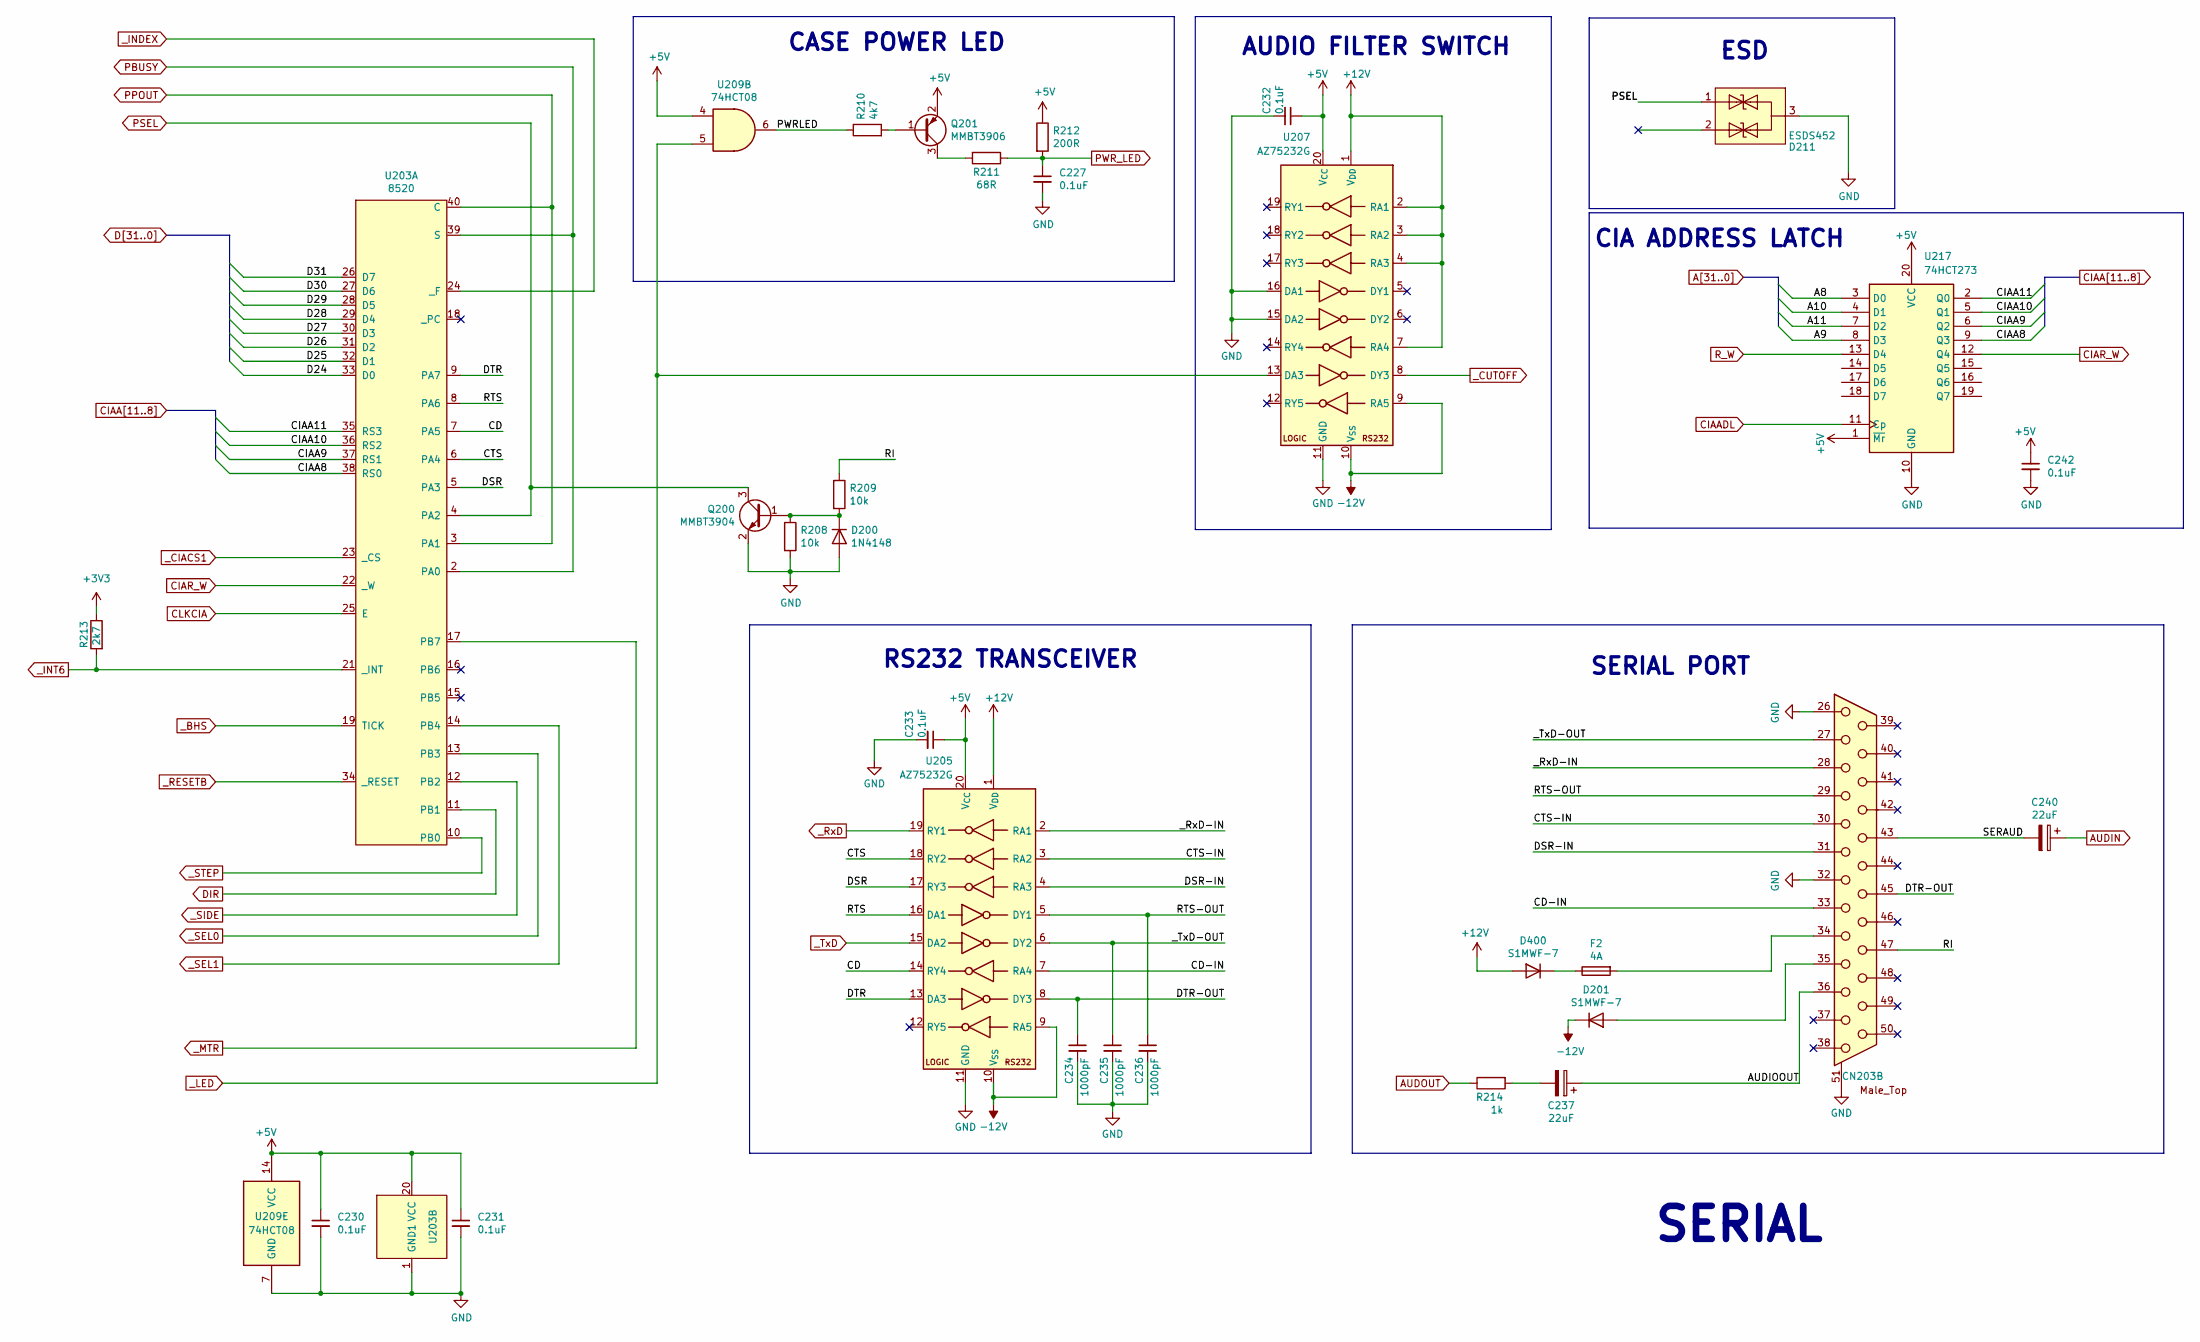
[picture p47: schematic serial.kicad_sch]

Parts:
C227, C230, C231, C232, C233, C242: 0.1uF; C_0603_1608Metric; LCSC C14663
C234, C235, C236: 1000pF; C_0603_1608Metric; LCSC C1588
C237, C240: 22uF; CP_Radial_D5.0mm_P2.00mm; LCSC C88755
CN203: DB25_Stack_FemaleAndMale; DSUB-25_Stack_Female_Bottom_Male_Top; LCSC C17554757
D200: 1N4148; D_SOD-323; pART 1N4148WSTR; LCSC C118873
D201, D400: S1MWF-7; D_SOD-123F; LCSC C460736
D211: ESDS452; SOT-23; LCSC C37574382
F2: 4A; Fuse_1206_3216Metric; LCSC C1972812
Q200: MMBT3904; SOT-23; LCSC C84104
Q201: MMBT3906; SOT-23; LCSC C75549
R208, R209: 10k; R_0603_1608Metric; LCSC C25804
R210: 4k7; R_0603_1608Metric; LCSC C23162
R211: 68R; R_0603_1608Metric; LCSC C25254
R212: 200R; R_0603_1608Metric; LCSC C8218
R213: 2k7; R_0603_1608Metric; LCSC C13167
R214: 1k; R_0603_1608Metric; LCSC C21190
U203: 8520; DIP-40_W15.24mm_Socket; LCSC C2332
U205, U207: AZ75232G; TSSOP-20_4.4x6.5mm_P0.65mm; LCSC C444988
U209: 74HCT08; TSSOP-14_4.4x5mm_P0.65mm; LCSC C131488
U217: 74HCT273; TSSOP-20_4.4x6.5mm_P0.65mm; LCSC C513294

Connections:
+3V3: R213.1
+5V: C230.1, C231.1, C232.1, C233.1, C242.1, Q201.2 (E), R212.1, U203.20 (VCC), U205.20 (V_{CC}), U207.20 (V_{CC}), U209.4, U209.14 (VCC), U217.1 (~Mr), U217.20 (VCC)
+12V: D400.2 (A), U205.1 (V_{DD}), U207.1 (V_{DD}), U207.2 (RA1), U207.3 (RA2), U207.4 (RA3), U207.7 (RA4)
-12V: D201.1 (K), U205.9 (RA5), U205.10 (V_{SS}), U207.9 (RA5), U207.10 (V_{SS})
A8: U217.3 (D0)
A9: U217.8 (D3)
A10: U217.4 (D1)
A11: U217.7 (D2)
AUDIN: C240.1
AUDIOOUT: C237.1, CN203.36
AUDOUT: R214.1
CD: U203.7 (PA5), U205.14 (RY4)
CD-IN: CN203.33, U205.7 (RA4)
CIAA8: U203.38 (RS0), U217.9 (Q3)
CIAA9: U203.37 (RS1), U217.6 (Q2)
CIAA10: U203.36 (RS2), U217.5 (Q1)
CIAA11: U203.35 (RS3), U217.2 (Q0)
CIAADL: U217.11 (Cp)
CIAR_W: U203.22 (_W), U217.12 (Q4)
CLKCIA: U203.25 (E)
CTS: U203.6 (PA4), U205.18 (RY2)
CTS-IN: CN203.30, U205.3 (RA2)
D24: U203.33 (D0)
D25: U203.32 (D1)
D26: U203.31 (D2)
D27: U203.30 (D3)
D28: U203.29 (D4)
D29: U203.28 (D5)
D30: U203.27 (D6)
D31: U203.26 (D7)
DIR: U203.11 (PB1)
DSR: U203.5 (PA3), U205.17 (RY3)
DSR-IN: CN203.31, U205.4 (RA3)
DTR: U203.9 (PA7), U205.13 (DA3)
DTR-OUT: C234.1, CN203.45, U205.8 (DY3)
GND: C227.2, C230.2, C231.2, C232.2, C233.2, C234.2, C235.2, C236.2, C242.2, CN203.26, CN203.32, CN203.51 (GND), D200.2 (A), D211.3 (GND), Q200.2 (E), R208.2, U203.1 (GND1), U205.11 (GND), U207.11 (GND), U207.15 (DA2), U207.16 (DA1), U209.7 (GND), U217.10 (GND)
unnamed: C237.2, R214.2
unnamed: CN203.34, F2.2
unnamed: CN203.35, D201.2 (A)
unnamed: D200.1 (K), Q200.1 (B), R208.1, R209.2
unnamed: D400.1 (K), F2.1
unnamed: Q201.1 (B), R210.2
unnamed: Q201.3 (C), R211.2
PBUSY: U203.2 (PA0), U203.39 (S)
PPOUT: U203.3 (PA1), U203.40 (C)
PSEL: D211.1 (IO1), Q200.3 (C), U203.4 (PA2)
PWRLED: R210.1, U209.6
PWR_LED: C227.1, R211.1, R212.2
RI: CN203.47, R209.1
RTS: U203.8 (PA6), U205.16 (DA1)
RTS-OUT: C236.1, CN203.29, U205.5 (DY1)
R_W: U217.13 (D4)
SERAUD: C240.2, CN203.43
_BHS: U203.19 (TICK)
_CIACS1: U203.23 (_CS)
_CUTOFF: U207.8 (DY3)
_INDEX: U203.24 (_F)
_INT6: R213.2, U203.21 (_INT)
_LED: U207.13 (DA3), U209.5
_MTR: U203.17 (PB7)
_RESETB: U203.34 (_RESET)
_RxD: U205.19 (RY1)
_RxD-IN: CN203.28, U205.2 (RA1)
_SEL0: U203.13 (PB3)
_SEL1: U203.14 (PB4)
_SIDE: U203.12 (PB2)
_STEP: U203.10 (PB0)
_TxD: U205.15 (DA2)
_TxD-OUT: C235.1, CN203.27, U205.6 (DY2)

Notes on the sheet:
CASE POWER LED
ESD
SERIAL
CIA ADDRESS LATCH
SERIAL PORT
AUDIO FILTER SWITCH
RS232 TRANSCEIVER
