AmigaPCI/AmigaPCI-MainBoard/KiCAD/AmigaPCI Mainboard-KiCAD REV 70/video.kicad_sch

## KiCad design KiCAD/AmigaPCI Mainboard-KiCAD REV 70/video.kicad_sch (2026-06-26)

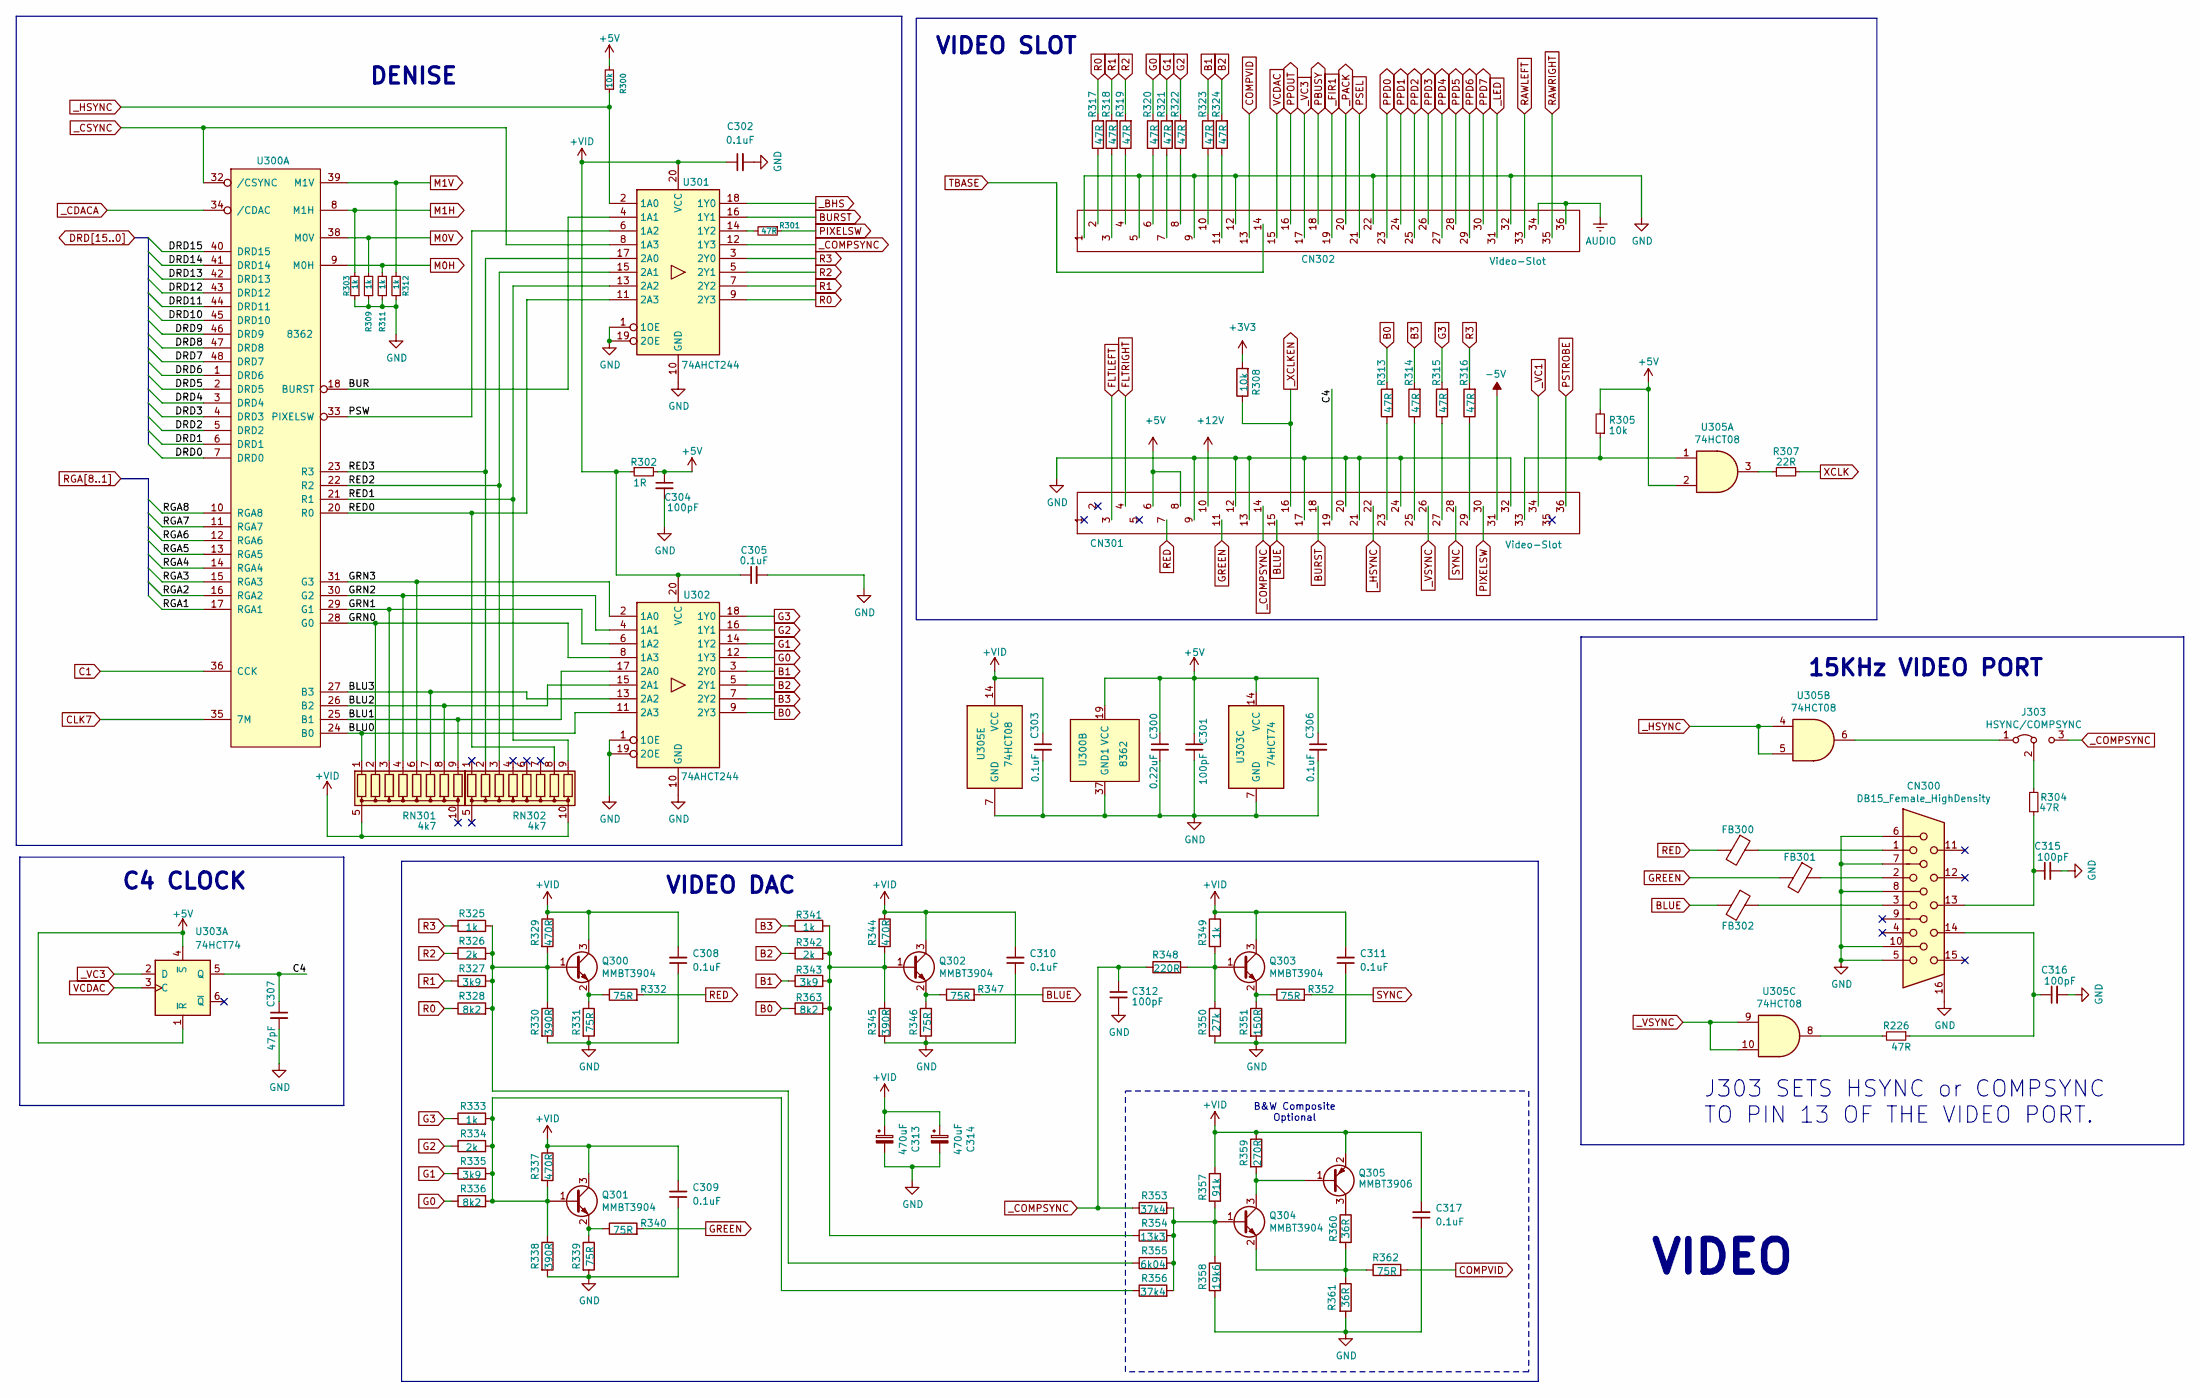
[picture p48: schematic video.kicad_sch]

Parts:
C300: 0.22uF; C_0603_1608Metric; LCSC C21120
C301, C304, C312, C315, C316: 100pF; C_0603_1608Metric; LCSC C14858
C302, C303, C305, C306, C308, C309, C310, C311, C317: 0.1uF; C_0603_1608Metric; LCSC C14663
C307: 47pF; C_0603_1608Metric; LCSC C1671
C313, C314: 470uF; CP_Radial_D10.0mm_P5.00mm; LCSC C59353
CN300: DB15_Female_HighDensity; DSUB-15-HD_Female_Horizontal_P2.29x1.98mm_EdgePinOffset8.35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; LCSC C379814
CN301, CN302: Video-Slot; 2x18_P2.54mm_Horizontal; LCSC C5173302
FB300, FB301, FB302: 80R; C_0805_2012Metric; Part ILHB1206ER750V; LCSC C2762183
J303: HSYNC/COMPSYNC; PinHeader_1x03_P2.54mm_Vertical; LCSC C49257
Q300, Q301, Q302, Q303, Q304: MMBT3904; SOT-23; LCSC C84104
Q305: MMBT3906; SOT-23; LCSC C75549
R226, R301, R304, R313, R314, R315, R316, R317, R318, R319, R320, R321, R322, R323, R324: 47R; R_0603_1608Metric; LCSC C23182
R300, R305, R308: 10k; R_0603_1608Metric; LCSC C25804
R302: 1R; R_0603_1608Metric; LCSC C22936
R303, R309, R311, R312, R325, R333, R341, R349: 1k; R_0603_1608Metric; LCSC C21190
R307: 22R; R_0603_1608Metric; LCSC C23345
R326, R334, R342: 2k; R_0603_1608Metric; LCSC C22975
R327, R335, R343: 3k9; R_0603_1608Metric; LCSC C23018
R328, R336, R363: 8k2; R_0603_1608Metric; LCSC C25981
R329, R337, R344: 470R; R_0603_1608Metric; LCSC C23179
R330, R338, R345: 390R; R_0603_1608Metric; LCSC C23151
R331, R332, R339, R340, R346, R347, R352, R362: 75R; R_0603_1608Metric; LCSC C4275
R348: 220R; R_0603_1608Metric; LCSC C22962
R350: 27k; R_0603_1608Metric; LCSC C22967
R351: 150R; R_0603_1608Metric; LCSC C22808
R353, R356: 37k4; R_0603_1608Metric; LCSC C23033
R354: 13k3; R_0603_1608Metric; LCSC C25952
R355: 6k04; R_0603_1608Metric; LCSC C25977
R357: 91k; R_0603_1608Metric; LCSC C23265
R358: 19k6; R_0603_1608Metric; LCSC C22898
R359: 270R; R_0603_1608Metric; LCSC C22966
R360, R361: 36R; R_0603_1608Metric; LCSC C23148
RN301, RN302: 4k7; R_Array_Convex_5x0603; Part Number YC158TJR-074K7L; LCSC C728819
U300: 8362; DIP-48_W15.24mm; LCSC C5510465
U301, U302: 74AHCT244; TSSOP-20_4.4x6.5mm_P0.65mm; LCSC C484743
U303: 74HCT74; TSSOP-14_4.4x5mm_P0.65mm; LCSC C141335
U305: 74HCT08; TSSOP-14_4.4x5mm_P0.65mm; LCSC C131488

Connections:
+3V3: R308.2
+5V: C300.1, C301.1, C304.1, C306.1, CN301.6, CN301.8, R300.2, R302.2, R305.2, U300.19 (VCC), U303.1 (~R), U303.4 (~S), U303.14 (VCC), U305.2
+12V: CN301.10
+VID: C302.1, C303.1, C305.1, C308.2, C309.2, C310.2, C311.2, C313.1, C314.1, C317.2, Q300.3 (C), Q301.3 (C), Q302.3 (C), Q303.3 (C), Q305.2 (E), R302.1, R329.1, R337.1, R344.1, R349.1, R357.1, R359.1, RN301.5 (common), RN302.10 (common), U301.20 (VCC), U302.20 (VCC), U305.14 (VCC)
-5V: CN301.31
AUDIO: CN302.34, CN302.36
B0: R313.2, R363.1, U302.9 (2Y3)
B1: R323.2, R343.1, U302.3 (2Y0)
B2: R324.2, R342.1, U302.5 (2Y1)
B3: R314.2, R341.1, U302.7 (2Y2)
BLU0: RN301.1 (R1), U300.24 (B0), U302.11 (2A3)
BLU1: RN301.9 (R8), U300.25 (B1), U302.17 (2A0)
BLU2: RN301.8 (R7), U300.26 (B2), U302.15 (2A1)
BLU3: RN301.7 (R6), U300.27 (B3), U302.13 (2A2)
BLUE: CN301.15, FB302.2, R347.2
BUR: U300.18 (BURST), U301.4 (1A1)
BURST: CN301.18, U301.16 (1Y1)
C1: U300.36 (CCK)
C4: C307.1, CN301.19, U303.5 (Q)
CLK7: U300.35 (7M)
COMPVID: CN302.13, R362.2
DRD0: U300.7 (DRD0)
DRD1: U300.6 (DRD1)
DRD2: U300.5 (DRD2)
DRD3: U300.4 (DRD3)
DRD4: U300.3 (DRD4)
DRD5: U300.2 (DRD5)
DRD6: U300.1 (DRD6)
DRD7: U300.48 (DRD7)
DRD8: U300.47 (DRD8)
DRD9: U300.46 (DRD9)
DRD10: U300.45 (DRD10)
DRD11: U300.44 (DRD11)
DRD12: U300.43 (DRD12)
DRD13: U300.42 (DRD13)
DRD14: U300.41 (DRD14)
DRD15: U300.40 (DRD15)
FLTLEFT: CN301.3
FLTRIGHT: CN301.4
G0: R320.2, R336.1, U302.12 (1Y3)
G1: R321.2, R335.1, U302.14 (1Y2)
G2: R322.2, R334.1, U302.16 (1Y1)
G3: R315.2, R333.1, U302.18 (1Y0)
GND: C300.2, C301.2, C302.2, C303.2, C304.2, C305.2, C306.2, C307.2, C308.1, C309.1, C310.1, C311.1, C312.2, C313.2, C314.2, C315.2, C316.2, C317.1, CN300.5, CN300.6, CN300.7, CN300.8, CN300.10, CN300.16 (SHIELD), CN301.9, CN301.12, CN301.13, CN301.17, CN301.20, CN301.21, CN301.24, CN301.32, CN302.1, CN302.5, CN302.9, CN302.12, CN302.22, CN302.32, R303.1, R309.1, R311.1, R312.1, R330.2, R331.2, R338.2, R339.2, R345.2, R346.2, R350.2, R351.2, R358.2, R361.2, U300.37 (GND1), U301.1 (1OE), U301.10 (GND), U301.19 (2OE), U302.1 (1OE), U302.10 (GND), U302.19 (2OE), U303.7 (GND), U305.7 (GND)
GREEN: CN301.11, FB301.2, R340.2
GRN0: RN301.2 (R2), U300.28 (G0), U302.8 (1A3)
GRN1: RN301.3 (R3), U300.29 (G1), U302.6 (1A2)
GRN2: RN301.4 (R4), U300.30 (G2), U302.4 (1A1)
GRN3: RN301.6 (R5), U300.31 (G3), U302.2 (1A0)
M0H: R311.2, U300.9 (M0H)
M0V: R309.2, U300.38 (M0V)
M1H: R303.2, U300.8 (M1H)
M1V: R312.2, U300.39 (M1V)
unnamed: C315.1, CN300.13, R304.1
unnamed: C316.1, CN300.14, R226.1
unnamed: CN300.1, FB300.1
unnamed: CN300.2, FB301.1
unnamed: CN300.3, FB302.1
unnamed: CN301.23, R313.1
unnamed: CN301.25, R314.1
unnamed: CN301.27, R315.1
unnamed: CN301.29, R316.1
unnamed: CN301.33, R305.1, U305.1
unnamed: CN302.2, R317.1
unnamed: CN302.3, R318.1
unnamed: CN302.4, R319.1
unnamed: CN302.6, R320.1
unnamed: CN302.7, R321.1
unnamed: CN302.8, R322.1
unnamed: CN302.10, R323.1
unnamed: CN302.11, R324.1
unnamed: J303.1 (A), U305.6
unnamed: J303.2 (C), R304.2
unnamed: Q300.1 (B), R325.2, R326.2, R327.2, R328.2, R329.2, R330.1, R355.1
unnamed: Q300.2 (E), R331.1, R332.1
unnamed: Q301.1 (B), R333.2, R334.2, R335.2, R336.2, R337.2, R338.1, R356.1
unnamed: Q301.2 (E), R339.1, R340.1
unnamed: Q302.1 (B), R341.2, R342.2, R343.2, R344.2, R345.1, R354.1, R363.2
unnamed: Q302.2 (E), R346.1, R347.1
unnamed: Q303.1 (B), R348.2, R349.2, R350.1
unnamed: Q303.2 (E), R351.1, R352.1
unnamed: Q304.1 (B), R353.2, R354.2, R355.2, R356.2, R357.2, R358.1
unnamed: Q304.2 (E), R360.2, R361.1, R362.1
unnamed: Q304.3 (C), Q305.1 (B), R359.2
unnamed: Q305.3 (C), R360.1
unnamed: R226.2, U305.8
unnamed: R301.2, U301.14 (1Y2)
unnamed: R307.1, U305.3
PBUSY: CN302.18
PIXELSW: CN301.30, R301.1
PPD0: CN302.23
PPD1: CN302.24
PPD2: CN302.25
PPD3: CN302.26
PPD4: CN302.27
PPD5: CN302.28
PPD6: CN302.29
PPD7: CN302.30
PPOUT: CN302.16
PSEL: CN302.21
PSTROBE: CN301.36
PSW: U300.33 (PIXELSW), U301.6 (1A2)
R0: R317.2, R328.1, U301.9 (2Y3)
R1: R318.2, R327.1, U301.7 (2Y2)
R2: R319.2, R326.1, U301.5 (2Y1)
R3: R316.2, R325.1, U301.3 (2Y0)
RAWLEFT: CN302.33
RAWRIGHT: CN302.35
RED: CN301.7, FB300.2, R332.2
RED0: RN302.8 (R7), U300.20 (R0), U301.11 (2A3)
RED1: RN302.9 (R8), U300.21 (R1), U301.13 (2A2)
RED2: RN302.3 (R3), U300.22 (R2), U301.15 (2A1)
RED3: RN302.2 (R2), U300.23 (R3), U301.17 (2A0)
RGA1: U300.17 (RGA1)
RGA2: U300.16 (RGA2)
RGA3: U300.15 (RGA3)
RGA4: U300.14 (RGA4)
RGA5: U300.13 (RGA5)
RGA6: U300.12 (RGA6)
RGA7: U300.11 (RGA7)
RGA8: U300.10 (RGA8)
SYNC: CN301.28, R352.2
TBASE: CN302.14
VCDAC: CN302.15, U303.3 (C)
XCLK: R307.2
_BHS: U301.18 (1Y0)
_CDACA: U300.34 (/CDAC)
_COMPSYNC: C312.1, CN301.14, J303.3 (B), R348.1, R353.1, U301.12 (1Y3)
_CSYNC: U300.32 (/CSYNC), U301.8 (1A3)
_FIR1: CN302.19
_HSYNC: CN301.22, R300.1, U301.2 (1A0), U305.4, U305.5
_LED: CN302.31
_PACK: CN302.20
_VC1: CN301.34
_VC3: CN302.17, U303.2 (D)
_VSYNC: CN301.26, U305.9, U305.10
_XCLKEN: CN301.16, R308.1

Notes on the sheet:
VIDEO SLOT
J303 SETS HSYNC or COMPSYNC TO PIN 13 OF THE VIDEO PORT.
B&W Composite Optional
VIDEO DAC
DENISE
C4 CLOCK
15KHz VIDEO PORT
VIDEO
