AmigaPCI/AmigaPCI-MainBoard/(commit log)

2025-12-29 Daily U109 and U110. See details. DEC-29-2025
    *Now returns $FFFF FFFF when a PCI device does not respond.
    *Fixed FIFO shift during PCI reads where no device responds.
2026-01-16 U109 and U110 Dailies JAN-15-2026
    U109:
    1) Implement updated base address map for PCI devices.
    U110:
    1) Implement a round-robin arbiter.
    2) Implement the U110 part of the PCI DMA state machine.
    3) Connect all PCI interrupts to _INT2.
2026-02-01 U109 and U110 daily. Add PCI DMA cycle support.
    Completely untested other than to work in non-DMA mode.
2026-02-22 U109 Daily. 21-FEB-2026
    1) Fixes portions of DMA.
    2) Moved bridge reset register to 0x9fc08000.
2026-02-26 U109 and U110 dailies. 02-FEB-2026
    Addressed parity issues. This also includes some DMA work, but DMA is still not working right.
2026-06-26 Push new hardware revision.
    Revision 7.0
    [1-5145167-2.STEP, 5145154-4.step, 5530843-3.step, 5535098-5.stp, 61400826021--3DModel-STEP-898076.STEP, ASUB-277-25TP24.STEP, AUDIO_JACK.STEP, Agnus-Multi.kicad_sch]
2026-07-18 U110: Corrected _TACK pin number.
2026-08-05 U109: Update bridge registers (see description)
    1) Hold PCI bus in reset until reset register is cleared.
    2) Added the interrupt enable register.
2026-10-04 Update assembly.md
    Replaced reference to A3000 ROMs with A1200 ROMs.
2026-10-30 U109: Add a legacy memory window at $9FF
    VGA compatible cards decode their frame buffer at PCI memory $A0000-$BFFFF
    while the video BIOS runs its POST, and PC style option ROMs expect to
    find their shadow and the VGA text buffer in the first megabyte of PCI
    memory. On the AmigaPCI the memory BAR aperture maps PCI addresses one to
    one onto CPU addresses, so that megabyte sits behind the Amiga chip RAM
    and no CPU access can reach it. A PCI graphics card therefore cannot be
    POSTed on the AmigaPCI without card specific knowledge of its linear
    frame buffer, which is exactly the kind of per card transport the Amiga
    PCI software stack wants to avoid.
    The bridge region at $9FC00000-$9FFFFFFF decode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
